illiapliukhin/led-cube-32-controller/hardware/wire_grid_32x32/renders/hq/leadin_tag.png

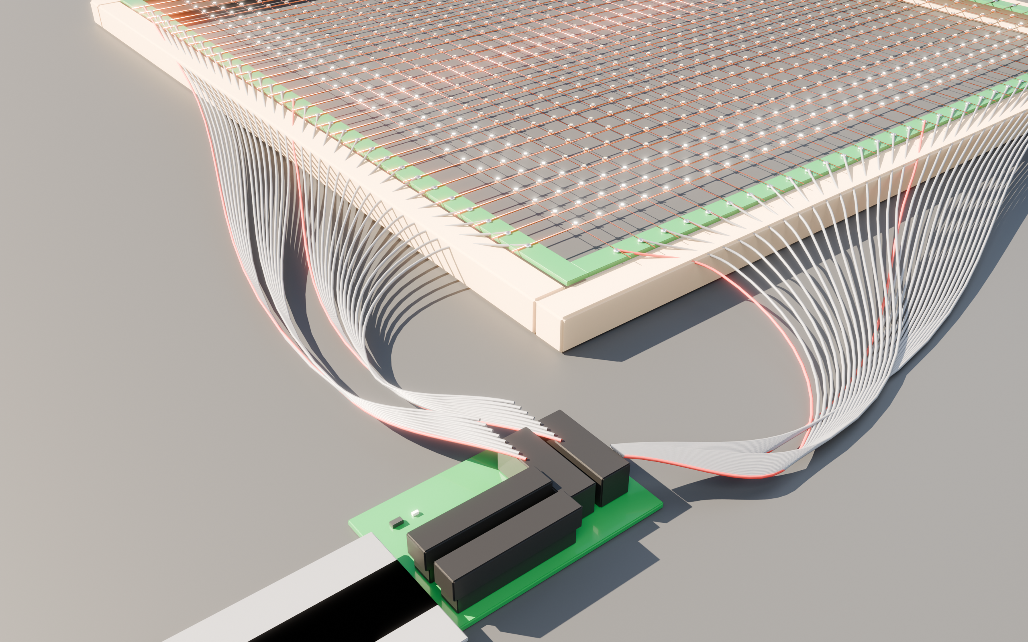
hardware/wire_grid_32x32/renders/hq/leadin_tag.png
