illiapliukhin/led-cube-32-controller/hardware/wire_grid_32x32/renders/hq/grid_full_34.png

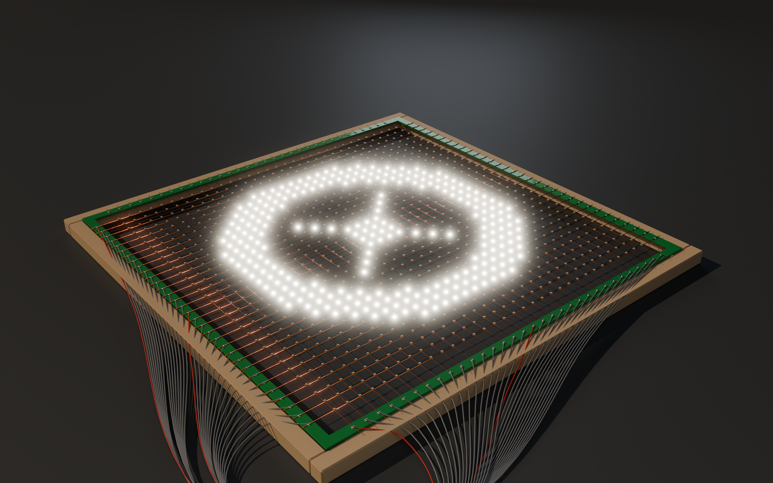
hardware/wire_grid_32x32/renders/hq/grid_full_34.png
