illiapliukhin/led-cube-32-controller/calc/strip_calc.md

| Connectors / 1 m | Pitch | Segments × conn. | px / strand | px / board | I5V ABL 25 % / board | I5V / segment | Power cells / segment | I12V / segment | I / strand (ABL) | Data buffers / seg | Clock buffers / seg | Clock groups / seg | Strand connector |
|---|---|---|---|---|---|---|---|---|---|---|---|---|---|
| **124** | 8.06 mm | 4 × 31 | 124 | 15,376 | 231 A | 57.7 A | 6 | 26.6 A | 1.86 A | 4 | 4 | 2 | JST XH B4B-XH-A, 2 staggered rows (16.1 mm per row) |
| **64** | 15.62 mm | 4 × 16 | 64 | 4,096 | 61 A | 15.4 A | 2 | 7.1 A | 0.96 A | 2 | 2 | 1 | JST XH B4B-XH-A, 1 row |
| **48** | 20.83 mm | 4 × 12 | 48 | 2,304 | 35 A | 8.6 A | 1 | 4.0 A | 0.72 A | 2 | 2 | 1 | JST XH B4B-XH-A, 1 row |
| **32** | 31.25 mm | 4 × 8 | 32 | 1,024 | 15 A | 3.8 A | 1 | 1.8 A | 0.48 A | 1 | 1 | 1 | JST XH B4B-XH-A, 1 row |
