illiapliukhin/led-cube-32-controller/hardware/wire_grid_32x32/wire_grid_32x32_schematic.pdf

# wire_grid_32x32 — Схема: матрица 32×32

### Сетка 32×32 на проводах · шаг 10.0 мм · NCD0603W1 · LED_INTERFACE_STANDARD v1

# Лист 1/2 (схема) · размеры в мм · gen_drawings.py (параметрический, params.py)

D(r,c), r,c = 1…32: анод → провод строки ROW_r, катод → провод столбца COL_c. Позиционное обозначение Dn, n = 32(r−1)+c (как на mono_panel_32x32). 1024 × NCD0603W1 (LCSC C84265).

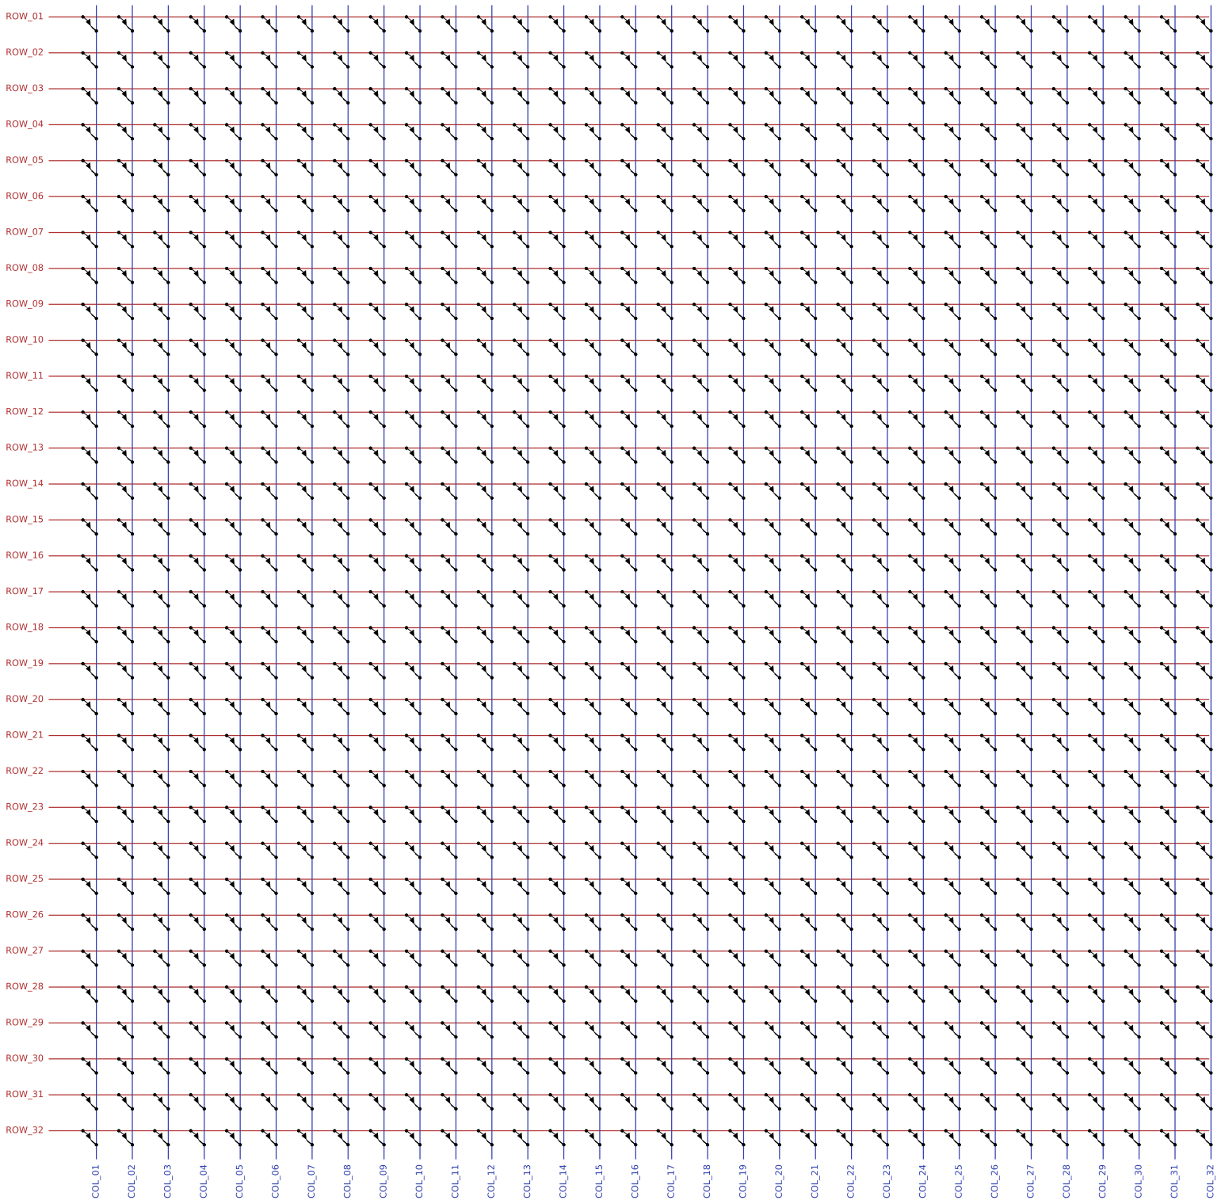
[picture p4: figure]
ROW_01; ROW_02; ROW_03; ROW_04; ROW_05; ROW_06; ROW_07; ROW_08; ROW_09; ROW_10; ROW_11; ROW_12; ROW_13; ROW_14; ROW_15; ROW_16; ROW_17; ROW_18; ROW_19; ROW_20; ROW_21; ROW_22; ROW_23; ROW_24; ROW_25; ROW_26; ROW_27; ROW_28; ROW_29; ROW_30; ROW_31; ROW_32; COL_01; COL_02; COL_03; COL_04; COL_05; COL_06; COL_07; COL_08; COL_09; COL_10; COL_11; COL_12; COL_13; COL_14; COL_15; COL_16; COL_17; COL_18; COL_19; COL_20; COL_21; COL_22; COL_23; COL_24; COL_25; COL_26; COL_27; COL_28; COL_29; COL_30; COL_31; COL_32

## ROW_r: Ø0.50 мм эмаль, 340 мм; источник P-FET LED_4V1 4,1 В, до 0.32 А (32×10 мА)

## COL_c: Ø0.25 мм эмаль, 340 мм; сток MBI5124 ~10 мА

# Под светодиодами нет печатной платы: провода = шины

Строки разводятся гребёнкой (шлейф 28 AWG) на J_R1/J_R2,

# столбцы — на J_C1/J_C2 (IDC 2×8, 2,54 мм): штырь n = линия n

(J_R2/J_C2: штырь n = линия 16+n).

## Вариант A: 4 шлейфа → hardware/garland_breakout

(EEPROM U_ID уже на breakout, прошить preset wire32).

# Вариант B: гребёнки → бирка WG_TAG → 2× IDC 2×20 1,27 мм

→ J_RH1/J_CH1 платы v15 (ID EEPROM на бирке).

# Падение по строке (§5, ≤ 350 мВ при 0,32 А): A: 133 мВ (запас 217 мВ), B: 81 мВ (запас 269 мВ)

# A (анод) → ROW

# K (катод) → COL

# NCD0603W1: катод = метка на корпусе (зелёная/срез), Vf 2,6…3,6 В

# wire_grid_32x32 — Схема: разъёмы, бирка WG_TAG, ID EEPROM, ESD

### Сетка 32×32 на проводах · шаг 10.0 мм · NCD0603W1 · LED_INTERFACE_STANDARD v1

# Лист 2/2 (схема) · размеры в мм · gen_drawings.py (параметрический, params.py)

## J_R1 (2×8 2,54)

1 ROW_01

2 ROW_02

3 ROW_03

4 ROW_04

5 ROW_05

6 ROW_06

7 ROW_07

8 ROW_08

9 ROW_09

10 ROW_10

11 ROW_11

12 ROW_12

13 ROW_13

14 ROW_14

15 ROW_15

16 ROW_16

## J_R2 (2×8 2,54)

1 ROW_17

2 ROW_18

3 ROW_19

4 ROW_20

5 ROW_21

6 ROW_22

7 ROW_23

8 ROW_24

9 ROW_25

10 ROW_26

11 ROW_27

12 ROW_28

13 ROW_29

14 ROW_30

15 ROW_31

16 ROW_32

## J_C1 (2×8 2,54)

1 COL_01

2 COL_02

3 COL_03

4 COL_04

5 COL_05

6 COL_06

7 COL_07

8 COL_08

9 COL_09

10 COL_10

11 COL_11

12 COL_12

13 COL_13

14 COL_14

15 COL_15

16 COL_16

## J_C2 (2×8 2,54)

1 COL_17

2 COL_18

3 COL_19

4 COL_20

5 COL_21

6 COL_22

7 COL_23

8 COL_24

9 COL_25

10 COL_26

11 COL_27

12 COL_28

13 COL_29

14 COL_30

15 COL_31

16 COL_32

Сторона сетки: гребёнки (шлейф 16 жил 28 AWG, IDC-16F).
Совпадает 1:1 с J_R1/J_R2/J_C1/J_C2 платы garland_breakout.

Ключ IDC: штырь 1 = красная жила шлейфа = ROW_01 / COL_01 (J_R2: ROW_17).

## J_OUT_R → v15 J_RH1

1 | ROW_01
2 | ROW_02
3 | ROW_03
4 | ROW_04
5 | ROW_05
6 | ROW_06
7 | ROW_07
8 | ROW_08
9 | ROW_09
10 | ROW_10
11 | ROW_11
12 | ROW_12
13 | ROW_13
14 | ROW_14
15 | ROW_15
16 | ROW_16
17 | ROW_17
18 | ROW_18
19 | ROW_19
20 | ROW_20
21 | ROW_21
22 | ROW_22
23 | ROW_23
24 | ROW_24
25 | ROW_25
26 | ROW_26
27 | ROW_27
28 | ROW_28
29 | ROW_29
30 | ROW_30
31 | ROW_31
32 | ROW_32
33 | GND
34 | VLED_SENSE (NC)
35 | ID_SDA
36 | ID_SCL
37 | ID_3V3
38 | GND
39 | ID_PRESENT_N→GND
40 | GND

## J_OUT_C → v15 J_CH1

1 | COL_01
2 | COL_02
3 | COL_03
4 | COL_04
5 | COL_05
6 | COL_06
7 | COL_07
8 | COL_08
9 | COL_09
10 | COL_10
11 | COL_11
12 | COL_12
13 | COL_13
14 | COL_14
15 | COL_15
16 | COL_16
17 | COL_17
18 | COL_18
19 | COL_19
20 | COL_20
21 | COL_21
22 | COL_22
23 | COL_23
24 | COL_24
25 | COL_25
26 | COL_26
27 | COL_27
28 | COL_28
29 | COL_29
30 | COL_30
31 | COL_31
32 | COL_32
33 | GND
34 | EXP (NC)
35 | EXP (NC)
36 | EXP (NC)
37 | EXP (NC)
38 | GND
39 | EXP_3V3 (NC)
40 | GND

Бирка WG_TAG (вариант B): 2× IDC 2×20 1,27 мм (BH127VS-40P),
штырь n = линия n, ровно как J_RH1/J_CH1 и FFC.

J_R1/J_R2 → J_OUT_R 1…32, J_C1/J_C2 → J_OUT_C 1…32 (дорожки ≥ 0,4 мм для строк, 0,32 А).

## U_ID 24LC02BT-I/OT (SOT-23-5), 0x50

ID_3V3 (37) | 4 VCC
ID_SDA (35) | 3 SDA
ID_SCL (36) | 1 SCL
VSS 2 | GND
WP 5 | GND

C_ID 100 нФ 0603: ID_3V3 ↔ GND у вывода 4.
Подтяжки SDA/SCL — на основной плате (шина IMU).

WP = GND: прошивка из платы (panel write).

Пины 39 → GND (ID_PRESENT_N), 33/38/40 → GND.
Вариант A: бирка не нужна — U_ID уже на breakout.

# Мини-вариант: только EEPROM на клочке

макетки 10×15 мм, припаян к жилам 33–40 шлейфа.

# ESD — примечание

- Сетка — 64 голых антенны ~0,34 м без платы и без TVS.

### - Защита стоит на стороне платы: 64× PESD5V0S1BL на garland_breakout

### (вариант A) или D_R01…D_C32 у J_RH1/J_CH1 на v15 (вариант B) —

при сборке вариант B TVS ОБЯЗАТЕЛЬНО запаяны (в wearable они DNP).

### - Опционально на бирке: 64× PESD5V0S1BL (C84374, SOD-882)

линия → GND, у разъёмов J_R*/J_C*; GND = 33/38/40.

# - Рамка (если металл) и GND гребёнок — к GND одним проводом

у бирки/breakout; ESD-браслет при пайке и подключении.

- Сначала подключать GND (шлейф с ключом — все жилы разом),

никогда не подключать/отключать под питанием.

- Эмаль не изолирует от ESD — не трогать сетку при работе.

# - NCD0603W1 без встроенного стабилитрона: обратное

напряжение ≤ 5 В (строки ≤ 4,1 В — в норме).
