illiapliukhin/led-cube-32-controller/docs/block_diagram.png

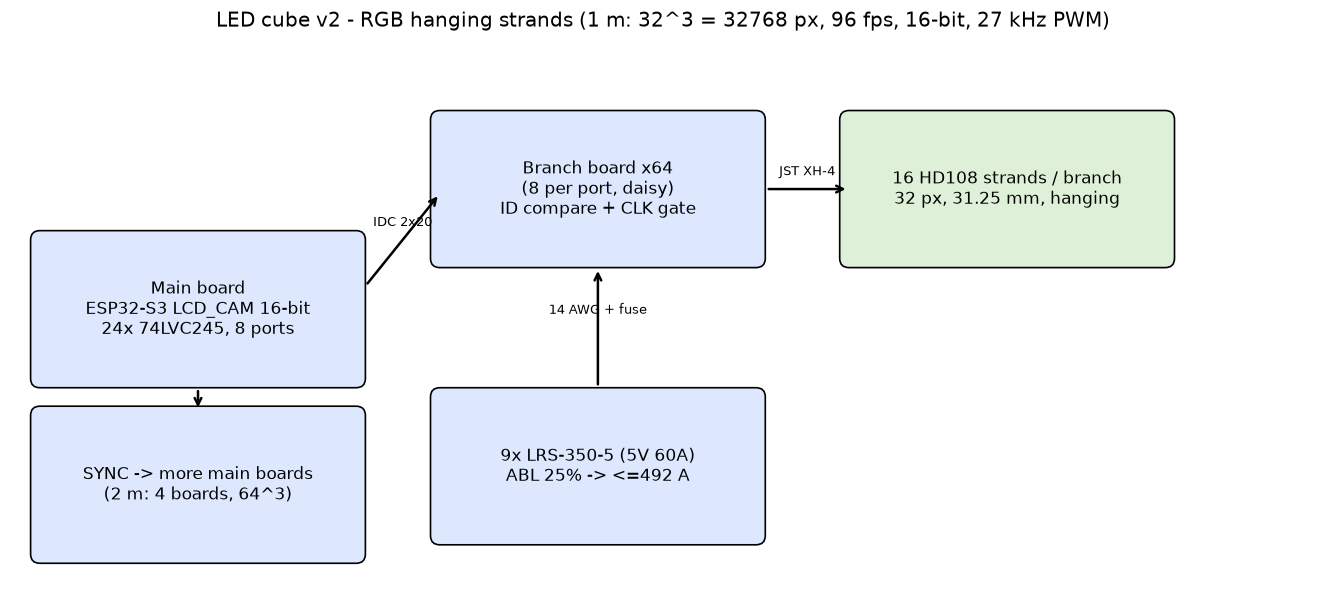
docs/block_diagram.png
