illiapliukhin/led-cube-32-controller/docs/block_diagram_v1_mono.png

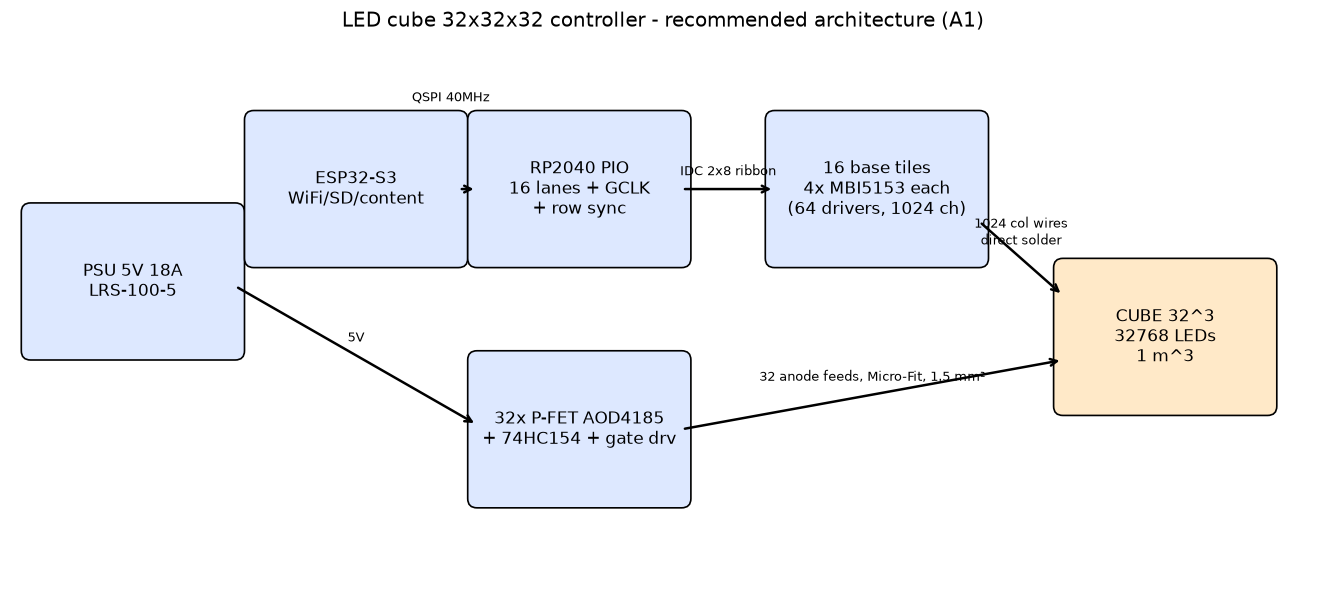
docs/block_diagram_v1_mono.png
