illiapliukhin/led-cube-32-controller/hardware/main_v1/renders/main_v1_bottom.png

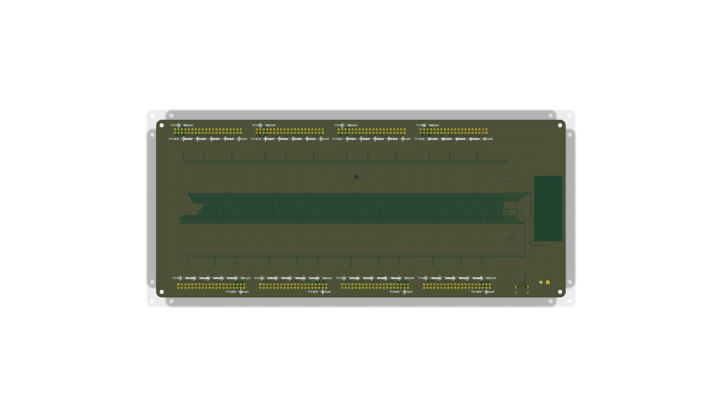
hardware/main_v1/renders/main_v1_bottom.png
