illiapliukhin/led-cube-32-controller/hardware/v15_baseline/renders/mono_electronics_v15_iso.png

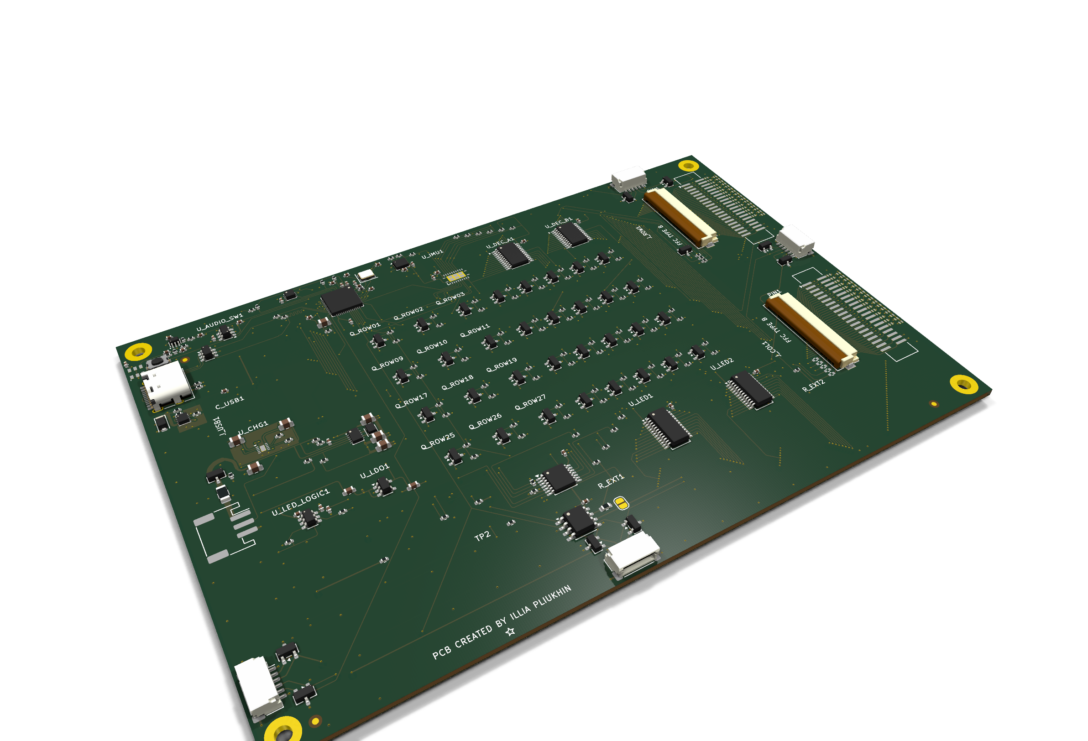
hardware/v15_baseline/renders/mono_electronics_v15_iso.png
