illiapliukhin/led-cube-32-controller/hardware/wire_grid_32x32/out/mech_1_plan.png

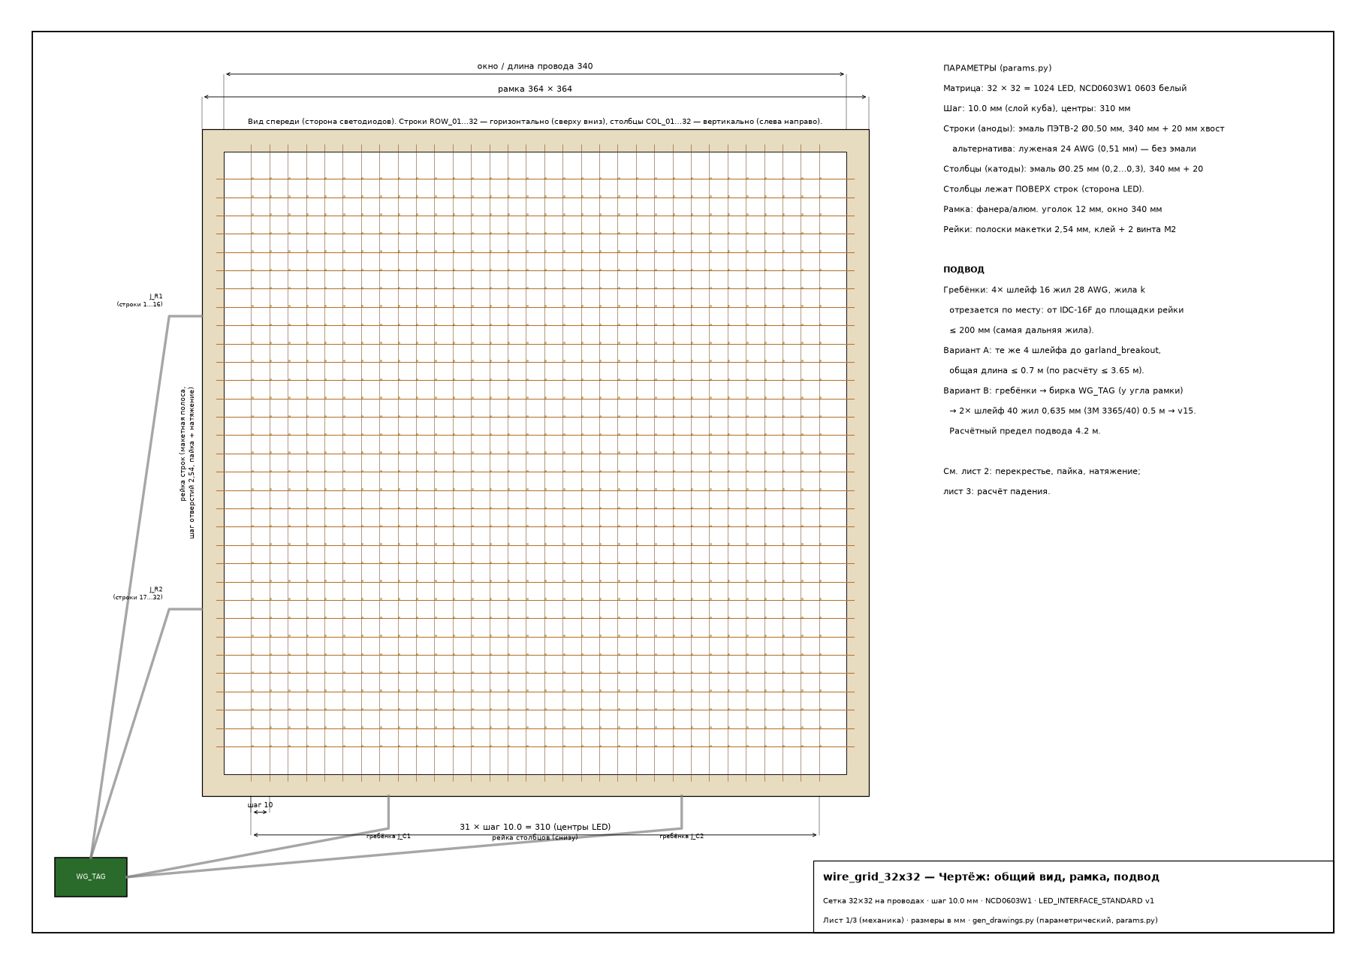
hardware/wire_grid_32x32/out/mech_1_plan.png
