illiapliukhin/led-cube-32-controller/hardware/wire_grid_32x32/out/mech_2_details.png

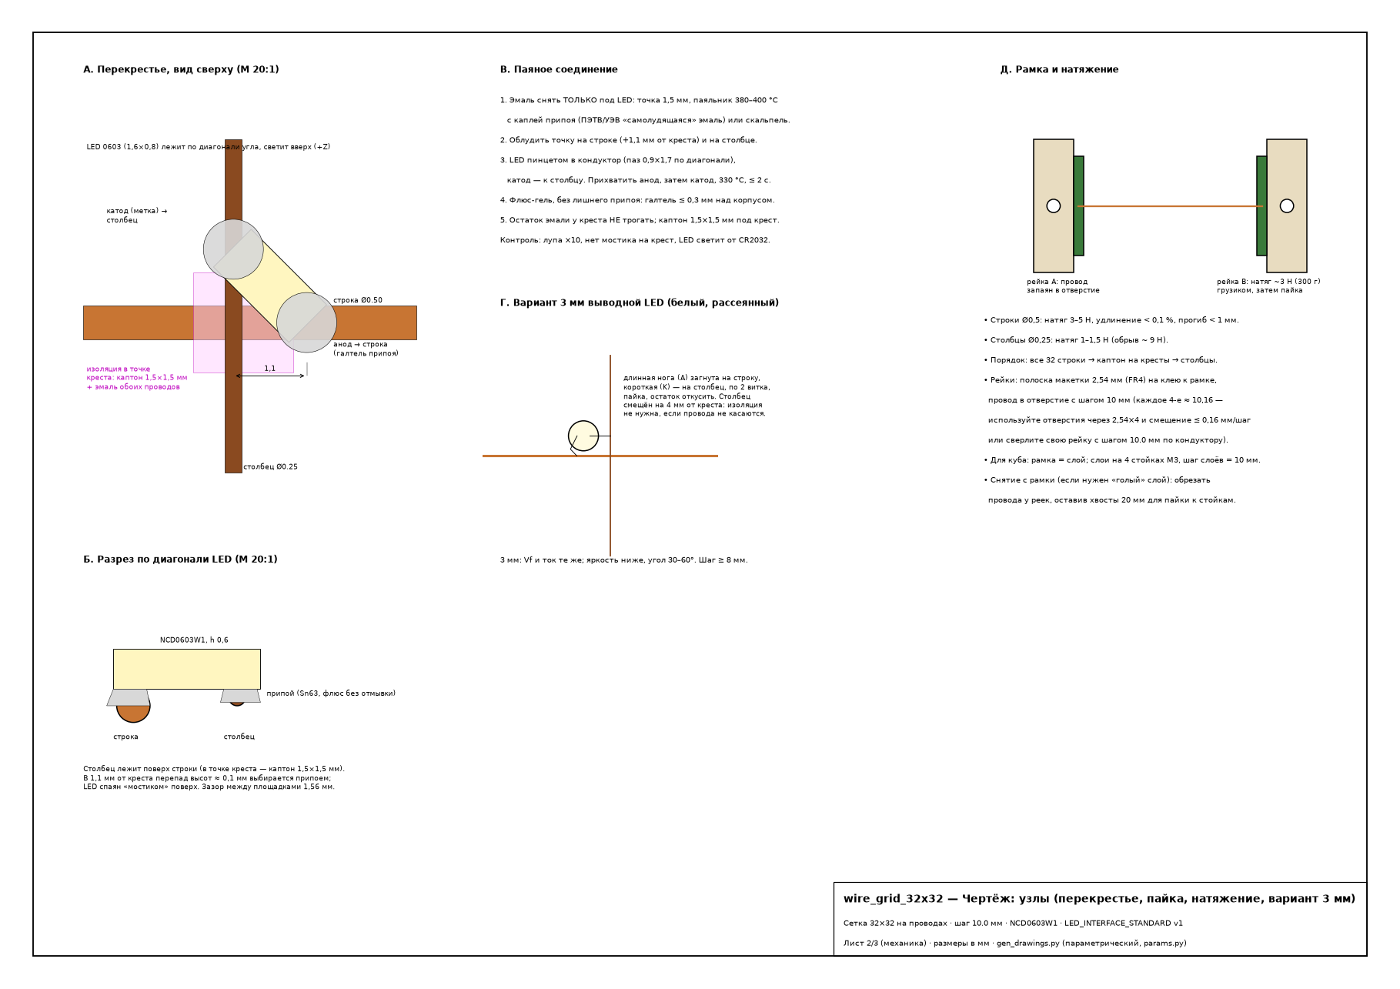
hardware/wire_grid_32x32/out/mech_2_details.png
