illiapliukhin/led-cube-32-controller/hardware/wire_grid_32x32/out/mech_3_dropcalc.png

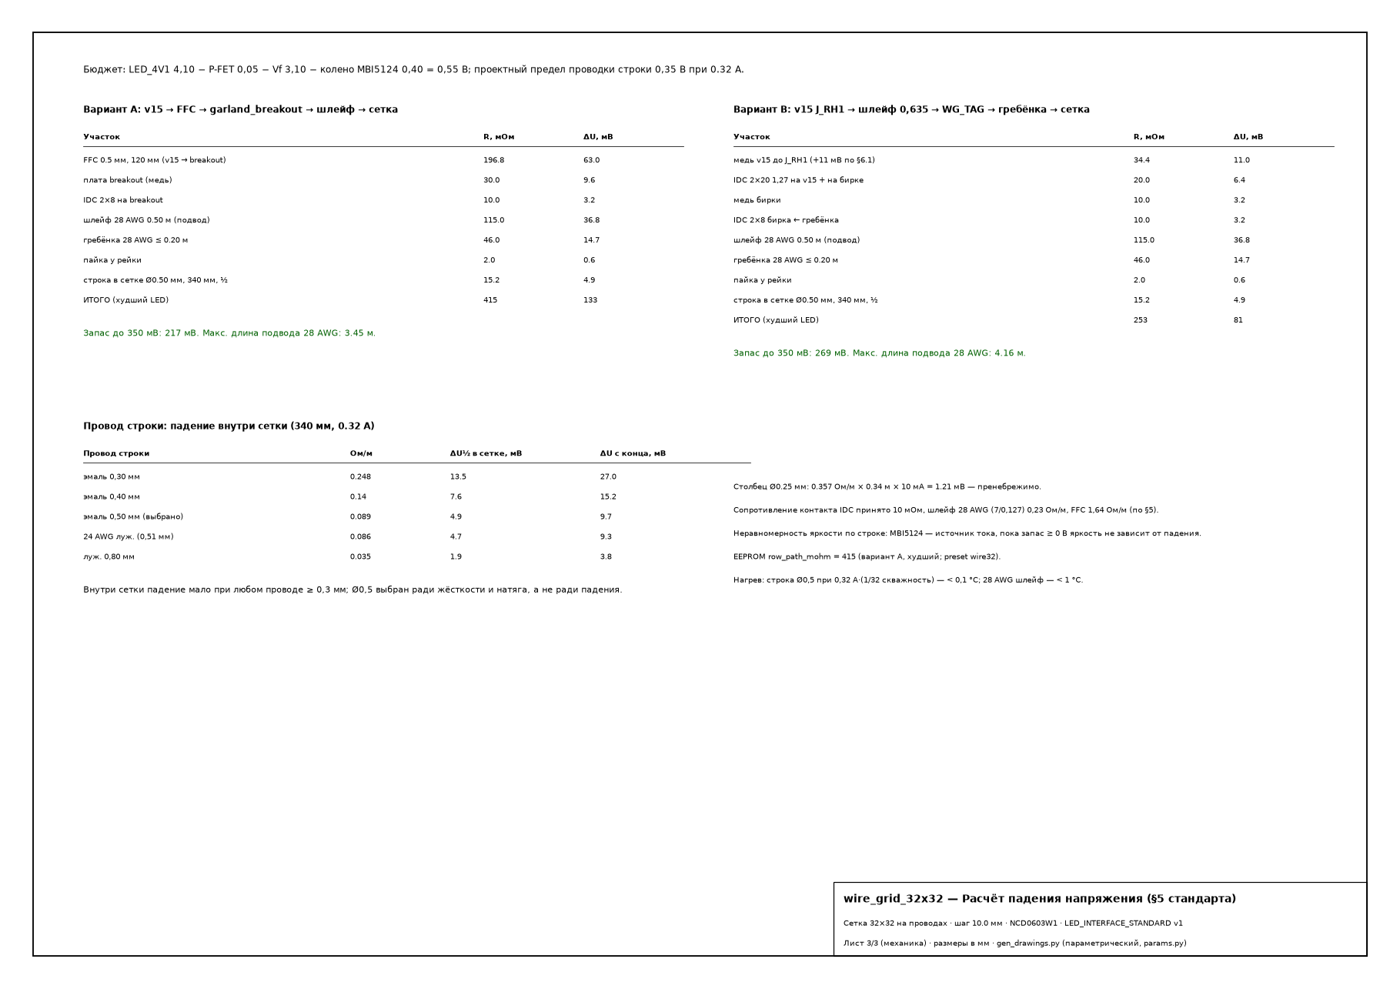
hardware/wire_grid_32x32/out/mech_3_dropcalc.png
