illiapliukhin/led-cube-32-controller/hardware/wire_grid_32x32/out/schematic_matrix.png

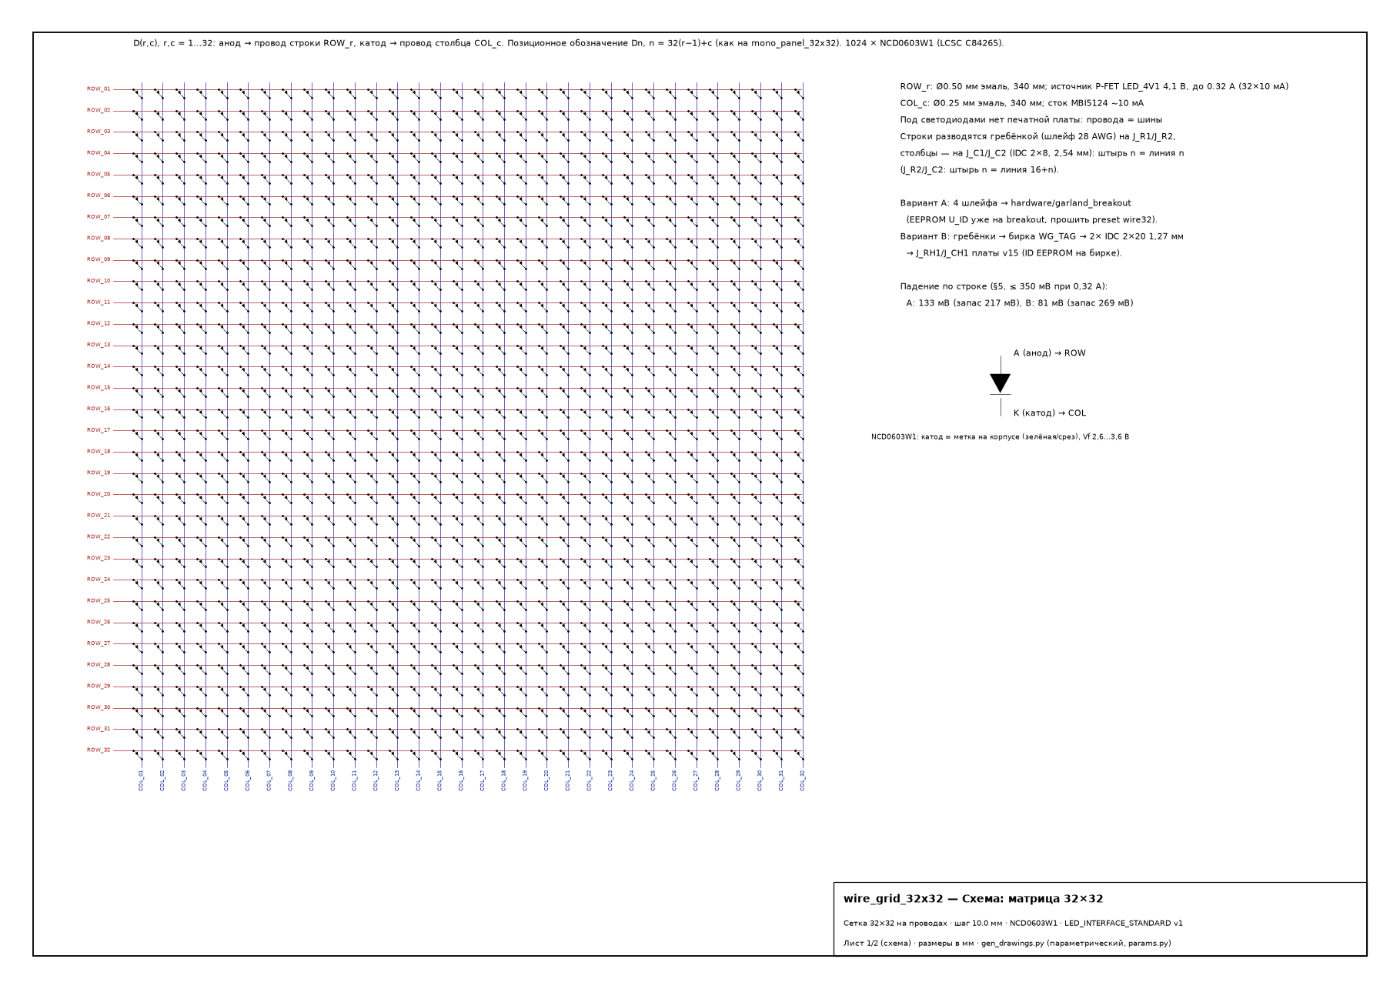
hardware/wire_grid_32x32/out/schematic_matrix.png
