illiapliukhin/led-cube-32-controller/hardware/wire_grid_32x32/renders/grid_overview.png

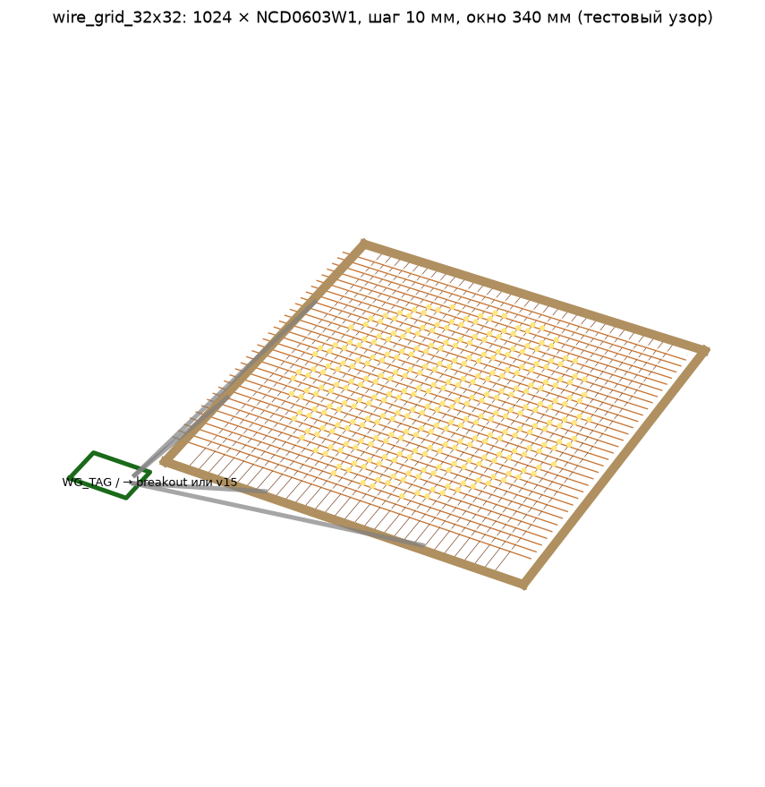
hardware/wire_grid_32x32/renders/grid_overview.png
