illiapliukhin/led-cube-32-controller/hardware/wire_grid_32x32/renders/hq/mech_1_plan_300dpi.png

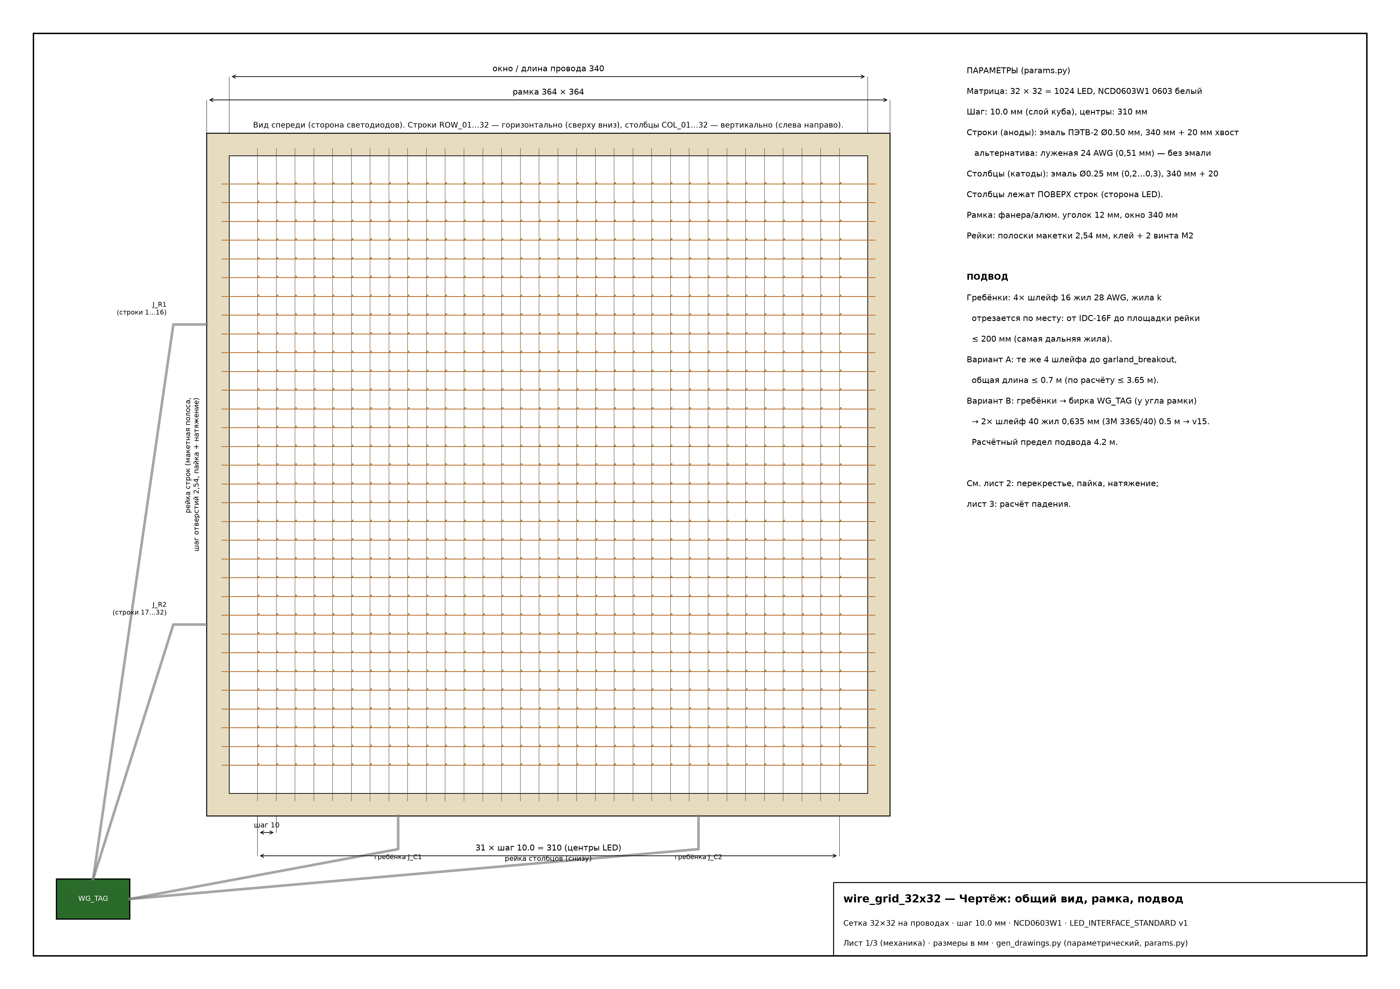
hardware/wire_grid_32x32/renders/hq/mech_1_plan_300dpi.png
