illiapliukhin/led-cube-32-controller/hardware/wire_grid_32x32/renders/hq/node_macro.png

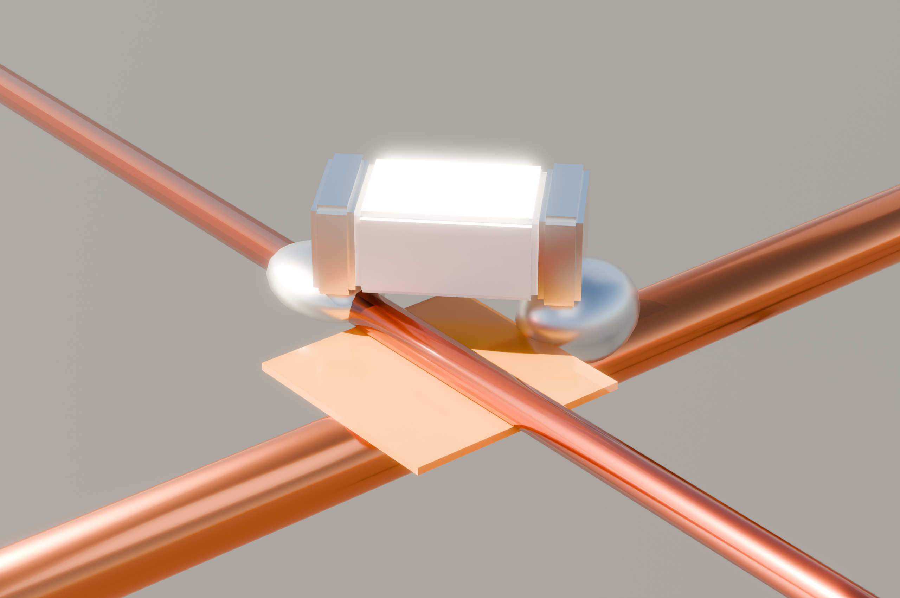
hardware/wire_grid_32x32/renders/hq/node_macro.png
