illiapliukhin/led-cube-32-controller/hardware/wire_grid_32x32/renders/hq/nodes_2x2_top.png

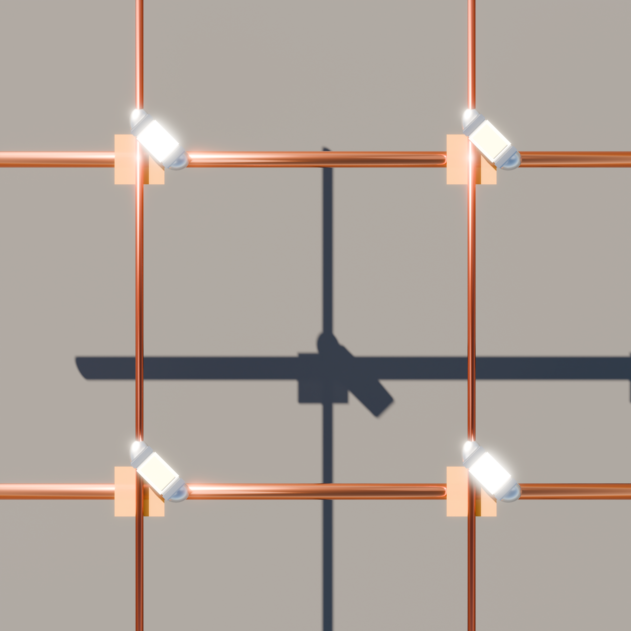
hardware/wire_grid_32x32/renders/hq/nodes_2x2_top.png
