illiapliukhin/led-cube-32-controller/hardware/wire_grid_32x32/renders/hq/schematic_connectors_300dpi.png

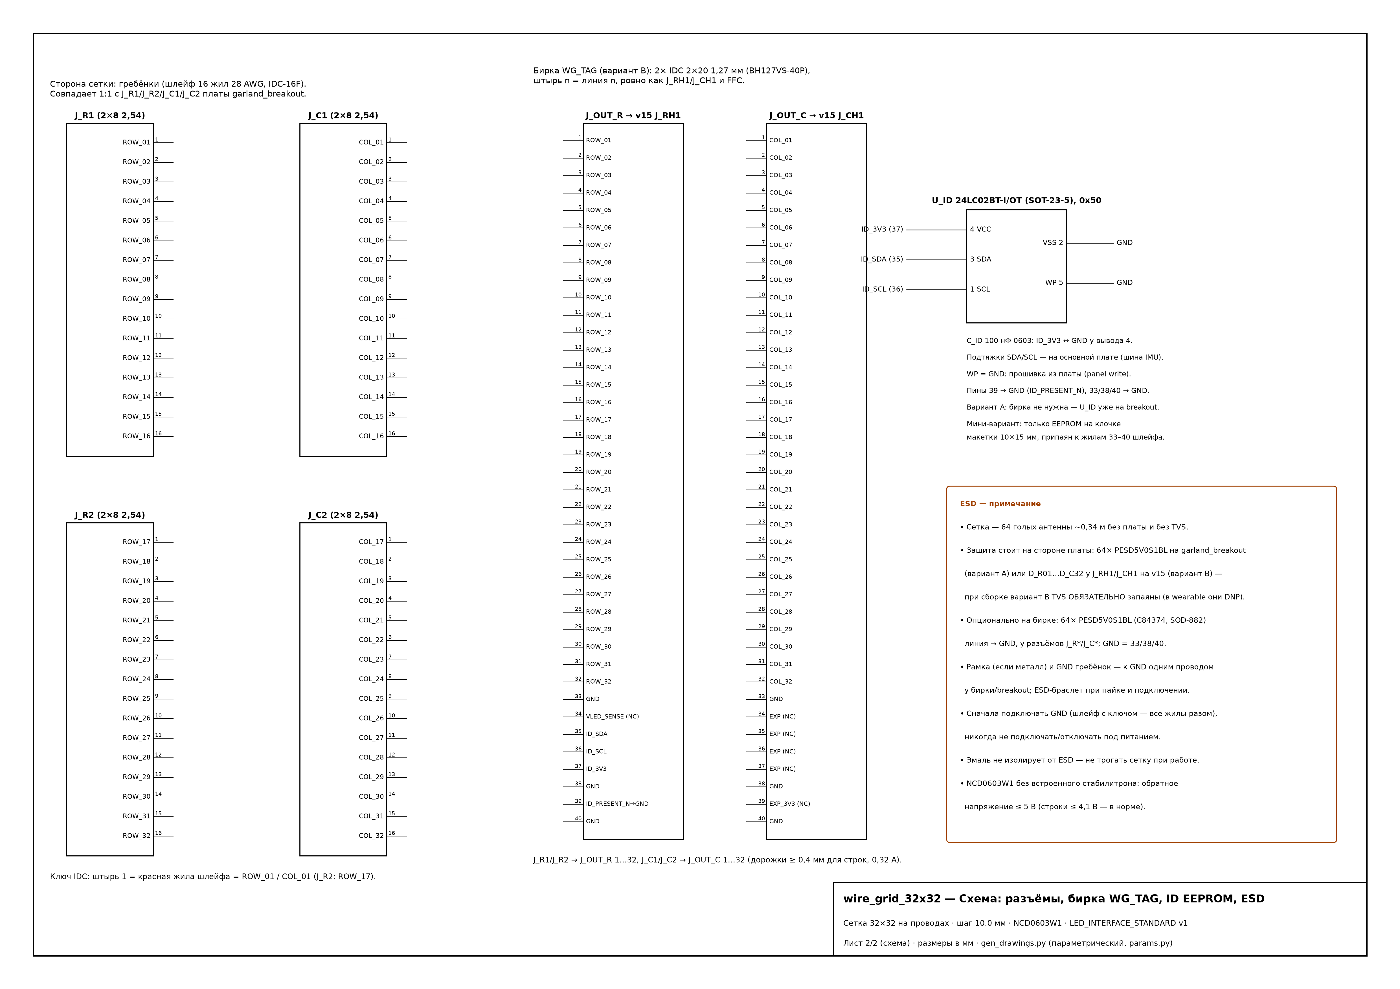
hardware/wire_grid_32x32/renders/hq/schematic_connectors_300dpi.png
