illiapliukhin/led-cube-32-controller/hardware/wire_grid_32x32/renders/node_closeup_iso.png

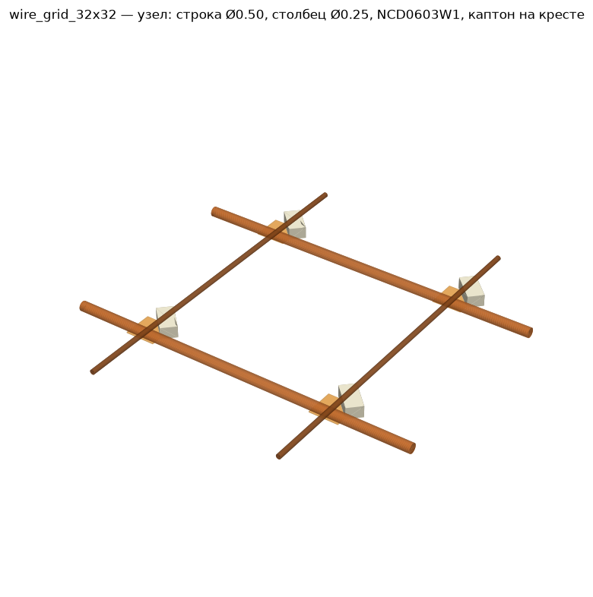
hardware/wire_grid_32x32/renders/node_closeup_iso.png
