illiapliukhin/led-cube-32-controller/hardware/wire_grid_32x32/renders/wire_sim_bg.png

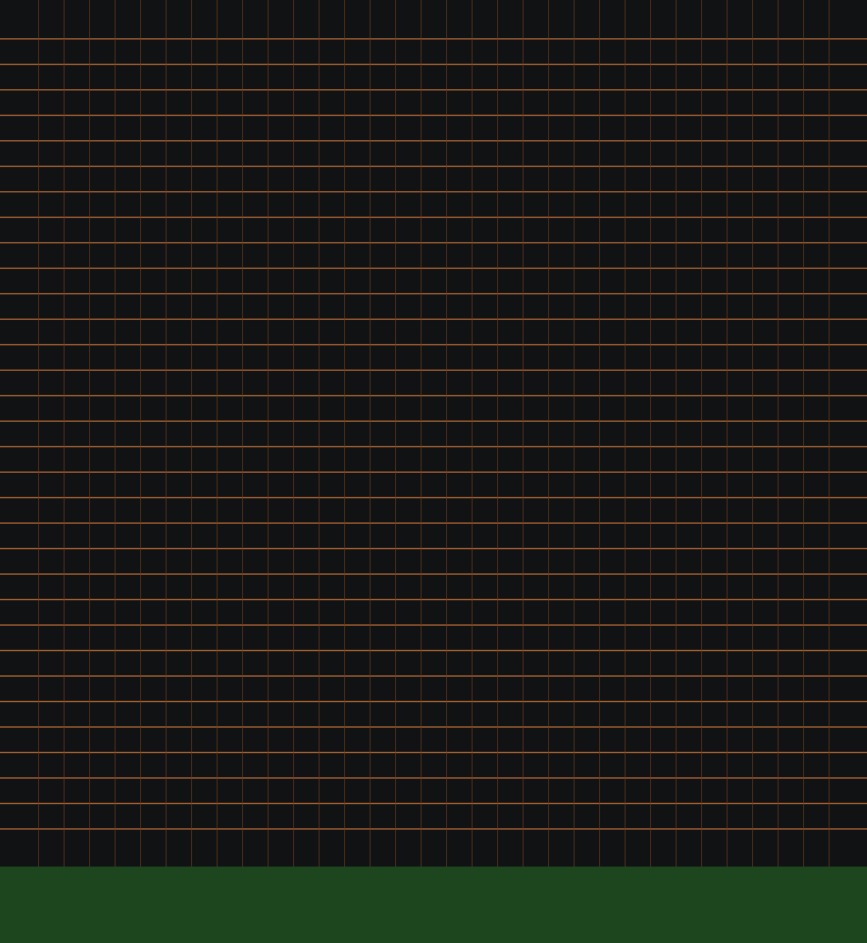
hardware/wire_grid_32x32/renders/wire_sim_bg.png
