illiapliukhin/led-cube-32-controller/hardware/main_v1/fab/main_v1-BOM.csv

Comment | Designator | Footprint | LCSC Part # | MPN | Qty
10uF50V | C1 | C_1206_3216Metric | C13585 | CL31A106KBHNNNE | 1
100nF | C10,C11,C12,C13,C14,C15,C16,C17,C18,C19,C2,C20,C21,C22,C23,C24,C25,C26,C27,C28,C29,C30,C31,C32,C33,C5,C7 | C_0603_1608Metric | C66501 | CL10B104KO8NNNC | 27
22uF | C3,C4 | C_0603_1608Metric | C59461 | CL10A226MQ8NRNC | 2
1uF | C6 | C_0603_1608Metric | C1592 | CL10A105KO8NNNC | 1
47uF | C8 | C_1210_3225Metric | C77101 | GRM32ER61C476KE15L | 1
SS34 | D1 | D_SMA | C8678 | SS34 | 1
STATUS | D2 | LED_0603_1608Metric | C2286 | KT-0603R | 1
SS34 (rev.pol.) | D3 | D_SMA | C8678 | SS34 | 1
SMBJ15A | D4 | D_SMB | C83846 | SMBJ15A | 1
PTC 2A/16V | F1 | Fuse_1812_4532Metric | C20812 | SMD1812P200TF16 | 1
PORT0 | J1 | IDC-Header_2x20_P2.54mm_Vertical | C9138 | 2.54-2*20P box header | 1
12V_IN | J10 | TerminalBlock_Phoenix_MKDS-1,5-2-5.08_1x02_P5.08mm_Horizontal | C8465 | WJ500V-5.08-2P | 1
PORT1 | J2 | IDC-Header_2x20_P2.54mm_Vertical | C9138 | 2.54-2*20P box header | 1
PORT2 | J3 | IDC-Header_2x20_P2.54mm_Vertical | C9138 | 2.54-2*20P box header | 1
PORT3 | J4 | IDC-Header_2x20_P2.54mm_Vertical | C9138 | 2.54-2*20P box header | 1
PORT4 | J5 | IDC-Header_2x20_P2.54mm_Vertical | C9138 | 2.54-2*20P box header | 1
PORT5 | J6 | IDC-Header_2x20_P2.54mm_Vertical | C9138 | 2.54-2*20P box header | 1
PORT6 | J7 | IDC-Header_2x20_P2.54mm_Vertical | C9138 | 2.54-2*20P box header | 1
PORT7 | J8 | IDC-Header_2x20_P2.54mm_Vertical | C9138 | 2.54-2*20P box header | 1
USB-C | J9 | USB_C_Receptacle_HRO_TYPE-C-31-M-12 | C165948 | TYPE-C-31-M-12 | 1
3.3uH | L1 | L_Cjiang_FXL0630 | C167219 | FXL0630-3R3-M | 1
10k | R1,R4 | R_0603_1608Metric | C98220 | RC0603FR-0710KL | 2
5.1k | R2,R3 | R_0603_1608Metric | C23186 | 0603WAF5101T5E | 2
1k | R5 | R_0603_1608Metric | C21190 | 0603WAF1001T5E | 1
BOOT | SW1 | SW_Push_1P1T_XKB_TS-1187A | C318884 | TS-1187A-B-A-B | 1
RESET | SW2 | SW_Push_1P1T_XKB_TS-1187A | C318884 | TS-1187A-B-A-B | 1
ESP32-S3-WROOM-1-N16R8 | U1 | ESP32-S3-WROOM-1 | C2913202 | ESP32-S3-WROOM-1-N16R8 | 1
74LVC245APW | U10,U11,U12,U13,U14,U15,U16,U17,U18,U19,U20,U21,U22,U23,U24,U25,U26,U27,U28,U29,U30,U31,U32,U33 | TSSOP-20_4.4x6.5mm_P0.65mm | C6082 | 74LVC245APW,118 | 24
AP63203WU-7 | U2 | TSOT-23-6 | C780769 | AP63203WU-7 | 1
USBLC6-2SC6 | U3 | SOT-23-6 | C2827654 | USBLC6-2SC6 | 1
TPD4E05U06DQAR | UE0,UE1,UE10,UE11,UE12,UE13,UE14,UE15,UE2,UE20,UE21,UE22,UE23,UE24,UE25,UE3,UE30,UE31,UE32,UE33,UE34,UE35,UE4,UE40,UE41,UE42,UE43,UE44,UE45,UE5,UE50,UE51,UE52,UE53,UE54,UE55,UE60,UE61,UE62,UE63,UE64,UE65,UE70,UE71,UE72,UE73,UE74,UE75 | USON-10_2.5x1.0mm_P0.5mm | C138714 | TPD4E05U06DQAR | 48
