illiapliukhin/led-cube-32-controller/hardware/v15_baseline/fab/BOM_mono_electronics_v15_annotated.csv

Value | Qty | Designators | Footprint | LCSC | MPN (LCSC) | JLC library | Stock | Unit $ @5 boards | Unit $ @50 boards | Flag
1.82k | 2 | R_EXT1 R_EXT2 | R_0402_1005Metric | C5121516 | FRC0402F1821TS | expand | 69543 | 0.0013 | 0.0013
100k | 15 | R_ADDR0 R_ADDR1 R_ADDR2 R_ADDR3 R_AUD_PD1 R_B1 R_B2 R_CLK_PD1 R_EN_PD1 R_EN_SER1 R_F1 R_INB1 R_LE_PD1 R_LOGIC_PD1 R_SDI_PD1 | R_0402_1005Metric | C25741 | 0402WGF1003TCE | base | 8043409 | 0.0024 | 0.0024
100n | 18 | C_AUD1 C_BUF_V1 C_DECA_V1 C_DECB_V1 C_GAUGE1 C_IMU_VDD1 C_IMU_VIO1 C_LED1_V1 C_LED2_V1 C_LL2 C_MCU_A3 C_MCU_CPU1 C_MCU_DA1 C_MCU_RTC1 C_MIC1 C_USB1 C_XLAT_A1 C_XLAT_B1 | C_0402_1005Metric | C1525 | CL05B104KO5NNNC | base | 23929318 | 0.0045 | 0.0045
100nF | 1 | C_485 | C_0402_1005Metric | C1525 | CL05B104KO5NNNC | base | 23929318 | 0.0045 | 0.0045
10k | 4 | R_ALRT1 R_BOOT0 R_CHIP_PU1 R_XOE1 | R_0402_1005Metric | C25744 | 0402WGF1002TCE | base | 19712527 | 0.0034 | 0.0034
10k 1% | 1 | R_TH1 | R_0402_1005Metric | C25744 | 0402WGF1002TCE | base | 19712527 | 0.0034 | 0.0034
10n | 1 | C_EN1 | C_0402_1005Metric | C15195 | CL05B103KB5NNNC | base | 3579192 | 0.0050 | 0.0050
10p | 2 | C_XTAL1 C_XTAL2 | C_0402_1005Metric | C106199 | CC0402JRNPO9BN100 | expand | 2968430 | 0.0044 | 0.0044
10u | 4 | C_CHG_BAT1 C_CHG_IN1 C_CHG_SYS1 C_SYS1 | C_0805_2012Metric | C15850 | CL21A106KAYNNNE | base | 4312843 | 0.0688 | 0.0507
120R | 1 | R_TERM1 | R_0603_1608Metric | C22787 | 0603WAF1200T5E | base | 2089888 | 0.0031 | 0.0031
18k | 1 | R_ILIM1 | R_0402_1005Metric | C138044 | RC0402FR-0718KL | expand | 973469 | 0.0027 | 0.0027
1k | 1 | R_QOD1 | R_0402_1005Metric | C11702 | 0402WGF1001TCE | base | 8266859 | 0.0035 | 0.0035
1u | 9 | C_AC1 C_ASW_IN1 C_AUD_SW1 C_CHIP_PU1 C_LL1 C_LL_IN1 C_MCU_A2 C_MCU_DA2 C_MCU_SPI1 | C_0402_1005Metric | C106254 | CC0402KRX5R6BB105 | expand | 1363514 | 0.0094 | 0.0094
1u | 2 | C_LDO_IN1 C_LDO_OUT1 | C_0603_1608Metric | C5673 | CL10A105KA8NNNC | expand | 4336197 | 0.0276 | 0.0276
2.2k | 1 | R_GN1 | R_0402_1005Metric | C25879 | 0402WGF2201TCE | base | 1600702 | 0.0017 | 0.0017
22R | 5 | R_CLK_SER1 R_LE_SER1 R_SDI_SER1 R_USB_N1 R_USB_P1 | R_0402_1005Metric | C25092 | 0402WGF220JTCE | base | 6244536 | 0.0028 | 0.0028
22u | 3 | C_LED1 C_LED2 C_MCU1 | C_0805_2012Metric | C380338 | TCC0805X5R226M100FT | expand | 268379 | 0.1082 | 0.0872
24nH | 1 | L_XTAL1 | L_0402_1005Metric | C74301 | SDCL1005C24NJTDF | expand | 42378 | 0.0061 | 0.0061
33R | 34 | R_G01 R_G02 R_G03 R_G04 R_G05 R_G06 R_G07 R_G08 R_G09 R_G10 R_G11 R_G12 R_G13 R_G14 R_G15 R_G16 R_G17 R_G18 R_G19 R_G20 R_G21 R_G22 R_G23 R_G24 R_G25 R_G26 R_G27 R_G28 R_G29 R_G30 R_G31 R_G32 R_ID_SCL1 R_ID_SDA1 | R_0402_1005Metric | C25105 | 0402WGF330JTCE | base | 1681494 | 0.0012 | 0.0009
4.7k | 2 | R_SCL1 R_SDA1 | R_0402_1005Metric | C25900 | 0402WGF4701TCE | base | 14578032 | 0.0027 | 0.0027
4.7u | 2 | C_B1 C_GN1 | C_0402_1005Metric | C380302 | TCC0402X5R475M6R3AT | expand | 1649063 | 0.0055 | 0.0055
47k | 36 | R_ENA1 R_ENB1 R_OE_PU1 R_OE_YPU1 R_PU01 R_PU02 R_PU03 R_PU04 R_PU05 R_PU06 R_PU07 R_PU08 R_PU09 R_PU10 R_PU11 R_PU12 R_PU13 R_PU14 R_PU15 R_PU16 R_PU17 R_PU18 R_PU19 R_PU20 R_PU21 R_PU22 R_PU23 R_PU24 R_PU25 R_PU26 R_PU27 R_PU28 R_PU29 R_PU30 R_PU31 R_PU32 | R_0402_1005Metric | C25792 | 0402WGF4702TCE | base | 5247778 | 0.0026 | 0.0020
5.1k | 2 | R_CC1 R_CC2 | R_0402_1005Metric | C25905 | 0402WGF5101TCE | base | 5604369 | 0.0024 | 0.0024
S3B-PH-SM4-TB(LF)(SN) | 1 | J_BAT1 | JST_PH_S3B-PH-SM4-TB_1x03-1MP_P2.00mm_Horizontal | C265101 | S3B-PH-SM4-TB(LF)(SN) | expand | 865 | 0.2803 | 0.2269 | v13b: JST PH 2 A/contact (was Molex PicoBlade 1 A); pack needs a JST PHR-3 housing
600R | 1 | R_ISET1 | R_0402_1005Metric | C4961 | 0402WGF6200TCE | expand | 51666 | 0.0040 | 0.0040 | 620R E24 nearest; BQ25185 charge current about 3% lower
681k | 1 | R_FB_TOP1 | R_0402_1005Metric | C49654482 | GR0402F681KTAG00 | expand | 9810 | 0.0008 | 0.0008
74HC154 | 2 | U_DEC_A1 U_DEC_B1 | TSSOP-24_4.4x7.8mm_P0.65mm | C21061 | 74HC154PW,118 | expand | 1830 | 0.8014 | 0.6124
91k | 1 | R_FB_BOT1 | R_0402_1005Metric | C2909393 | FRC0402F9102TS | expand | 171175 | 0.0017 | 0.0017
AO3403 | 32 | Q_ROW01 Q_ROW02 Q_ROW03 Q_ROW04 Q_ROW05 Q_ROW06 Q_ROW07 Q_ROW08 Q_ROW09 Q_ROW10 Q_ROW11 Q_ROW12 Q_ROW13 Q_ROW14 Q_ROW15 Q_ROW16 Q_ROW17 Q_ROW18 Q_ROW19 Q_ROW20 Q_ROW21 Q_ROW22 Q_ROW23 Q_ROW24 Q_ROW25 Q_ROW26 Q_ROW27 Q_ROW28 Q_ROW29 Q_ROW30 Q_ROW31 Q_ROW32 | SOT-23 | C47741 | AO3403 | expand | 27447 | 0.0838 | 0.0748
AON_3V3 | 1 | TP1 | R_0402_1005Metric |  |  |  |  |  |  | not assembled (test pad / mounting hole / solder jumper)
BMI270 | 1 | U_IMU1 | Bosch_LGA-14_3x2.5mm_P0.5mm | C2836813 | BMI270 | expand | 10460 | 2.6060 | 2.1629
BQ25185 | 1 | U_CHG1 | Texas_DLH0010A_WSON-10-1EP_2x2mm_P0.4mm_EP0.9x1.5mm | C19725033 | BQ25185DLHR | expand | 3398 | 1.5229 | 1.1157
DFE201612E-R47M | 1 | L_LED1 | L_Murata_DFE201610P | C668312 | DFE201612E-R47M=P2 | expand | 7567 | 0.1783 | 0.1525
ESP32-S3FN8 | 1 | U1 | QFN-56-1EP_7x7mm_P0.4mm_EP5.6x5.6mm | C2913196 | ESP32-S3FN8 | expand | 2543 | 3.3323 | 2.7770
FFC_40P_050_COL | 1 | J_COL1 | FFC_40P_050_COL | C202114 | FH12-40S-0.5SH(55) | expand | 5166 | 0.7281 | 0.5180 | v14: fitted in wearable; optional in installation
FFC_40P_050_ROW | 1 | J_ROW1 | FFC_40P_050_ROW | C202114 | FH12-40S-0.5SH(55) | expand | 5166 | 0.7281 | 0.5180 | v14: fitted in wearable; optional in installation
GND | 1 | TP2 | R_0402_1005Metric |  |  |  |  |  |  | not assembled (test pad / mounting hole / solder jumper)
KMR2 | 1 | SW1 | SW_Push_1P1T_NO_CK_KMR2 | C72443 | KMR221GLFS | expand | 5743 | 0.6515 | 0.4789
L327S400H11L | 1 | Y1 | Crystal_SMD_3225-4Pin_3.2x2.5mm | C136083 | X3S040000BA1H-R | expand | 872 | 0.1939 | 0.1367 | substitute: Yangxing X3S040000BA1H-R 40 MHz 3225 10 pF (original not stocked)
M2.5 | 4 | H1 H2 H3 H4 | MountingHole_2.7mm_M2.5_Pad |  |  |  |  |  |  | not assembled (test pad / mounting hole / solder jumper)
MA-HFA381-H13-1AF | 1 | MIC1 | MIC_Gettop_MA-HFA381_3.5x2.65mm | C50275762 | MA-HFA381-H13-1AF | expand | 368 | 1.3405 | 0.9805
MAX17048G+T10 | 1 | U_GAUGE1 | TDFN-8-1EP_2x2mm_P0.5mm_EP0.8x1.2mm | C2682616 | MAX17048G+T10 | expand | 25459 | 2.1450 | 1.7134
MBI5124GP-B | 2 | U_LED1 U_LED2 | SSOP-24_3.9x8.7mm_P0.635mm | C256866 | MBI5124GP-B | expand | 13598 | 0.1401 | 0.1145
NTC 10k B3435 | 1 | TH_PCB1 | R_0402_1005Metric | C279801 | SDNT1005X103F3435FTF | expand | 69403 | 0.0135 | 0.0135 | Sunlord SDNT1005X103F3435FTF
PESD3V3S2UT | 4 | D_E_SP1 D_N_SP1 D_S_SP1 D_W_SP1 | SOT-23 | C2687120 | PESD3V3S2UT | expand | 220515 | 0.0302 | 0.0235
SM06B-SRSS-TB | 4 | J_PORT_E1 J_PORT_N1 J_PORT_S1 J_PORT_W1 | JST_SH_SM06B-SRSS-TB_1x06-1MP_P1.00mm_Horizontal | C56123098 | XY-SM06B-SRSS-TB | expand | 1291 | 0.0693 | 0.0551 | XY clone, pin-compatible with JST SM06B-SRSS-TB
SM712 | 4 | D_E_AB1 D_N_AB1 D_S_AB1 D_W_AB1 | SOT-23 | C32677 | PSM712-LF-T7 | base | 108314 | 0.3237 | 0.2196
SN74LV125A | 1 | U_LED_BUF1 | TSSOP-14_4.4x5mm_P0.65mm | C406868 | SN74LV125APWR | expand | 1475 | 0.4707 | 0.3339
SN74LVC8T245RHLR | 1 | U_ROW_XLAT1 | Texas_RHL0024A_VQFN-24-1EP_3.5x5.5mm_P0.5mm_EP2.05x4.05mm | C350563 | SN74LVC8T245RHLR | expand | 2086 | 1.7053 | 1.2851
TERM | 1 | JP_TERM1 | SolderJumper-2_P1.3mm_Open_RoundedPad1.0x1.5mm |  |  |  |  |  |  | not assembled (test pad / mounting hole / solder jumper)
THVD1406DR | 1 | U_485 | SOIC-8_3.9x4.9mm_P1.27mm | C5215918 | THVD1406DR | expand | 14408 | 1.1369 | 0.9154
TLV75733PDBVR | 1 | U_LDO1 | SOT-23-5 | C485517 | TLV75733PDBVR | expand | 87046 | 0.1996 | 0.1567 | v11b AON LDO (1 A), drop-in for TPS7A2033
TLV9001IDCKR | 1 | U_AUDIO1 | SOT-353_SC-70-5 | C398362 | TLV9001IDCKR | expand | 23152 | 0.1696 | 0.1320
TPS22917 | 2 | U_AUDIO_SW1 U_LED_LOGIC1 | SOT-23-6 | C2681320 | TPS22917DBVR | expand | 23699 | 0.3988 | 0.3085
TPS63802DLAR | 1 | U_LED_PWR1 | TDFN-10-1EP_2x3mm_P0.5mm_EP0.9x2mm | C2845237 | TPS63802DLAR | expand | 15797 | 0.9691 | 0.7053
TYPE-C-31-M-12 | 1 | J_USB1 | USB_C_Receptacle_HRO_TYPE-C-31-M-12 | C165948 | TYPE-C-31-M-12 | expand | 408612 | 0.1860 | 0.1470
USBLC6-2SC6 | 1 | U_ESD1 | SOT-23-6 | C2827654 | USBLC6-2SC6 | expand | 74431 | 0.0447 | 0.0447
FFC cable 40P 0.5mm 120mm Type B (reverse / opposite-side contacts) | 2 | (off-board: J_ROW1-J_ROW, J_COL1-J_COL) | cable, not assembled | C5371276 | JS05B-40P-120-4-8 | expand | 701 | 0.1541 | 0.1211 | ORDER SEPARATELY - Type B ONLY; Type A mirrors pins 1<->40. Alternatives: 80 mm C5371275, 100 mm C2857750 (v13 default), 150 mm C2857751, 200 mm C2857752
100R | 1 | R_ID_3V1 | R_0402_1005Metric | C25076 | 0402WGF1000TCE | base | 7937205 | 0.0012 | 0.0012 | v12 new: ID_3V3 feed
33R DNP | 4 | R_EXP_SDI1 R_EXP_CLK1 R_EXP_LE1 R_EXP_OE1 | R_0402_1005Metric | C25105 | 0402WGF330JTCE | base | 1681494 | 0.0012 | 0.0012 | v12 DNP: fit to enable J_COL1 column-expansion taps
0R DNP | 1 | R_EXP_3V1 | R_0402_1005Metric | C17168 | 0402WGF0000TCE | base | 8042896 | 0.0025 | 0.0025 | v12 DNP: fit to feed EXP_3V3 (J_COL1 pin 39) from LED_LOGIC_3V3
PESD5V0S2BT | 1 | D_ID1 | SOT-23 | C49338 | PESD5V0S2BT,215 | expand | 28293 | 0.0851 | 0.0667 | v12 new: low-C (35 pF) ESD on ID_SDA/ID_SCL bus side
0466002.NRHF 2A | 1 | F_BAT1 | Fuse_1206_3216Metric | C3105 | 0466002.NRHF | expand | 34685 | 0.0672 | 0.0672 | v13 battery fuse
AO3401A | 1 | Q_BAT1 | SOT-23 | C15127 | AO3401A | base | 680966 | 0.1018 | 0.0823 | v13 reverse-battery ideal-diode PFET
10k | 1 | R_BATG1 | R_0402_1005Metric | C25744 | 0402WGF1002TCE | base | 19712523 | 0.0034 | 0.0034 | v13 (merged into 10k line in JLC BOM)
TPS259531DSGR | 1 | U_OVP1 | WSON-8-1EP 2x2 | C2155674 | TPS259531DSGR | expand | 2708 | 0.8730 | 0.6320 | v13 USB eFuse 5.7 V OV clamp
SMF12A | 1 | D_VBUS1 | D_SOD-123F | C2857273 | SMF12A | expand | 28633 | 0.0162 | 0.0162 | v13 VBUS_CONN TVS
2.7k | 1 | R_ILM1 | R_0402_1005Metric | C25885 | 0402WGF2701TCE | expand | 219760 | 0.0023 | 0.0023 | v13 eFuse ILIM 2000/2700+0.04 = 0.78 A (0.72-0.84 A), under BQ25185 1.1 A IN abs max
100k | 1 | R_EN_TOP1 | R_0402_1005Metric | C25741 | 0402WGF1003TCE | base | 8043409 | 0.0024 | 0.0024 | v13 (merged into 100k line)
39k | 1 | R_EN_BOT1 | R_0402_1005Metric | C25783 | 0402WGF3902TCE | expand | 201024 | 0.0024 | 0.0024 | v13 eFuse UVLO 4.28 V
BH127VS-40P-H49 DNP(wearable) | 2 | J_CH1 J_RH1 | BoxHeader 2x20 1.27mm SMD shrouded keyed | C42462832 | XFCN BH127VS-40P-H49 | expand | 125 | 0.8128 | 0.6499 | v14 installation only. Mating: XFCN IDC3-40232A1EUB1 2x20 1.27mm IDC socket (C49232620, stock 140) on 40-way 0.635 mm flat ribbon (e.g. 3M 3365/40 / 3756/40 class, off-LCSC). Stock thin - order ahead
PESD5V0S1BL DNP(wearable) | 64 | D_C01 D_C02 D_C03 D_C04 D_C05 D_C06 D_C07 D_C08 D_C09 D_C10 D_C11 D_C12 D_C13 D_C14 D_C15 D_C16 D_C17 D_C18 D_C19 D_C20 D_C21 D_C22 D_C23 D_C24 D_C25 D_C26 D_C27 D_C28 D_C29 D_C30 D_C31 D_C32 D_R01 D_R02 D_R03 D_R04 D_R05 D_R06 D_R07 D_R08 D_R09 D_R10 D_R11 D_R12 D_R13 D_R14 D_R15 D_R16 D_R17 D_R18 D_R19 D_R20 D_R21 D_R22 D_R23 D_R24 D_R25 D_R26 D_R27 D_R28 D_R29 D_R30 D_R31 D_R32 | D_SOD-882 | C84374 | PESD5V0S1BL,315 | expand | 127406 | 0.0334 | 0.0258 | v14 installation only: ESD on every LED line at the header
