illiapliukhin/led-cube-32-controller/hardware/wire_grid_32x32/out/wire_grid_detail.step

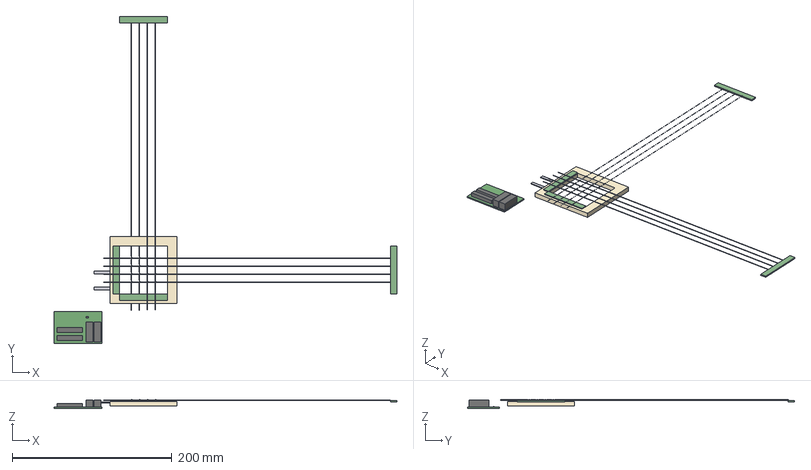
[picture p26: CAD file, 2026-10-12]
hardware/wire_grid_32x32/out/wire_grid_detail.step
430.0 x 410.0 x 11.2 mm
row_wires_0p5_enamel
col_wires_0p25_enamel
leds_NCD0603W1
led_emitters
kapton_crossings
frame
rails_fr4
tag_WG_TAG
tag_headers
fan_ribbons
