illiapliukhin/led-cube-32-controller/hardware/wire_grid_32x32/renders/sim_bringup_wire.png

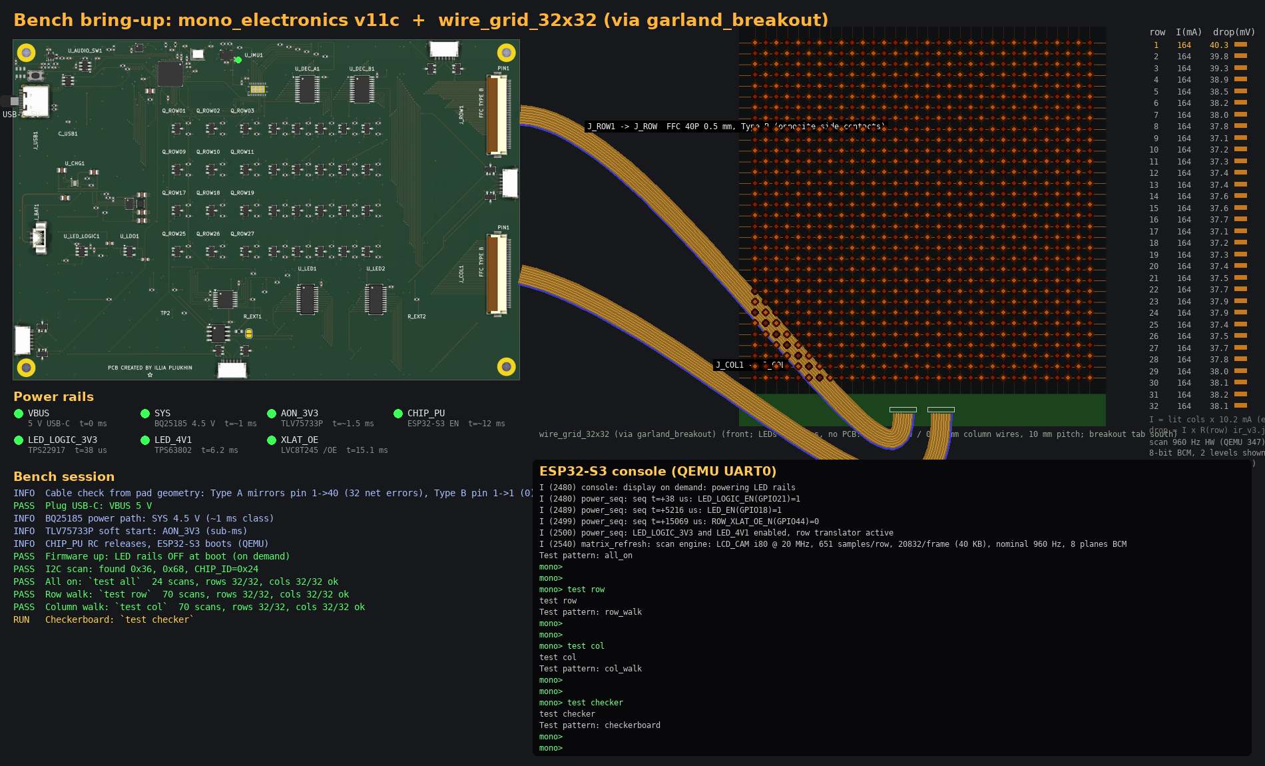
hardware/wire_grid_32x32/renders/sim_bringup_wire.png
