illiapliukhin/led-cube-32-controller/hardware/v15_baseline/drawings/mono_electronics_v15_assembly_top.pdf

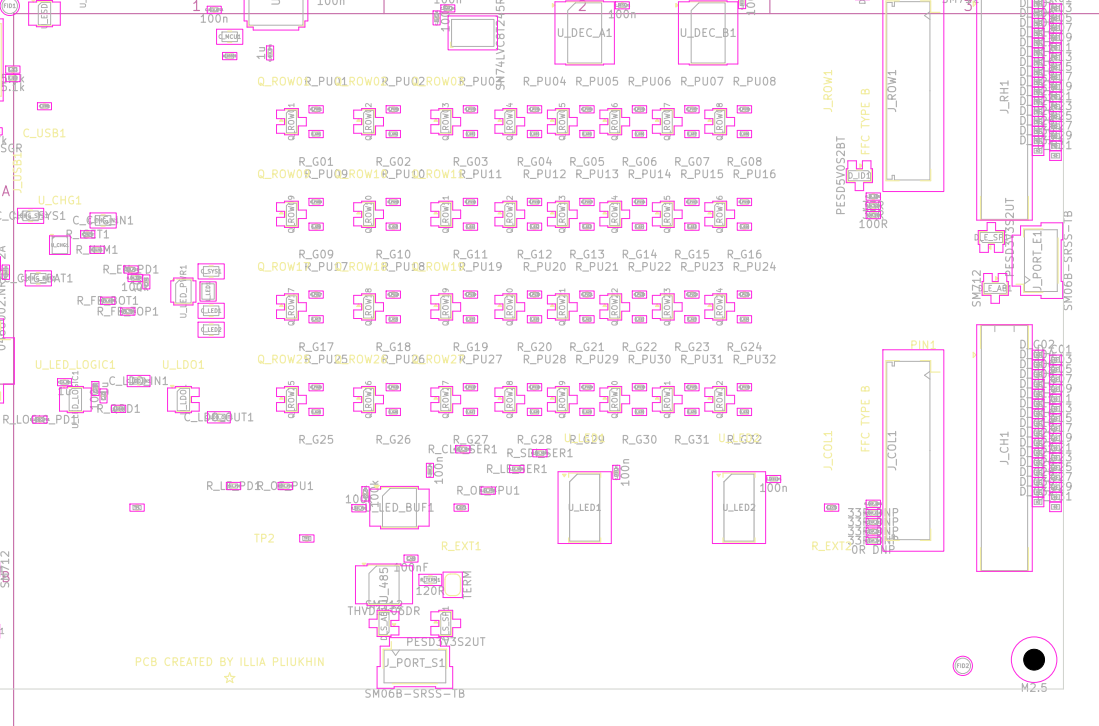
[picture p29: page 1]

PIN1 PIN1 FFC TYPE B FFC TYPE B

R_EXP_3V1 PCB CREATED BY ILLIA PLIUKHIN

Size: A4 | Rev:
KiCad E.D.A. 10.0.7 | Id: 1/1
