illiapliukhin/led-cube-32-controller/hardware/v15_baseline/drawings/mono_electronics_v15_schematic.pdf

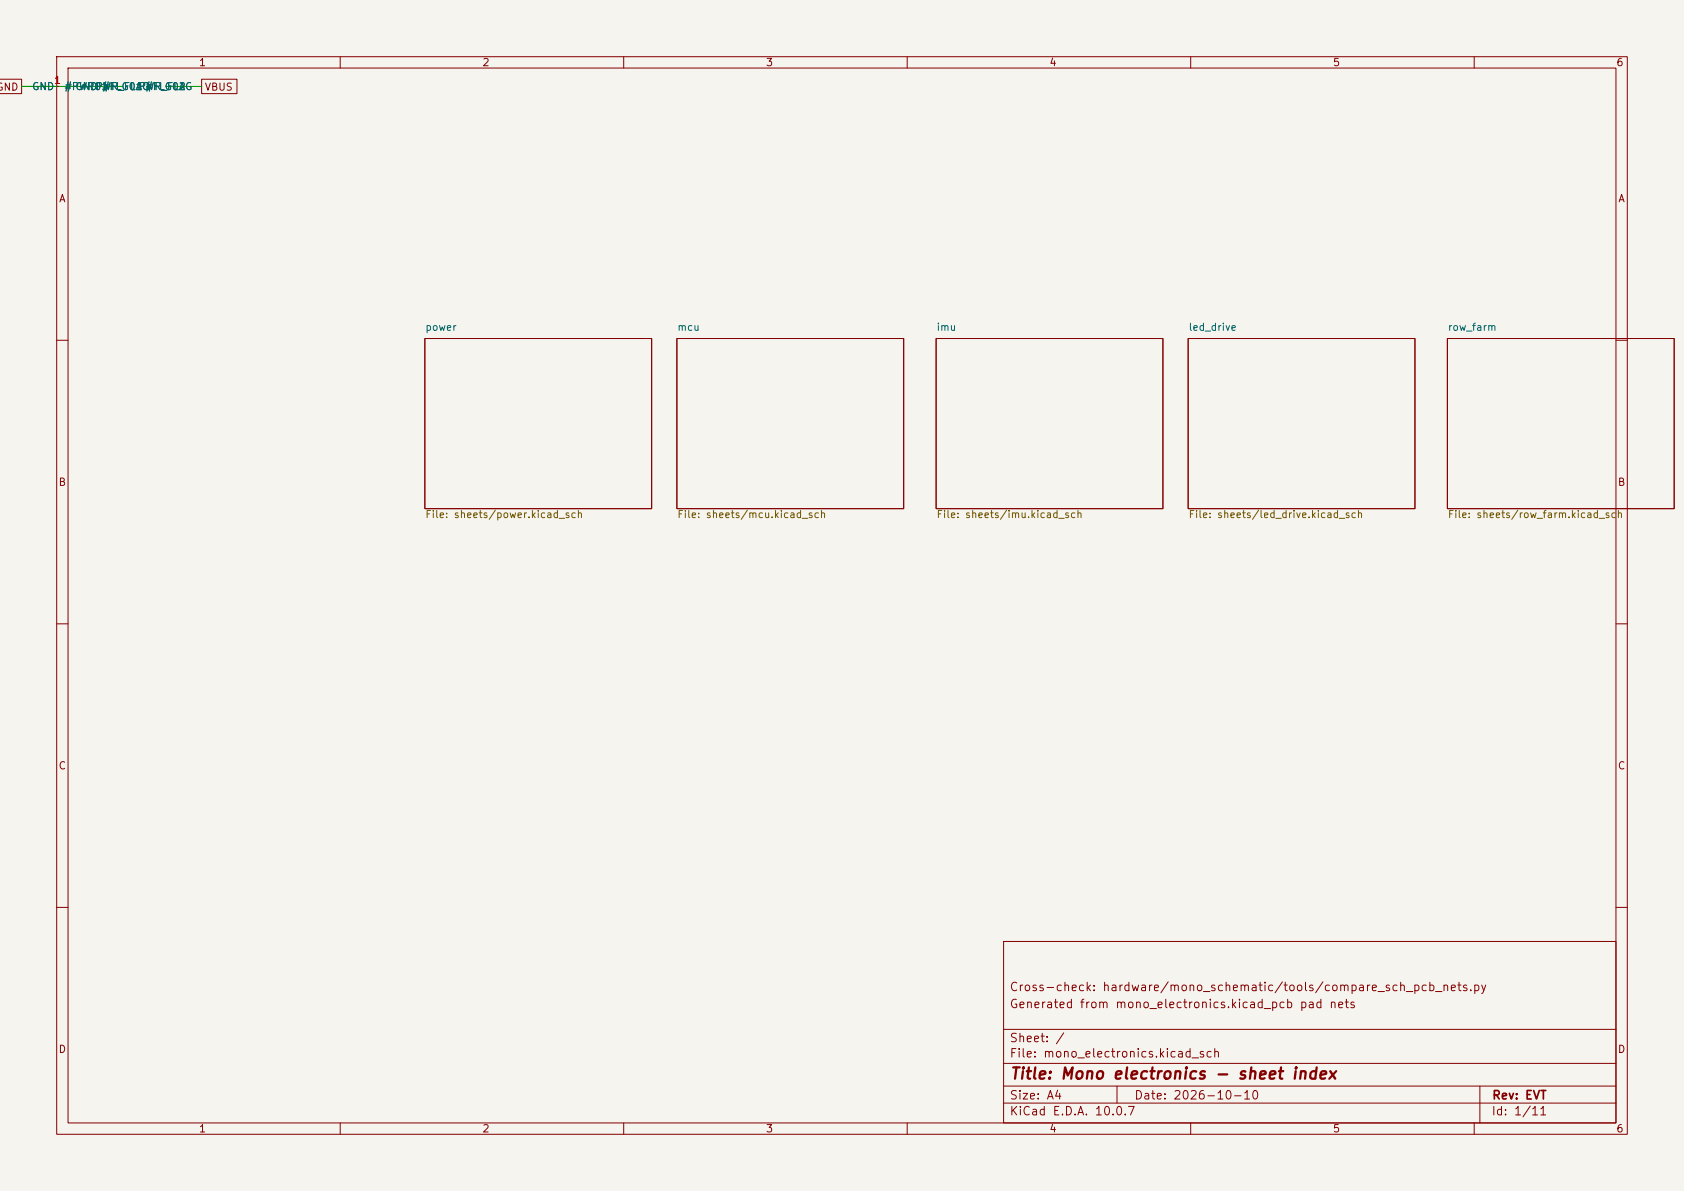
[picture p30: page 1]

File: sheets/imu.kicad_sch mcu

Cross-check: hardware/mono_schematic/tools/compare_sch_pcb_nets.py
Generated from mono_electronics.kicad_pcb pad nets

Sheet: /
File: mono_electronics.kicad_sch
Title: Mono electronics - sheet index

Size: A4 | Rev: EVT
KiCad E.D.A. 10.0.7 | Id: 1/11

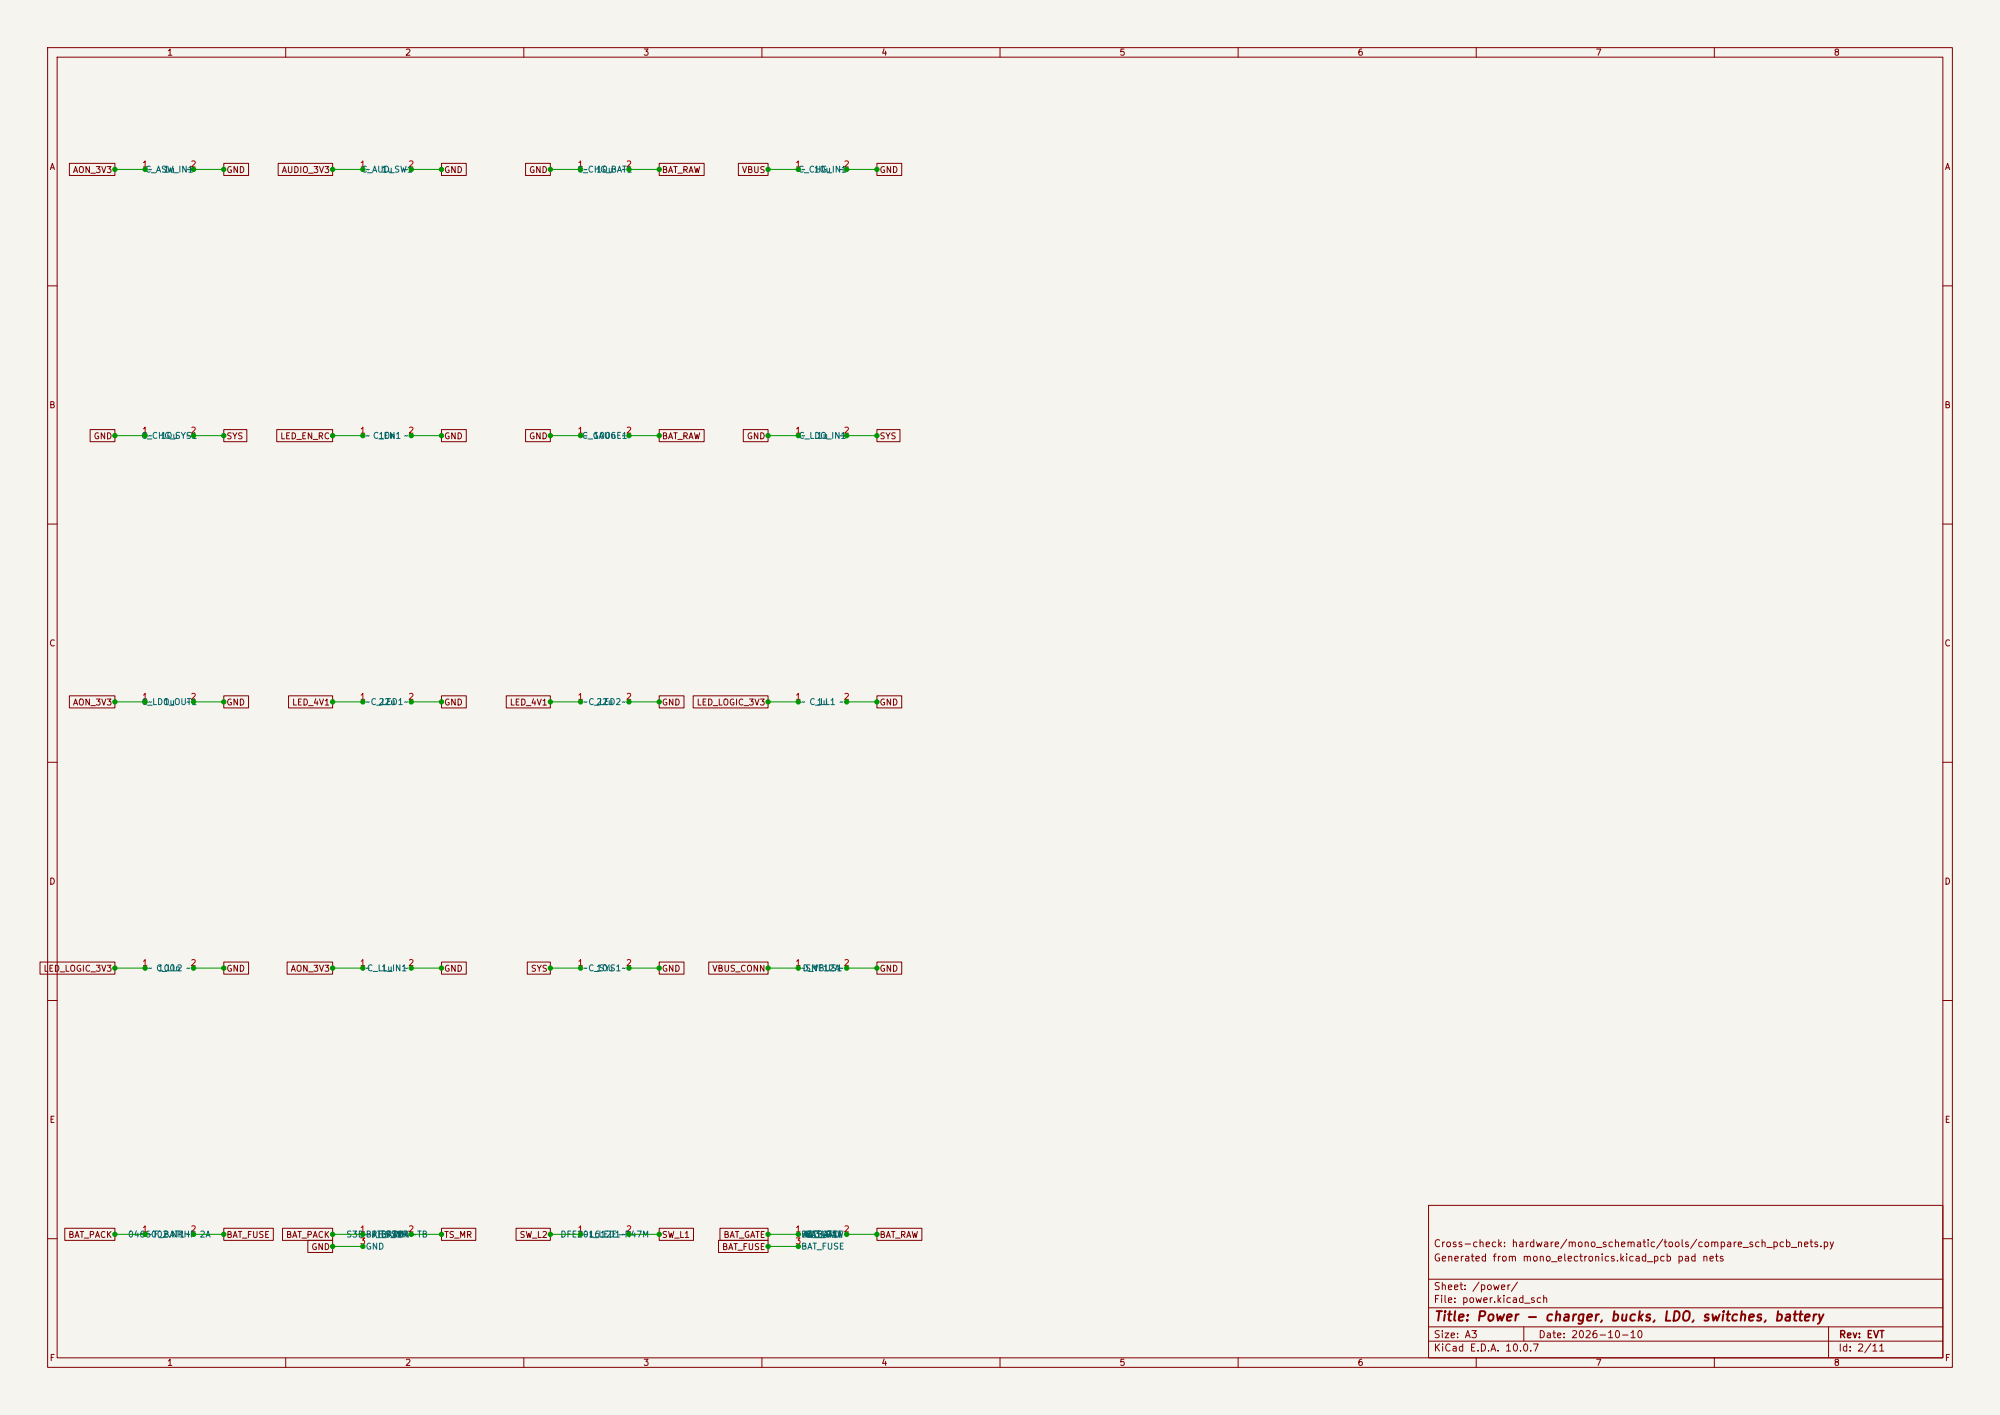
[picture p31: page 2]

Cross-check: hardware/mono_schematic/tools/compare_sch_pcb_nets.py
Generated from mono_electronics.kicad_pcb pad nets

Sheet: /power/
File: power.kicad_sch
Title: Power - charger, bucks, LDO, switches, battery

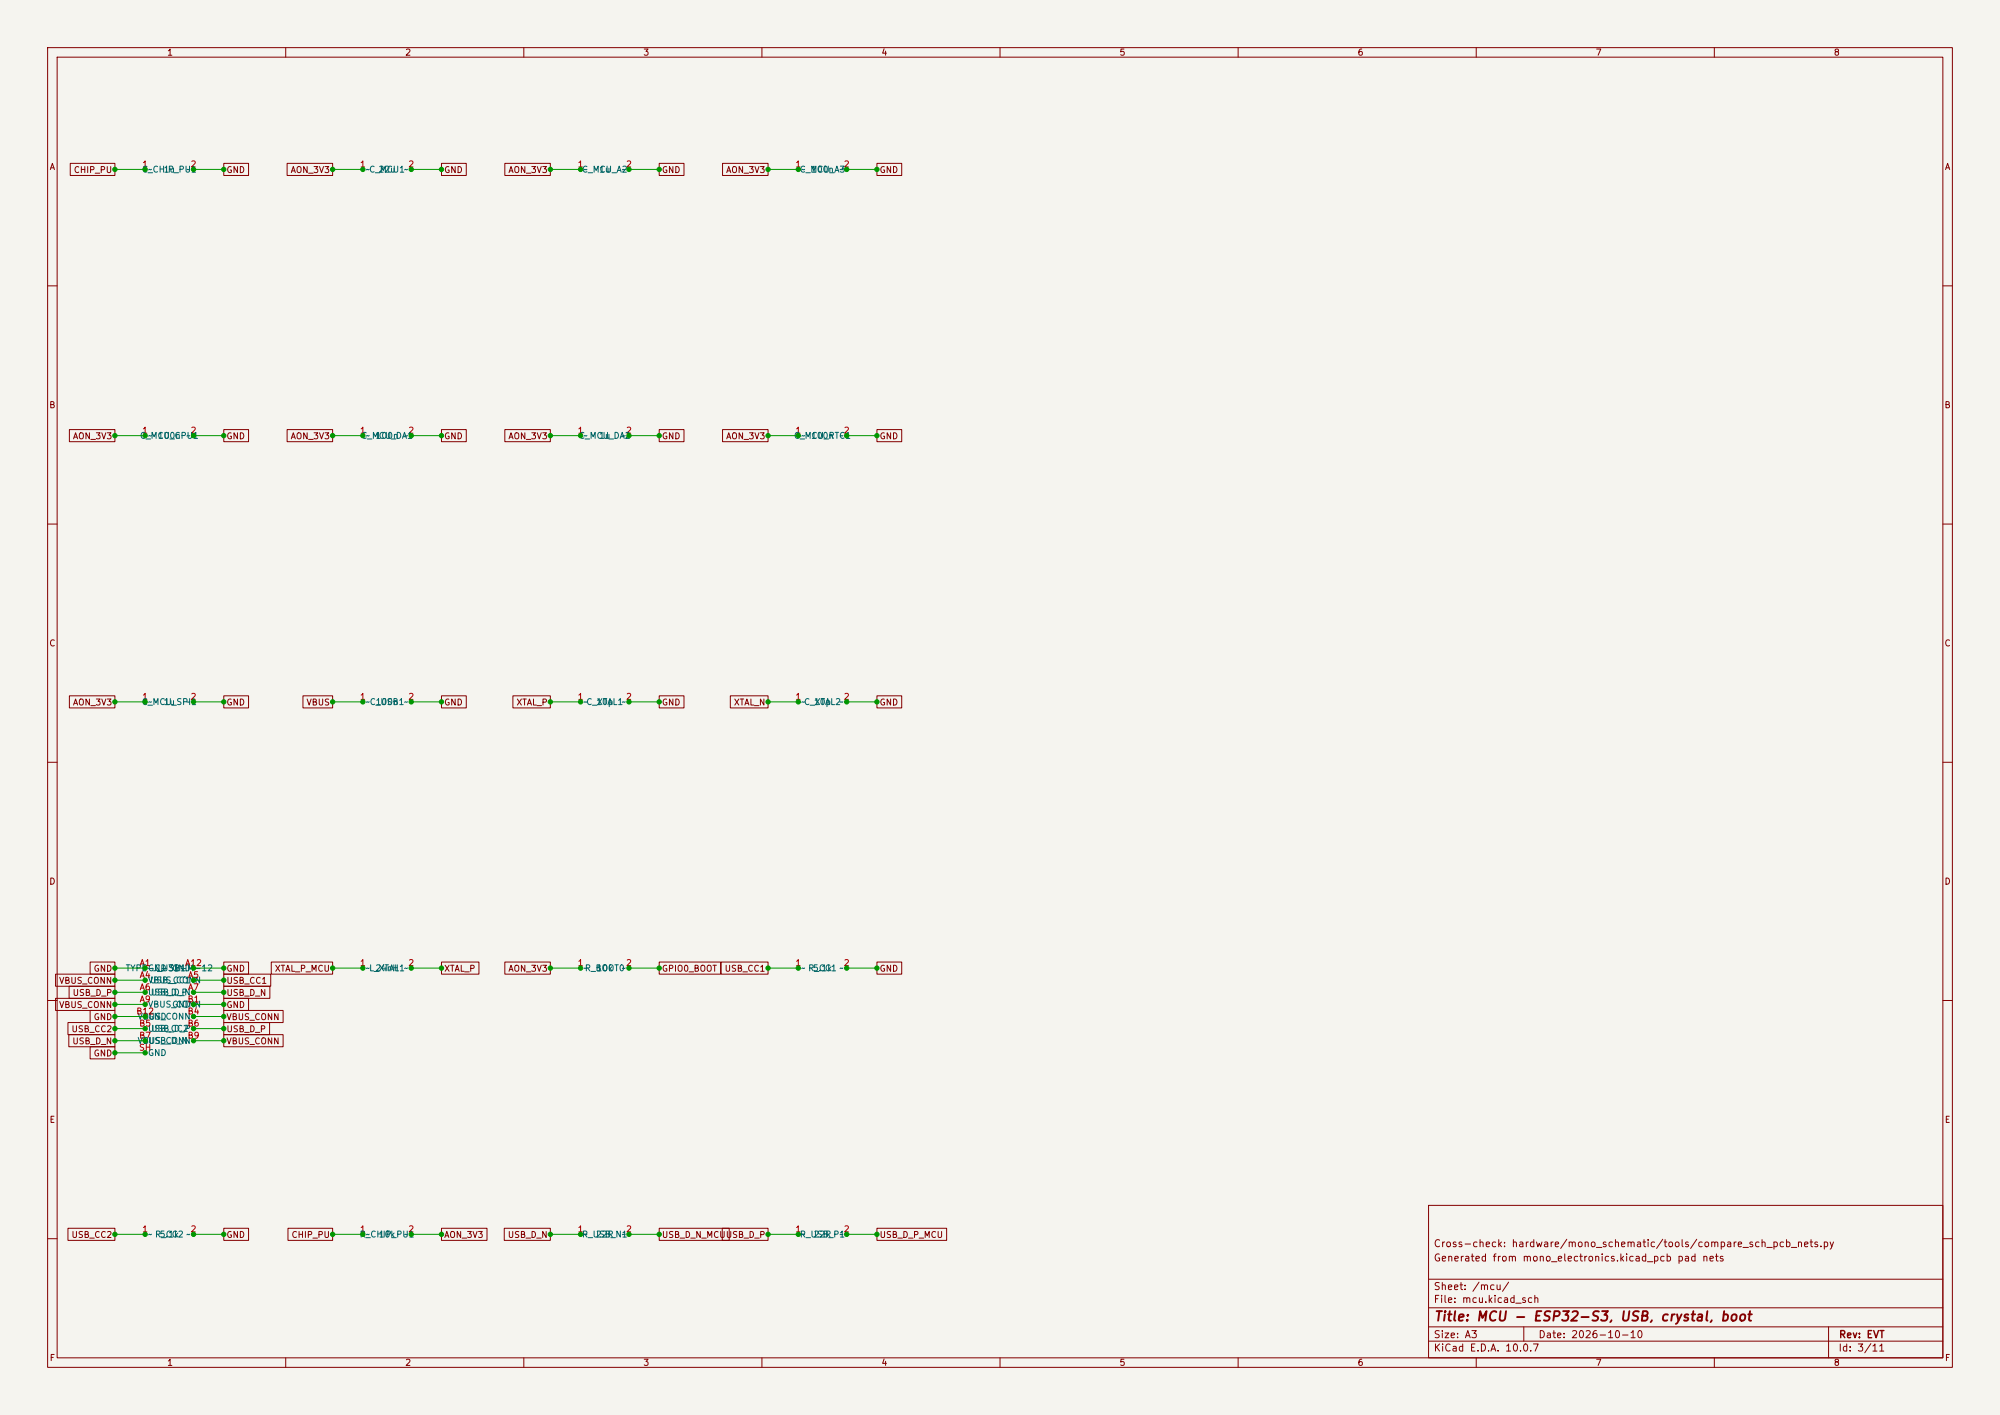
[picture p32: page 3]

Cross-check: hardware/mono_schematic/tools/compare_sch_pcb_nets.py
Generated from mono_electronics.kicad_pcb pad nets

Sheet: /mcu/
File: mcu.kicad_sch
Title: MCU - ESP32-S3, USB, crystal, boot

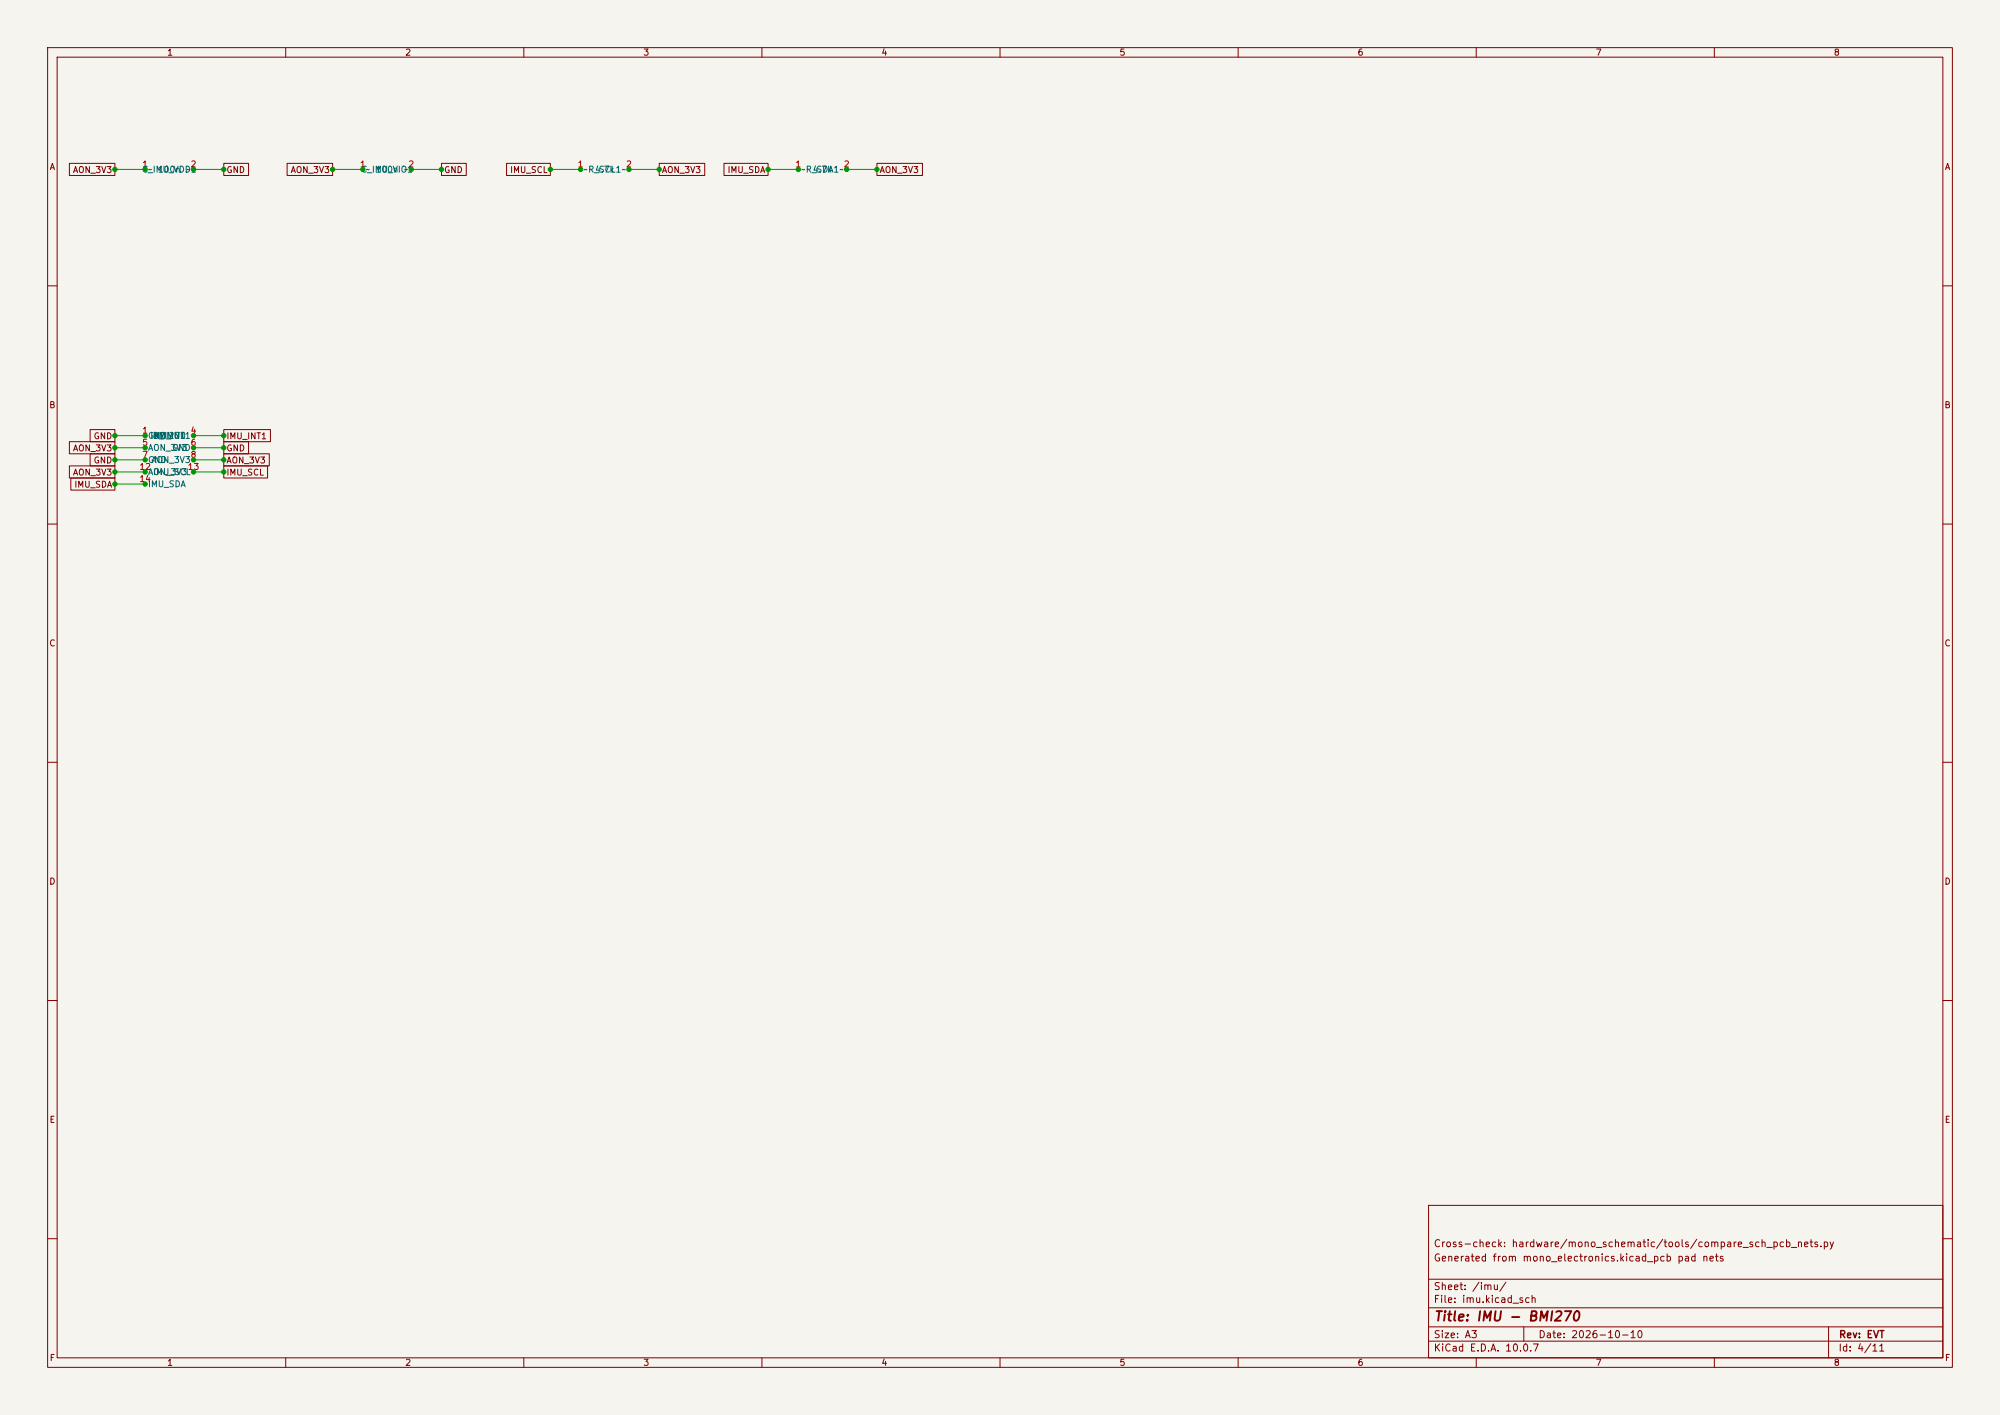
[picture p33: page 4]

Cross-check: hardware/mono_schematic/tools/compare_sch_pcb_nets.py
Generated from mono_electronics.kicad_pcb pad nets

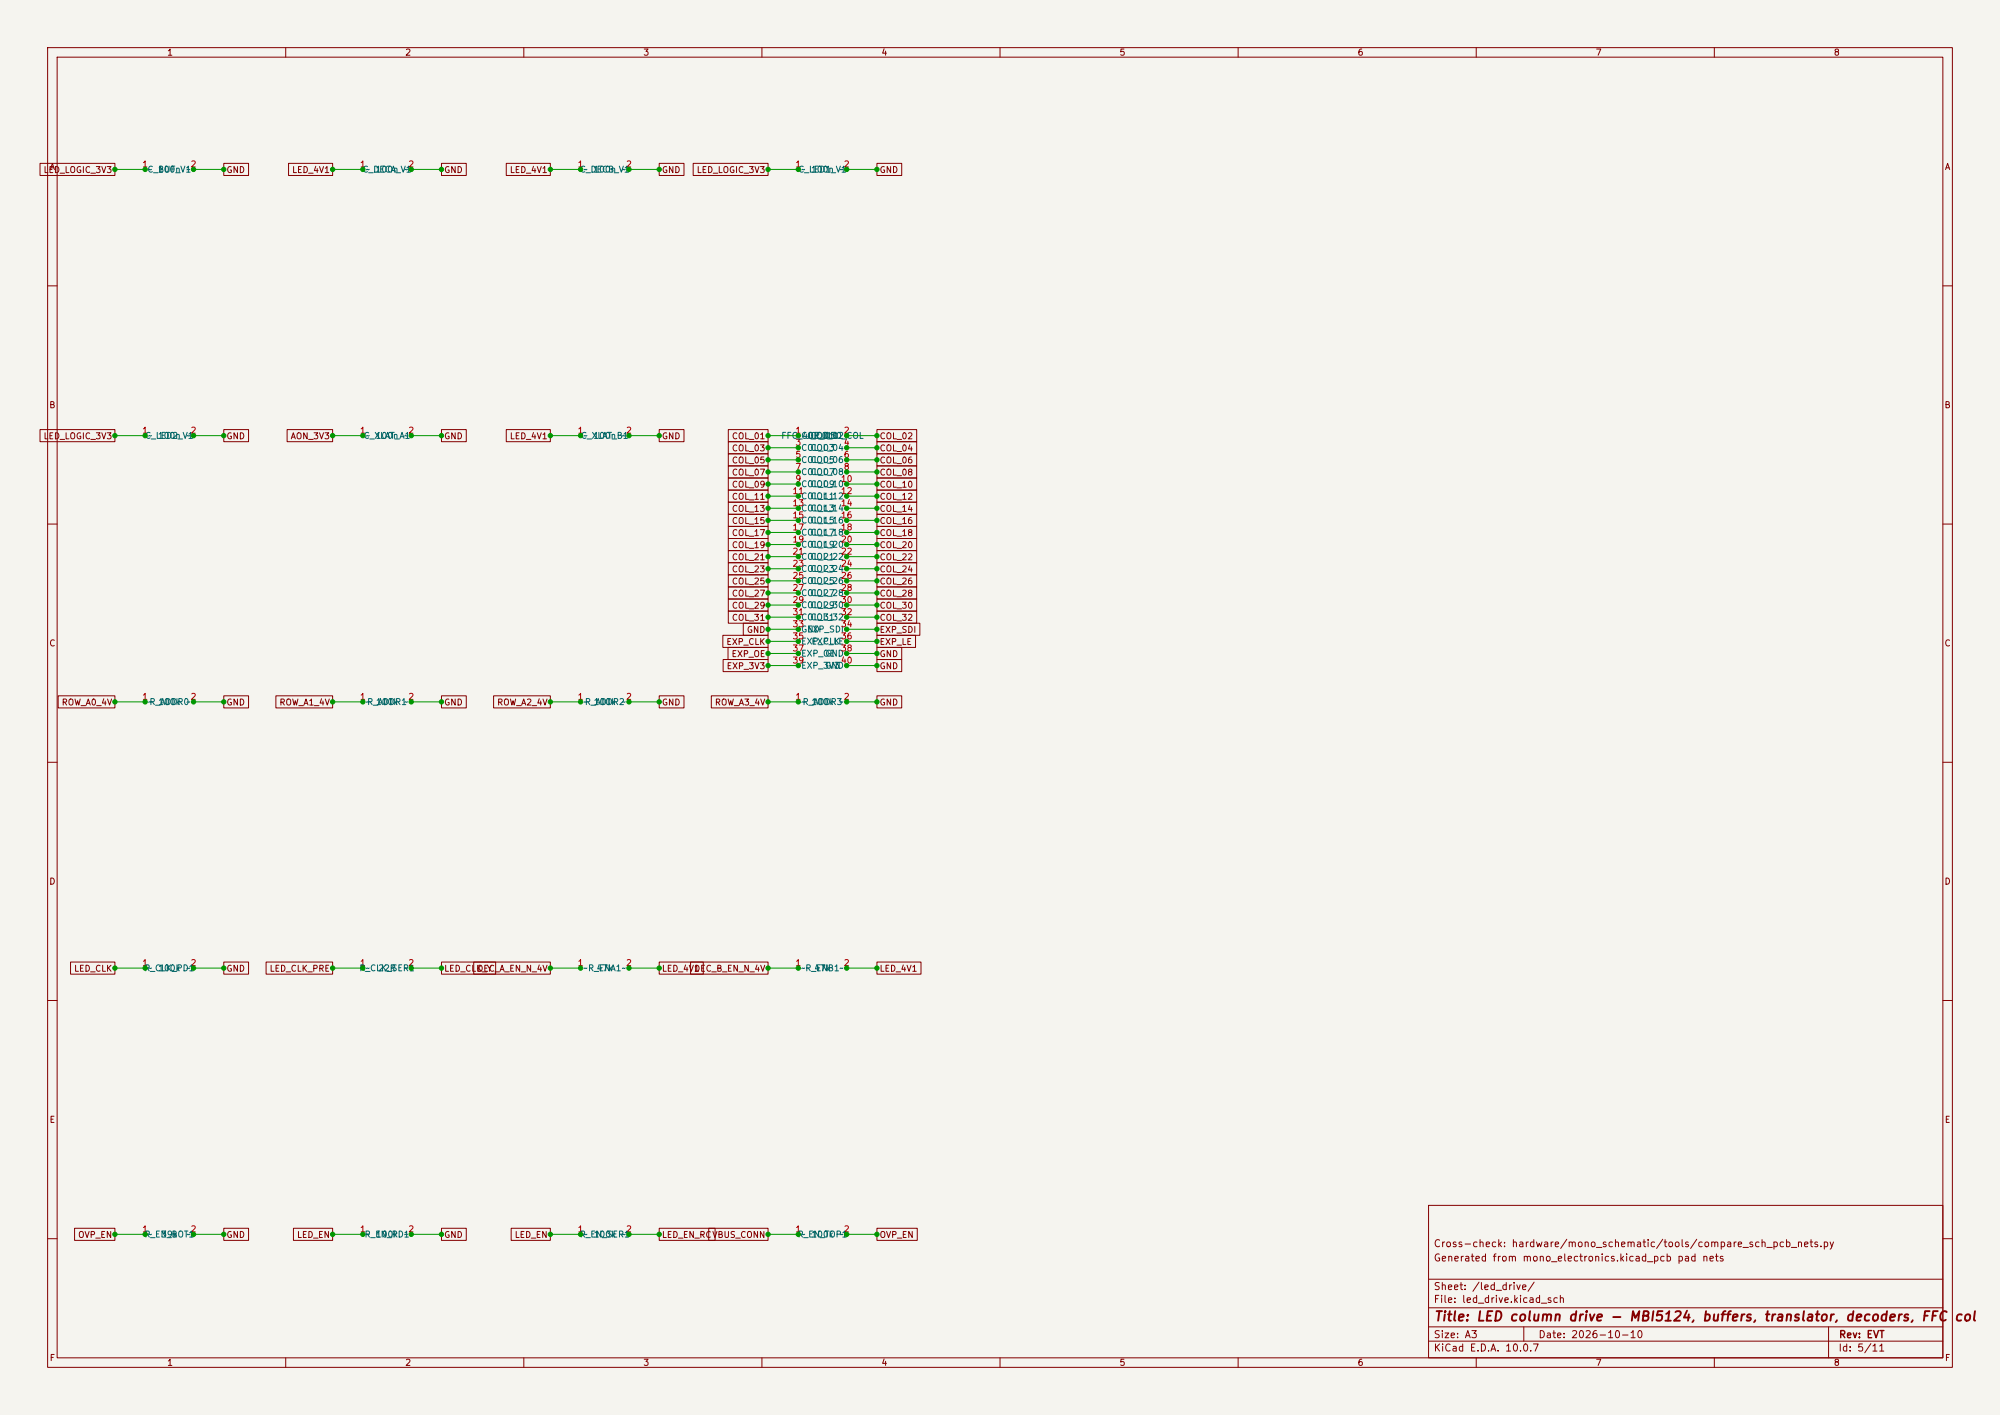
[picture p34: page 5]

Cross-check: hardware/mono_schematic/tools/compare_sch_pcb_nets.py
Generated from mono_electronics.kicad_pcb pad nets

Sheet: /led_drive/
File: led_drive.kicad_sch
Title: LED column drive - MBI5124, buffers, translator, decoders, FFC col

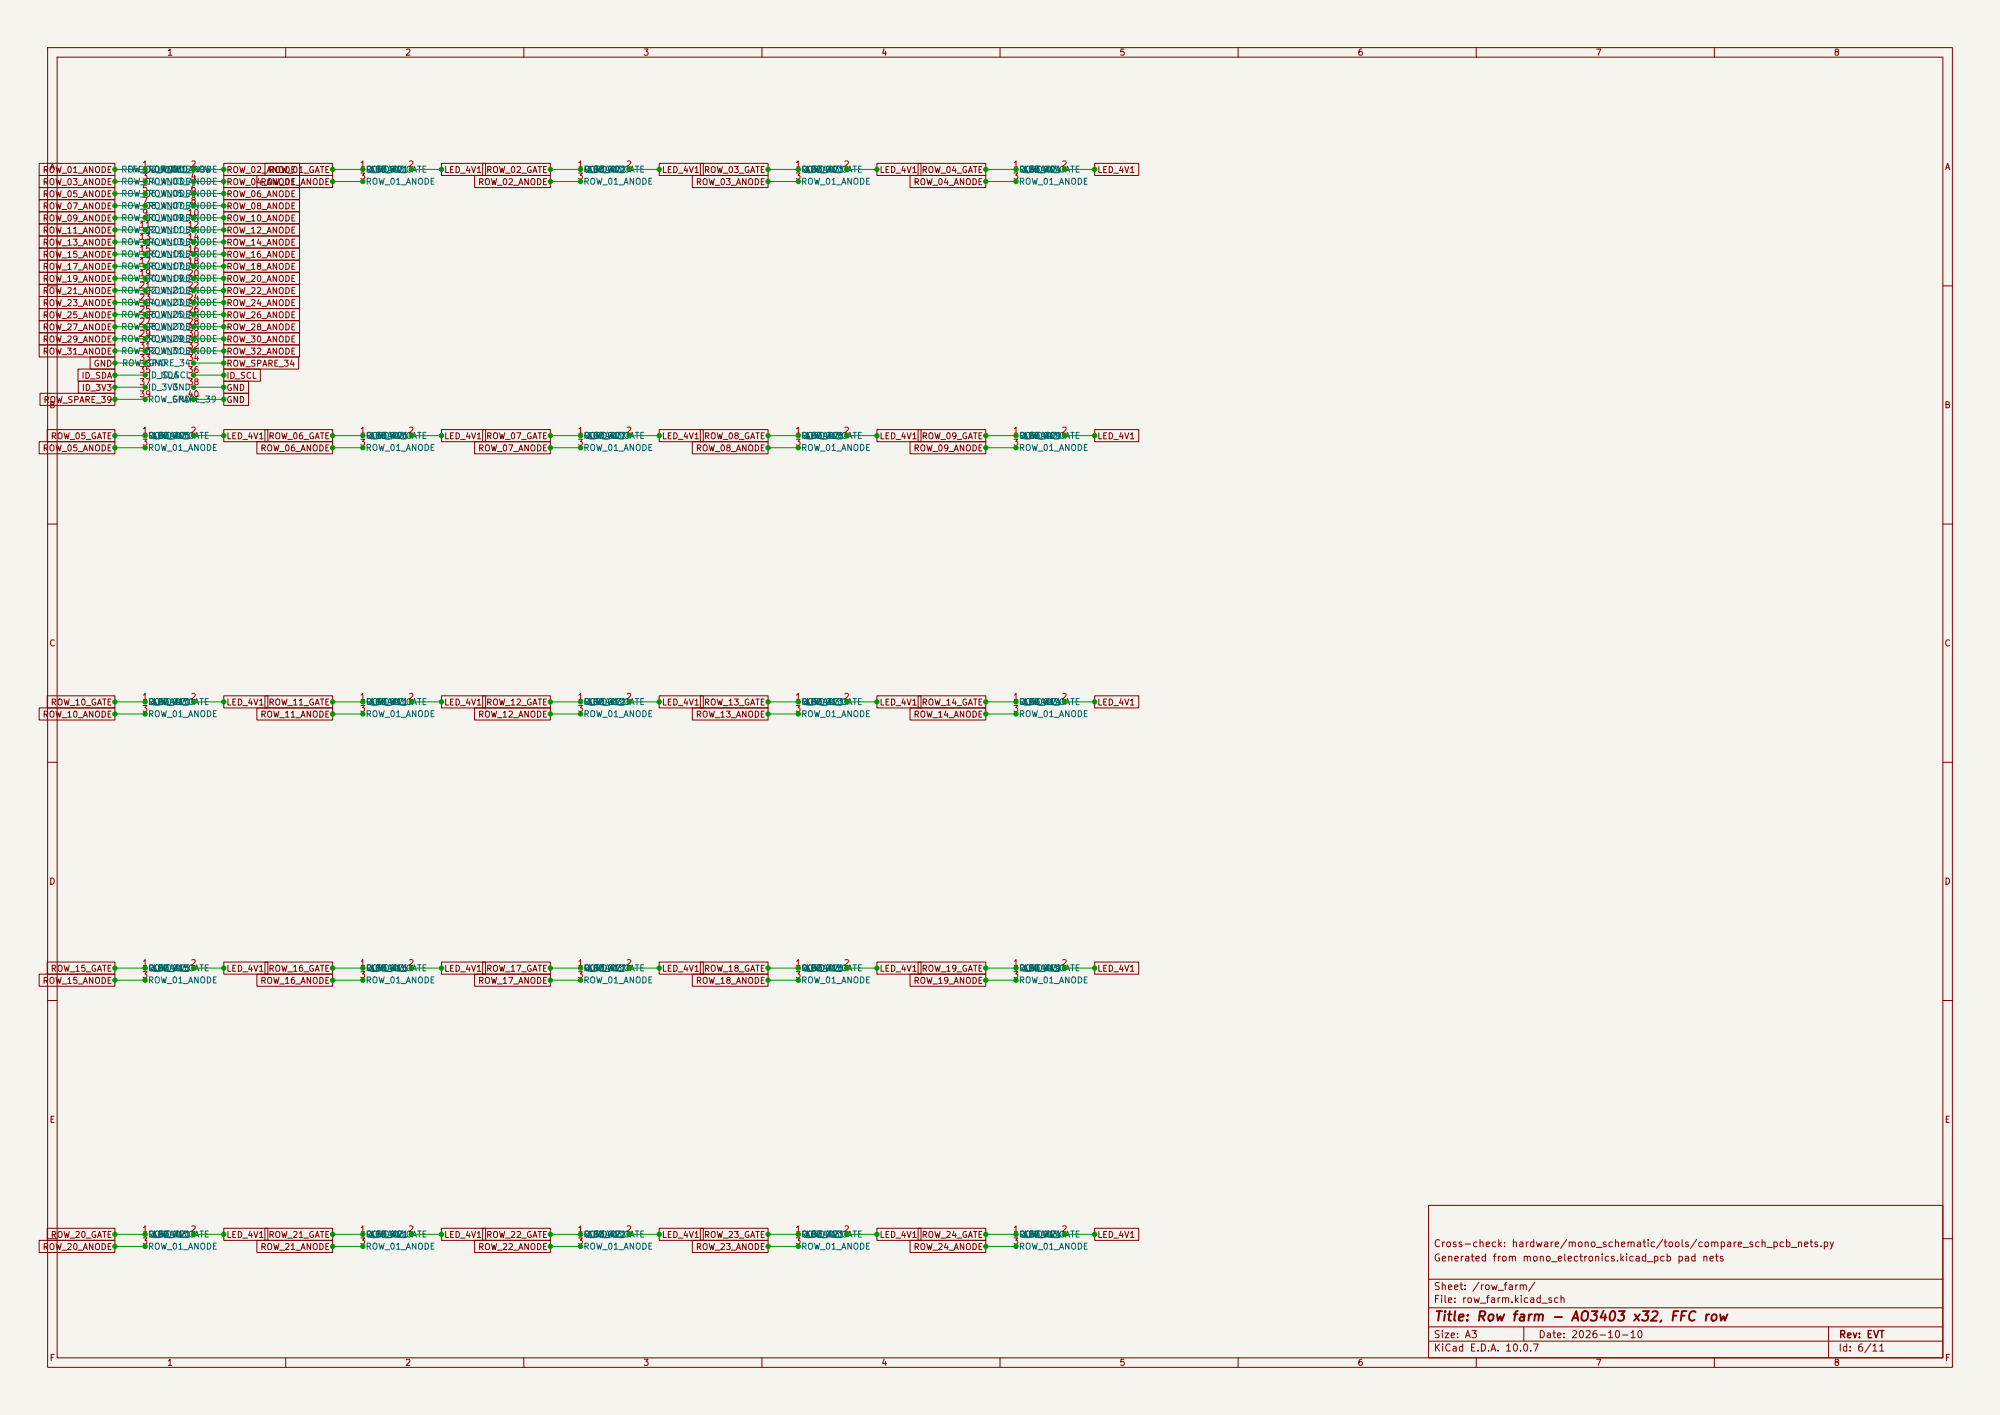
[picture p35: page 6]

Cross-check: hardware/mono_schematic/tools/compare_sch_pcb_nets.py
Generated from mono_electronics.kicad_pcb pad nets

Sheet: /row_farm/
File: row_farm.kicad_sch
Title: Row farm - AO3403 x32, FFC row

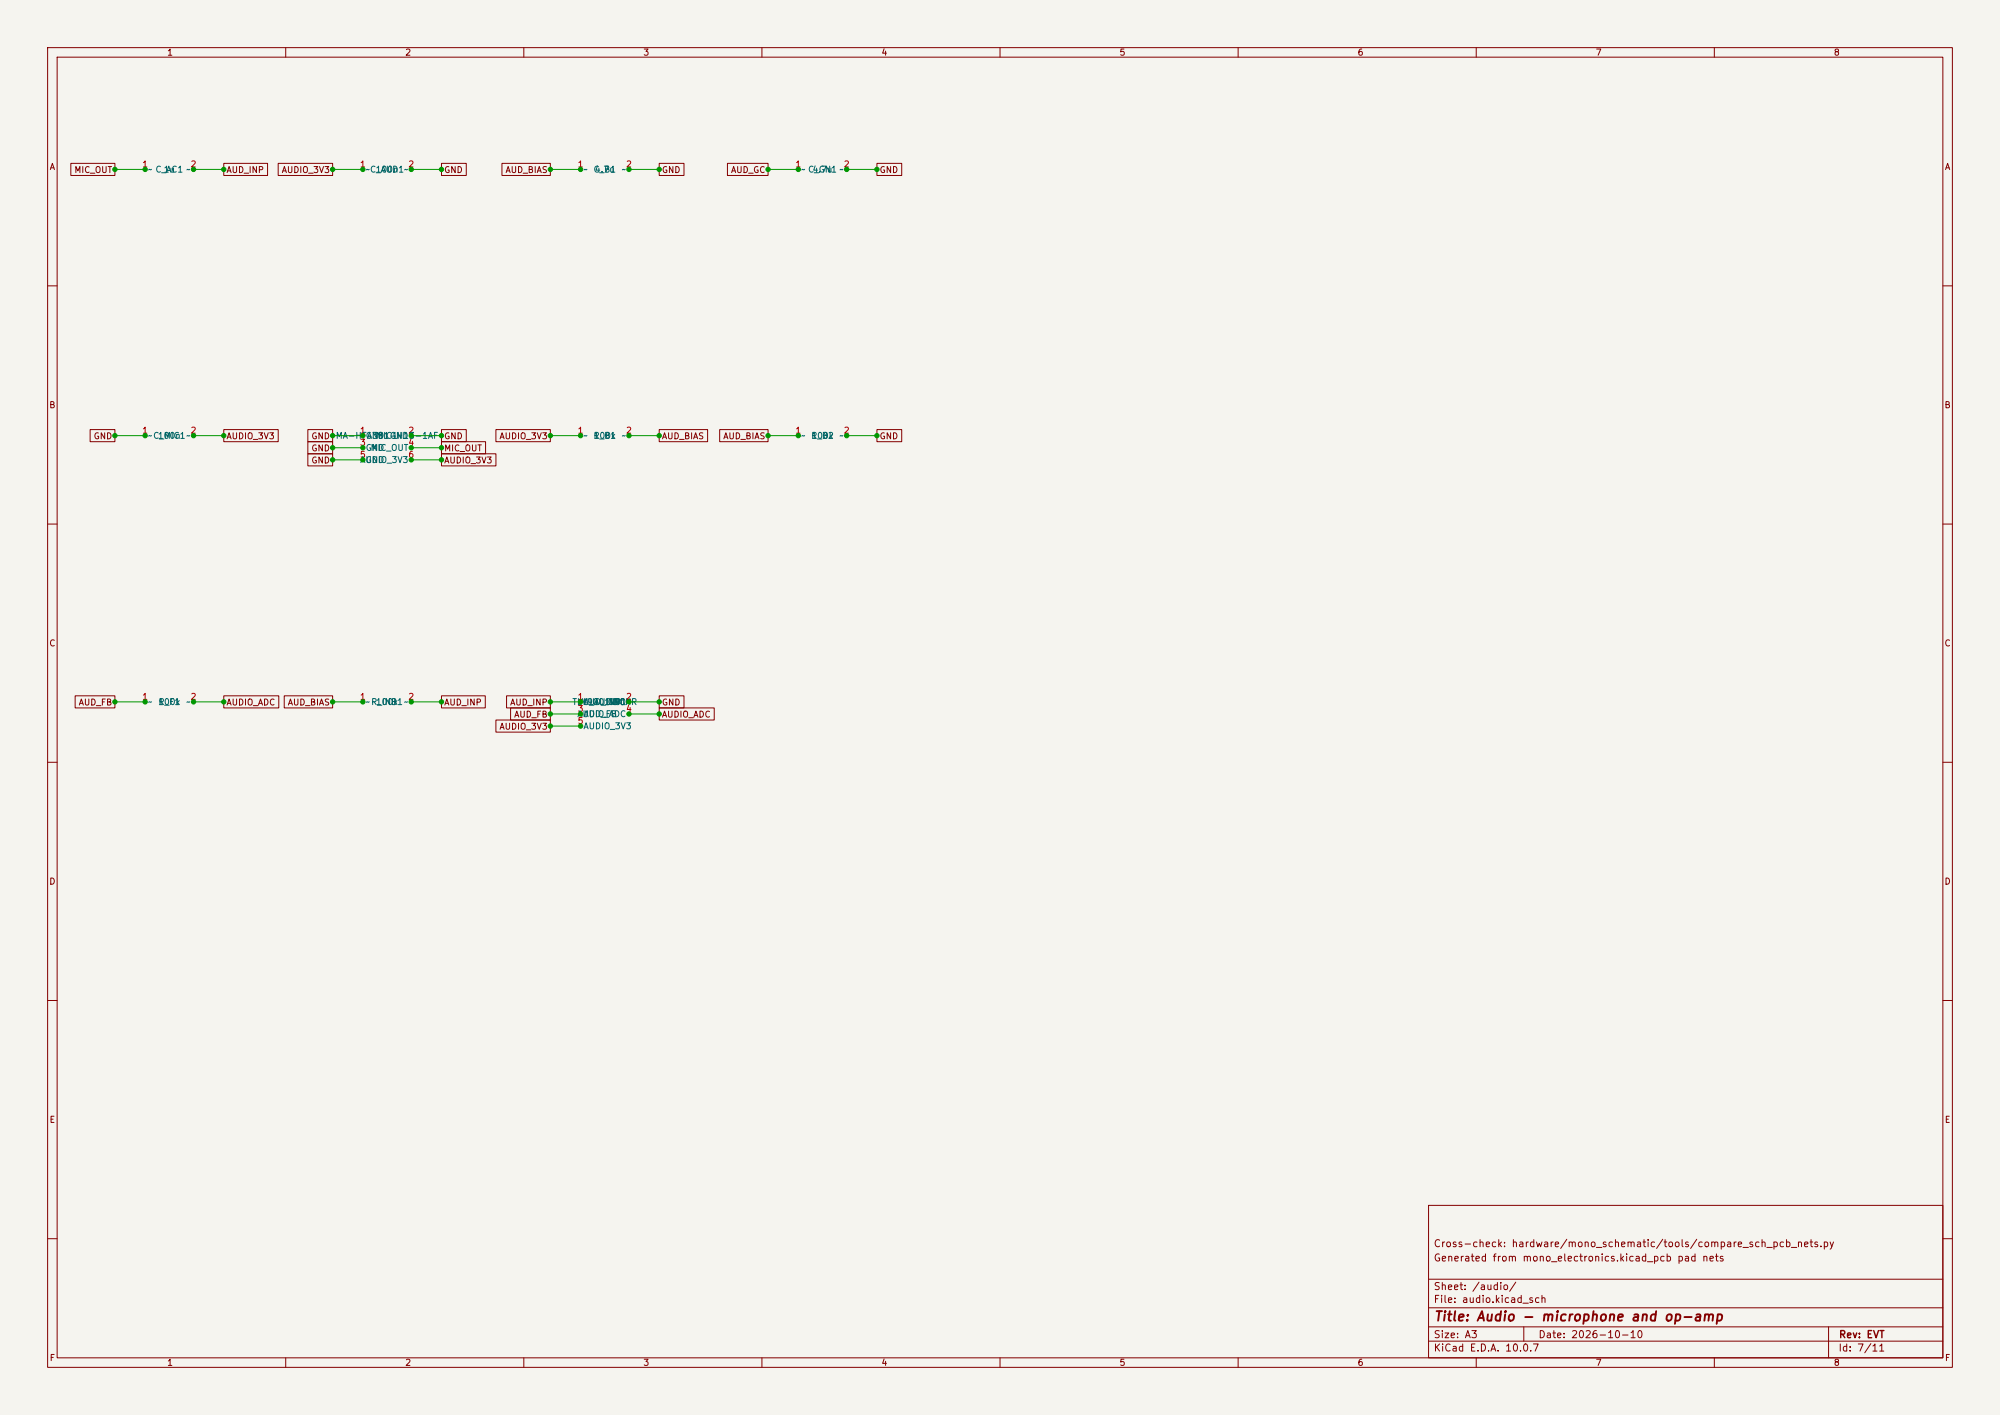
[picture p36: page 7]

Cross-check: hardware/mono_schematic/tools/compare_sch_pcb_nets.py
Generated from mono_electronics.kicad_pcb pad nets

Sheet: /audio/
File: audio.kicad_sch
Title: Audio - microphone and op-amp

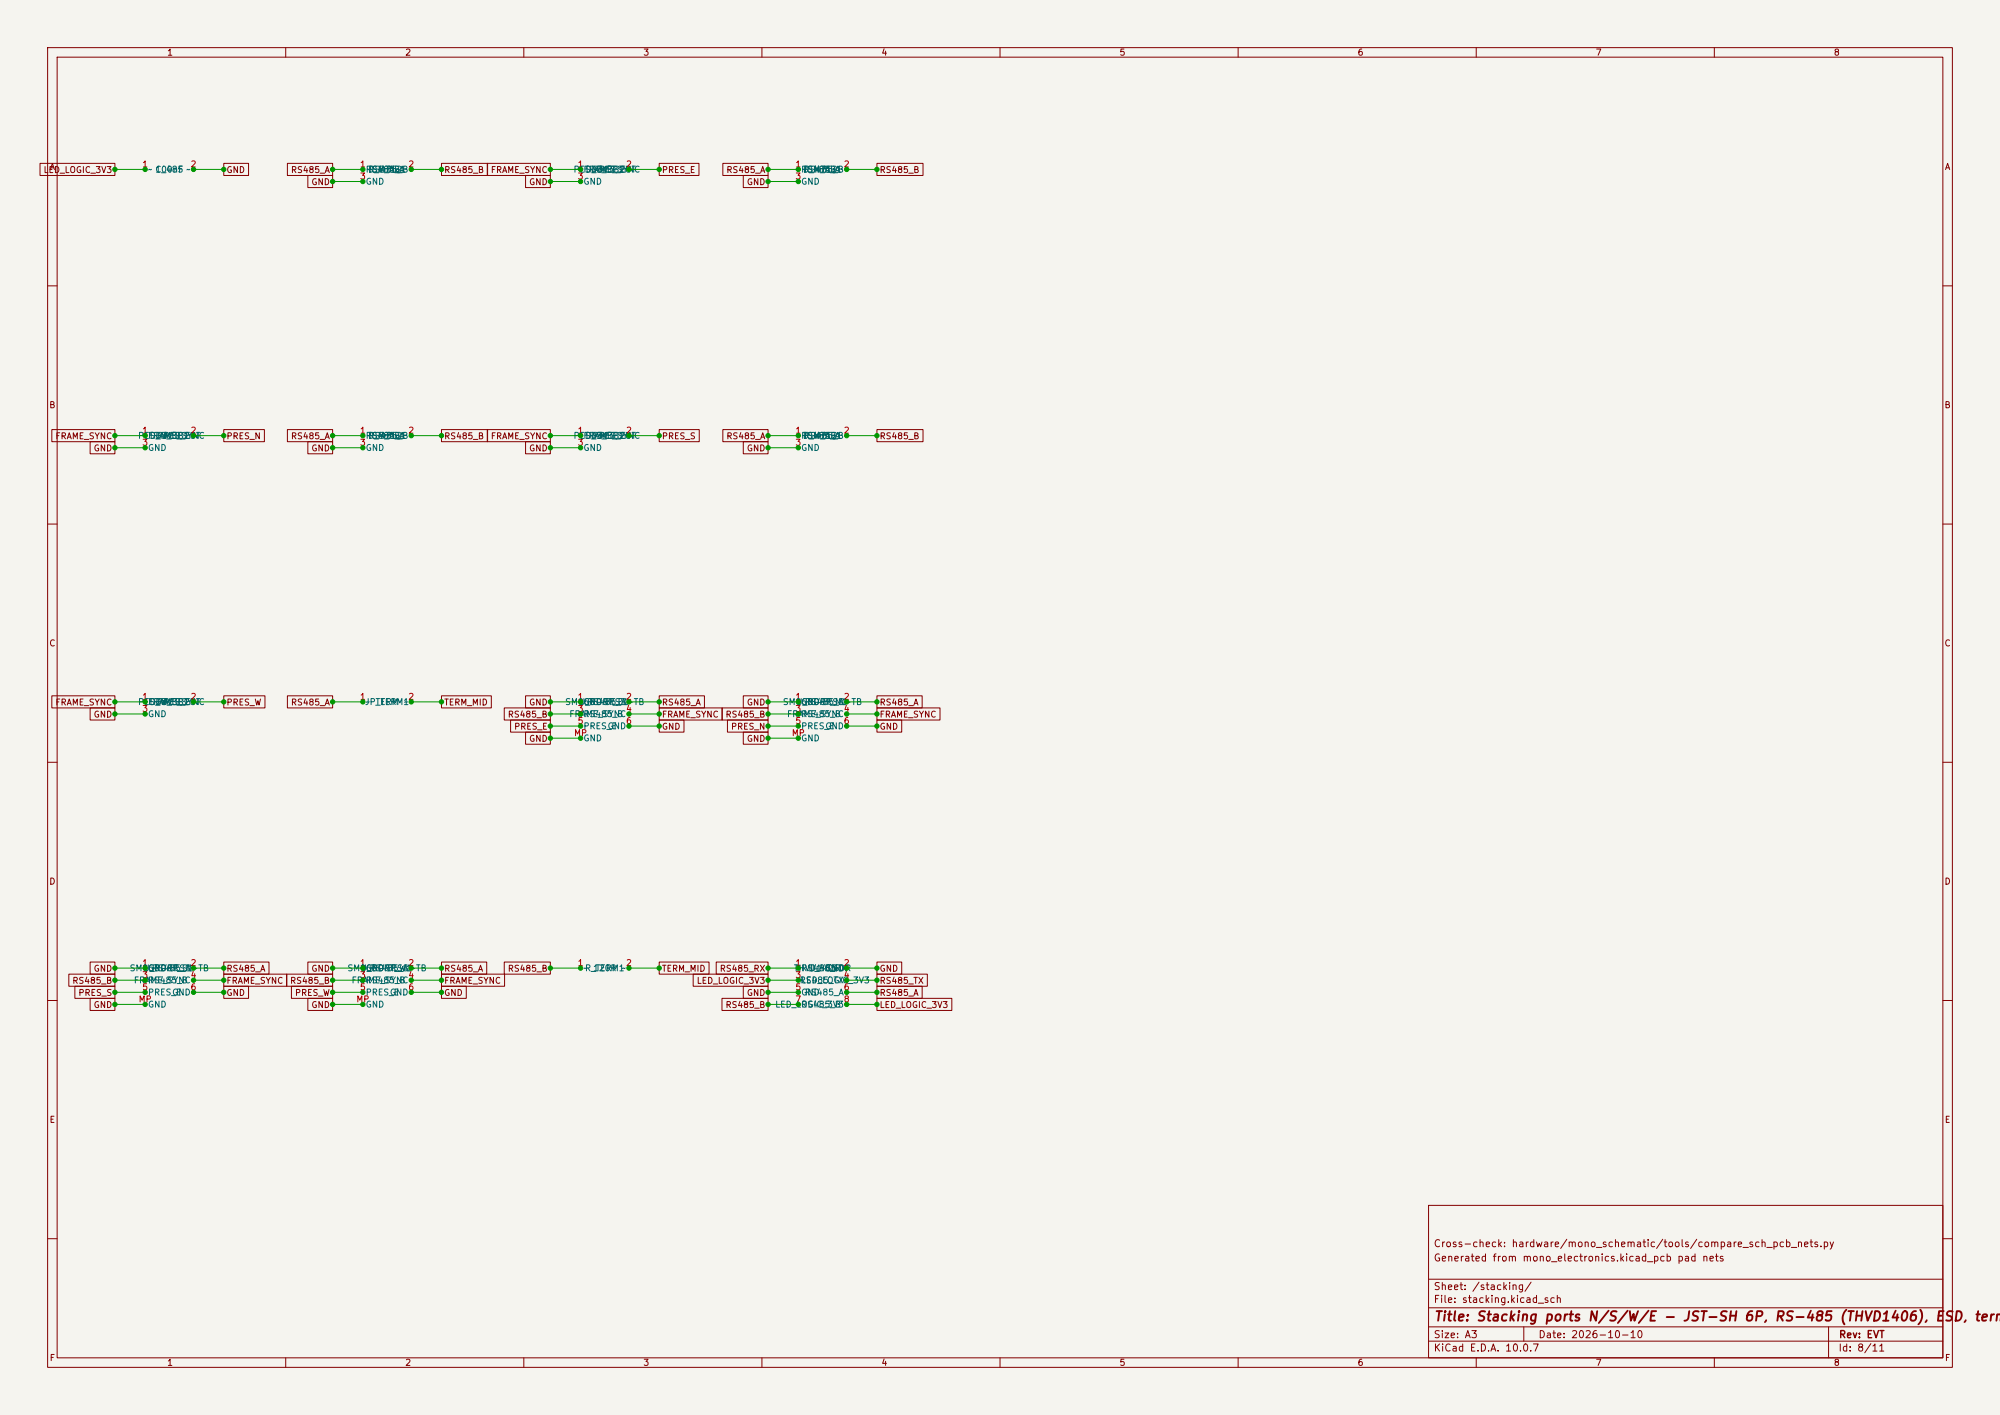
[picture p37: page 8]

Cross-check: hardware/mono_schematic/tools/compare_sch_pcb_nets.py
Generated from mono_electronics.kicad_pcb pad nets

Sheet: /stacking/
File: stacking.kicad_sch
Title: Stacking ports N/S/W/E - JST-SH 6P, RS-485 (THVD1406), ESD, termination

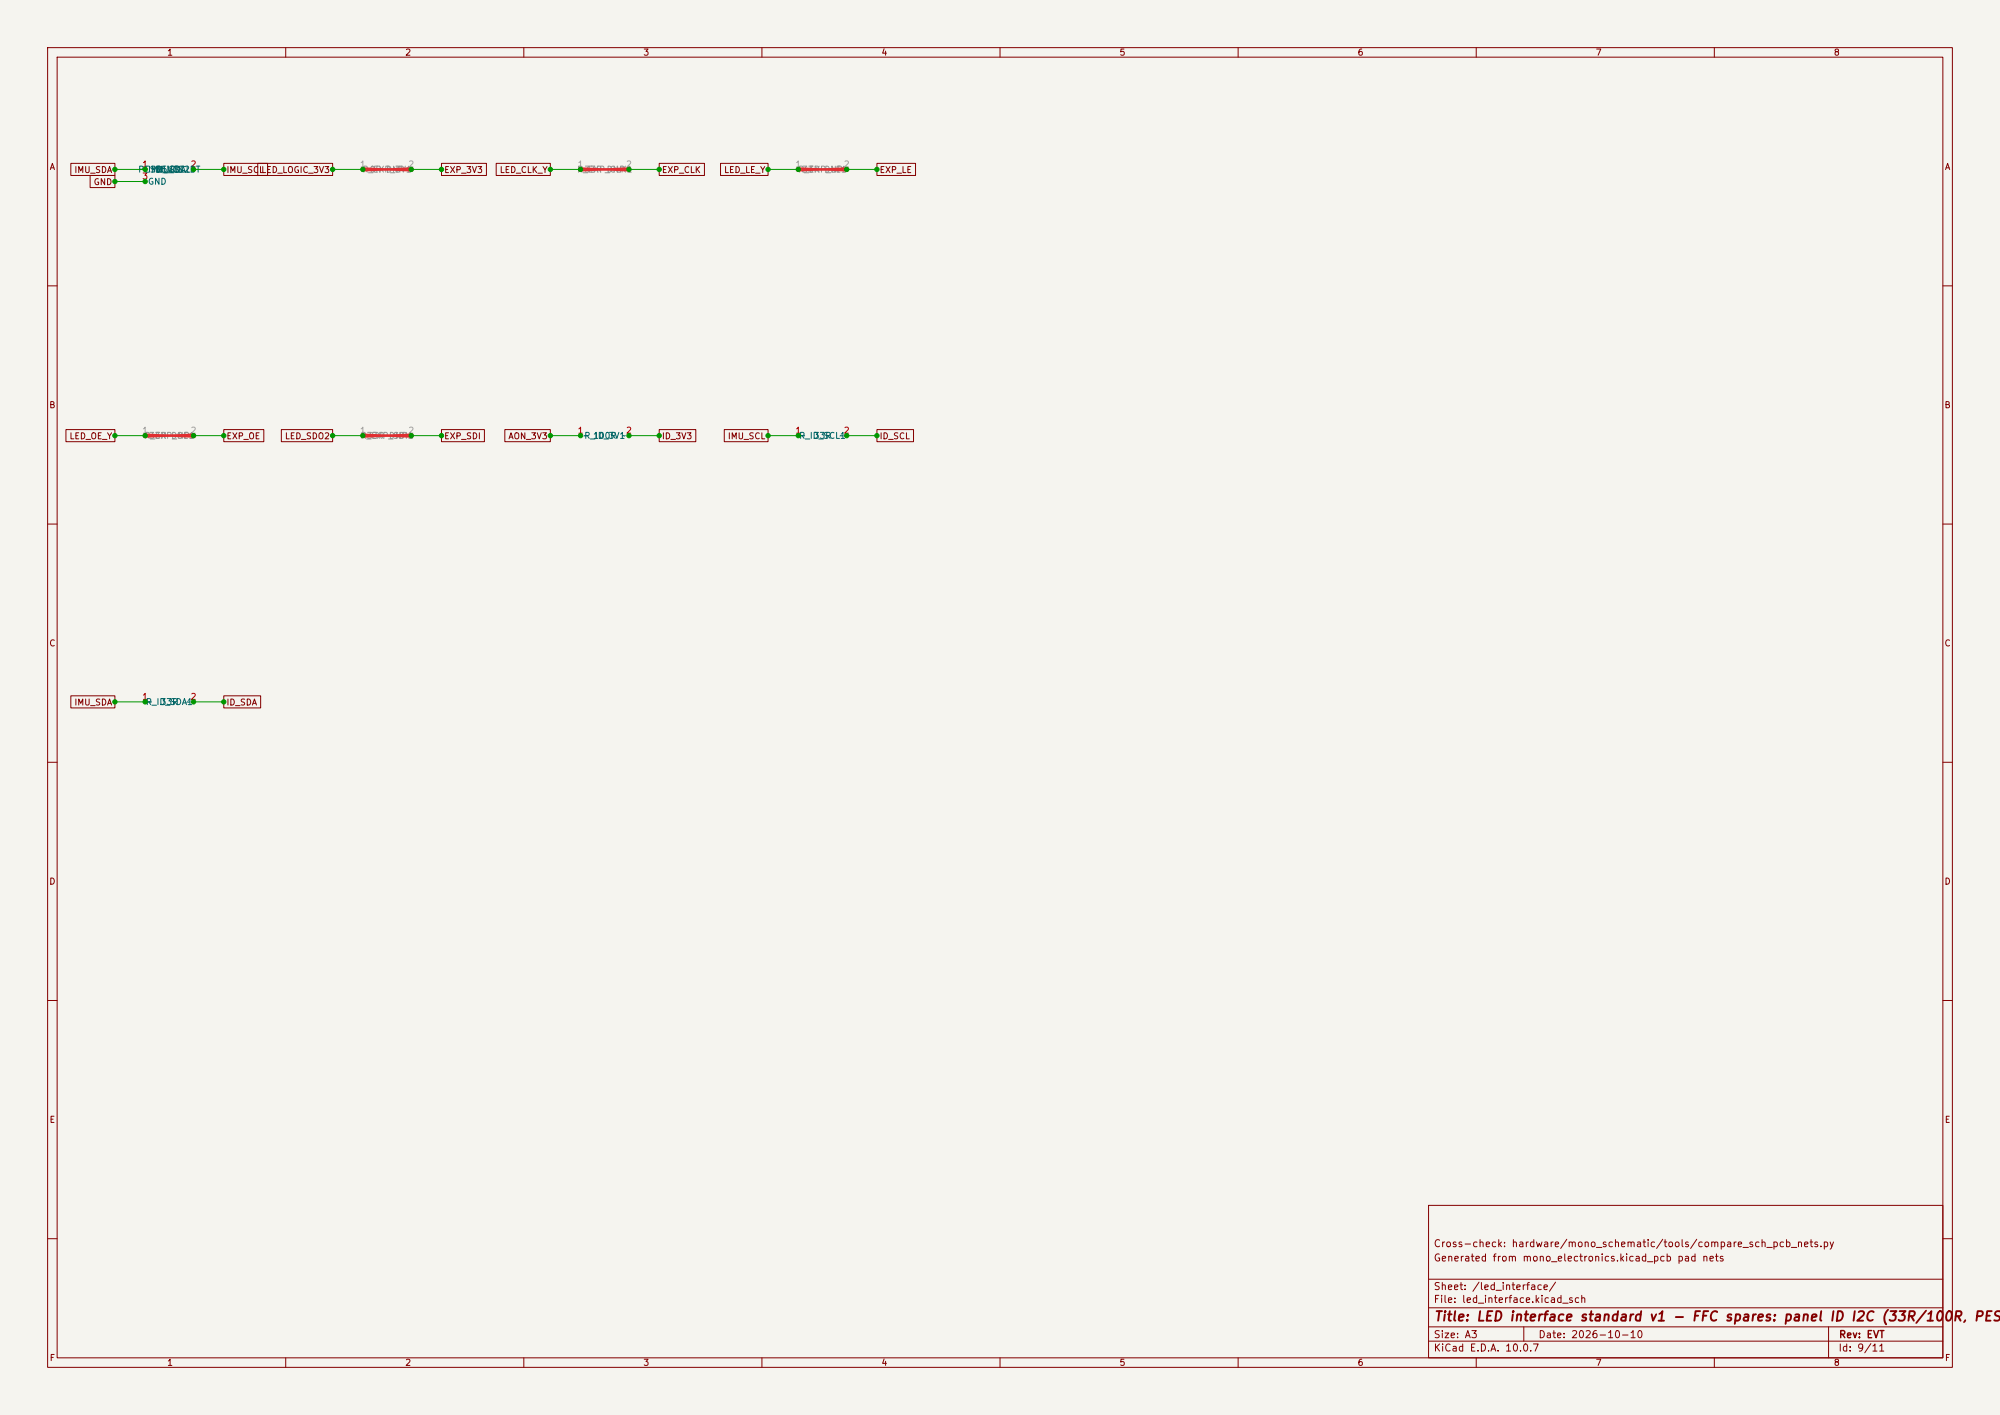
[picture p38: page 9]

Cross-check: hardware/mono_schematic/tools/compare_sch_pcb_nets.py
Generated from mono_electronics.kicad_pcb pad nets

Sheet: /led_interface/
File: led_interface.kicad_sch
Title: LED interface standard v1 - FFC spares: panel ID I2C (33R/100R, PESD3V3S2UT), column-expansion taps (DNP)

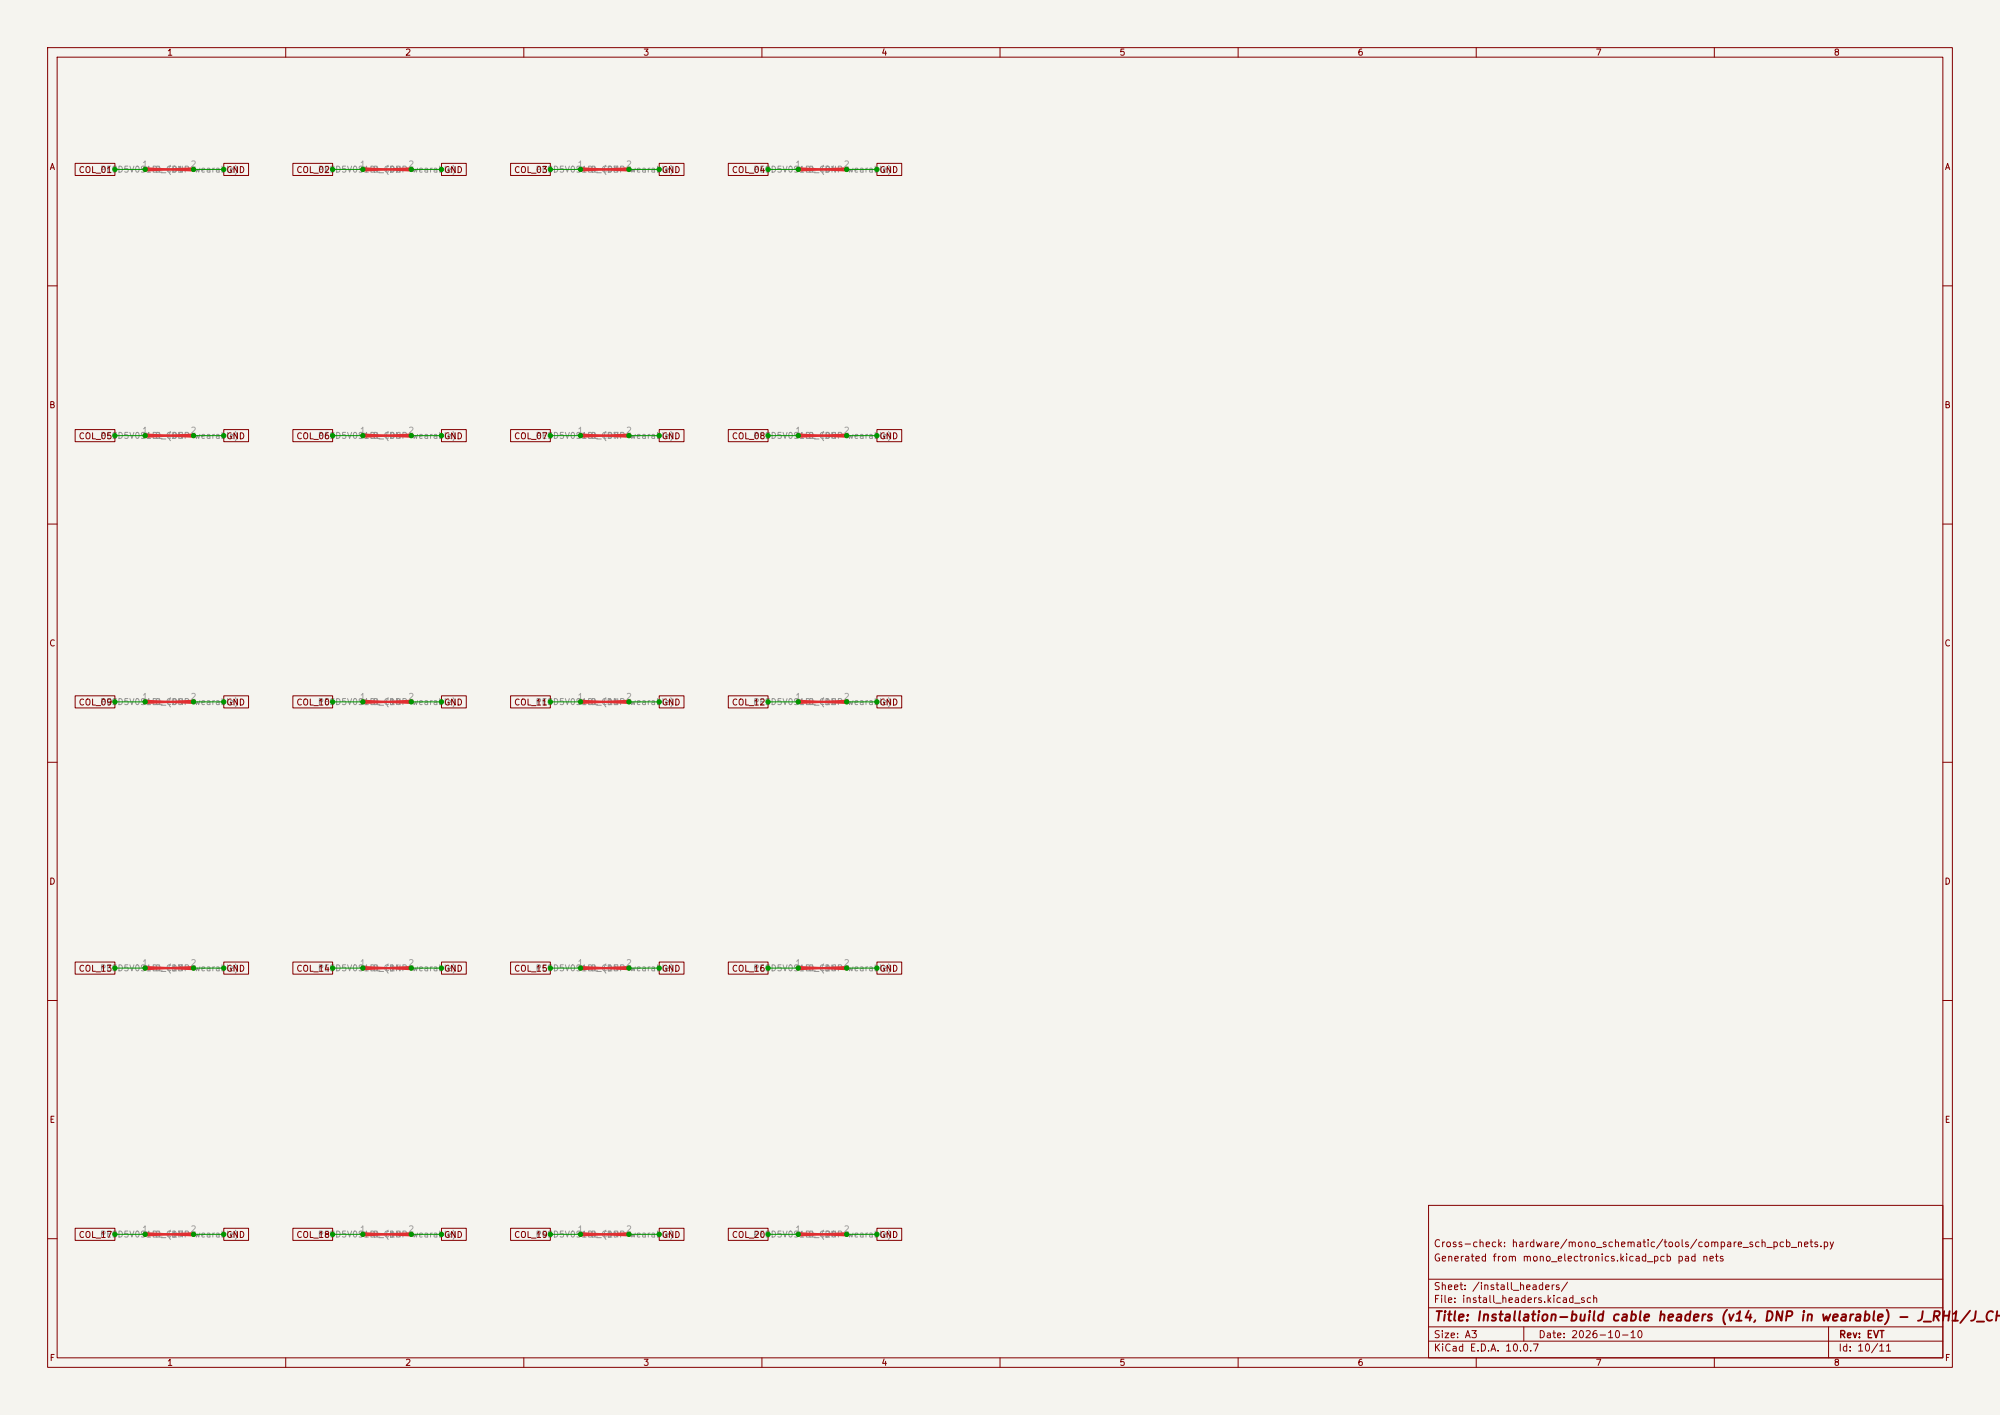
[picture p39: page 10]

Cross-check: hardware/mono_schematic/tools/compare_sch_pcb_nets.py
Generated from mono_electronics.kicad_pcb pad nets

Sheet: /install_headers/
File: install_headers.kicad_sch
Title: Installation-build cable headers (v14, DNP in wearable) - J_RH1/J_CH1 2x20 1.27 mm shrouded keyed box headers (XFCN BH127VS-40P-H49) in parallel with J_ROW1/J_COL1 pin-for-pin, PESD5V0S1BL per LED line

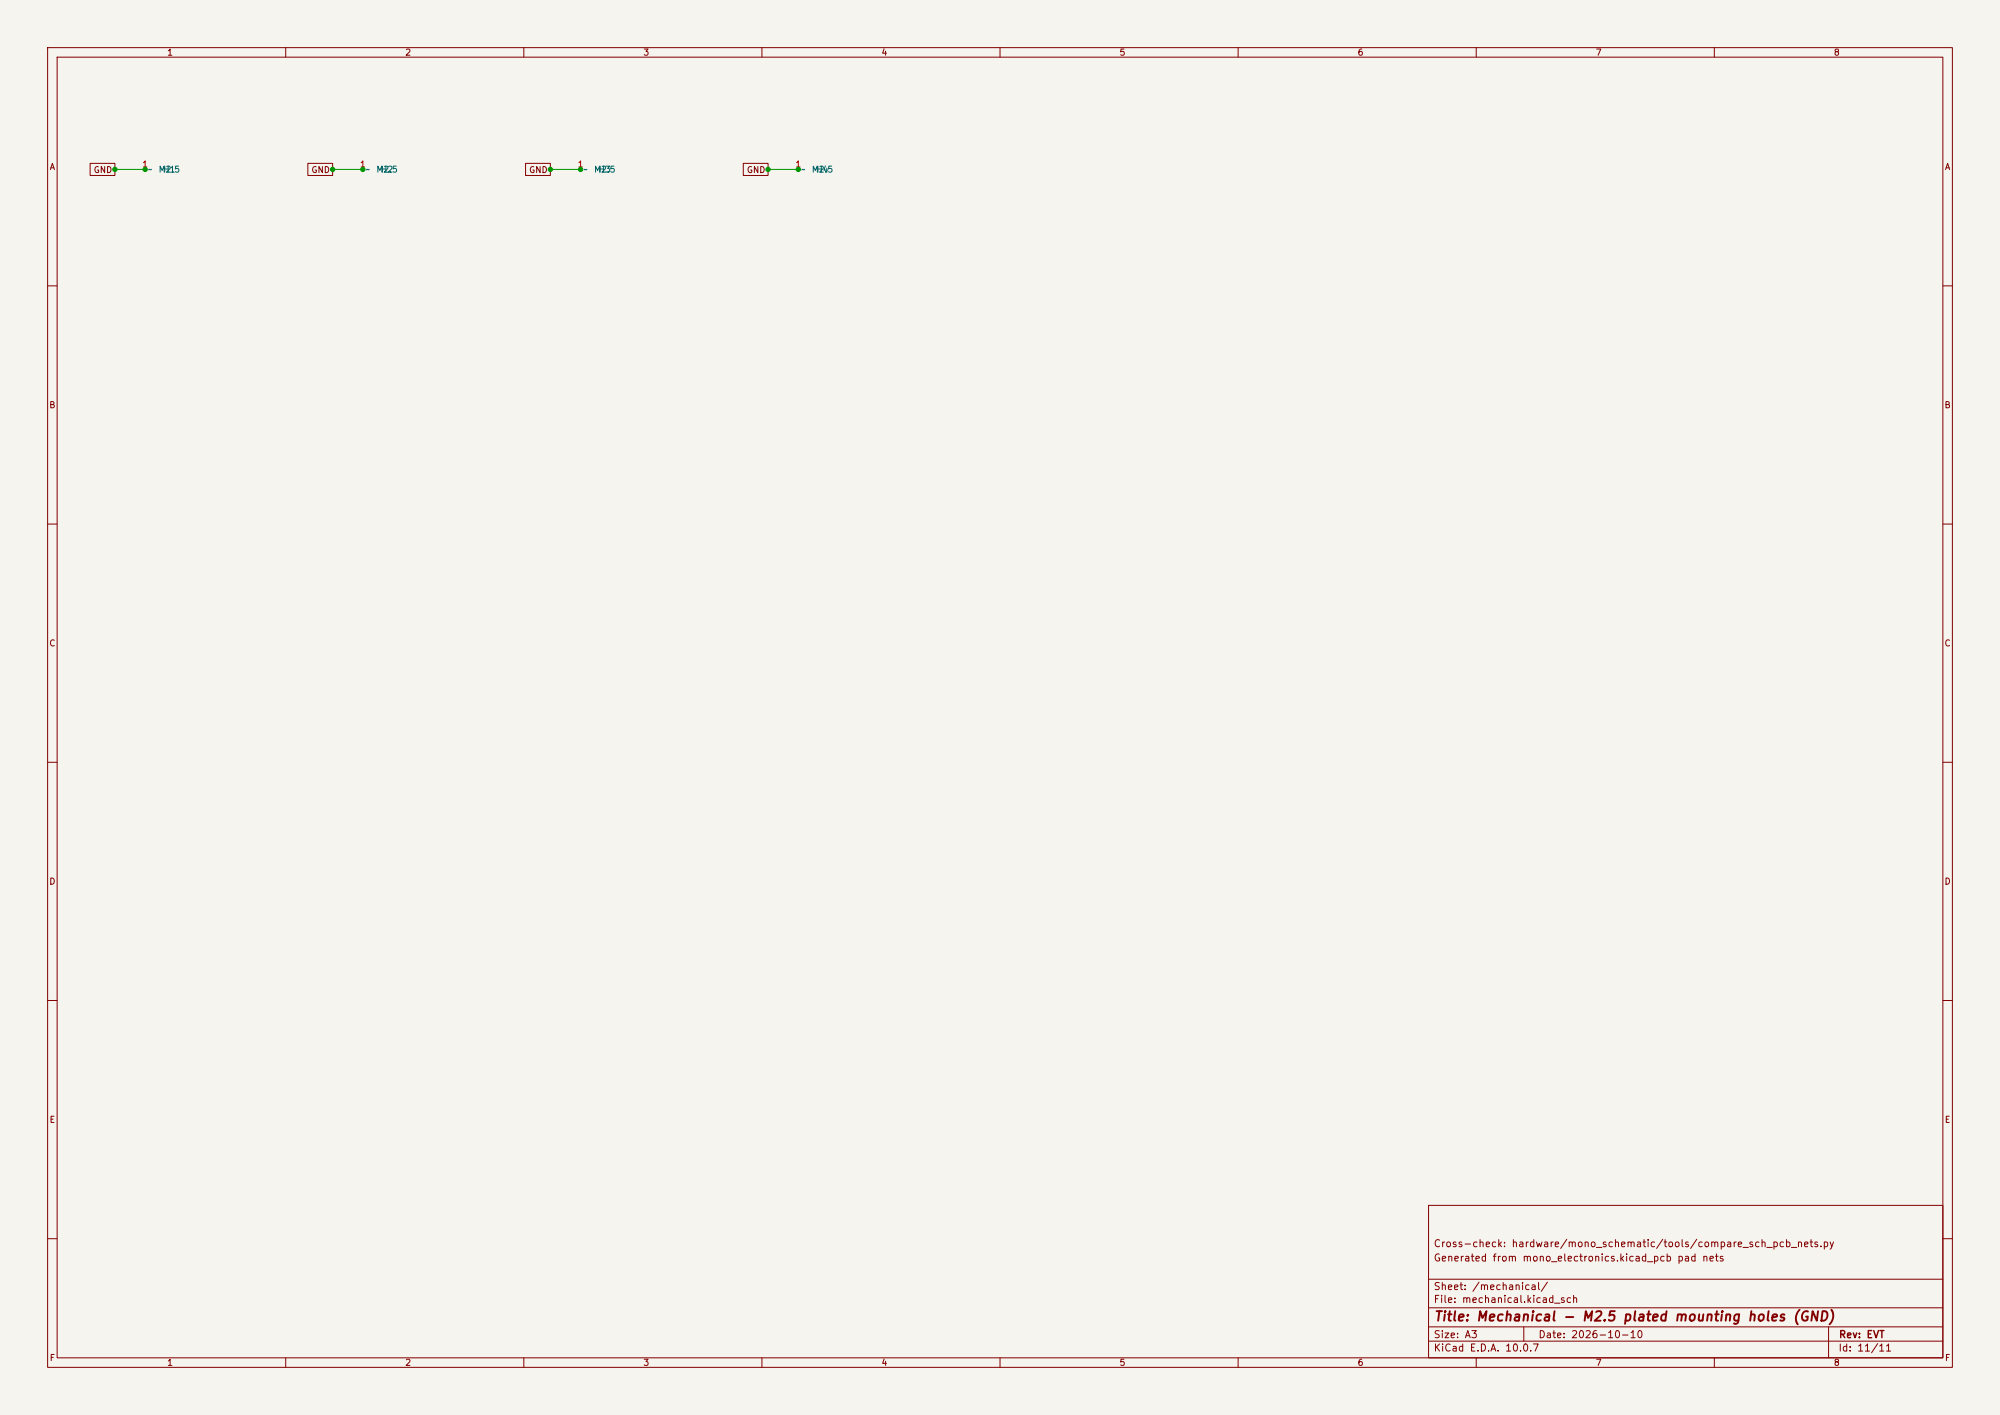
[picture p40: page 11]

Cross-check: hardware/mono_schematic/tools/compare_sch_pcb_nets.py
Generated from mono_electronics.kicad_pcb pad nets

Sheet: /mechanical/
File: mechanical.kicad_sch
Title: Mechanical - M2.5 plated mounting holes (GND)
