illiapliukhin/led-cube-32-controller/hardware/branch_v1/branch_v1.kicad_pcb

## KiCad design hardware/branch_v1/branch_v1.kicad_pcb (2026-10-12)

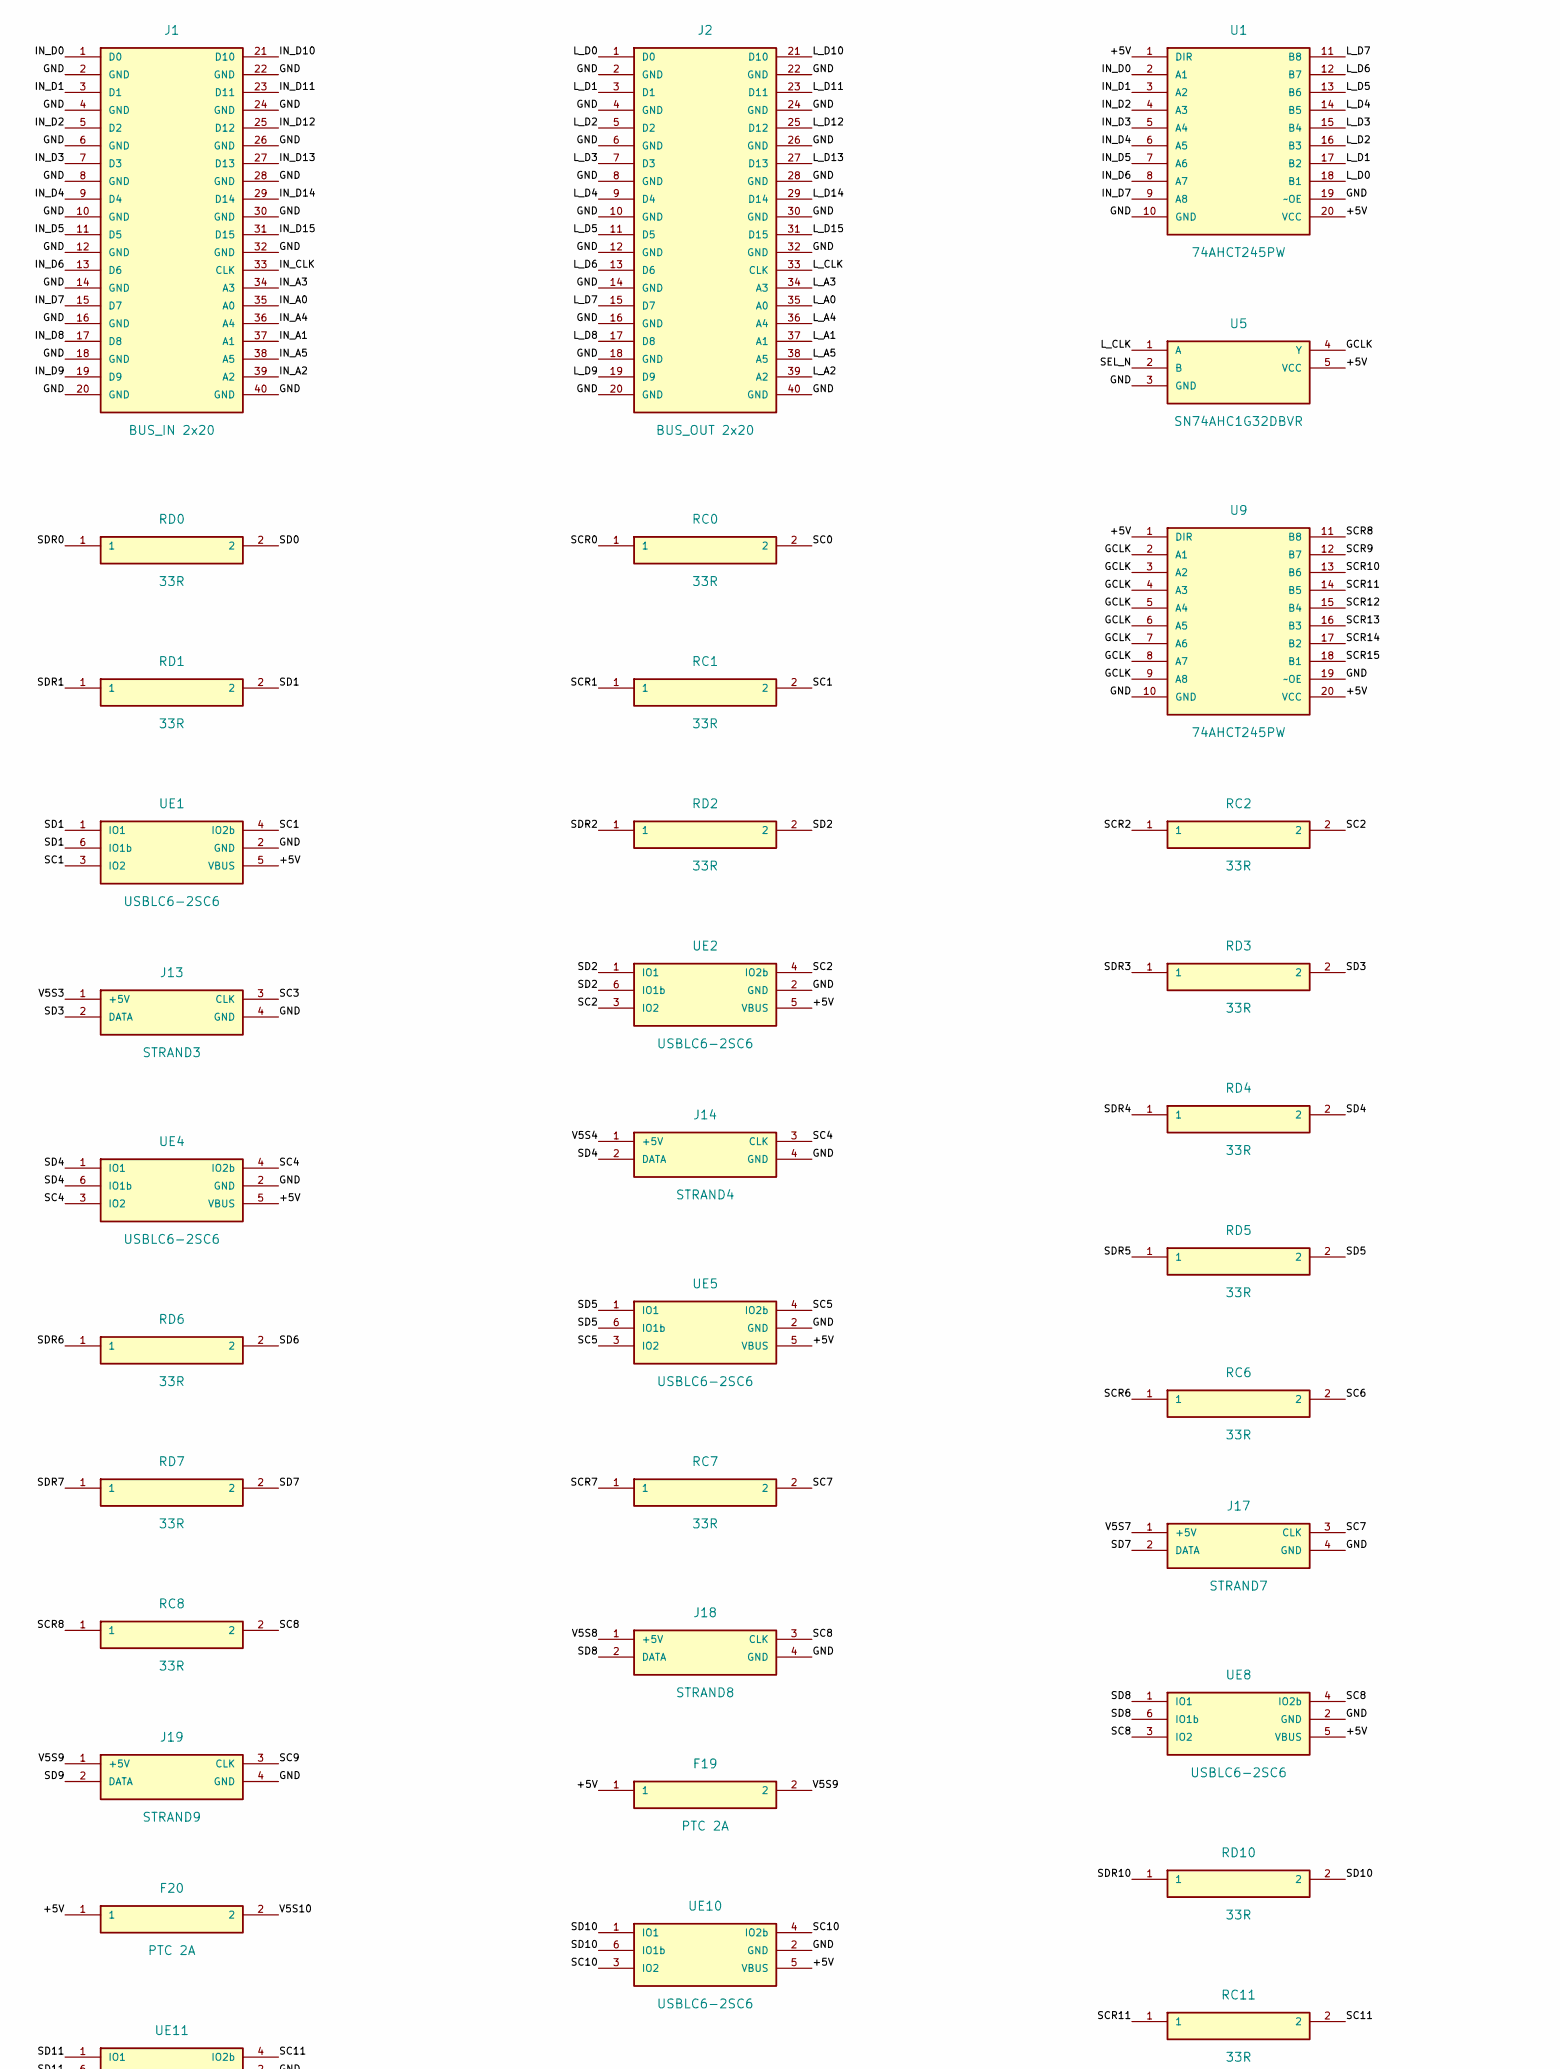
[picture p49: schematic branch_v1.kicad_sch, Branch board v1 - 16 clocked RGB strands, part in row 1, column 1]

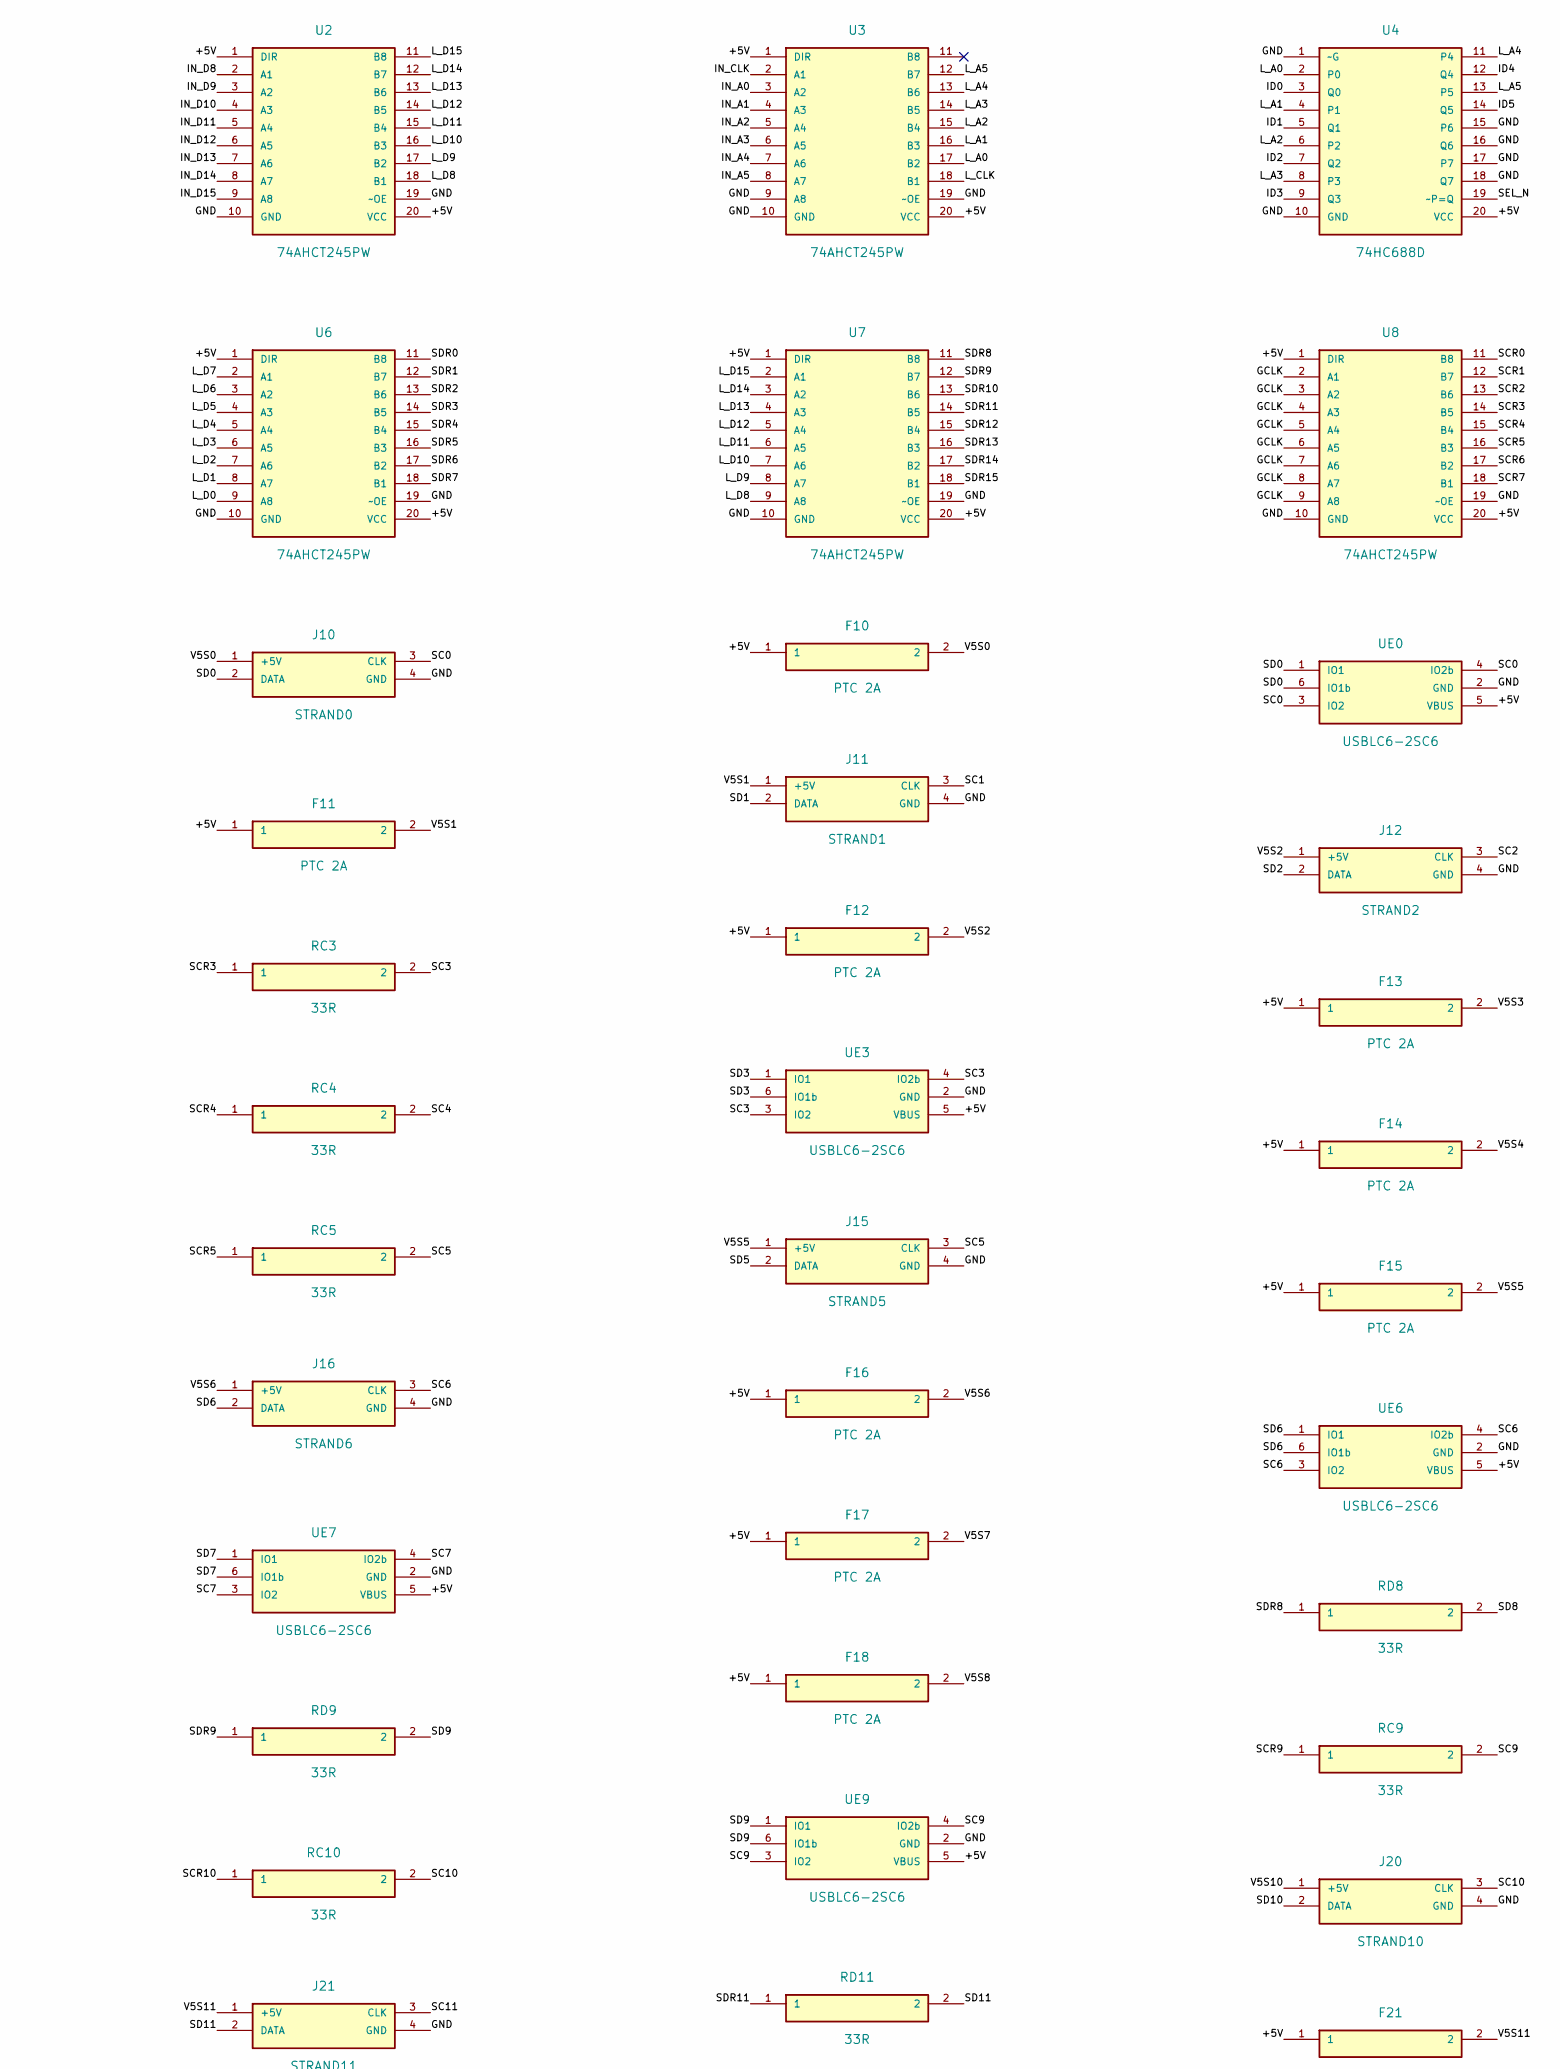
[picture p50: schematic branch_v1.kicad_sch, Branch board v1 - 16 clocked RGB strands, part in row 1, column 2]

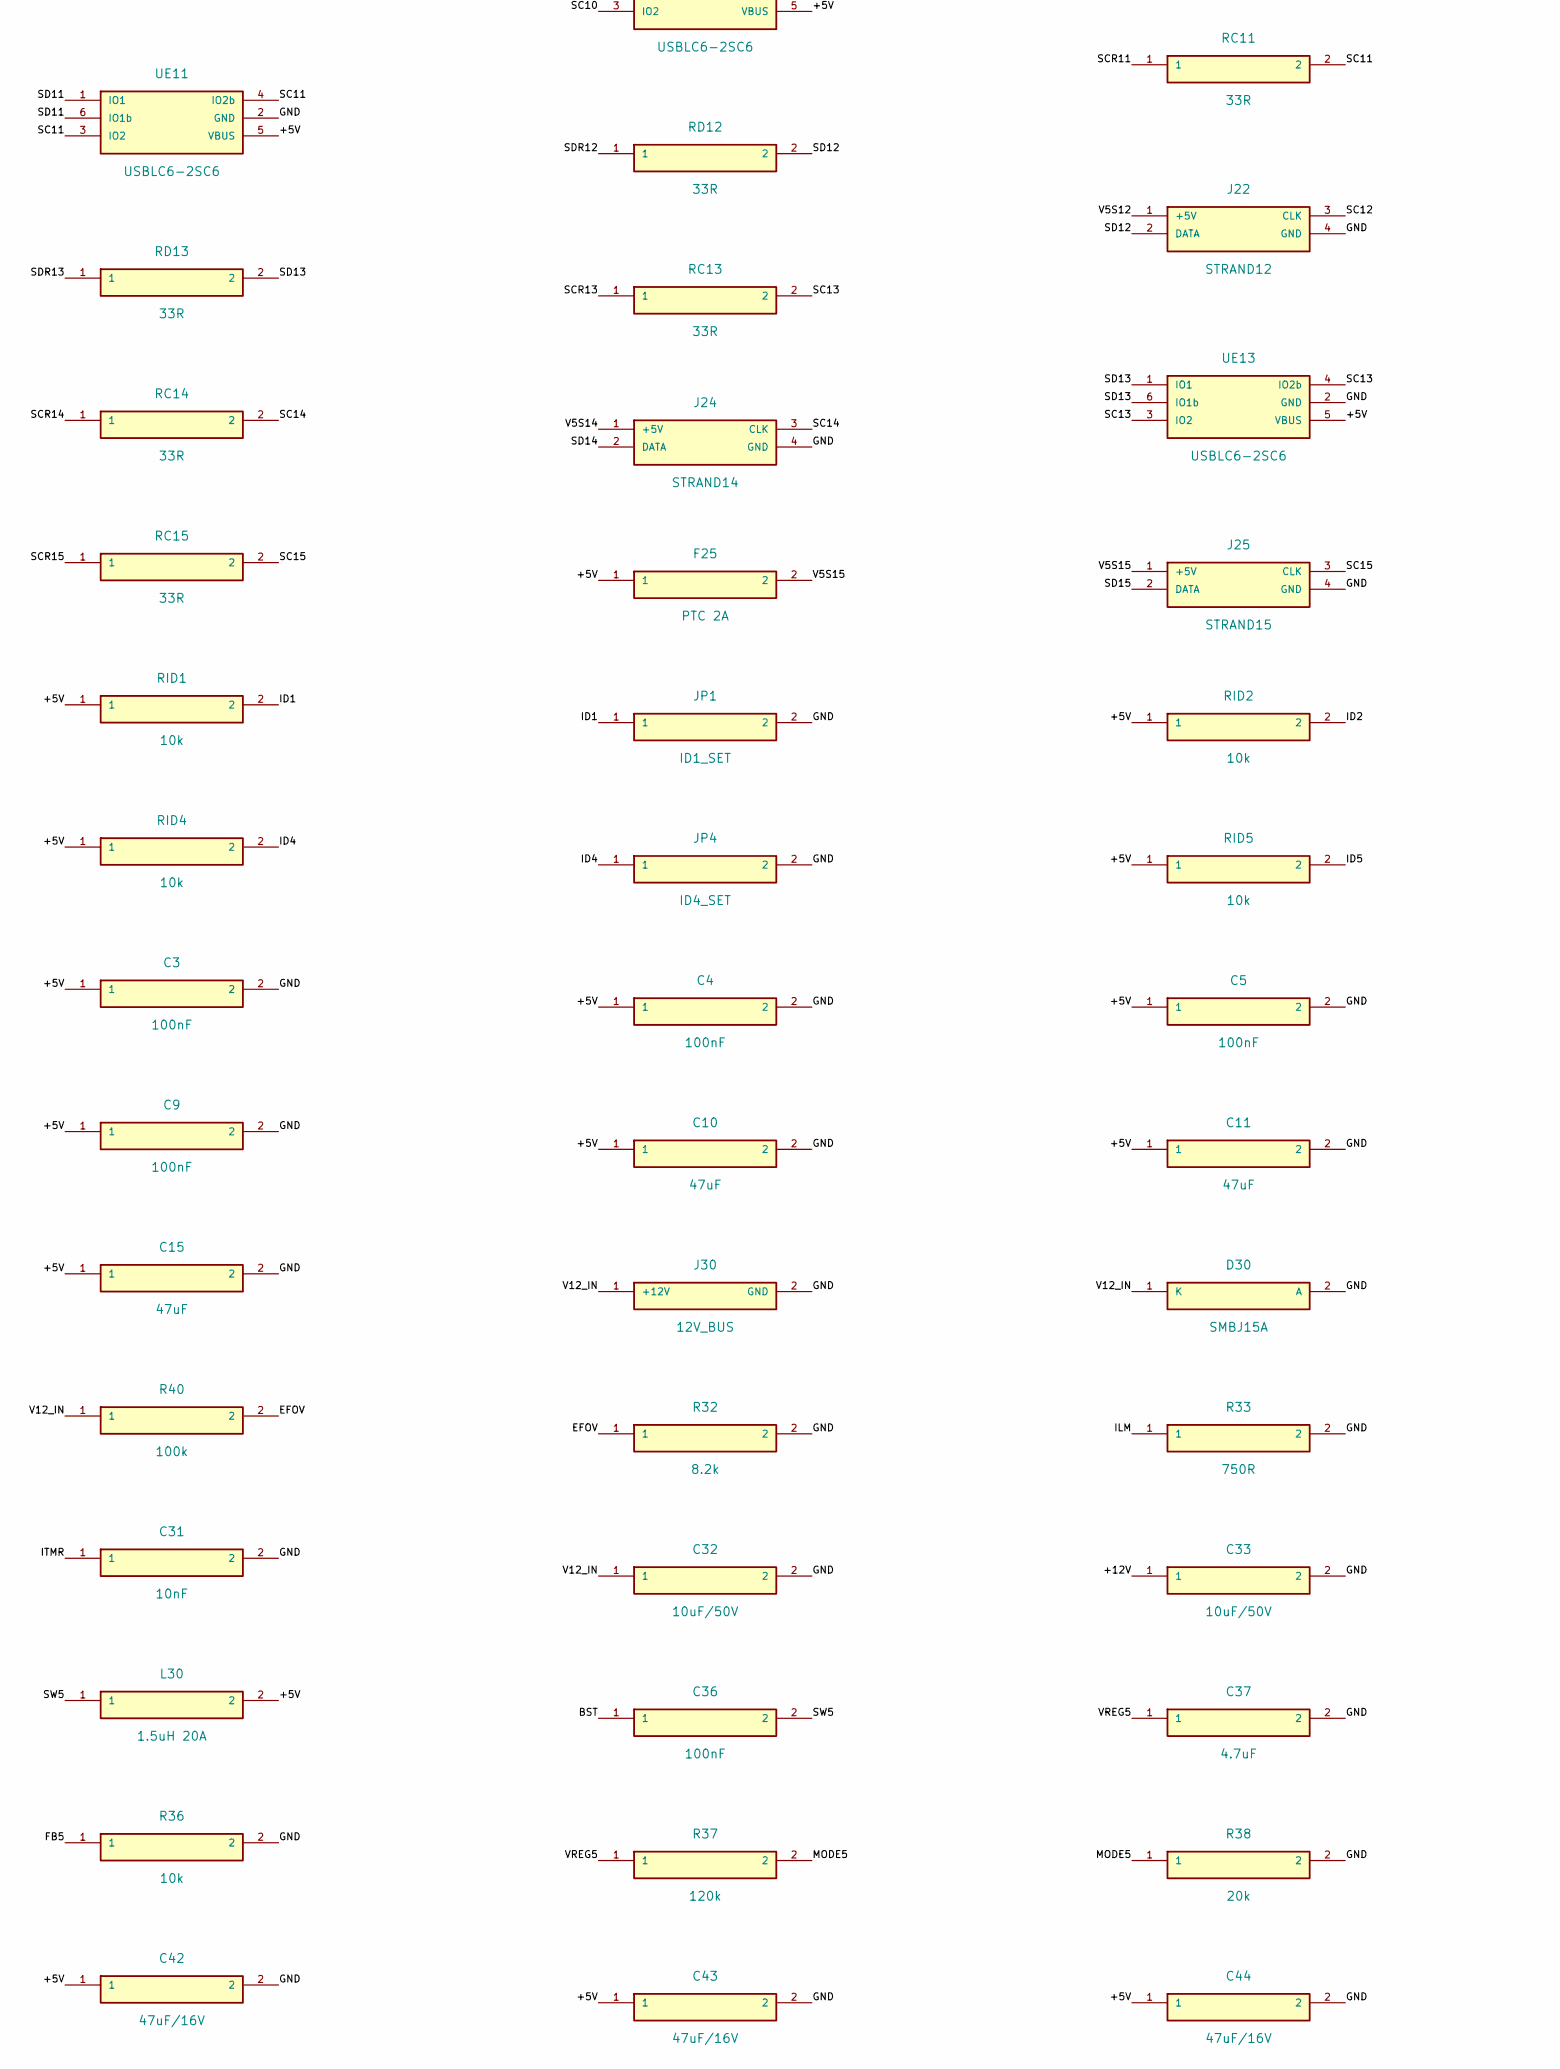
[picture p51: schematic branch_v1.kicad_sch, Branch board v1 - 16 clocked RGB strands, part in row 2, column 1]

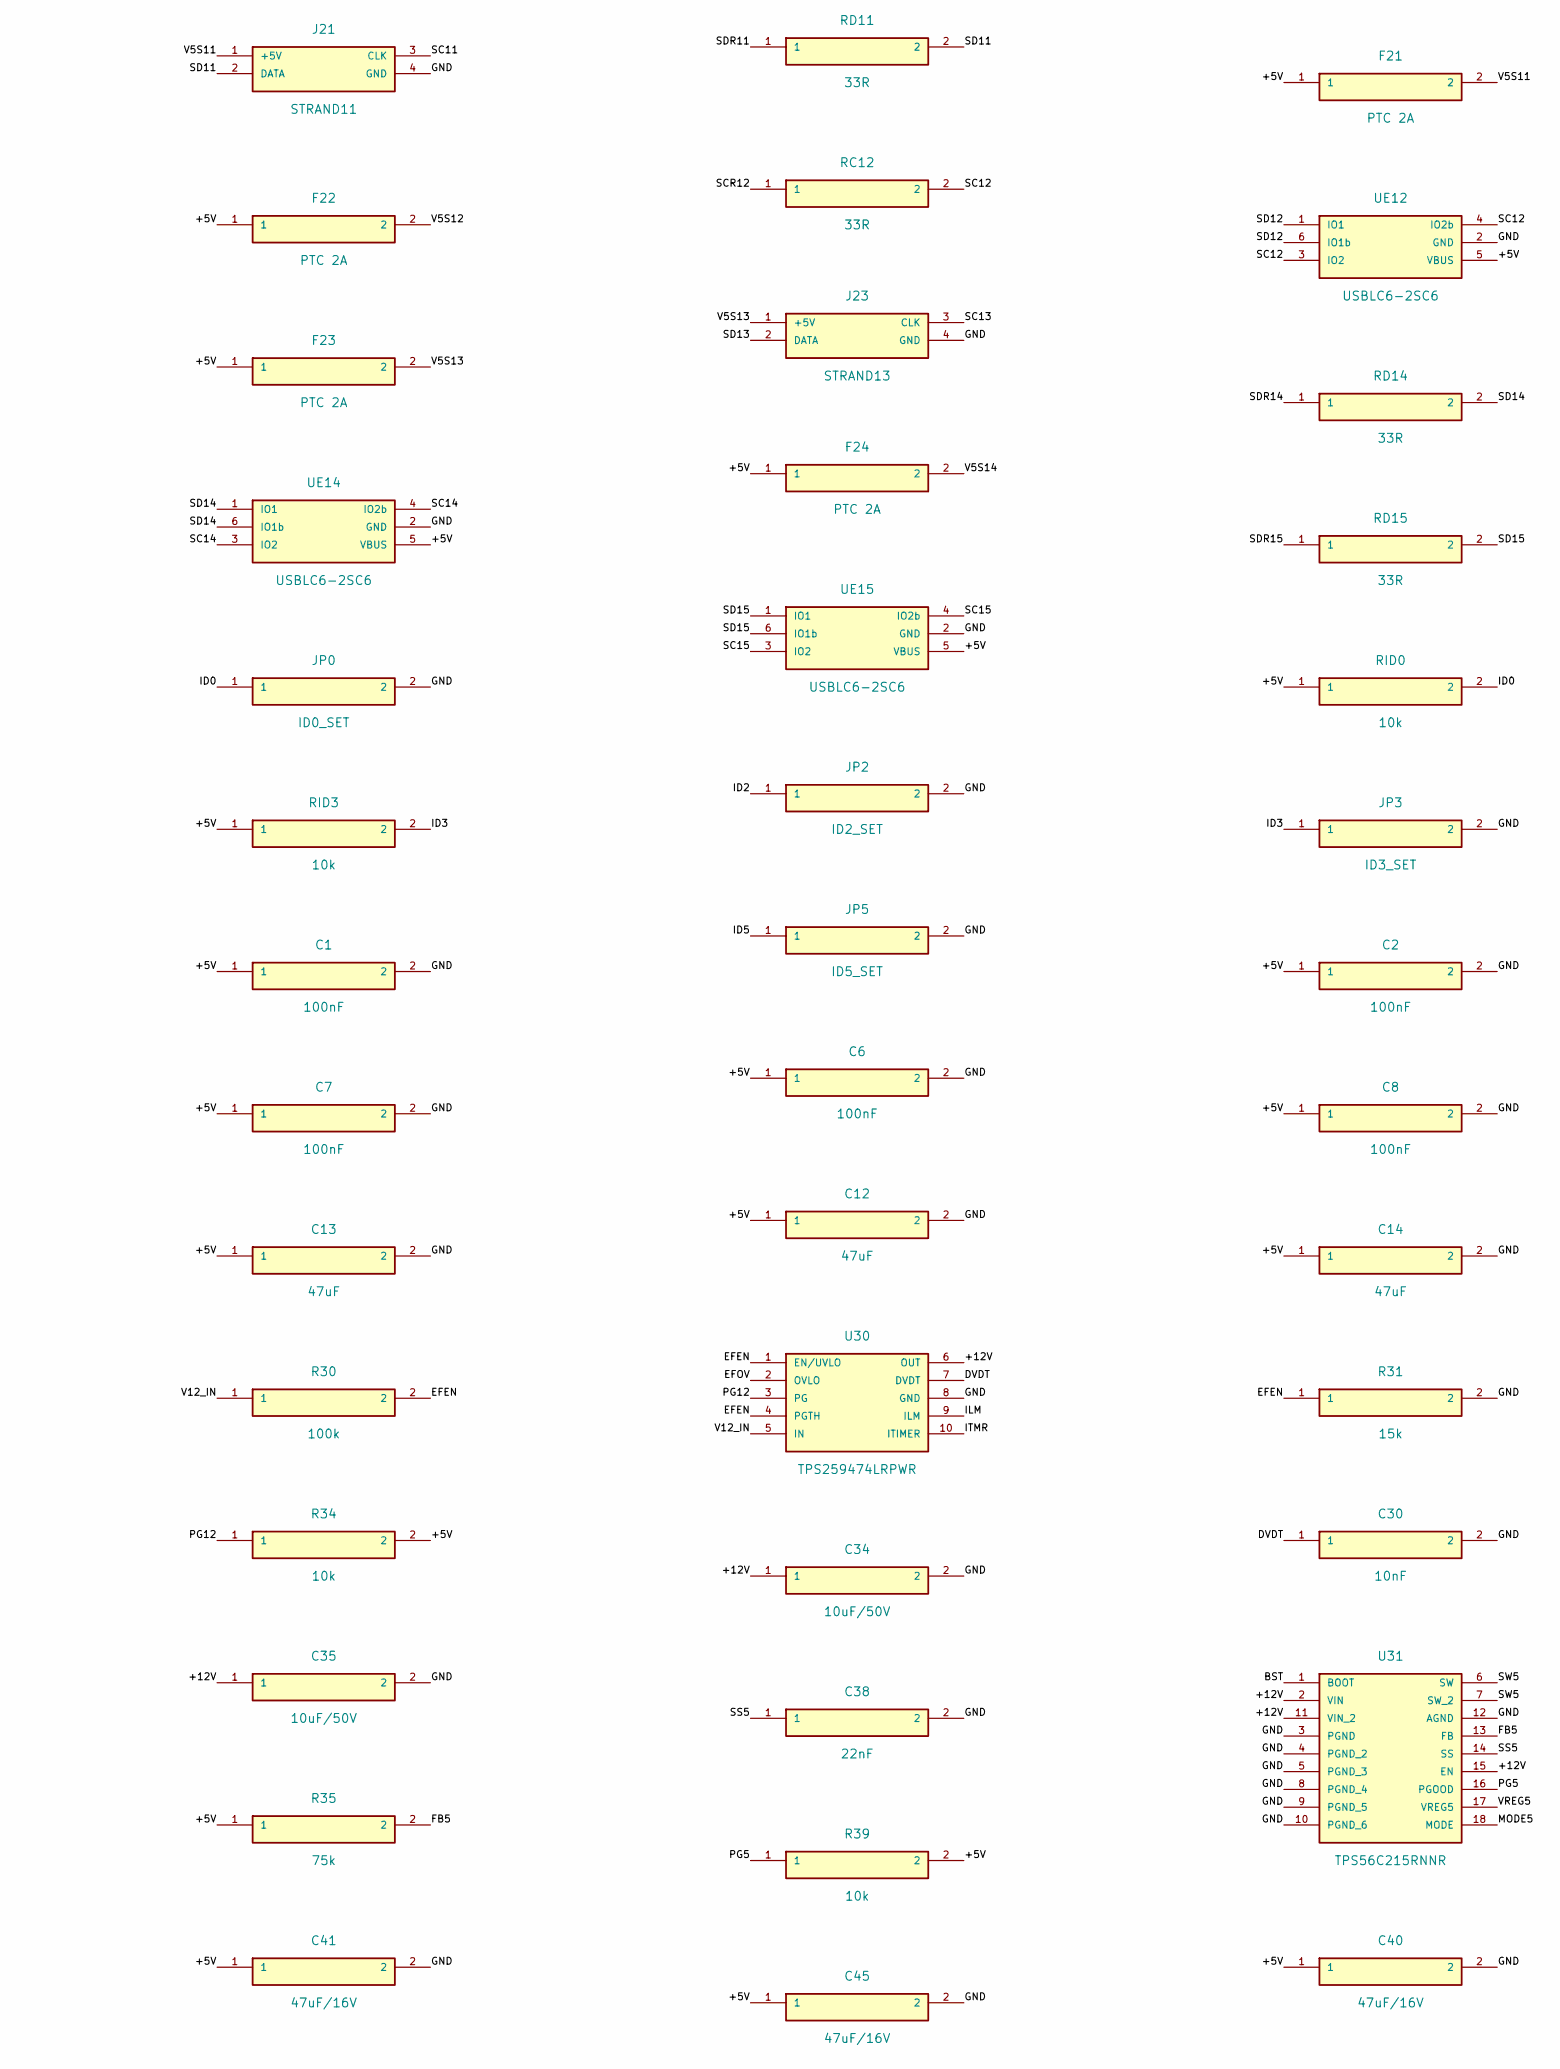
[picture p52: schematic branch_v1.kicad_sch, Branch board v1 - 16 clocked RGB strands, part in row 2, column 2]

Parts:
C1, C2, C3, C4, C5, C6, C7, C8, C9, C36: 100nF; C_0603_1608Metric; MPN CL10B104KO8NNNC; LCSC C66501
C10, C11, C12, C13, C14, C15: 47uF; C_0805_2012Metric; MPN CL21A476MQYNNNE; LCSC C16780
C30, C31: 10nF; C_0603_1608Metric; MPN 0603B103K500NT; LCSC C57112
C32, C33, C34, C35: 10uF/50V; C_1206_3216Metric; MPN CL31A106KBHNNNE; LCSC C13585
C37: 4.7uF; C_0603_1608Metric; MPN CL10A475KO8NNNC; LCSC C19666
C38: 22nF; C_0603_1608Metric; MPN CL10B223KB8NNNC; LCSC C21122
C40, C41, C42, C43, C44, C45: 47uF/16V; C_1210_3225Metric; MPN GRM32ER61C476KE15L; LCSC C77101
D30: SMBJ15A; D_SMB; MPN SMBJ15A; LCSC C83846
F10, F11, F12, F13, F14, F15, F16, F17, F18, F19, F20, F21, F22, F23, F24, F25: PTC 2A; Fuse_1812_4532Metric; MPN SMD1812P200TF16; LCSC C20812
J1: BUS_IN 2x20; IDC-Header_2x20_P2.54mm_Vertical; MPN 2.54-2*20P; LCSC C9138
J2: BUS_OUT 2x20; IDC-Header_2x20_P2.54mm_Vertical; MPN 2.54-2*20P; LCSC C9138
J10: STRAND0; JST_XH_B4B-XH-A_1x04_P2.50mm_Vertical; MPN B4B-XH-A(LF)(SN); LCSC C144395
J11: STRAND1; JST_XH_B4B-XH-A_1x04_P2.50mm_Vertical; MPN B4B-XH-A(LF)(SN); LCSC C144395
J12: STRAND2; JST_XH_B4B-XH-A_1x04_P2.50mm_Vertical; MPN B4B-XH-A(LF)(SN); LCSC C144395
J13: STRAND3; JST_XH_B4B-XH-A_1x04_P2.50mm_Vertical; MPN B4B-XH-A(LF)(SN); LCSC C144395
J14: STRAND4; JST_XH_B4B-XH-A_1x04_P2.50mm_Vertical; MPN B4B-XH-A(LF)(SN); LCSC C144395
J15: STRAND5; JST_XH_B4B-XH-A_1x04_P2.50mm_Vertical; MPN B4B-XH-A(LF)(SN); LCSC C144395
J16: STRAND6; JST_XH_B4B-XH-A_1x04_P2.50mm_Vertical; MPN B4B-XH-A(LF)(SN); LCSC C144395
J17: STRAND7; JST_XH_B4B-XH-A_1x04_P2.50mm_Vertical; MPN B4B-XH-A(LF)(SN); LCSC C144395
J18: STRAND8; JST_XH_B4B-XH-A_1x04_P2.50mm_Vertical; MPN B4B-XH-A(LF)(SN); LCSC C144395
J19: STRAND9; JST_XH_B4B-XH-A_1x04_P2.50mm_Vertical; MPN B4B-XH-A(LF)(SN); LCSC C144395
J20: STRAND10; JST_XH_B4B-XH-A_1x04_P2.50mm_Vertical; MPN B4B-XH-A(LF)(SN); LCSC C144395
J21: STRAND11; JST_XH_B4B-XH-A_1x04_P2.50mm_Vertical; MPN B4B-XH-A(LF)(SN); LCSC C144395
J22: STRAND12; JST_XH_B4B-XH-A_1x04_P2.50mm_Vertical; MPN B4B-XH-A(LF)(SN); LCSC C144395
J23: STRAND13; JST_XH_B4B-XH-A_1x04_P2.50mm_Vertical; MPN B4B-XH-A(LF)(SN); LCSC C144395
J24: STRAND14; JST_XH_B4B-XH-A_1x04_P2.50mm_Vertical; MPN B4B-XH-A(LF)(SN); LCSC C144395
J25: STRAND15; JST_XH_B4B-XH-A_1x04_P2.50mm_Vertical; MPN B4B-XH-A(LF)(SN); LCSC C144395
J30: 12V_BUS; TerminalBlock_Phoenix_MKDS-1,5-2-5.08_1x02_P5.08mm_Horizont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; MPN WJ500V-5.08-2P; LCSC C8465
JP0: ID0_SET; SolderJumper-2_P1.3mm_Open_RoundedPad1.0x1.5mm
JP1: ID1_SET; SolderJumper-2_P1.3mm_Open_RoundedPad1.0x1.5mm
JP2: ID2_SET; SolderJumper-2_P1.3mm_Open_RoundedPad1.0x1.5mm
JP3: ID3_SET; SolderJumper-2_P1.3mm_Open_RoundedPad1.0x1.5mm
JP4: ID4_SET; SolderJumper-2_P1.3mm_Open_RoundedPad1.0x1.5mm
JP5: ID5_SET; SolderJumper-2_P1.3mm_Open_RoundedPad1.0x1.5mm
L30: 1.5uH 20A; L_YJYCOIN_YSPI1365; MPN YSPI1365-1R5M; LCSC C5158939
R30, R40: 100k; R_0603_1608Metric; MPN 0603WAF1003T5E; LCSC C25803
R31: 15k; R_0603_1608Metric; MPN 0603WAF1502T5E; LCSC C22809
R32: 8.2k; R_0603_1608Metric; MPN 0603WAF8201T5E; LCSC C25981
R33: 750R; R_0603_1608Metric; MPN 0603WAF7500T5E; LCSC C23241
R34, R36, R39: 10k; R_0603_1608Metric; MPN RC0603FR-0710KL; LCSC C98220
R35: 75k; R_0603_1608Metric; MPN 0603WAF7502T5E; LCSC C23242
R37: 120k; R_0603_1608Metric; MPN 0603WAF1203T5E; LCSC C25808
R38: 20k; R_0603_1608Metric; MPN 0603WAF2002T5E; LCSC C4184
RC0, RC1, RC2, RC3, RC4, RC5, RC6, RC7, RC8, RC9, RC10, RC11, RC12, RC13, RC14, RC15: 33R; R_0603_1608Metric; MPN 0603WAF330JT5E; LCSC C23140
RD0, RD1, RD2, RD3, RD4, RD5, RD6, RD7, RD8, RD9, RD10, RD11, RD12, RD13, RD14, RD15: 33R; R_0603_1608Metric; MPN 0603WAF330JT5E; LCSC C23140
RID0, RID1, RID2, RID3, RID4, RID5: 10k; R_0603_1608Metric; MPN RC0603FR-0710KL; LCSC C98220
U1, U2, U3, U6, U7, U8, U9: 74AHCT245PW; TSSOP-20_4.4x6.5mm_P0.65mm; MPN 74AHCT245PW,118; LCSC C173388
U4: 74HC688D; SOIC-20W_7.5x12.8mm_P1.27mm; MPN 74HC688D,653; LCSC C88042
U5: SN74AHC1G32DBVR; SOT-23-5; MPN SN74AHC1G32DBVR; LCSC C7470
U30: TPS259474LRPWR; TI_RPW0010A_VQFN-HR-10_2x2mm_P0.45mm; MPN TPS259474LRPWR; LCSC C2864845
U31: TPS56C215RNNR; Texas_RNN0018A; MPN TPS56C215RNNR; LCSC C473372
UE0, UE1, UE2, UE3, UE4, UE5, UE6, UE7, UE8, UE9, UE10, UE11, UE12, UE13, UE14, UE15: USBLC6-2SC6; SOT-23-6; MPN USBLC6-2SC6; LCSC C2827654

Connections:
/+5V: C1.1, C2.1, C3.1, C4.1, C5.1, C6.1, C7.1, C8.1, C9.1, C10.1, C11.1, C12.1, C13.1, C14.1, C15.1, C40.1, C41.1, C42.1, C43.1, C44.1, C45.1, F10.1, F11.1, F12.1, F13.1, F14.1, F15.1, F16.1, F17.1, F18.1, F19.1, F20.1, F21.1, F22.1, F23.1, F24.1, F25.1, L30.2, R34.2, R35.1, R39.2, RID0.1, RID1.1, RID2.1, RID3.1, RID4.1, RID5.1, U1.1 (DIR), U1.20 (VCC), U2.1 (DIR), U2.20 (VCC), U3.1 (DIR), U3.20 (VCC), U4.20 (VCC), U5.5 (VCC), U6.1 (DIR), U6.20 (VCC), U7.1 (DIR), U7.20 (VCC), U8.1 (DIR), U8.20 (VCC), U9.1 (DIR), U9.20 (VCC), UE0.5 (VBUS), UE1.5 (VBUS), UE2.5 (VBUS), UE3.5 (VBUS), UE4.5 (VBUS), UE5.5 (VBUS), UE6.5 (VBUS), UE7.5 (VBUS), UE8.5 (VBUS), UE9.5 (VBUS), UE10.5 (VBUS), UE11.5 (VBUS), UE12.5 (VBUS), UE13.5 (VBUS), UE14.5 (VBUS), UE15.5 (VBUS)
/+12V: C33.1, C34.1, C35.1, U30.6 (OUT), U31.2 (VIN), U31.11 (VIN_2), U31.15 (EN)
/BST: C36.1, U31.1 (BOOT)
/DVDT: C30.1, U30.7 (DVDT)
/EFEN: R30.2, R31.1, U30.1 (EN/UVLO), U30.4 (PGTH)
/EFOV: R32.1, R40.2, U30.2 (OVLO)
/FB5: R35.2, R36.1, U31.13 (FB)
/GCLK: U5.4 (Y), U8.2 (A1), U8.3 (A2), U8.4 (A3), U8.5 (A4), U8.6 (A5), U8.7 (A6), U8.8 (A7), U8.9 (A8), U9.2 (A1), U9.3 (A2), U9.4 (A3), U9.5 (A4), U9.6 (A5), U9.7 (A6), U9.8 (A7), U9.9 (A8)
/GND: C1.2, C2.2, C3.2, C4.2, C5.2, C6.2, C7.2, C8.2, C9.2, C10.2, C11.2, C12.2, C13.2, C14.2, C15.2, C30.2, C31.2, C32.2, C33.2, C34.2, C35.2, C37.2, C38.2, C40.2, C41.2, C42.2, C43.2, C44.2, C45.2, D30.2 (A), J1.2 (GND), J1.4 (GND), J1.6 (GND), J1.8 (GND), J1.10 (GND), J1.12 (GND), J1.14 (GND), J1.16 (GND), J1.18 (GND), J1.20 (GND), J1.22 (GND), J1.24 (GND), J1.26 (GND), J1.28 (GND), J1.30 (GND), J1.32 (GND), J1.40 (GND), J2.2 (GND), J2.4 (GND), J2.6 (GND), J2.8 (GND), J2.10 (GND), J2.12 (GND), J2.14 (GND), J2.16 (GND), J2.18 (GND), J2.20 (GND), J2.22 (GND), J2.24 (GND), J2.26 (GND), J2.28 (GND), J2.30 (GND), J2.32 (GND), J2.40 (GND), J10.4 (GND), J11.4 (GND), J12.4 (GND), J13.4 (GND), J14.4 (GND), J15.4 (GND), J16.4 (GND), J17.4 (GND), J18.4 (GND), J19.4 (GND), J20.4 (GND), J21.4 (GND), J22.4 (GND), J23.4 (GND), J24.4 (GND), J25.4 (GND), J30.2 (GND), JP0.2, JP1.2, JP2.2, JP3.2, JP4.2, JP5.2, R31.2, R32.2, R33.2, R36.2, R38.2, U1.10 (GND), U1.19 (~OE), U2.10 (GND), U2.19 (~OE), U3.9 (A8), U3.10 (GND), U3.19 (~OE), U4.1 (~G), U4.10 (GND), U4.15 (P6), U4.16 (Q6), U4.17 (P7), U4.18 (Q7), U5.3 (GND), U6.10 (GND), U6.19 (~OE), U7.10 (GND), U7.19 (~OE), U8.10 (GND), U8.19 (~OE), U9.10 (GND), U9.19 (~OE), U30.8 (GND), U31.3 (PGND), U31.4 (PGND_2), U31.5 (PGND_3), U31.8 (PGND_4), U31.9 (PGND_5), U31.10 (PGND_6), U31.12 (AGND), UE0.2 (GND), UE1.2 (GND), UE2.2 (GND), UE3.2 (GND), UE4.2 (GND), UE5.2 (GND), UE6.2 (GND), UE7.2 (GND), UE8.2 (GND), UE9.2 (GND), UE10.2 (GND), UE11.2 (GND), UE12.2 (GND), UE13.2 (GND), UE14.2 (GND), UE15.2 (GND)
/ID0: JP0.1, RID0.2, U4.3 (Q0)
/ID1: JP1.1, RID1.2, U4.5 (Q1)
/ID2: JP2.1, RID2.2, U4.7 (Q2)
/ID3: JP3.1, RID3.2, U4.9 (Q3)
/ID4: JP4.1, RID4.2, U4.12 (Q4)
/ID5: JP5.1, RID5.2, U4.14 (Q5)
/ILM: R33.1, U30.9 (ILM)
/IN_A0: J1.35 (A0), U3.3 (A2)
/IN_A1: J1.37 (A1), U3.4 (A3)
/IN_A2: J1.39 (A2), U3.5 (A4)
/IN_A3: J1.34 (A3), U3.6 (A5)
/IN_A4: J1.36 (A4), U3.7 (A6)
/IN_A5: J1.38 (A5), U3.8 (A7)
/IN_CLK: J1.33 (CLK), U3.2 (A1)
/IN_D0: J1.1 (D0), U1.2 (A1)
/IN_D1: J1.3 (D1), U1.3 (A2)
/IN_D2: J1.5 (D2), U1.4 (A3)
/IN_D3: J1.7 (D3), U1.5 (A4)
/IN_D4: J1.9 (D4), U1.6 (A5)
/IN_D5: J1.11 (D5), U1.7 (A6)
/IN_D6: J1.13 (D6), U1.8 (A7)
/IN_D7: J1.15 (D7), U1.9 (A8)
/IN_D8: J1.17 (D8), U2.2 (A1)
/IN_D9: J1.19 (D9), U2.3 (A2)
/IN_D10: J1.21 (D10), U2.4 (A3)
/IN_D11: J1.23 (D11), U2.5 (A4)
/IN_D12: J1.25 (D12), U2.6 (A5)
/IN_D13: J1.27 (D13), U2.7 (A6)
/IN_D14: J1.29 (D14), U2.8 (A7)
/IN_D15: J1.31 (D15), U2.9 (A8)
/ITMR: C31.1, U30.10 (ITIMER)
/L_A0: J2.35 (A0), U3.17 (B2), U4.2 (P0)
/L_A1: J2.37 (A1), U3.16 (B3), U4.4 (P1)
/L_A2: J2.39 (A2), U3.15 (B4), U4.6 (P2)
/L_A3: J2.34 (A3), U3.14 (B5), U4.8 (P3)
/L_A4: J2.36 (A4), U3.13 (B6), U4.11 (P4)
/L_A5: J2.38 (A5), U3.12 (B7), U4.13 (P5)
/L_CLK: J2.33 (CLK), U3.18 (B1), U5.1 (A)
/L_D0: J2.1 (D0), U1.18 (B1), U6.9 (A8)
/L_D1: J2.3 (D1), U1.17 (B2), U6.8 (A7)
/L_D2: J2.5 (D2), U1.16 (B3), U6.7 (A6)
/L_D3: J2.7 (D3), U1.15 (B4), U6.6 (A5)
/L_D4: J2.9 (D4), U1.14 (B5), U6.5 (A4)
/L_D5: J2.11 (D5), U1.13 (B6), U6.4 (A3)
/L_D6: J2.13 (D6), U1.12 (B7), U6.3 (A2)
/L_D7: J2.15 (D7), U1.11 (B8), U6.2 (A1)
/L_D8: J2.17 (D8), U2.18 (B1), U7.9 (A8)
/L_D9: J2.19 (D9), U2.17 (B2), U7.8 (A7)
/L_D10: J2.21 (D10), U2.16 (B3), U7.7 (A6)
/L_D11: J2.23 (D11), U2.15 (B4), U7.6 (A5)
/L_D12: J2.25 (D12), U2.14 (B5), U7.5 (A4)
/L_D13: J2.27 (D13), U2.13 (B6), U7.4 (A3)
/L_D14: J2.29 (D14), U2.12 (B7), U7.3 (A2)
/L_D15: J2.31 (D15), U2.11 (B8), U7.2 (A1)
/MODE5: R37.2, R38.1, U31.18 (MODE)
/PG5: R39.1, U31.16 (PGOOD)
/PG12: R34.1, U30.3 (PG)
/SC0: J10.3 (CLK), RC0.2, UE0.3 (IO2), UE0.4 (IO2b)
/SC1: J11.3 (CLK), RC1.2, UE1.3 (IO2), UE1.4 (IO2b)
/SC2: J12.3 (CLK), RC2.2, UE2.3 (IO2), UE2.4 (IO2b)
/SC3: J13.3 (CLK), RC3.2, UE3.3 (IO2), UE3.4 (IO2b)
/SC4: J14.3 (CLK), RC4.2, UE4.3 (IO2), UE4.4 (IO2b)
/SC5: J15.3 (CLK), RC5.2, UE5.3 (IO2), UE5.4 (IO2b)
/SC6: J16.3 (CLK), RC6.2, UE6.3 (IO2), UE6.4 (IO2b)
/SC7: J17.3 (CLK), RC7.2, UE7.3 (IO2), UE7.4 (IO2b)
/SC8: J18.3 (CLK), RC8.2, UE8.3 (IO2), UE8.4 (IO2b)
/SC9: J19.3 (CLK), RC9.2, UE9.3 (IO2), UE9.4 (IO2b)
/SC10: J20.3 (CLK), RC10.2, UE10.3 (IO2), UE10.4 (IO2b)
/SC11: J21.3 (CLK), RC11.2, UE11.3 (IO2), UE11.4 (IO2b)
/SC12: J22.3 (CLK), RC12.2, UE12.3 (IO2), UE12.4 (IO2b)
/SC13: J23.3 (CLK), RC13.2, UE13.3 (IO2), UE13.4 (IO2b)
/SC14: J24.3 (CLK), RC14.2, UE14.3 (IO2), UE14.4 (IO2b)
/SC15: J25.3 (CLK), RC15.2, UE15.3 (IO2), UE15.4 (IO2b)
/SCR0: RC0.1, U8.11 (B8)
/SCR1: RC1.1, U8.12 (B7)
/SCR2: RC2.1, U8.13 (B6)
/SCR3: RC3.1, U8.14 (B5)
/SCR4: RC4.1, U8.15 (B4)
/SCR5: RC5.1, U8.16 (B3)
/SCR6: RC6.1, U8.17 (B2)
/SCR7: RC7.1, U8.18 (B1)
/SCR8: RC8.1, U9.11 (B8)
/SCR9: RC9.1, U9.12 (B7)
/SCR10: RC10.1, U9.13 (B6)
/SCR11: RC11.1, U9.14 (B5)
/SCR12: RC12.1, U9.15 (B4)
/SCR13: RC13.1, U9.16 (B3)
/SCR14: RC14.1, U9.17 (B2)
/SCR15: RC15.1, U9.18 (B1)
/SD0: J10.2 (DATA), RD0.2, UE0.1 (IO1), UE0.6 (IO1b)
/SD1: J11.2 (DATA), RD1.2, UE1.1 (IO1), UE1.6 (IO1b)
/SD2: J12.2 (DATA), RD2.2, UE2.1 (IO1), UE2.6 (IO1b)
/SD3: J13.2 (DATA), RD3.2, UE3.1 (IO1), UE3.6 (IO1b)
/SD4: J14.2 (DATA), RD4.2, UE4.1 (IO1), UE4.6 (IO1b)
/SD5: J15.2 (DATA), RD5.2, UE5.1 (IO1), UE5.6 (IO1b)
/SD6: J16.2 (DATA), RD6.2, UE6.1 (IO1), UE6.6 (IO1b)
/SD7: J17.2 (DATA), RD7.2, UE7.1 (IO1), UE7.6 (IO1b)
/SD8: J18.2 (DATA), RD8.2, UE8.1 (IO1), UE8.6 (IO1b)
/SD9: J19.2 (DATA), RD9.2, UE9.1 (IO1), UE9.6 (IO1b)
/SD10: J20.2 (DATA), RD10.2, UE10.1 (IO1), UE10.6 (IO1b)
/SD11: J21.2 (DATA), RD11.2, UE11.1 (IO1), UE11.6 (IO1b)
/SD12: J22.2 (DATA), RD12.2, UE12.1 (IO1), UE12.6 (IO1b)
/SD13: J23.2 (DATA), RD13.2, UE13.1 (IO1), UE13.6 (IO1b)
/SD14: J24.2 (DATA), RD14.2, UE14.1 (IO1), UE14.6 (IO1b)
/SD15: J25.2 (DATA), RD15.2, UE15.1 (IO1), UE15.6 (IO1b)
/SDR0: RD0.1, U6.11 (B8)
/SDR1: RD1.1, U6.12 (B7)
/SDR2: RD2.1, U6.13 (B6)
/SDR3: RD3.1, U6.14 (B5)
/SDR4: RD4.1, U6.15 (B4)
/SDR5: RD5.1, U6.16 (B3)
/SDR6: RD6.1, U6.17 (B2)
/SDR7: RD7.1, U6.18 (B1)
/SDR8: RD8.1, U7.11 (B8)
/SDR9: RD9.1, U7.12 (B7)
/SDR10: RD10.1, U7.13 (B6)
/SDR11: RD11.1, U7.14 (B5)
/SDR12: RD12.1, U7.15 (B4)
/SDR13: RD13.1, U7.16 (B3)
/SDR14: RD14.1, U7.17 (B2)
/SDR15: RD15.1, U7.18 (B1)
/SEL_N: U4.19 (~P=Q), U5.2 (B)
/SS5: C38.1, U31.14 (SS)
/SW5: C36.2, L30.1, U31.6 (SW), U31.7 (SW_2)
/V5S0: F10.2, J10.1 (+5V)
/V5S1: F11.2, J11.1 (+5V)
/V5S2: F12.2, J12.1 (+5V)
/V5S3: F13.2, J13.1 (+5V)
/V5S4: F14.2, J14.1 (+5V)
/V5S5: F15.2, J15.1 (+5V)
/V5S6: F16.2, J16.1 (+5V)
/V5S7: F17.2, J17.1 (+5V)
/V5S8: F18.2, J18.1 (+5V)
/V5S9: F19.2, J19.1 (+5V)
/V5S10: F20.2, J20.1 (+5V)
/V5S11: F21.2, J21.1 (+5V)
/V5S12: F22.2, J22.1 (+5V)
/V5S13: F23.2, J23.1 (+5V)
/V5S14: F24.2, J24.1 (+5V)
/V5S15: F25.2, J25.1 (+5V)
/V12_IN: C32.1, D30.1 (K), J30.1 (+12V), R30.1, R40.1, U30.5 (IN)
/VREG5: C37.1, R37.1, U31.17 (VREG5)

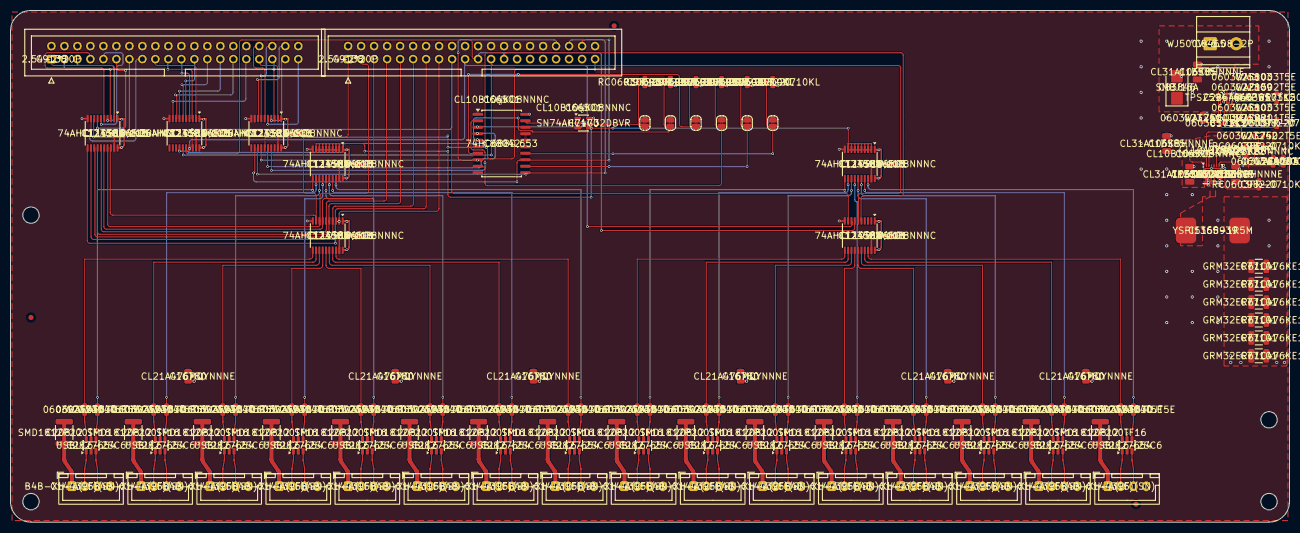
[picture p53: board branch_v1.kicad_pcb from above]

Board: 2 copper layers, 250.0 x 100.0 mm, 156 parts (0 on the bottom side), 151 nets.

Other parts of the board:
FID1, FID2, FID3: FID; Fiducial_1mm_Mask2mm
H1, H2, H3, H4: M3; MountingHole_3.2mm_M3
