illiapliukhin/led-cube-32-controller/hardware/v15_baseline/mono_electronics.kicad_pcb

## KiCad design hardware/v15_baseline/mono_electronics.kicad_pcb (2026-10-12)

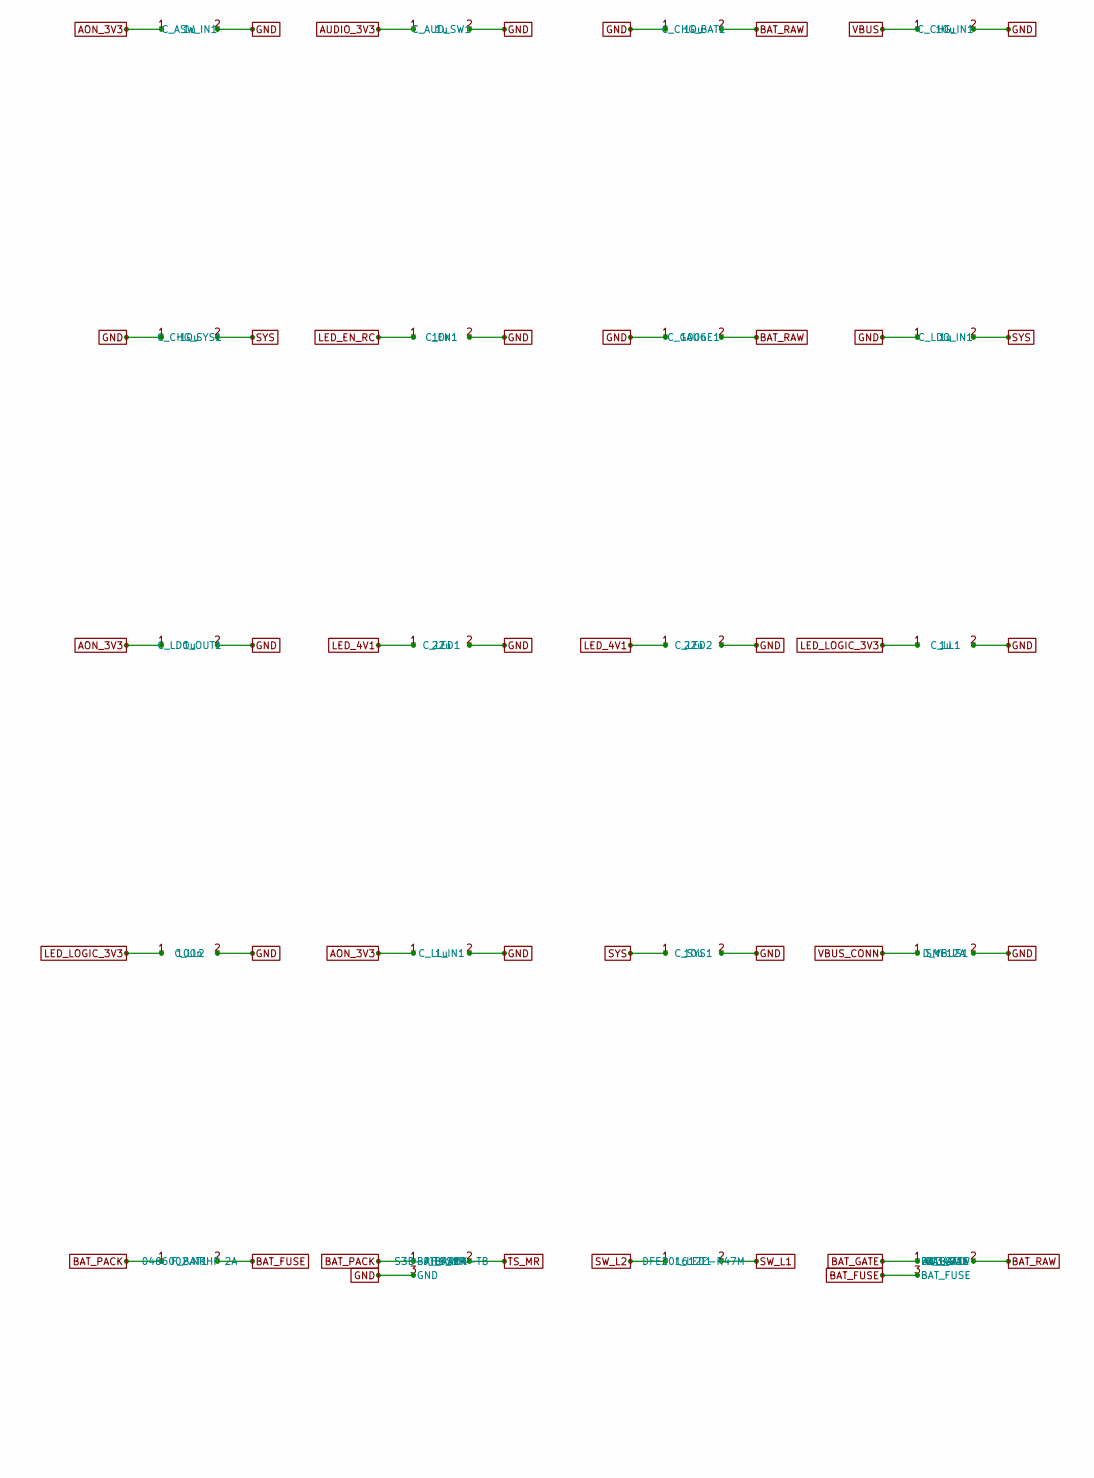
[picture p54: schematic power.kicad_sch, Power - charger, bucks, LDO, switches, battery, part in row 1, column 1]

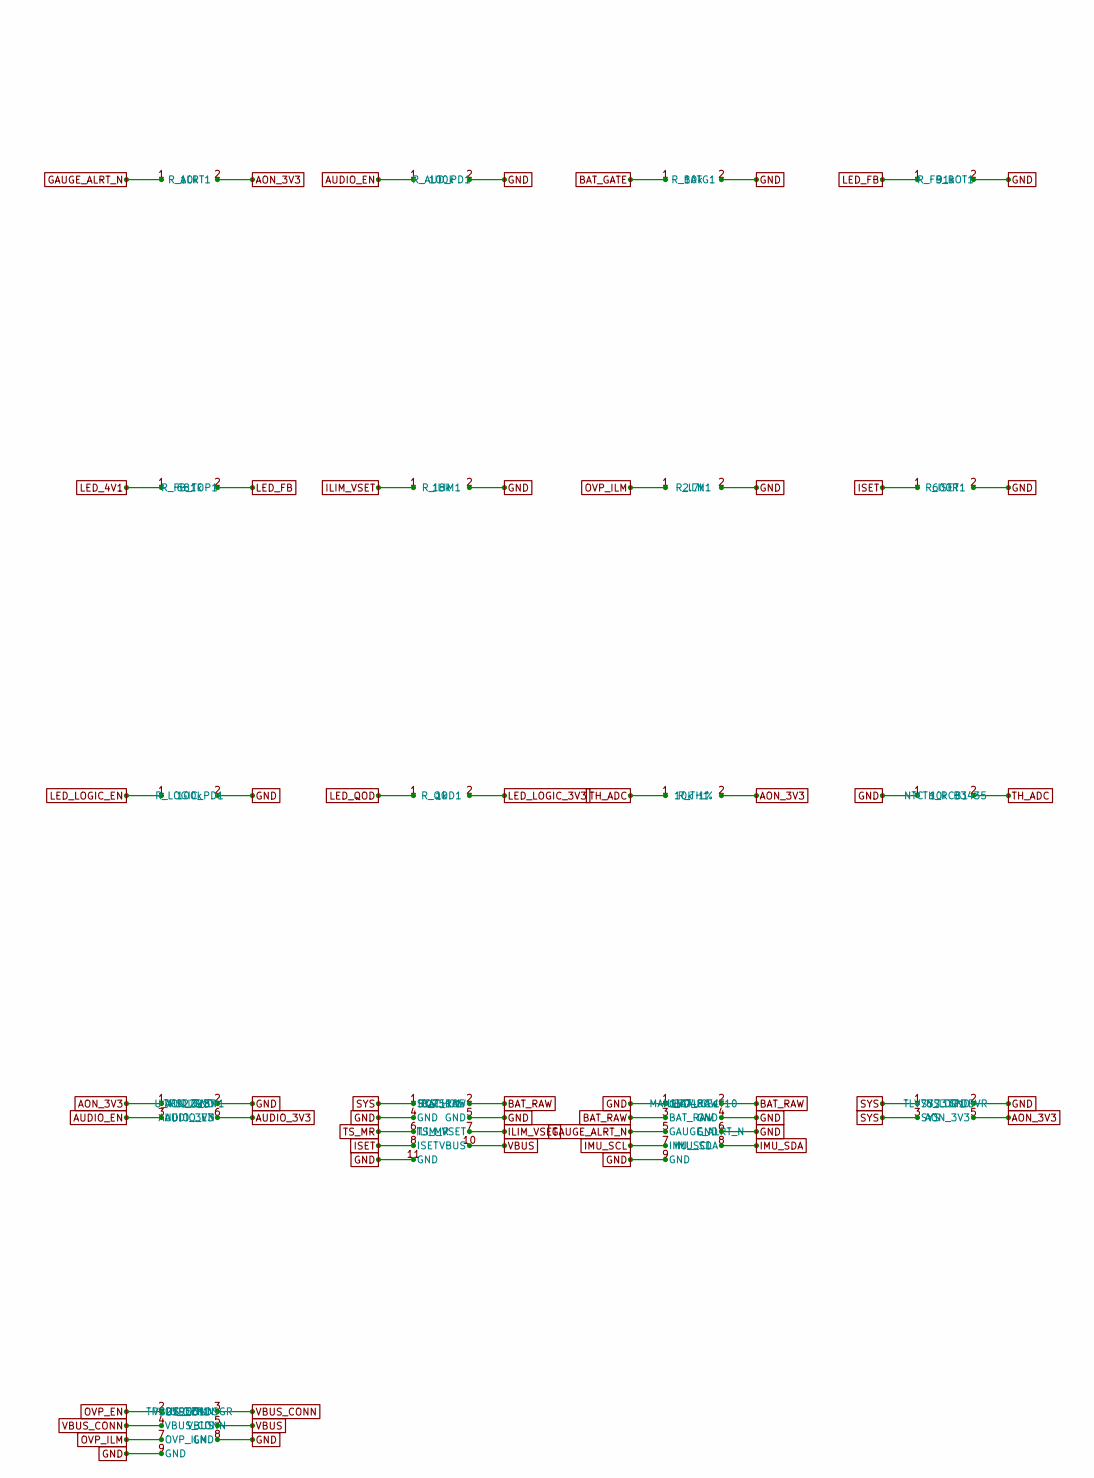
[picture p55: schematic power.kicad_sch, Power - charger, bucks, LDO, switches, battery, part in row 2, column 1]

Parts:
C_ASW_IN1: 1u; C_0402_1005Metric
C_AUD_SW1: 1u; C_0402_1005Metric
C_CHG_BAT1: 10u; C_0805_2012Metric
C_CHG_IN1: 10u; C_0805_2012Metric
C_CHG_SYS1: 10u; C_0805_2012Metric
C_EN1: 10n; C_0402_1005Metric
C_GAUGE1: 100n; C_0402_1005Metric
C_LDO_IN1: 1u; C_0603_1608Metric
C_LDO_OUT1: 1u; C_0603_1608Metric
C_LED1, C_LED2: 22u; C_0805_2012Metric
C_LL1: 1u; C_0402_1005Metric
C_LL2: 100n; C_0402_1005Metric
C_LL_IN1: 1u; C_0402_1005Metric_SilkTrim
C_SYS1: 10u; C_0805_2012Metric
D_VBUS1: SMF12A; D_SOD-123F
F_BAT1: 0466002.NRHF 2A; Fuse_1206_3216Metric
J_BAT1: S3B-PH-SM4-TB; JST_PH_S3B-PH-SM4-TB_1x03-1MP_P2.00mm_Horizontal
L_LED1: DFE201612E-R47M; L_Murata_DFE201610P
Q_BAT1: AO3401A; SOT-23
R_ALRT1: 10k; R_0402_1005Metric
R_AUD_PD1: 100k; R_0402_1005Metric
R_BATG1: 10k; R_0402_1005Metric
R_FB_BOT1: 91k; R_0402_1005Metric
R_FB_TOP1: 681k; R_0402_1005Metric
R_ILIM1: 18k; R_0402_1005Metric
R_ILM1: 2.7k; R_0402_1005Metric
R_ISET1: 600R; R_0402_1005Metric
R_LOGIC_PD1: 100k; R_0402_1005Metric
R_QOD1: 1k; R_0402_1005Metric
R_TH1: 10k 1%; R_0402_1005Metric
TH_PCB1: NTC 10k B3435; R_0402_1005Metric
U_AUDIO_SW1: TPS22917; SOT-23-6
U_CHG1: BQ25185; Texas_DLH0010A_WSON-10-1EP_2x2mm_P0.4mm_EP0.9x1.5mm
U_GAUGE1: MAX17048G+T10; TDFN-8-1EP_2x2mm_P0.5mm_EP0.8x1.2mm
U_LDO1: TLV75733PDBVR; SOT-23-5
U_OVP1: TPS259531DSGR; Texas_DSG0008A_WSON-8-1EP_2x2mm_P0.5mm_EP0.9x1.6mm

Connections:
AON_3V3: C_ASW_IN1.1, C_LDO_OUT1.1, C_LL_IN1.1, R_ALRT1.2, R_TH1.2, U_AUDIO_SW1.1 (AON_3V3), U_LDO1.5 (AON_3V3); also elsewhere on the board
AUDIO_3V3: C_AUD_SW1.1, U_AUDIO_SW1.6 (AUDIO_3V3); also elsewhere on the board
AUDIO_EN: R_AUD_PD1.1, U_AUDIO_SW1.3 (AUDIO_EN); also elsewhere on the board
BAT_FUSE: F_BAT1.2, Q_BAT1.3 (BAT_FUSE)
BAT_GATE: Q_BAT1.1 (BAT_GATE), R_BATG1.1
BAT_PACK: F_BAT1.1, J_BAT1.1 (BAT_PACK)
BAT_RAW: C_CHG_BAT1.2, C_GAUGE1.2, Q_BAT1.2 (BAT_RAW), U_CHG1.2 (BAT_RAW), U_GAUGE1.2 (BAT_RAW), U_GAUGE1.3 (BAT_RAW)
GAUGE_ALRT_N: R_ALRT1.1, U_GAUGE1.5 (GAUGE_ALRT_N); also elsewhere on the board
GND: C_ASW_IN1.2, C_AUD_SW1.2, C_CHG_BAT1.1, C_CHG_IN1.2, C_CHG_SYS1.1, C_EN1.2, C_GAUGE1.1, C_LDO_IN1.1, C_LDO_OUT1.2, C_LED1.2, C_LED2.2, C_LL1.2, C_LL2.2, C_LL_IN1.2, C_SYS1.2, D_VBUS1.2, J_BAT1.3 (GND), R_AUD_PD1.2, R_BATG1.2, R_FB_BOT1.2, R_ILIM1.2, R_ILM1.2, R_ISET1.2, R_LOGIC_PD1.2, TH_PCB1.1, U_AUDIO_SW1.2 (GND), U_CHG1.4 (GND), U_CHG1.5 (GND), U_CHG1.11 (GND), U_GAUGE1.1 (GND), U_GAUGE1.4 (GND), U_GAUGE1.6 (GND), U_GAUGE1.9 (GND), U_LDO1.2 (GND), U_OVP1.8 (GND), U_OVP1.9 (GND); also elsewhere on the board
ILIM_VSET: R_ILIM1.1, U_CHG1.7 (ILIM_VSET)
IMU_SCL: U_GAUGE1.7 (IMU_SCL); also elsewhere on the board
IMU_SDA: U_GAUGE1.8 (IMU_SDA); also elsewhere on the board
ISET: R_ISET1.1, U_CHG1.8 (ISET)
LED_4V1: C_LED1.1, C_LED2.1, R_FB_TOP1.1; also elsewhere on the board
LED_EN_RC: C_EN1.1; also elsewhere on the board
LED_FB: R_FB_BOT1.1, R_FB_TOP1.2; also elsewhere on the board
LED_LOGIC_3V3: C_LL1.1, C_LL2.1, R_QOD1.2; also elsewhere on the board
LED_LOGIC_EN: R_LOGIC_PD1.1; also elsewhere on the board
LED_QOD: R_QOD1.1; also elsewhere on the board
OVP_EN: U_OVP1.2 (OVP_EN); also elsewhere on the board
OVP_ILM: R_ILM1.1, U_OVP1.7 (OVP_ILM)
SW_L1: L_LED1.2; also elsewhere on the board
SW_L2: L_LED1.1; also elsewhere on the board
SYS: C_CHG_SYS1.2, C_LDO_IN1.2, C_SYS1.1, U_CHG1.1 (SYS), U_LDO1.1 (SYS), U_LDO1.3 (SYS); also elsewhere on the board
TH_ADC: R_TH1.1, TH_PCB1.2; also elsewhere on the board
TS_MR: J_BAT1.2 (TS_MR), U_CHG1.6 (TS_MR)
VBUS: C_CHG_IN1.1, U_CHG1.10 (VBUS), U_OVP1.5 (VBUS); also elsewhere on the board
VBUS_CONN: D_VBUS1.1, U_OVP1.3 (VBUS_CONN), U_OVP1.4 (VBUS_CONN); also elsewhere on the board

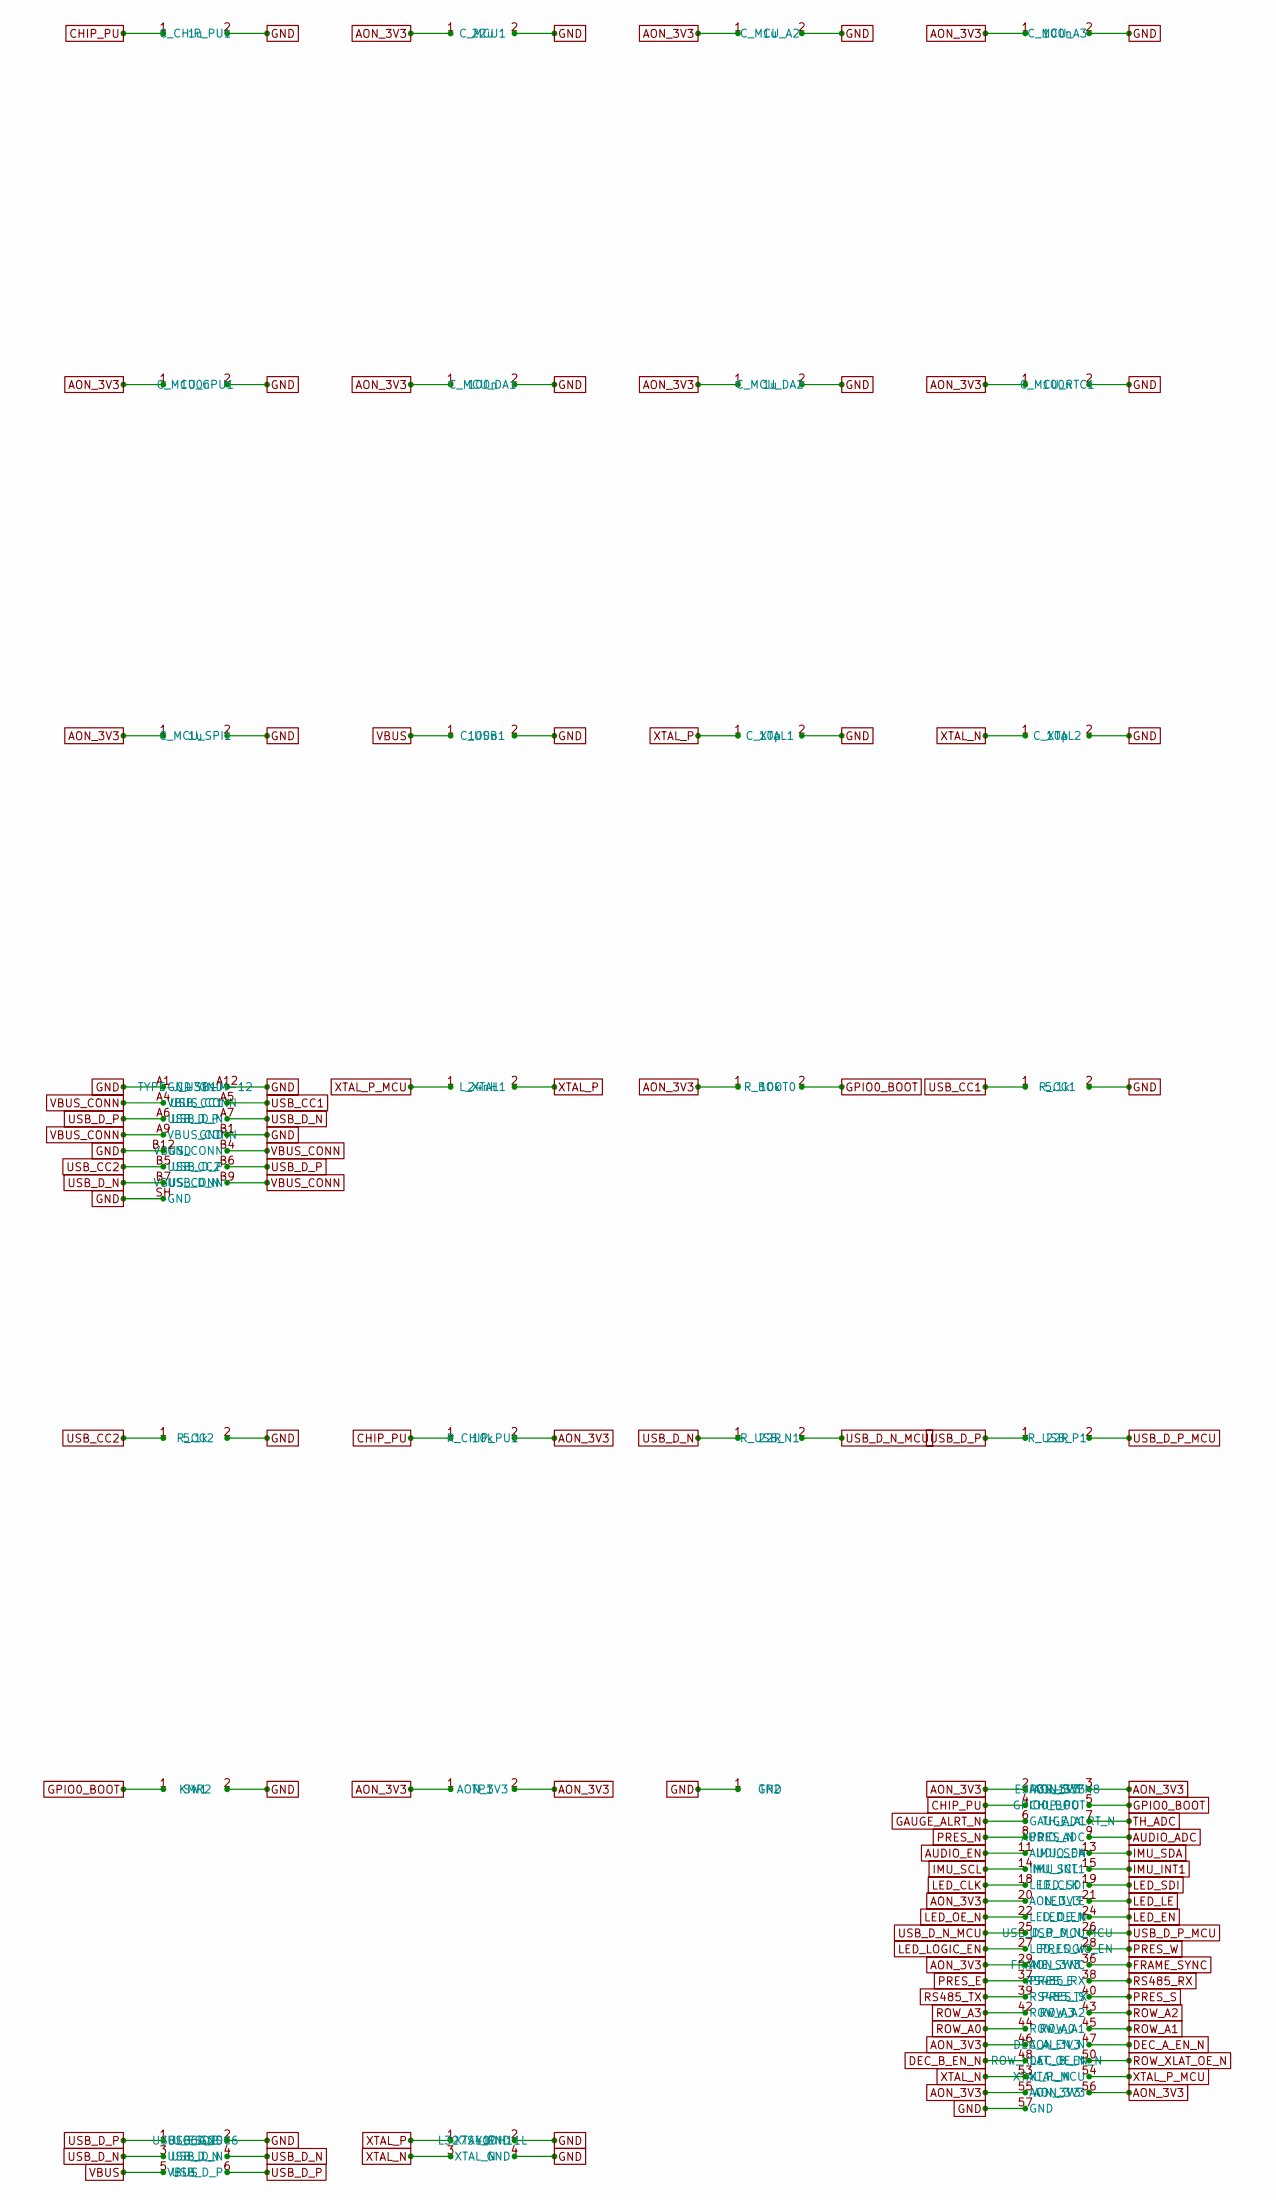
[picture p56: schematic mcu.kicad_sch, MCU - ESP32-S3, USB, crystal, boot]

Parts:
C_CHIP_PU1: 1u; C_0402_1005Metric
C_MCU1: 22u; C_0805_2012Metric
C_MCU_A2: 1u; C_0402_1005Metric
C_MCU_A3: 100n; C_0402_1005Metric
C_MCU_CPU1: 100n; C_0402_1005Metric
C_MCU_DA1: 100n; C_0402_1005Metric
C_MCU_DA2: 1u; C_0402_1005Metric
C_MCU_RTC1: 100n; C_0402_1005Metric
C_MCU_SPI1: 1u; C_0402_1005Metric
C_USB1: 100n; C_0402_1005Metric
C_XTAL1, C_XTAL2: 10p; C_0402_1005Metric
J_USB1: TYPE-C-31-M-12; USB_C_Receptacle_HRO_TYPE-C-31-M-12
L_XTAL1: 24nH; L_0402_1005Metric
R_BOOT0: 10k; R_0402_1005Metric
R_CC1, R_CC2: 5.1k; R_0402_1005Metric
R_CHIP_PU1: 10k; R_0402_1005Metric
R_USB_N1: 22R; R_0402_1005Metric
R_USB_P1: 22R; R_0402_1005Metric
SW1: KMR2; SW_Push_1P1T_NO_CK_KMR2
TP1: AON_3V3; R_0402_1005Metric
TP2: GND; R_0402_1005Metric
U1: ESP32-S3FN8; QFN-56-1EP_7x7mm_P0.4mm_EP5.6x5.6mm
U_ESD1: USBLC6-2SC6; SOT-23-6
Y1: L327S400H11L; Crystal_SMD_3225-4Pin_3.2x2.5mm

Connections:
AON_3V3: C_MCU1.1, C_MCU_A2.1, C_MCU_A3.1, C_MCU_CPU1.1, C_MCU_DA1.1, C_MCU_DA2.1, C_MCU_RTC1.1, C_MCU_SPI1.1, R_BOOT0.1, R_CHIP_PU1.2, TP1.1, TP1.2, U1.2 (AON_3V3), U1.3 (AON_3V3), U1.20 (AON_3V3), U1.29 (AON_3V3), U1.46 (AON_3V3), U1.55 (AON_3V3), U1.56 (AON_3V3); also elsewhere on the board
AUDIO_ADC: U1.9 (AUDIO_ADC); also elsewhere on the board
AUDIO_EN: U1.11 (AUDIO_EN); also elsewhere on the board
CHIP_PU: C_CHIP_PU1.1, R_CHIP_PU1.1, U1.4 (CHIP_PU)
DEC_A_EN_N: U1.47 (DEC_A_EN_N); also elsewhere on the board
DEC_B_EN_N: U1.48 (DEC_B_EN_N); also elsewhere on the board
FRAME_SYNC: U1.36 (FRAME_SYNC); also elsewhere on the board
GAUGE_ALRT_N: U1.6 (GAUGE_ALRT_N); also elsewhere on the board
GND: C_CHIP_PU1.2, C_MCU1.2, C_MCU_A2.2, C_MCU_A3.2, C_MCU_CPU1.2, C_MCU_DA1.2, C_MCU_DA2.2, C_MCU_RTC1.2, C_MCU_SPI1.2, C_USB1.2, C_XTAL1.2, C_XTAL2.2, J_USB1.A1 (GND), J_USB1.A12 (GND), J_USB1.B1 (GND), J_USB1.B12 (GND), J_USB1.SH (GND), R_CC1.2, R_CC2.2, SW1.2, TP2.1, U1.57 (GND), U_ESD1.2 (GND), Y1.2 (GND), Y1.4 (GND); also elsewhere on the board
GPIO0_BOOT: R_BOOT0.2, SW1.1, U1.5 (GPIO0_BOOT)
IMU_INT1: U1.15 (IMU_INT1); also elsewhere on the board
IMU_SCL: U1.14 (IMU_SCL); also elsewhere on the board
IMU_SDA: U1.13 (IMU_SDA); also elsewhere on the board
LED_CLK: U1.18 (LED_CLK); also elsewhere on the board
LED_EN: U1.24 (LED_EN); also elsewhere on the board
LED_LE: U1.21 (LED_LE); also elsewhere on the board
LED_LOGIC_EN: U1.27 (LED_LOGIC_EN); also elsewhere on the board
LED_OE_N: U1.22 (LED_OE_N); also elsewhere on the board
LED_SDI: U1.19 (LED_SDI); also elsewhere on the board
PRES_E: U1.37 (PRES_E); also elsewhere on the board
PRES_N: U1.8 (PRES_N); also elsewhere on the board
PRES_S: U1.40 (PRES_S); also elsewhere on the board
PRES_W: U1.28 (PRES_W); also elsewhere on the board
ROW_A0: U1.44 (ROW_A0); also elsewhere on the board
ROW_A1: U1.45 (ROW_A1); also elsewhere on the board
ROW_A2: U1.43 (ROW_A2); also elsewhere on the board
ROW_A3: U1.42 (ROW_A3); also elsewhere on the board
ROW_XLAT_OE_N: U1.50 (ROW_XLAT_OE_N); also elsewhere on the board
RS485_RX: U1.38 (RS485_RX); also elsewhere on the board
RS485_TX: U1.39 (RS485_TX); also elsewhere on the board
TH_ADC: U1.7 (TH_ADC); also elsewhere on the board
USB_CC1: J_USB1.A5 (USB_CC1), R_CC1.1
USB_CC2: J_USB1.B5 (USB_CC2), R_CC2.1
USB_D_N: J_USB1.A7 (USB_D_N), J_USB1.B7 (USB_D_N), R_USB_N1.1, U_ESD1.3 (USB_D_N), U_ESD1.4 (USB_D_N)
USB_D_N_MCU: R_USB_N1.2, U1.25 (USB_D_N_MCU)
USB_D_P: J_USB1.A6 (USB_D_P), J_USB1.B6 (USB_D_P), R_USB_P1.1, U_ESD1.1 (USB_D_P), U_ESD1.6 (USB_D_P)
USB_D_P_MCU: R_USB_P1.2, U1.26 (USB_D_P_MCU)
VBUS: C_USB1.1, U_ESD1.5 (VBUS); also elsewhere on the board
VBUS_CONN: J_USB1.A4 (VBUS_CONN), J_USB1.A9 (VBUS_CONN), J_USB1.B4 (VBUS_CONN), J_USB1.B9 (VBUS_CONN); also elsewhere on the board
XTAL_N: C_XTAL2.1, U1.53 (XTAL_N), Y1.3 (XTAL_N)
XTAL_P: C_XTAL1.1, L_XTAL1.2, Y1.1 (XTAL_P)
XTAL_P_MCU: L_XTAL1.1, U1.54 (XTAL_P_MCU)

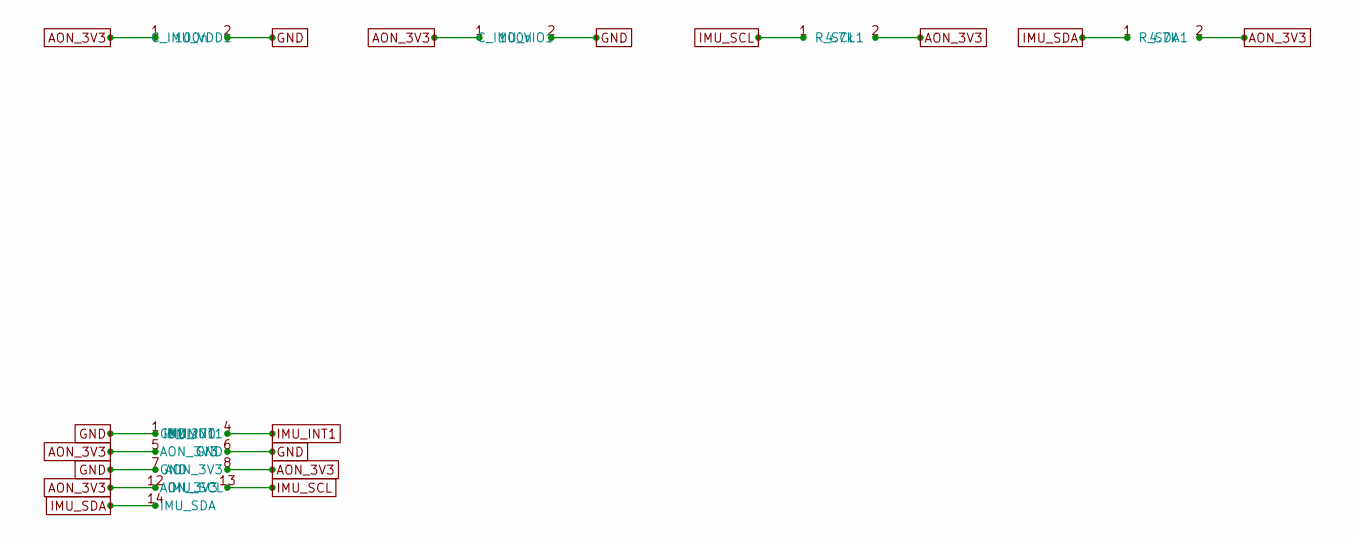
[picture p57: schematic imu.kicad_sch, IMU - BMI270]

Parts:
C_IMU_VDD1: 100n; C_0402_1005Metric
C_IMU_VIO1: 100n; C_0402_1005Metric
R_SCL1: 4.7k; R_0402_1005Metric
R_SDA1: 4.7k; R_0402_1005Metric
U_IMU1: BMI270; Bosch_LGA-14_3x2.5mm_P0.5mm

Connections:
AON_3V3: C_IMU_VDD1.1, C_IMU_VIO1.1, R_SCL1.2, R_SDA1.2, U_IMU1.5 (AON_3V3), U_IMU1.8 (AON_3V3), U_IMU1.12 (AON_3V3); also elsewhere on the board
GND: C_IMU_VDD1.2, C_IMU_VIO1.2, U_IMU1.1 (GND), U_IMU1.6 (GND), U_IMU1.7 (GND); also elsewhere on the board
IMU_INT1: U_IMU1.4 (IMU_INT1); also elsewhere on the board
IMU_SCL: R_SCL1.1, U_IMU1.13 (IMU_SCL); also elsewhere on the board
IMU_SDA: R_SDA1.1, U_IMU1.14 (IMU_SDA); also elsewhere on the board

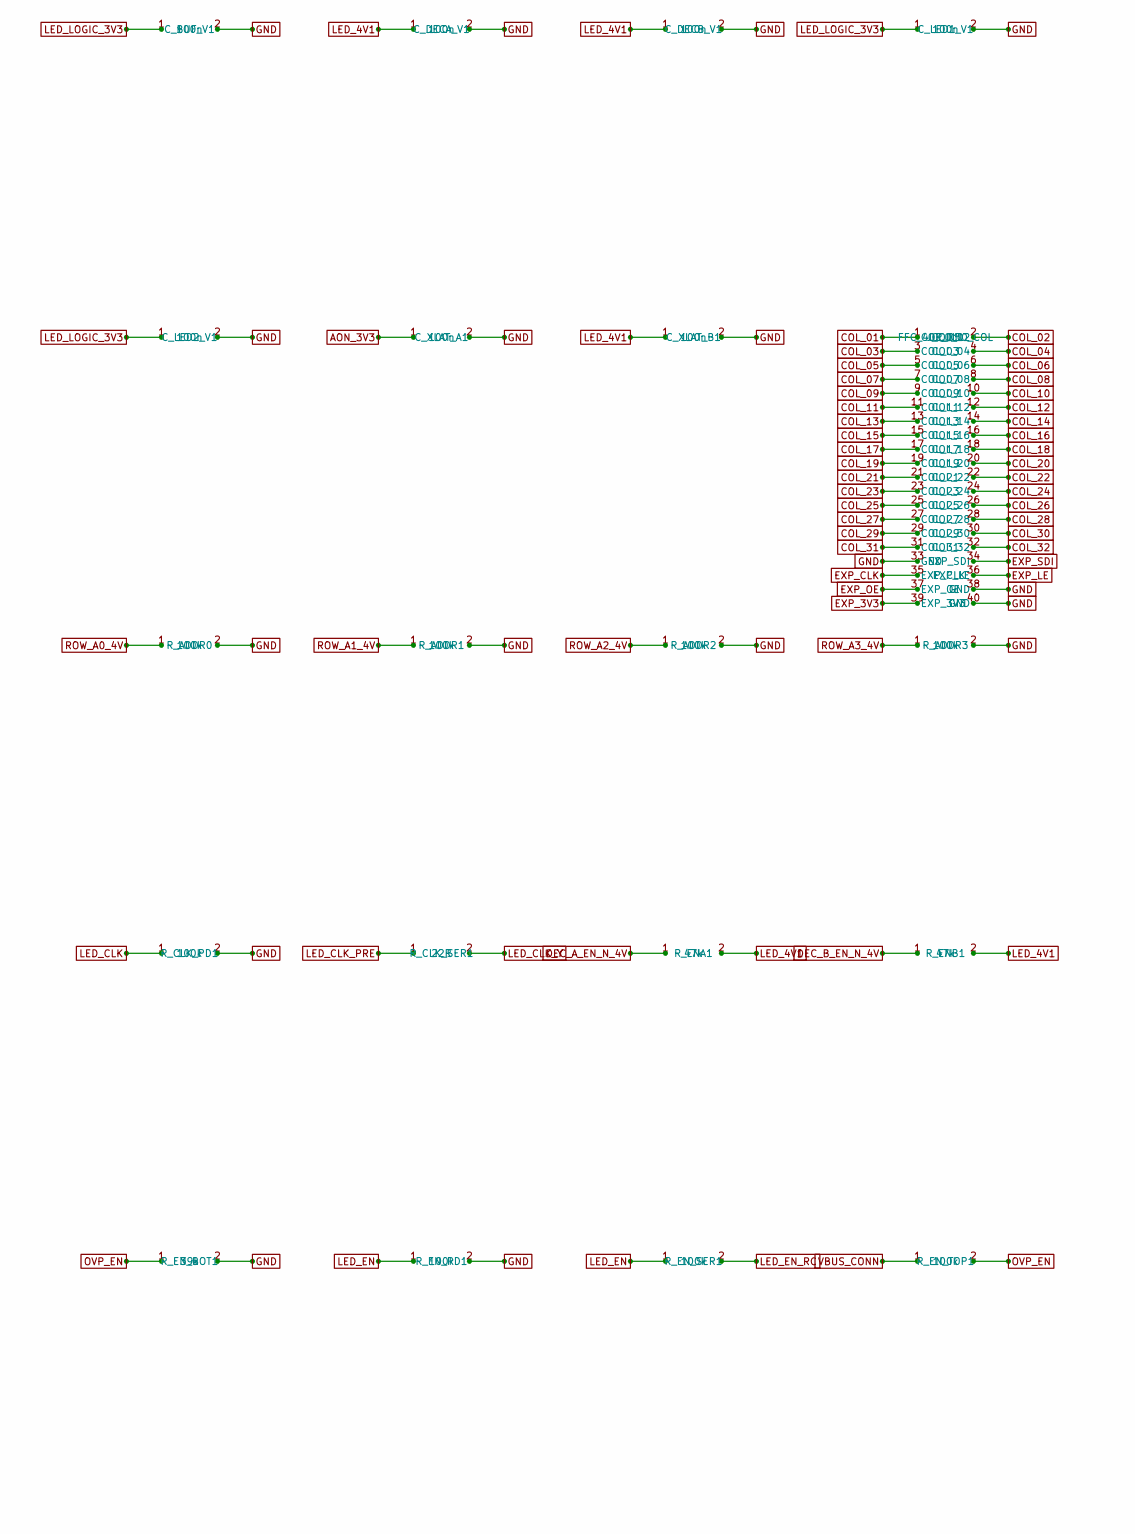
[picture p58: schematic led_drive.kicad_sch, LED column drive - MBI5124, buffers, translator, decoders, …, part in row 1, column 1]

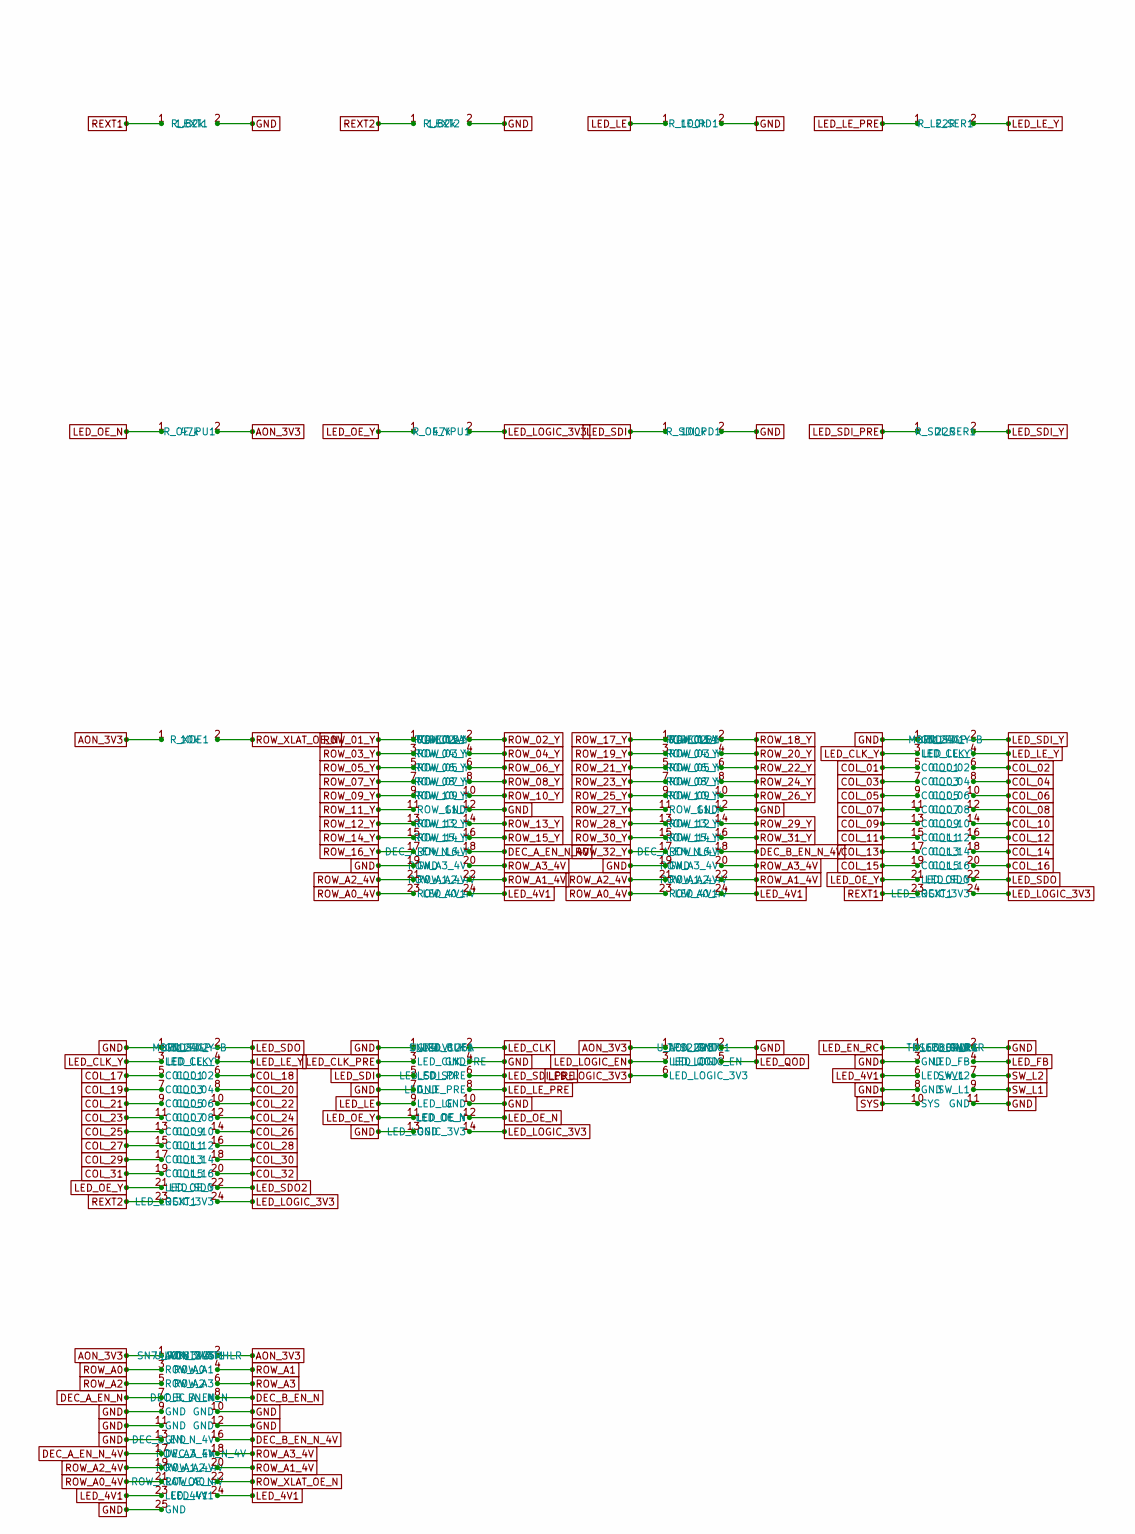
[picture p59: schematic led_drive.kicad_sch, LED column drive - MBI5124, buffers, translator, decoders, …, part in row 2, column 1]

Parts:
C_BUF_V1: 100n; C_0402_1005Metric
C_DECA_V1: 100n; C_0402_1005Metric
C_DECB_V1: 100n; C_0402_1005Metric
C_LED1_V1, C_LED2_V1: 100n; C_0402_1005Metric
C_XLAT_A1: 100n; C_0402_1005Metric
C_XLAT_B1: 100n; C_0402_1005Metric
J_COL1: FFC_40P_050_COL
R_ADDR0, R_ADDR1, R_ADDR2, R_ADDR3: 100k; R_0402_1005Metric
R_CLK_PD1: 100k; R_0402_1005Metric
R_CLK_SER1: 22R; R_0402_1005Metric
R_ENA1: 47k; R_0402_1005Metric
R_ENB1: 47k; R_0402_1005Metric
R_EN_BOT1: 39k; R_0402_1005Metric
R_EN_PD1: 100k; R_0402_1005Metric
R_EN_SER1: 100k; R_0402_1005Metric
R_EN_TOP1: 100k; R_0402_1005Metric
R_EXT1, R_EXT2: 1.82k; R_0402_1005Metric
R_LE_PD1: 100k; R_0402_1005Metric
R_LE_SER1: 22R; R_0402_1005Metric
R_OE_PU1: 47k; R_0402_1005Metric
R_OE_YPU1: 47k; R_0402_1005Metric
R_SDI_PD1: 100k; R_0402_1005Metric
R_SDI_SER1: 22R; R_0402_1005Metric
R_XOE1: 10k; R_0402_1005Metric
U_DEC_A1: 74HC154; TSSOP-24_4.4x7.8mm_P0.65mm
U_DEC_B1: 74HC154; TSSOP-24_4.4x7.8mm_P0.65mm
U_LED1, U_LED2: MBI5124GP-B; SSOP-24_3.9x8.7mm_P0.635mm
U_LED_BUF1: SN74LV125A; TSSOP-14_4.4x5mm_P0.65mm
U_LED_LOGIC1: TPS22917; SOT-23-6
U_LED_PWR1: TPS63802DLAR; TDFN-10-1EP_2x3mm_P0.5mm_EP0.9x2mm
U_ROW_XLAT1: SN74LVC8T245RHLR; Texas_RHL0024A_VQFN-24-1EP_3.5x5.5mm_P0.5mm_EP2.05x4.05mm

Connections:
AON_3V3: C_XLAT_A1.1, R_OE_PU1.2, R_XOE1.1, U_LED_LOGIC1.1 (AON_3V3), U_ROW_XLAT1.1 (AON_3V3), U_ROW_XLAT1.2 (AON_3V3); also elsewhere on the board
COL_01: J_COL1.1 (COL_01), U_LED1.5 (COL_01); also elsewhere on the board
COL_02: J_COL1.2 (COL_02), U_LED1.6 (COL_02); also elsewhere on the board
COL_03: J_COL1.3 (COL_03), U_LED1.7 (COL_03); also elsewhere on the board
COL_04: J_COL1.4 (COL_04), U_LED1.8 (COL_04); also elsewhere on the board
COL_05: J_COL1.5 (COL_05), U_LED1.9 (COL_05); also elsewhere on the board
COL_06: J_COL1.6 (COL_06), U_LED1.10 (COL_06); also elsewhere on the board
COL_07: J_COL1.7 (COL_07), U_LED1.11 (COL_07); also elsewhere on the board
COL_08: J_COL1.8 (COL_08), U_LED1.12 (COL_08); also elsewhere on the board
COL_09: J_COL1.9 (COL_09), U_LED1.13 (COL_09); also elsewhere on the board
COL_10: J_COL1.10 (COL_10), U_LED1.14 (COL_10); also elsewhere on the board
COL_11: J_COL1.11 (COL_11), U_LED1.15 (COL_11); also elsewhere on the board
COL_12: J_COL1.12 (COL_12), U_LED1.16 (COL_12); also elsewhere on the board
COL_13: J_COL1.13 (COL_13), U_LED1.17 (COL_13); also elsewhere on the board
COL_14: J_COL1.14 (COL_14), U_LED1.18 (COL_14); also elsewhere on the board
COL_15: J_COL1.15 (COL_15), U_LED1.19 (COL_15); also elsewhere on the board
COL_16: J_COL1.16 (COL_16), U_LED1.20 (COL_16); also elsewhere on the board
COL_17: J_COL1.17 (COL_17), U_LED2.5 (COL_01); also elsewhere on the board
COL_18: J_COL1.18 (COL_18), U_LED2.6 (COL_02); also elsewhere on the board
COL_19: J_COL1.19 (COL_19), U_LED2.7 (COL_03); also elsewhere on the board
COL_20: J_COL1.20 (COL_20), U_LED2.8 (COL_04); also elsewhere on the board
COL_21: J_COL1.21 (COL_21), U_LED2.9 (COL_05); also elsewhere on the board
COL_22: J_COL1.22 (COL_22), U_LED2.10 (COL_06); also elsewhere on the board
COL_23: J_COL1.23 (COL_23), U_LED2.11 (COL_07); also elsewhere on the board
COL_24: J_COL1.24 (COL_24), U_LED2.12 (COL_08); also elsewhere on the board
COL_25: J_COL1.25 (COL_25), U_LED2.13 (COL_09); also elsewhere on the board
COL_26: J_COL1.26 (COL_26), U_LED2.14 (COL_10); also elsewhere on the board
COL_27: J_COL1.27 (COL_27), U_LED2.15 (COL_11); also elsewhere on the board
COL_28: J_COL1.28 (COL_28), U_LED2.16 (COL_12); also elsewhere on the board
COL_29: J_COL1.29 (COL_29), U_LED2.17 (COL_13); also elsewhere on the board
COL_30: J_COL1.30 (COL_30), U_LED2.18 (COL_14); also elsewhere on the board
COL_31: J_COL1.31 (COL_31), U_LED2.19 (COL_15); also elsewhere on the board
COL_32: J_COL1.32 (COL_32), U_LED2.20 (COL_16); also elsewhere on the board
DEC_A_EN_N: U_ROW_XLAT1.7 (DEC_A_EN_N); also elsewhere on the board
DEC_A_EN_N_4V: R_ENA1.1, U_DEC_A1.18 (DEC_A_EN_N_4V), U_ROW_XLAT1.17 (DEC_A_EN_N_4V)
DEC_B_EN_N: U_ROW_XLAT1.8 (DEC_B_EN_N); also elsewhere on the board
DEC_B_EN_N_4V: R_ENB1.1, U_DEC_B1.18 (DEC_A_EN_N_4V), U_ROW_XLAT1.16 (DEC_B_EN_N_4V)
EXP_3V3: J_COL1.39 (EXP_3V3); also elsewhere on the board
EXP_CLK: J_COL1.35 (EXP_CLK); also elsewhere on the board
EXP_LE: J_COL1.36 (EXP_LE); also elsewhere on the board
EXP_OE: J_COL1.37 (EXP_OE); also elsewhere on the board
EXP_SDI: J_COL1.34 (EXP_SDI); also elsewhere on the board
GND: C_BUF_V1.2, C_DECA_V1.2, C_DECB_V1.2, C_LED1_V1.2, C_LED2_V1.2, C_XLAT_A1.2, C_XLAT_B1.2, J_COL1.33 (GND), J_COL1.38 (GND), J_COL1.40 (GND), R_ADDR0.2, R_ADDR1.2, R_ADDR2.2, R_ADDR3.2, R_CLK_PD1.2, R_EN_BOT1.2, R_EN_PD1.2, R_EXT1.2, R_EXT2.2, R_LE_PD1.2, R_SDI_PD1.2, U_DEC_A1.12 (GND), U_DEC_A1.19 (GND), U_DEC_B1.12 (GND), U_DEC_B1.19 (GND), U_LED1.1 (GND), U_LED2.1 (GND), U_LED_BUF1.1 (GND), U_LED_BUF1.4 (GND), U_LED_BUF1.7 (GND), U_LED_BUF1.10 (GND), U_LED_BUF1.13 (GND), U_LED_LOGIC1.2 (GND), U_LED_PWR1.2 (GND), U_LED_PWR1.3 (GND), U_LED_PWR1.8 (GND), U_LED_PWR1.11 (GND), U_ROW_XLAT1.9 (GND), U_ROW_XLAT1.10 (GND), U_ROW_XLAT1.11 (GND), U_ROW_XLAT1.12 (GND), U_ROW_XLAT1.13 (GND), U_ROW_XLAT1.25 (GND); also elsewhere on the board
LED_4V1: C_DECA_V1.1, C_DECB_V1.1, C_XLAT_B1.1, R_ENA1.2, R_ENB1.2, U_DEC_A1.24 (LED_4V1), U_DEC_B1.24 (LED_4V1), U_LED_PWR1.6 (LED_4V1), U_ROW_XLAT1.23 (LED_4V1), U_ROW_XLAT1.24 (LED_4V1); also elsewhere on the board
LED_CLK: R_CLK_PD1.1, U_LED_BUF1.2 (LED_CLK); also elsewhere on the board
LED_CLK_PRE: R_CLK_SER1.1, U_LED_BUF1.3 (LED_CLK_PRE)
LED_CLK_Y: R_CLK_SER1.2, U_LED1.3 (LED_CLK_Y), U_LED2.3 (LED_CLK_Y); also elsewhere on the board
LED_EN: R_EN_PD1.1, R_EN_SER1.1; also elsewhere on the board
LED_EN_RC: R_EN_SER1.2, U_LED_PWR1.1 (LED_EN_RC); also elsewhere on the board
LED_FB: U_LED_PWR1.4 (LED_FB); also elsewhere on the board
LED_LE: R_LE_PD1.1, U_LED_BUF1.9 (LED_LE); also elsewhere on the board
LED_LE_PRE: R_LE_SER1.1, U_LED_BUF1.8 (LED_LE_PRE)
LED_LE_Y: R_LE_SER1.2, U_LED1.4 (LED_LE_Y), U_LED2.4 (LED_LE_Y); also elsewhere on the board
LED_LOGIC_3V3: C_BUF_V1.1, C_LED1_V1.1, C_LED2_V1.1, R_OE_YPU1.2, U_LED1.24 (LED_LOGIC_3V3), U_LED2.24 (LED_LOGIC_3V3), U_LED_BUF1.14 (LED_LOGIC_3V3), U_LED_LOGIC1.6 (LED_LOGIC_3V3); also elsewhere on the board
LED_LOGIC_EN: U_LED_LOGIC1.3 (LED_LOGIC_EN); also elsewhere on the board
LED_OE_N: R_OE_PU1.1, U_LED_BUF1.12 (LED_OE_N); also elsewhere on the board
LED_OE_Y: R_OE_YPU1.1, U_LED1.21 (LED_OE_Y), U_LED2.21 (LED_OE_Y), U_LED_BUF1.11 (LED_OE_Y); also elsewhere on the board
LED_QOD: U_LED_LOGIC1.5 (LED_QOD); also elsewhere on the board
LED_SDI: R_SDI_PD1.1, U_LED_BUF1.5 (LED_SDI); also elsewhere on the board
LED_SDI_PRE: R_SDI_SER1.1, U_LED_BUF1.6 (LED_SDI_PRE)
LED_SDI_Y: R_SDI_SER1.2, U_LED1.2 (LED_SDI_Y)
LED_SDO: U_LED1.22 (LED_SDO), U_LED2.2 (LED_SDI_Y)
LED_SDO2: U_LED2.22 (LED_SDO); also elsewhere on the board
OVP_EN: R_EN_BOT1.1, R_EN_TOP1.2; also elsewhere on the board
REXT1: R_EXT1.1, U_LED1.23 (REXT1)
REXT2: R_EXT2.1, U_LED2.23 (REXT1)
ROW_01_Y: U_DEC_A1.1 (ROW_01_Y); also elsewhere on the board
ROW_02_Y: U_DEC_A1.2 (ROW_02_Y); also elsewhere on the board
ROW_03_Y: U_DEC_A1.3 (ROW_03_Y); also elsewhere on the board
ROW_04_Y: U_DEC_A1.4 (ROW_04_Y); also elsewhere on the board
ROW_05_Y: U_DEC_A1.5 (ROW_05_Y); also elsewhere on the board
ROW_06_Y: U_DEC_A1.6 (ROW_06_Y); also elsewhere on the board
ROW_07_Y: U_DEC_A1.7 (ROW_07_Y); also elsewhere on the board
ROW_08_Y: U_DEC_A1.8 (ROW_08_Y); also elsewhere on the board
ROW_09_Y: U_DEC_A1.9 (ROW_09_Y); also elsewhere on the board
ROW_10_Y: U_DEC_A1.10 (ROW_10_Y); also elsewhere on the board
ROW_11_Y: U_DEC_A1.11 (ROW_11_Y); also elsewhere on the board
ROW_12_Y: U_DEC_A1.13 (ROW_12_Y); also elsewhere on the board
ROW_13_Y: U_DEC_A1.14 (ROW_13_Y); also elsewhere on the board
ROW_14_Y: U_DEC_A1.15 (ROW_14_Y); also elsewhere on the board
ROW_15_Y: U_DEC_A1.16 (ROW_15_Y); also elsewhere on the board
ROW_16_Y: U_DEC_A1.17 (ROW_16_Y); also elsewhere on the board
ROW_17_Y: U_DEC_B1.1 (ROW_01_Y); also elsewhere on the board
ROW_18_Y: U_DEC_B1.2 (ROW_02_Y); also elsewhere on the board
ROW_19_Y: U_DEC_B1.3 (ROW_03_Y); also elsewhere on the board
ROW_20_Y: U_DEC_B1.4 (ROW_04_Y); also elsewhere on the board
ROW_21_Y: U_DEC_B1.5 (ROW_05_Y); also elsewhere on the board
ROW_22_Y: U_DEC_B1.6 (ROW_06_Y); also elsewhere on the board
ROW_23_Y: U_DEC_B1.7 (ROW_07_Y); also elsewhere on the board
ROW_24_Y: U_DEC_B1.8 (ROW_08_Y); also elsewhere on the board
ROW_25_Y: U_DEC_B1.9 (ROW_09_Y); also elsewhere on the board
ROW_26_Y: U_DEC_B1.10 (ROW_10_Y); also elsewhere on the board
ROW_27_Y: U_DEC_B1.11 (ROW_11_Y); also elsewhere on the board
ROW_28_Y: U_DEC_B1.13 (ROW_12_Y); also elsewhere on the board
ROW_29_Y: U_DEC_B1.14 (ROW_13_Y); also elsewhere on the board
ROW_30_Y: U_DEC_B1.15 (ROW_14_Y); also elsewhere on the board
ROW_31_Y: U_DEC_B1.16 (ROW_15_Y); also elsewhere on the board
ROW_32_Y: U_DEC_B1.17 (ROW_16_Y); also elsewhere on the board
ROW_A0: U_ROW_XLAT1.3 (ROW_A0); also elsewhere on the board
ROW_A0_4V: R_ADDR0.1, U_DEC_A1.23 (ROW_A0_4V), U_DEC_B1.23 (ROW_A0_4V), U_ROW_XLAT1.21 (ROW_A0_4V)
ROW_A1: U_ROW_XLAT1.4 (ROW_A1); also elsewhere on the board
ROW_A1_4V: R_ADDR1.1, U_DEC_A1.22 (ROW_A1_4V), U_DEC_B1.22 (ROW_A1_4V), U_ROW_XLAT1.20 (ROW_A1_4V)
ROW_A2: U_ROW_XLAT1.5 (ROW_A2); also elsewhere on the board
ROW_A2_4V: R_ADDR2.1, U_DEC_A1.21 (ROW_A2_4V), U_DEC_B1.21 (ROW_A2_4V), U_ROW_XLAT1.19 (ROW_A2_4V)
ROW_A3: U_ROW_XLAT1.6 (ROW_A3); also elsewhere on the board
ROW_A3_4V: R_ADDR3.1, U_DEC_A1.20 (ROW_A3_4V), U_DEC_B1.20 (ROW_A3_4V), U_ROW_XLAT1.18 (ROW_A3_4V)
ROW_XLAT_OE_N: R_XOE1.2, U_ROW_XLAT1.22 (ROW_XLAT_OE_N); also elsewhere on the board
SW_L1: U_LED_PWR1.9 (SW_L1); also elsewhere on the board
SW_L2: U_LED_PWR1.7 (SW_L2); also elsewhere on the board
SYS: U_LED_PWR1.10 (SYS); also elsewhere on the board
VBUS_CONN: R_EN_TOP1.1; also elsewhere on the board
