illiapliukhin/led-cube-32-controller/hardware/v15_baseline/mono_electronics.kicad_pcb

## KiCad design hardware/v15_baseline/mono_electronics.kicad_pcb (continued)

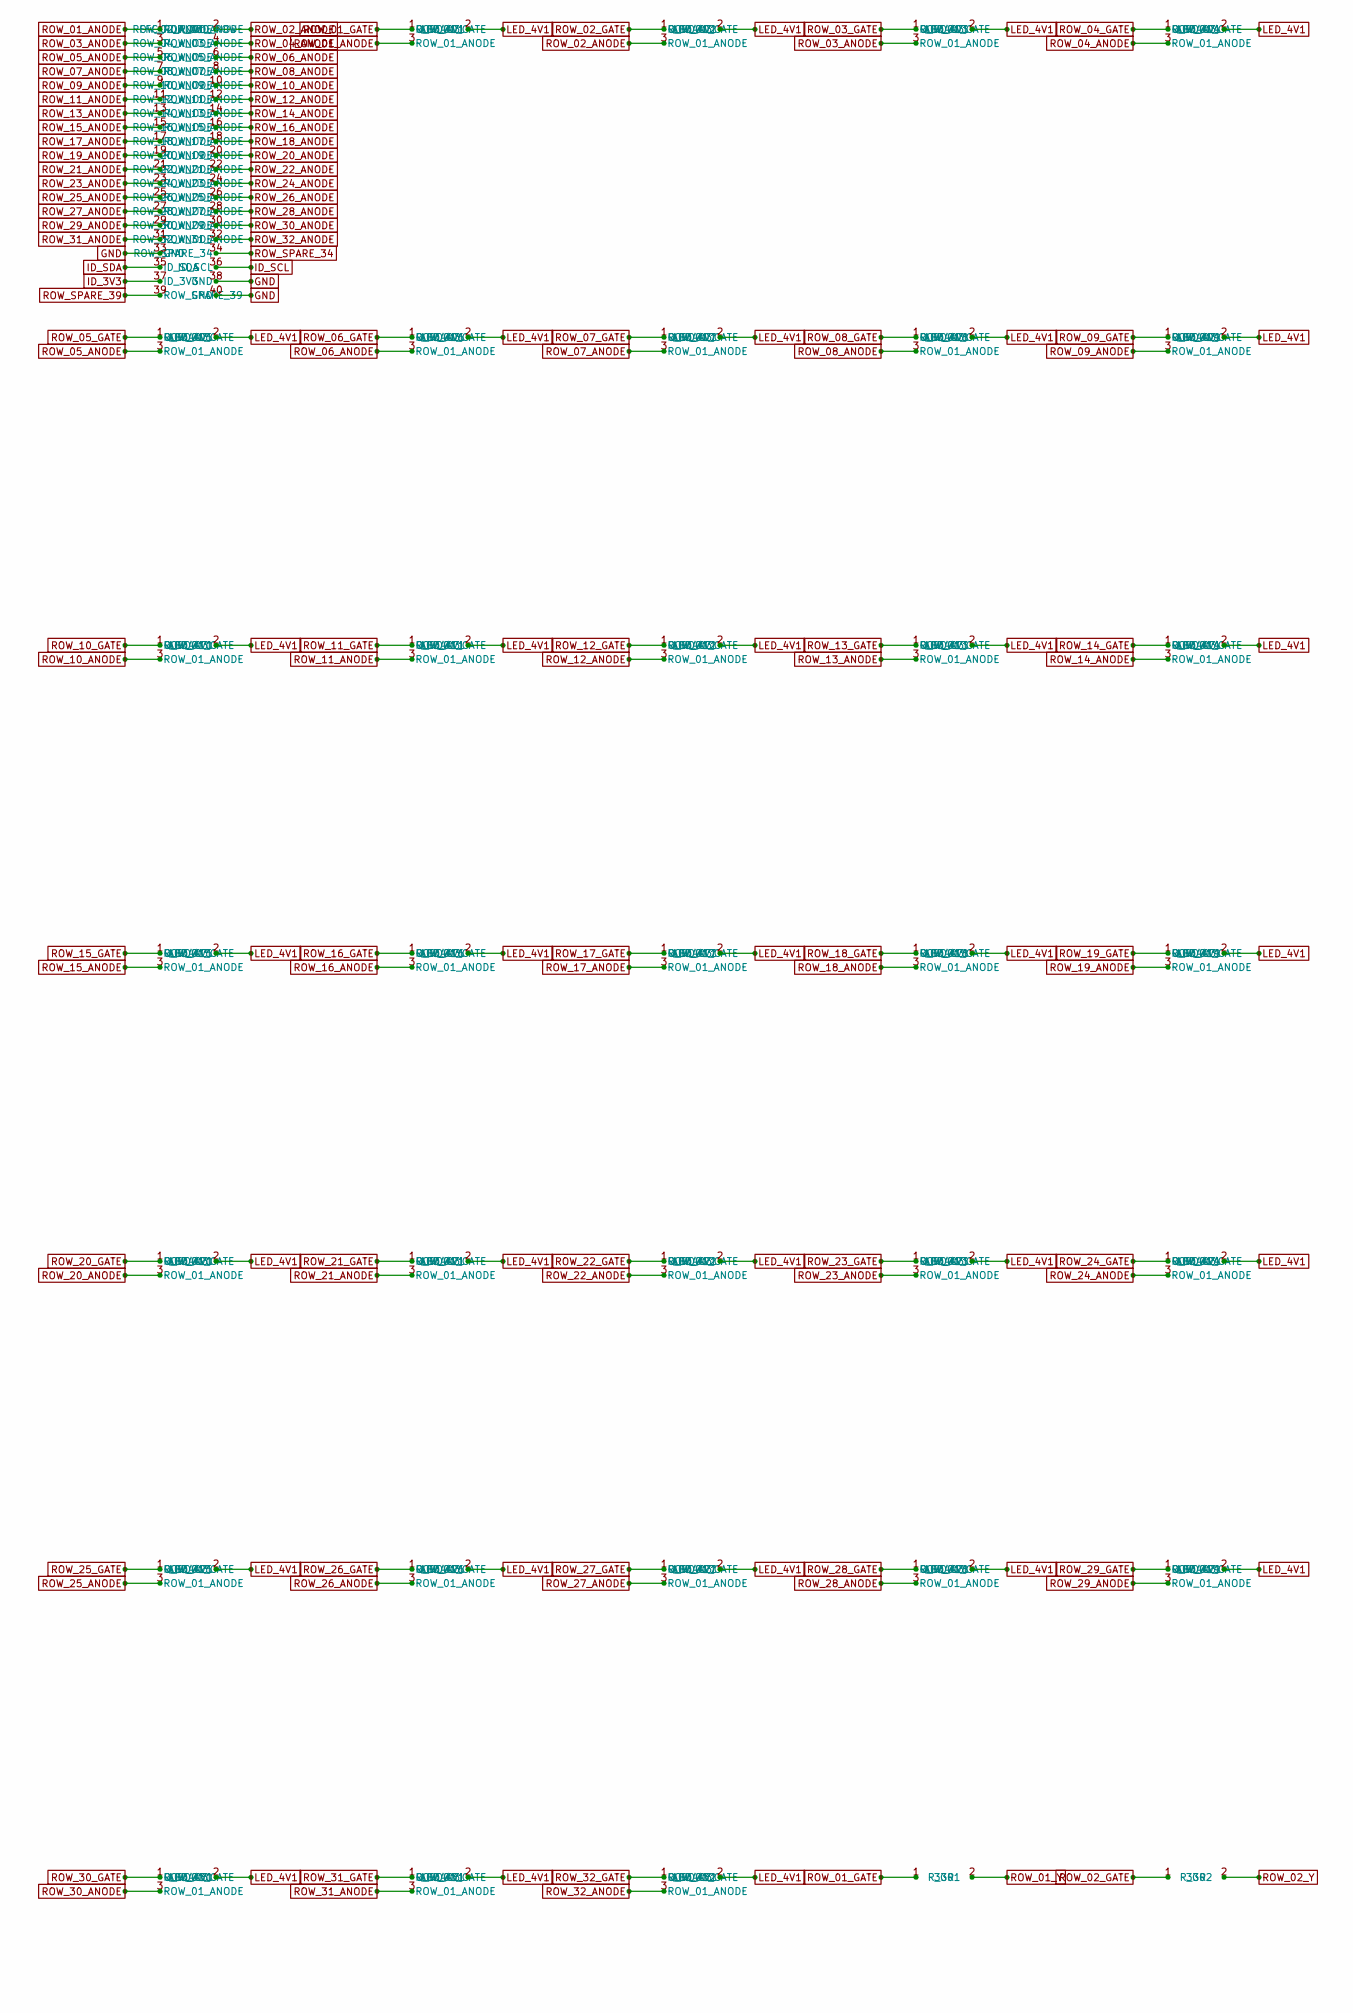
[picture p60: schematic row_farm.kicad_sch, Row farm - AO3403 x32, FFC row, part in row 1, column 1]

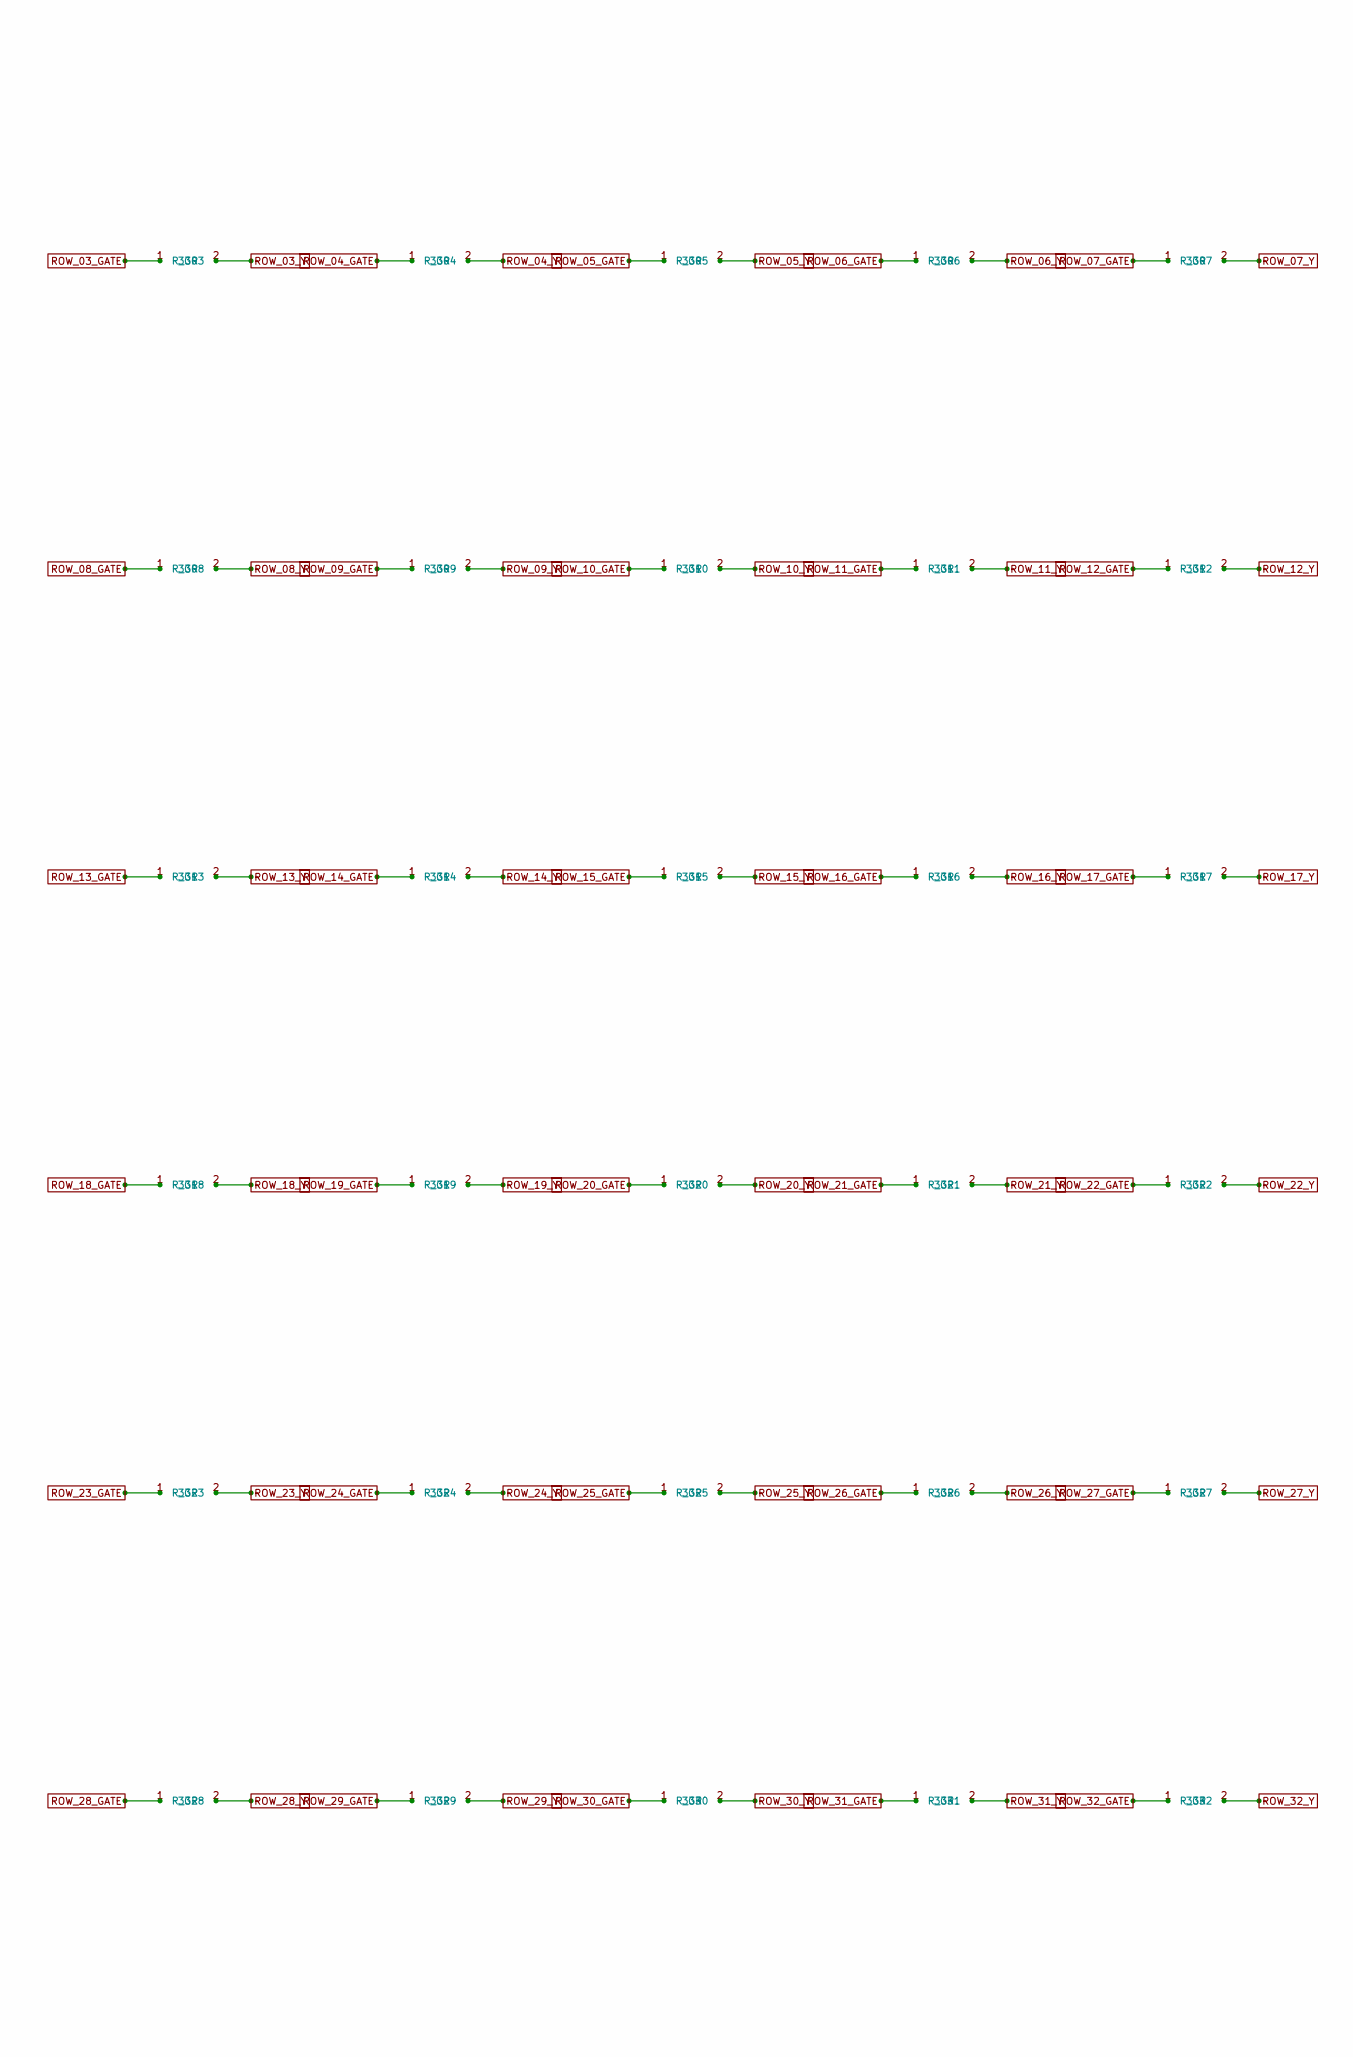
[picture p61: schematic row_farm.kicad_sch, Row farm - AO3403 x32, FFC row, part in row 2, column 1]

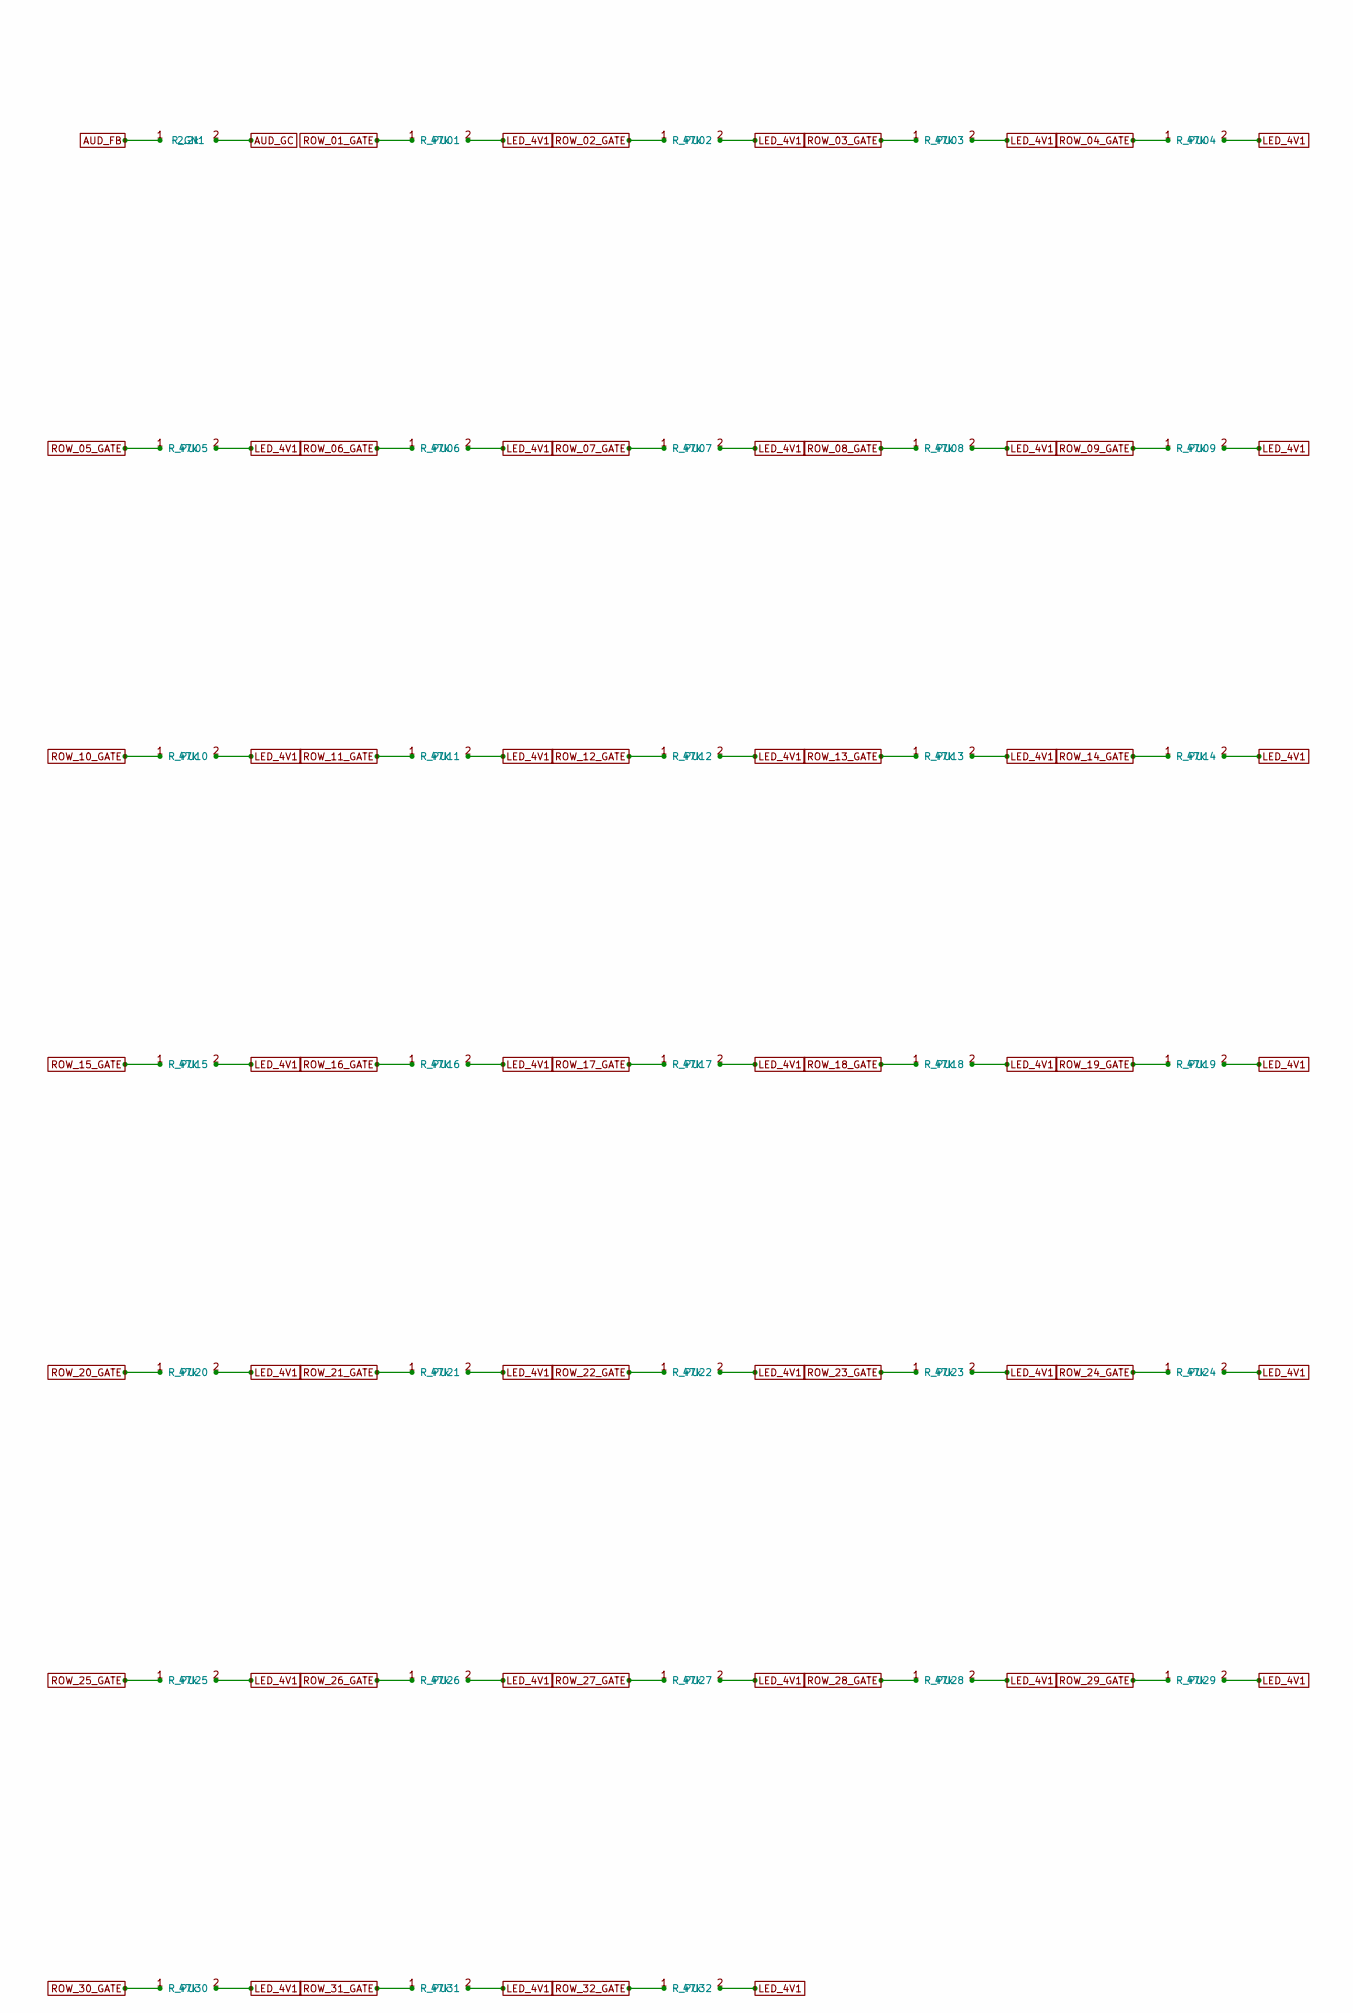
[picture p62: schematic row_farm.kicad_sch, Row farm - AO3403 x32, FFC row, part in row 3, column 1]

Parts:
J_ROW1: FFC_40P_050_ROW
Q_ROW01, Q_ROW02, Q_ROW03, Q_ROW04, Q_ROW05, Q_ROW06, Q_ROW07, Q_ROW08, Q_ROW09, Q_ROW10, Q_ROW11, Q_ROW12, Q_ROW13, Q_ROW14, Q_ROW15, Q_ROW16, Q_ROW17, Q_ROW18, Q_ROW19, Q_ROW20, Q_ROW21, Q_ROW22, Q_ROW23, Q_ROW24, Q_ROW25, Q_ROW26, Q_ROW27, Q_ROW28, Q_ROW29, Q_ROW30, Q_ROW31, Q_ROW32: AO3403; SOT-23
R_G01, R_G02, R_G03, R_G04, R_G05, R_G06, R_G07, R_G08, R_G09, R_G10, R_G11, R_G12, R_G13, R_G14, R_G15, R_G16, R_G17, R_G18, R_G19, R_G20, R_G21, R_G22, R_G23, R_G24, R_G25, R_G26, R_G27, R_G28, R_G29, R_G30, R_G31, R_G32: 33R; R_0402_1005Metric
R_GN1: 2.2k; R_0402_1005Metric
R_PU01, R_PU02, R_PU03, R_PU04, R_PU05, R_PU06, R_PU07, R_PU08, R_PU09, R_PU10, R_PU11, R_PU12, R_PU13, R_PU14, R_PU15, R_PU16, R_PU17, R_PU18, R_PU19, R_PU20, R_PU21, R_PU22, R_PU23, R_PU24, R_PU25, R_PU26, R_PU27, R_PU28, R_PU29, R_PU30, R_PU31, R_PU32: 47k; R_0402_1005Metric

Connections:
AUD_FB: R_GN1.1; also elsewhere on the board
AUD_GC: R_GN1.2; also elsewhere on the board
GND: J_ROW1.33 (GND), J_ROW1.38 (GND), J_ROW1.40 (GND); also elsewhere on the board
ID_3V3: J_ROW1.37 (ID_3V3); also elsewhere on the board
ID_SCL: J_ROW1.36 (ID_SCL); also elsewhere on the board
ID_SDA: J_ROW1.35 (ID_SDA); also elsewhere on the board
LED_4V1: Q_ROW01.2 (LED_4V1), Q_ROW02.2 (LED_4V1), Q_ROW03.2 (LED_4V1), Q_ROW04.2 (LED_4V1), Q_ROW05.2 (LED_4V1), Q_ROW06.2 (LED_4V1), Q_ROW07.2 (LED_4V1), Q_ROW08.2 (LED_4V1), Q_ROW09.2 (LED_4V1), Q_ROW10.2 (LED_4V1), Q_ROW11.2 (LED_4V1), Q_ROW12.2 (LED_4V1), Q_ROW13.2 (LED_4V1), Q_ROW14.2 (LED_4V1), Q_ROW15.2 (LED_4V1), Q_ROW16.2 (LED_4V1), Q_ROW17.2 (LED_4V1), Q_ROW18.2 (LED_4V1), Q_ROW19.2 (LED_4V1), Q_ROW20.2 (LED_4V1), Q_ROW21.2 (LED_4V1), Q_ROW22.2 (LED_4V1), Q_ROW23.2 (LED_4V1), Q_ROW24.2 (LED_4V1), Q_ROW25.2 (LED_4V1), Q_ROW26.2 (LED_4V1), Q_ROW27.2 (LED_4V1), Q_ROW28.2 (LED_4V1), Q_ROW29.2 (LED_4V1), Q_ROW30.2 (LED_4V1), Q_ROW31.2 (LED_4V1), Q_ROW32.2 (LED_4V1), R_PU01.2, R_PU02.2, R_PU03.2, R_PU04.2, R_PU05.2, R_PU06.2, R_PU07.2, R_PU08.2, R_PU09.2, R_PU10.2, R_PU11.2, R_PU12.2, R_PU13.2, R_PU14.2, R_PU15.2, R_PU16.2, R_PU17.2, R_PU18.2, R_PU19.2, R_PU20.2, R_PU21.2, R_PU22.2, R_PU23.2, R_PU24.2, R_PU25.2, R_PU26.2, R_PU27.2, R_PU28.2, R_PU29.2, R_PU30.2, R_PU31.2, R_PU32.2; also elsewhere on the board
ROW_01_ANODE: J_ROW1.1 (ROW_01_ANODE), Q_ROW01.3 (ROW_01_ANODE); also elsewhere on the board
ROW_01_GATE: Q_ROW01.1 (ROW_01_GATE), R_G01.1, R_PU01.1
ROW_01_Y: R_G01.2; also elsewhere on the board
ROW_02_ANODE: J_ROW1.2 (ROW_02_ANODE), Q_ROW02.3 (ROW_01_ANODE); also elsewhere on the board
ROW_02_GATE: Q_ROW02.1 (ROW_01_GATE), R_G02.1, R_PU02.1
ROW_02_Y: R_G02.2; also elsewhere on the board
ROW_03_ANODE: J_ROW1.3 (ROW_03_ANODE), Q_ROW03.3 (ROW_01_ANODE); also elsewhere on the board
ROW_03_GATE: Q_ROW03.1 (ROW_01_GATE), R_G03.1, R_PU03.1
ROW_03_Y: R_G03.2; also elsewhere on the board
ROW_04_ANODE: J_ROW1.4 (ROW_04_ANODE), Q_ROW04.3 (ROW_01_ANODE); also elsewhere on the board
ROW_04_GATE: Q_ROW04.1 (ROW_01_GATE), R_G04.1, R_PU04.1
ROW_04_Y: R_G04.2; also elsewhere on the board
ROW_05_ANODE: J_ROW1.5 (ROW_05_ANODE), Q_ROW05.3 (ROW_01_ANODE); also elsewhere on the board
ROW_05_GATE: Q_ROW05.1 (ROW_01_GATE), R_G05.1, R_PU05.1
ROW_05_Y: R_G05.2; also elsewhere on the board
ROW_06_ANODE: J_ROW1.6 (ROW_06_ANODE), Q_ROW06.3 (ROW_01_ANODE); also elsewhere on the board
ROW_06_GATE: Q_ROW06.1 (ROW_01_GATE), R_G06.1, R_PU06.1
ROW_06_Y: R_G06.2; also elsewhere on the board
ROW_07_ANODE: J_ROW1.7 (ROW_07_ANODE), Q_ROW07.3 (ROW_01_ANODE); also elsewhere on the board
ROW_07_GATE: Q_ROW07.1 (ROW_01_GATE), R_G07.1, R_PU07.1
ROW_07_Y: R_G07.2; also elsewhere on the board
ROW_08_ANODE: J_ROW1.8 (ROW_08_ANODE), Q_ROW08.3 (ROW_01_ANODE); also elsewhere on the board
ROW_08_GATE: Q_ROW08.1 (ROW_01_GATE), R_G08.1, R_PU08.1
ROW_08_Y: R_G08.2; also elsewhere on the board
ROW_09_ANODE: J_ROW1.9 (ROW_09_ANODE), Q_ROW09.3 (ROW_01_ANODE); also elsewhere on the board
ROW_09_GATE: Q_ROW09.1 (ROW_01_GATE), R_G09.1, R_PU09.1
ROW_09_Y: R_G09.2; also elsewhere on the board
ROW_10_ANODE: J_ROW1.10 (ROW_10_ANODE), Q_ROW10.3 (ROW_01_ANODE); also elsewhere on the board
ROW_10_GATE: Q_ROW10.1 (ROW_01_GATE), R_G10.1, R_PU10.1
ROW_10_Y: R_G10.2; also elsewhere on the board
ROW_11_ANODE: J_ROW1.11 (ROW_11_ANODE), Q_ROW11.3 (ROW_01_ANODE); also elsewhere on the board
ROW_11_GATE: Q_ROW11.1 (ROW_01_GATE), R_G11.1, R_PU11.1
ROW_11_Y: R_G11.2; also elsewhere on the board
ROW_12_ANODE: J_ROW1.12 (ROW_12_ANODE), Q_ROW12.3 (ROW_01_ANODE); also elsewhere on the board
ROW_12_GATE: Q_ROW12.1 (ROW_01_GATE), R_G12.1, R_PU12.1
ROW_12_Y: R_G12.2; also elsewhere on the board
ROW_13_ANODE: J_ROW1.13 (ROW_13_ANODE), Q_ROW13.3 (ROW_01_ANODE); also elsewhere on the board
ROW_13_GATE: Q_ROW13.1 (ROW_01_GATE), R_G13.1, R_PU13.1
ROW_13_Y: R_G13.2; also elsewhere on the board
ROW_14_ANODE: J_ROW1.14 (ROW_14_ANODE), Q_ROW14.3 (ROW_01_ANODE); also elsewhere on the board
ROW_14_GATE: Q_ROW14.1 (ROW_01_GATE), R_G14.1, R_PU14.1
ROW_14_Y: R_G14.2; also elsewhere on the board
ROW_15_ANODE: J_ROW1.15 (ROW_15_ANODE), Q_ROW15.3 (ROW_01_ANODE); also elsewhere on the board
ROW_15_GATE: Q_ROW15.1 (ROW_01_GATE), R_G15.1, R_PU15.1
ROW_15_Y: R_G15.2; also elsewhere on the board
ROW_16_ANODE: J_ROW1.16 (ROW_16_ANODE), Q_ROW16.3 (ROW_01_ANODE); also elsewhere on the board
ROW_16_GATE: Q_ROW16.1 (ROW_01_GATE), R_G16.1, R_PU16.1
ROW_16_Y: R_G16.2; also elsewhere on the board
ROW_17_ANODE: J_ROW1.17 (ROW_17_ANODE), Q_ROW17.3 (ROW_01_ANODE); also elsewhere on the board
ROW_17_GATE: Q_ROW17.1 (ROW_01_GATE), R_G17.1, R_PU17.1
ROW_17_Y: R_G17.2; also elsewhere on the board
ROW_18_ANODE: J_ROW1.18 (ROW_18_ANODE), Q_ROW18.3 (ROW_01_ANODE); also elsewhere on the board
ROW_18_GATE: Q_ROW18.1 (ROW_01_GATE), R_G18.1, R_PU18.1
ROW_18_Y: R_G18.2; also elsewhere on the board
ROW_19_ANODE: J_ROW1.19 (ROW_19_ANODE), Q_ROW19.3 (ROW_01_ANODE); also elsewhere on the board
ROW_19_GATE: Q_ROW19.1 (ROW_01_GATE), R_G19.1, R_PU19.1
ROW_19_Y: R_G19.2; also elsewhere on the board
ROW_20_ANODE: J_ROW1.20 (ROW_20_ANODE), Q_ROW20.3 (ROW_01_ANODE); also elsewhere on the board
ROW_20_GATE: Q_ROW20.1 (ROW_01_GATE), R_G20.1, R_PU20.1
ROW_20_Y: R_G20.2; also elsewhere on the board
ROW_21_ANODE: J_ROW1.21 (ROW_21_ANODE), Q_ROW21.3 (ROW_01_ANODE); also elsewhere on the board
ROW_21_GATE: Q_ROW21.1 (ROW_01_GATE), R_G21.1, R_PU21.1
ROW_21_Y: R_G21.2; also elsewhere on the board
ROW_22_ANODE: J_ROW1.22 (ROW_22_ANODE), Q_ROW22.3 (ROW_01_ANODE); also elsewhere on the board
ROW_22_GATE: Q_ROW22.1 (ROW_01_GATE), R_G22.1, R_PU22.1
ROW_22_Y: R_G22.2; also elsewhere on the board
ROW_23_ANODE: J_ROW1.23 (ROW_23_ANODE), Q_ROW23.3 (ROW_01_ANODE); also elsewhere on the board
ROW_23_GATE: Q_ROW23.1 (ROW_01_GATE), R_G23.1, R_PU23.1
ROW_23_Y: R_G23.2; also elsewhere on the board
ROW_24_ANODE: J_ROW1.24 (ROW_24_ANODE), Q_ROW24.3 (ROW_01_ANODE); also elsewhere on the board
ROW_24_GATE: Q_ROW24.1 (ROW_01_GATE), R_G24.1, R_PU24.1
ROW_24_Y: R_G24.2; also elsewhere on the board
ROW_25_ANODE: J_ROW1.25 (ROW_25_ANODE), Q_ROW25.3 (ROW_01_ANODE); also elsewhere on the board
ROW_25_GATE: Q_ROW25.1 (ROW_01_GATE), R_G25.1, R_PU25.1
ROW_25_Y: R_G25.2; also elsewhere on the board
ROW_26_ANODE: J_ROW1.26 (ROW_26_ANODE), Q_ROW26.3 (ROW_01_ANODE); also elsewhere on the board
ROW_26_GATE: Q_ROW26.1 (ROW_01_GATE), R_G26.1, R_PU26.1
ROW_26_Y: R_G26.2; also elsewhere on the board
ROW_27_ANODE: J_ROW1.27 (ROW_27_ANODE), Q_ROW27.3 (ROW_01_ANODE); also elsewhere on the board
ROW_27_GATE: Q_ROW27.1 (ROW_01_GATE), R_G27.1, R_PU27.1
ROW_27_Y: R_G27.2; also elsewhere on the board
ROW_28_ANODE: J_ROW1.28 (ROW_28_ANODE), Q_ROW28.3 (ROW_01_ANODE); also elsewhere on the board
ROW_28_GATE: Q_ROW28.1 (ROW_01_GATE), R_G28.1, R_PU28.1
ROW_28_Y: R_G28.2; also elsewhere on the board
ROW_29_ANODE: J_ROW1.29 (ROW_29_ANODE), Q_ROW29.3 (ROW_01_ANODE); also elsewhere on the board
ROW_29_GATE: Q_ROW29.1 (ROW_01_GATE), R_G29.1, R_PU29.1
ROW_29_Y: R_G29.2; also elsewhere on the board
ROW_30_ANODE: J_ROW1.30 (ROW_30_ANODE), Q_ROW30.3 (ROW_01_ANODE); also elsewhere on the board
ROW_30_GATE: Q_ROW30.1 (ROW_01_GATE), R_G30.1, R_PU30.1
ROW_30_Y: R_G30.2; also elsewhere on the board
ROW_31_ANODE: J_ROW1.31 (ROW_31_ANODE), Q_ROW31.3 (ROW_01_ANODE); also elsewhere on the board
ROW_31_GATE: Q_ROW31.1 (ROW_01_GATE), R_G31.1, R_PU31.1
ROW_31_Y: R_G31.2; also elsewhere on the board
ROW_32_ANODE: J_ROW1.32 (ROW_32_ANODE), Q_ROW32.3 (ROW_01_ANODE); also elsewhere on the board
ROW_32_GATE: Q_ROW32.1 (ROW_01_GATE), R_G32.1, R_PU32.1
ROW_32_Y: R_G32.2; also elsewhere on the board
ROW_SPARE_34: J_ROW1.34 (ROW_SPARE_34); also elsewhere on the board
ROW_SPARE_39: J_ROW1.39 (ROW_SPARE_39); also elsewhere on the board

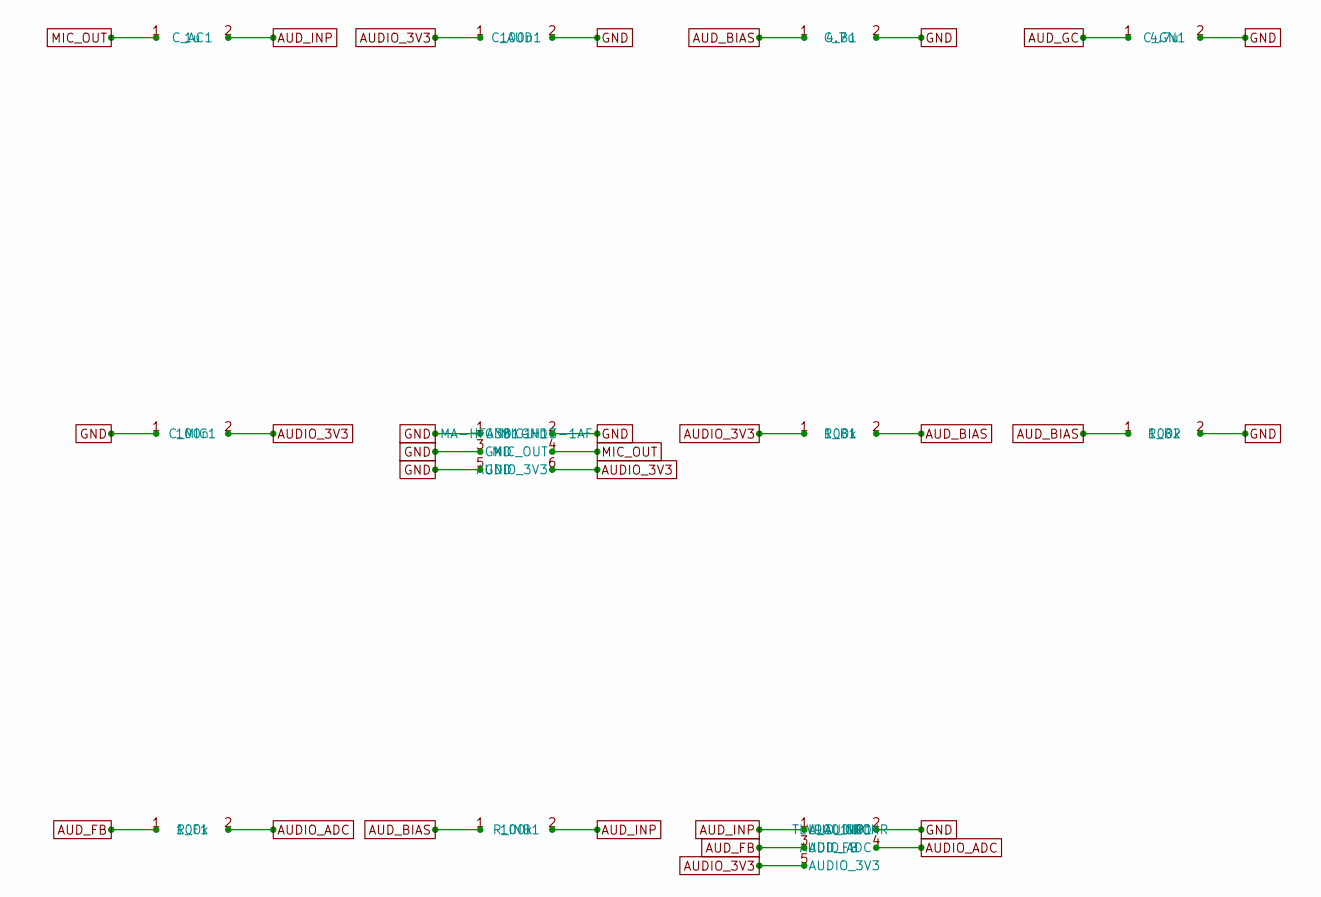
[picture p63: schematic audio.kicad_sch, Audio - microphone and op-amp]

Parts:
C_AC1: 1u; C_0402_1005Metric
C_AUD1: 100n; C_0402_1005Metric
C_B1: 4.7u; C_0402_1005Metric
C_GN1: 4.7u; C_0402_1005Metric
C_MIC1: 100n; C_0402_1005Metric
MIC1: MA-HFA381-H13-1AF; MIC_Gettop_MA-HFA381_3.5x2.65mm
R_B1, R_B2: 100k; R_0402_1005Metric
R_F1: 100k; R_0402_1005Metric_SilkTrim
R_INB1: 100k; R_0402_1005Metric
U_AUDIO1: TLV9001IDCKR; SOT-353_SC-70-5

Connections:
AUDIO_3V3: C_AUD1.1, C_MIC1.2, MIC1.6 (AUDIO_3V3), R_B1.1, U_AUDIO1.5 (AUDIO_3V3); also elsewhere on the board
AUDIO_ADC: R_F1.2, U_AUDIO1.4 (AUDIO_ADC); also elsewhere on the board
AUD_BIAS: C_B1.1, R_B1.2, R_B2.1, R_INB1.1
AUD_FB: R_F1.1, U_AUDIO1.3 (AUD_FB); also elsewhere on the board
AUD_GC: C_GN1.1; also elsewhere on the board
AUD_INP: C_AC1.2, R_INB1.2, U_AUDIO1.1 (AUD_INP)
GND: C_AUD1.2, C_B1.2, C_GN1.2, C_MIC1.1, MIC1.1 (GND), MIC1.2 (GND), MIC1.3 (GND), MIC1.5 (GND), R_B2.2, U_AUDIO1.2 (GND); also elsewhere on the board
MIC_OUT: C_AC1.1, MIC1.4 (MIC_OUT)

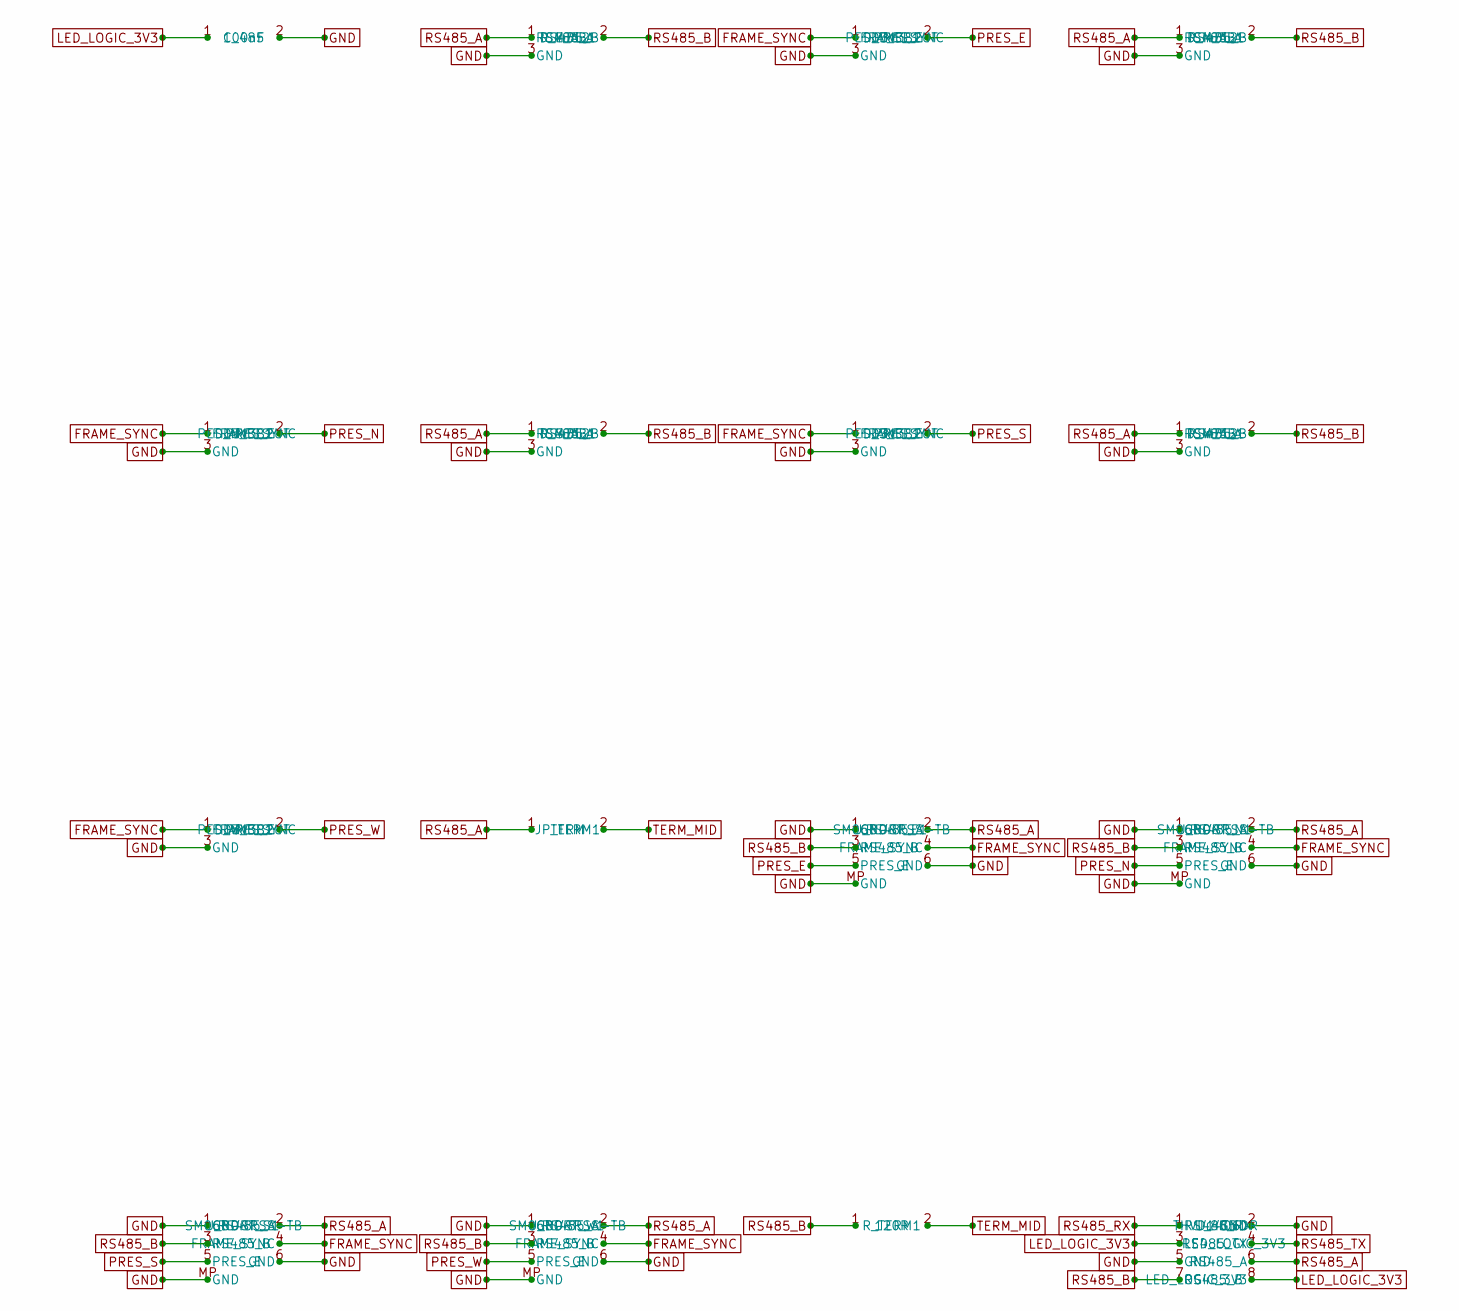
[picture p64: schematic stacking.kicad_sch, Stacking ports N/S/W/E - JST-SH 6P, RS-485 (THVD1406), ESD,…]

Parts:
C_485: 100nF; C_0402_1005Metric
D_E_AB1: SM712; SOT-23
D_E_SP1: PESD3V3S2UT; SOT-23
D_N_AB1: SM712; SOT-23
D_N_SP1: PESD3V3S2UT; SOT-23
D_S_AB1: SM712; SOT-23
D_S_SP1: PESD3V3S2UT; SOT-23
D_W_AB1: SM712; SOT-23
D_W_SP1: PESD3V3S2UT; SOT-23
JP_TERM1: TERM; SolderJumper-2_P1.3mm_Open_RoundedPad1.0x1.5mm
J_PORT_E1: SM06B-SRSS-TB; JST_SH_SM06B-SRSS-TB_1x06-1MP_P1.00mm_Horizontal
J_PORT_N1: SM06B-SRSS-TB; JST_SH_SM06B-SRSS-TB_1x06-1MP_P1.00mm_Horizontal
J_PORT_S1: SM06B-SRSS-TB; JST_SH_SM06B-SRSS-TB_1x06-1MP_P1.00mm_Horizontal
J_PORT_W1: SM06B-SRSS-TB; JST_SH_SM06B-SRSS-TB_1x06-1MP_P1.00mm_Horizontal
R_TERM1: 120R; R_0603_1608Metric
U_485: THVD1406DR; SOIC-8_3.9x4.9mm_P1.27mm

Connections:
FRAME_SYNC: D_E_SP1.1 (FRAME_SYNC), D_N_SP1.1 (FRAME_SYNC), D_S_SP1.1 (FRAME_SYNC), D_W_SP1.1 (FRAME_SYNC), J_PORT_E1.4 (FRAME_SYNC), J_PORT_N1.4 (FRAME_SYNC), J_PORT_S1.4 (FRAME_SYNC), J_PORT_W1.4 (FRAME_SYNC); also elsewhere on the board
GND: C_485.2, D_E_AB1.3 (GND), D_E_SP1.3 (GND), D_N_AB1.3 (GND), D_N_SP1.3 (GND), D_S_AB1.3 (GND), D_S_SP1.3 (GND), D_W_AB1.3 (GND), D_W_SP1.3 (GND), J_PORT_E1.1 (GND), J_PORT_E1.6 (GND), J_PORT_E1.MP (GND), J_PORT_N1.1 (GND), J_PORT_N1.6 (GND), J_PORT_N1.MP (GND), J_PORT_S1.1 (GND), J_PORT_S1.6 (GND), J_PORT_S1.MP (GND), J_PORT_W1.1 (GND), J_PORT_W1.6 (GND), J_PORT_W1.MP (GND), U_485.2 (GND), U_485.5 (GND); also elsewhere on the board
LED_LOGIC_3V3: C_485.1, U_485.3 (LED_LOGIC_3V3), U_485.8 (LED_LOGIC_3V3); also elsewhere on the board
PRES_E: D_E_SP1.2 (PRES_E), J_PORT_E1.5 (PRES_E); also elsewhere on the board
PRES_N: D_N_SP1.2 (PRES_E), J_PORT_N1.5 (PRES_E); also elsewhere on the board
PRES_S: D_S_SP1.2 (PRES_E), J_PORT_S1.5 (PRES_E); also elsewhere on the board
PRES_W: D_W_SP1.2 (PRES_E), J_PORT_W1.5 (PRES_E); also elsewhere on the board
RS485_A: D_E_AB1.1 (RS485_A), D_N_AB1.1 (RS485_A), D_S_AB1.1 (RS485_A), D_W_AB1.1 (RS485_A), JP_TERM1.1, J_PORT_E1.2 (RS485_A), J_PORT_N1.2 (RS485_A), J_PORT_S1.2 (RS485_A), J_PORT_W1.2 (RS485_A), U_485.6 (RS485_A)
RS485_B: D_E_AB1.2 (RS485_B), D_N_AB1.2 (RS485_B), D_S_AB1.2 (RS485_B), D_W_AB1.2 (RS485_B), J_PORT_E1.3 (RS485_B), J_PORT_N1.3 (RS485_B), J_PORT_S1.3 (RS485_B), J_PORT_W1.3 (RS485_B), R_TERM1.1, U_485.7 (RS485_B)
RS485_RX: U_485.1 (RS485_RX); also elsewhere on the board
RS485_TX: U_485.4 (RS485_TX); also elsewhere on the board
TERM_MID: JP_TERM1.2, R_TERM1.2

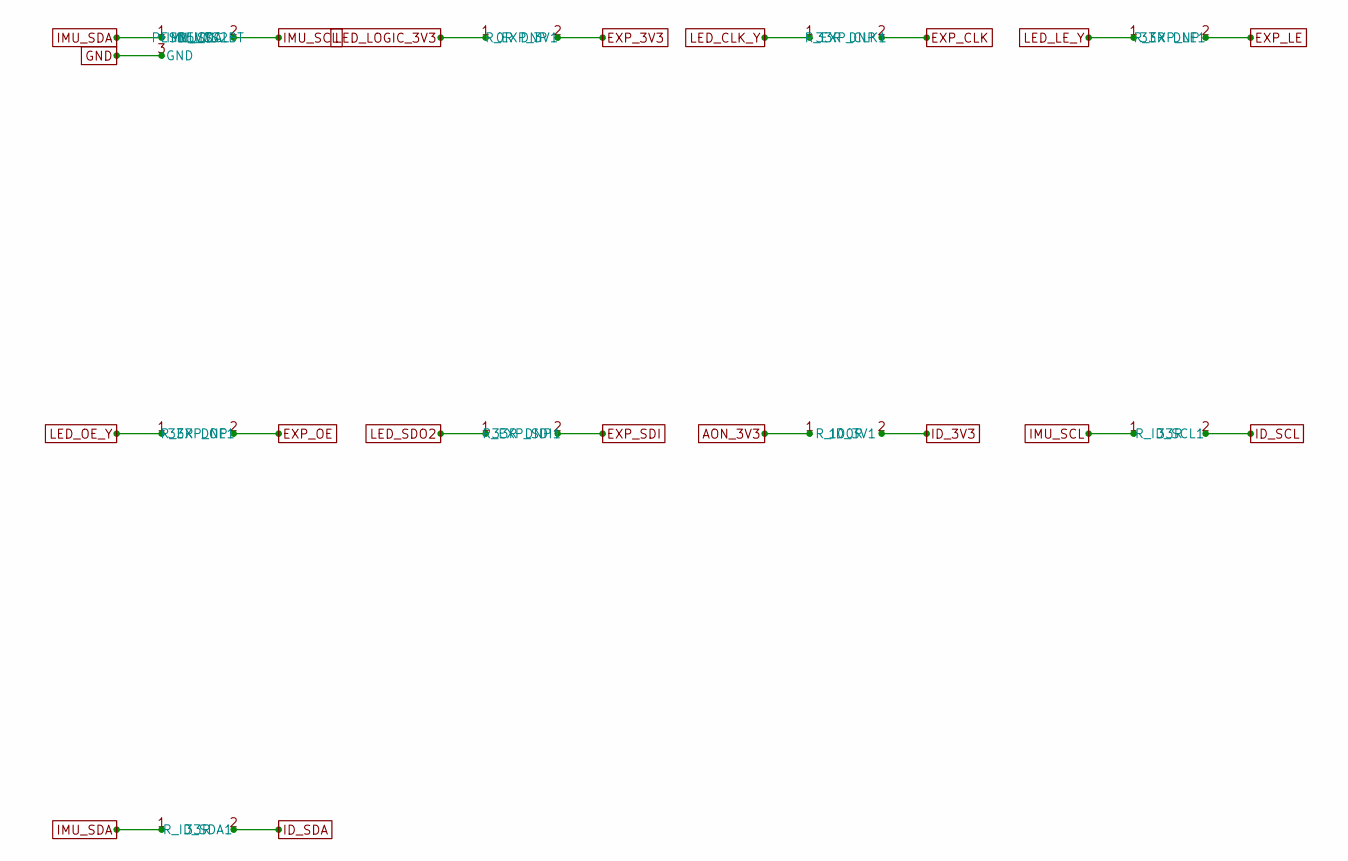
[picture p65: schematic led_interface.kicad_sch, LED interface standard v1 - FFC spares: panel ID I2C (33R/1…]

Parts:
D_ID1: PESD5V0S2BT; SOT-23
R_EXP_3V1: 0R DNP; R_0402_1005Metric; not fitted
R_EXP_CLK1: 33R DNP; R_0402_1005Metric; not fitted
R_EXP_LE1: 33R DNP; R_0402_1005Metric; not fitted
R_EXP_OE1: 33R DNP; R_0402_1005Metric; not fitted
R_EXP_SDI1: 33R DNP; R_0402_1005Metric; not fitted
R_ID_3V1: 100R; R_0402_1005Metric
R_ID_SCL1: 33R; R_0402_1005Metric
R_ID_SDA1: 33R; R_0402_1005Metric

Connections:
AON_3V3: R_ID_3V1.1; also elsewhere on the board
EXP_3V3: R_EXP_3V1.2; also elsewhere on the board
EXP_CLK: R_EXP_CLK1.2; also elsewhere on the board
EXP_LE: R_EXP_LE1.2; also elsewhere on the board
EXP_OE: R_EXP_OE1.2; also elsewhere on the board
EXP_SDI: R_EXP_SDI1.2; also elsewhere on the board
GND: D_ID1.3 (GND); also elsewhere on the board
ID_3V3: R_ID_3V1.2; also elsewhere on the board
ID_SCL: R_ID_SCL1.2; also elsewhere on the board
ID_SDA: R_ID_SDA1.2; also elsewhere on the board
IMU_SCL: D_ID1.2 (IMU_SCL), R_ID_SCL1.1; also elsewhere on the board
IMU_SDA: D_ID1.1 (IMU_SDA), R_ID_SDA1.1; also elsewhere on the board
LED_CLK_Y: R_EXP_CLK1.1; also elsewhere on the board
LED_LE_Y: R_EXP_LE1.1; also elsewhere on the board
LED_LOGIC_3V3: R_EXP_3V1.1; also elsewhere on the board
LED_OE_Y: R_EXP_OE1.1; also elsewhere on the board
LED_SDO2: R_EXP_SDI1.1; also elsewhere on the board
