illiapliukhin/led-cube-32-controller/hardware/v15_baseline/mono_electronics.kicad_pcb

## KiCad design hardware/v15_baseline/mono_electronics.kicad_pcb (continued)

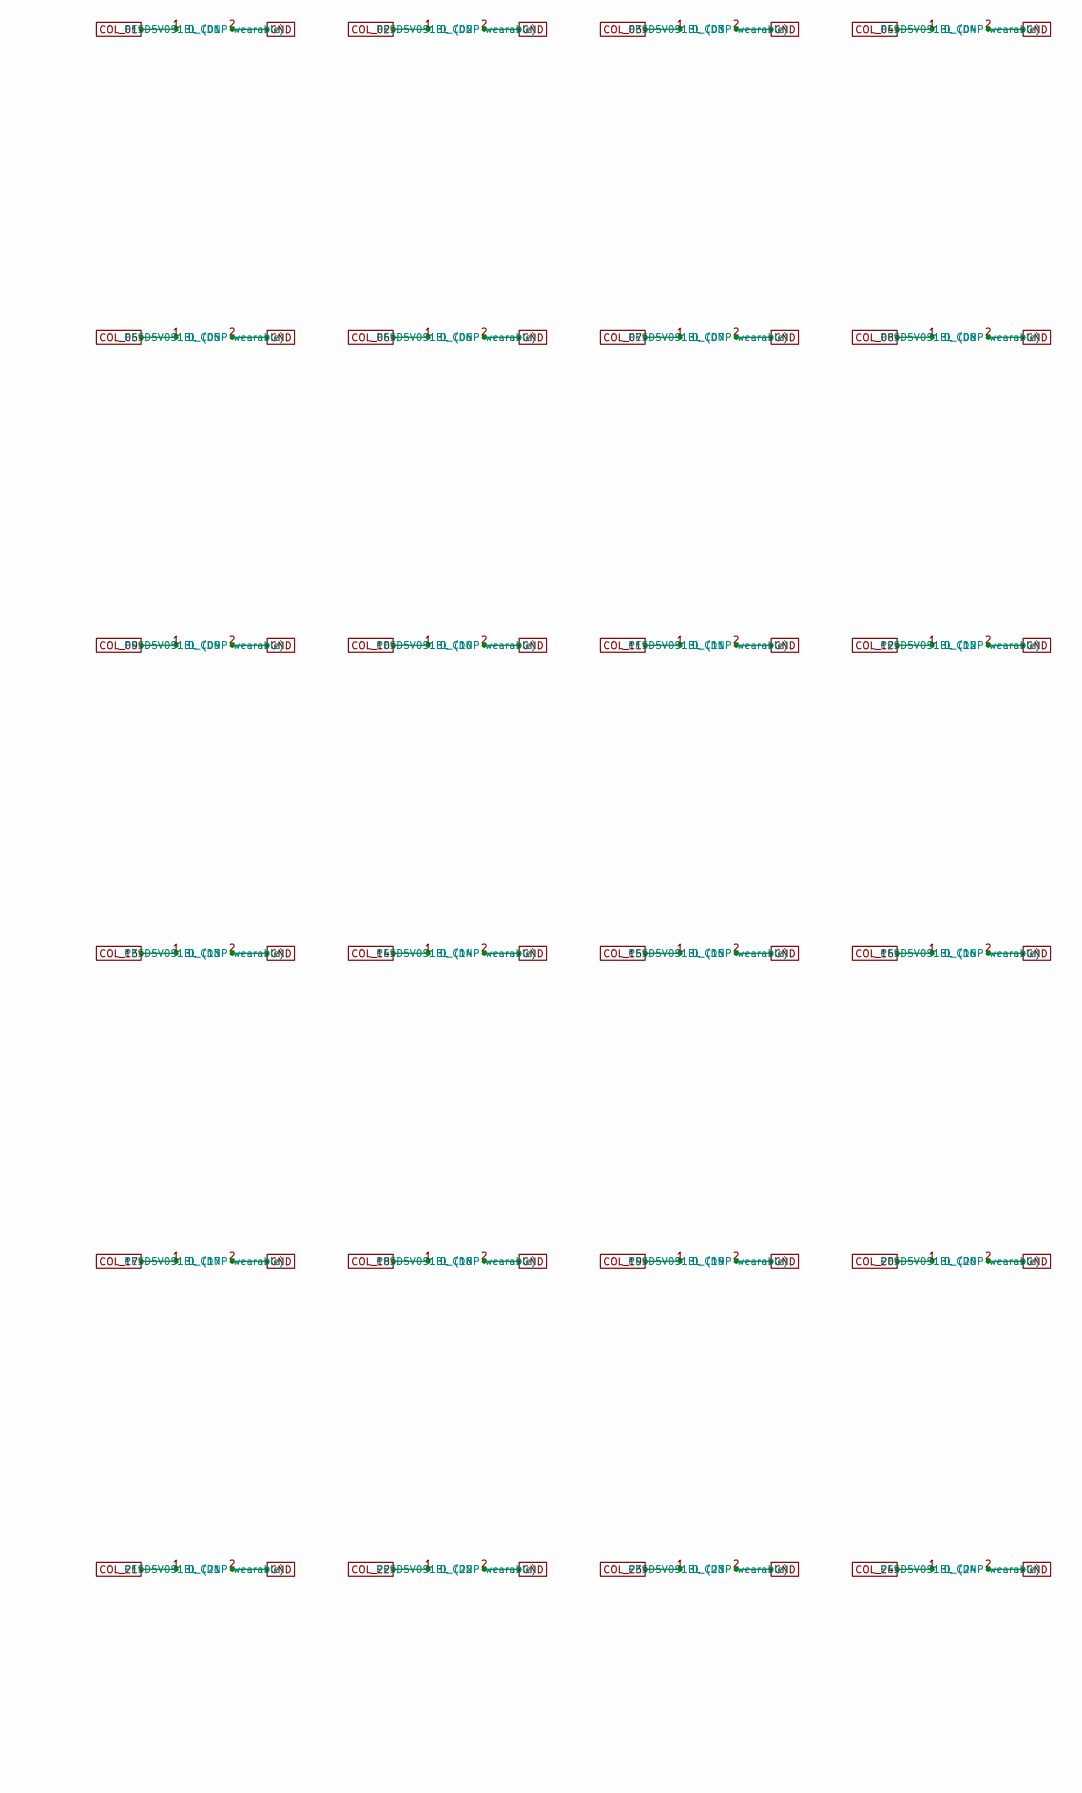
[picture p66: schematic install_headers.kicad_sch, Installation-build cable headers (v14, DNP in wearable) - J…, part in row 1, column 1]

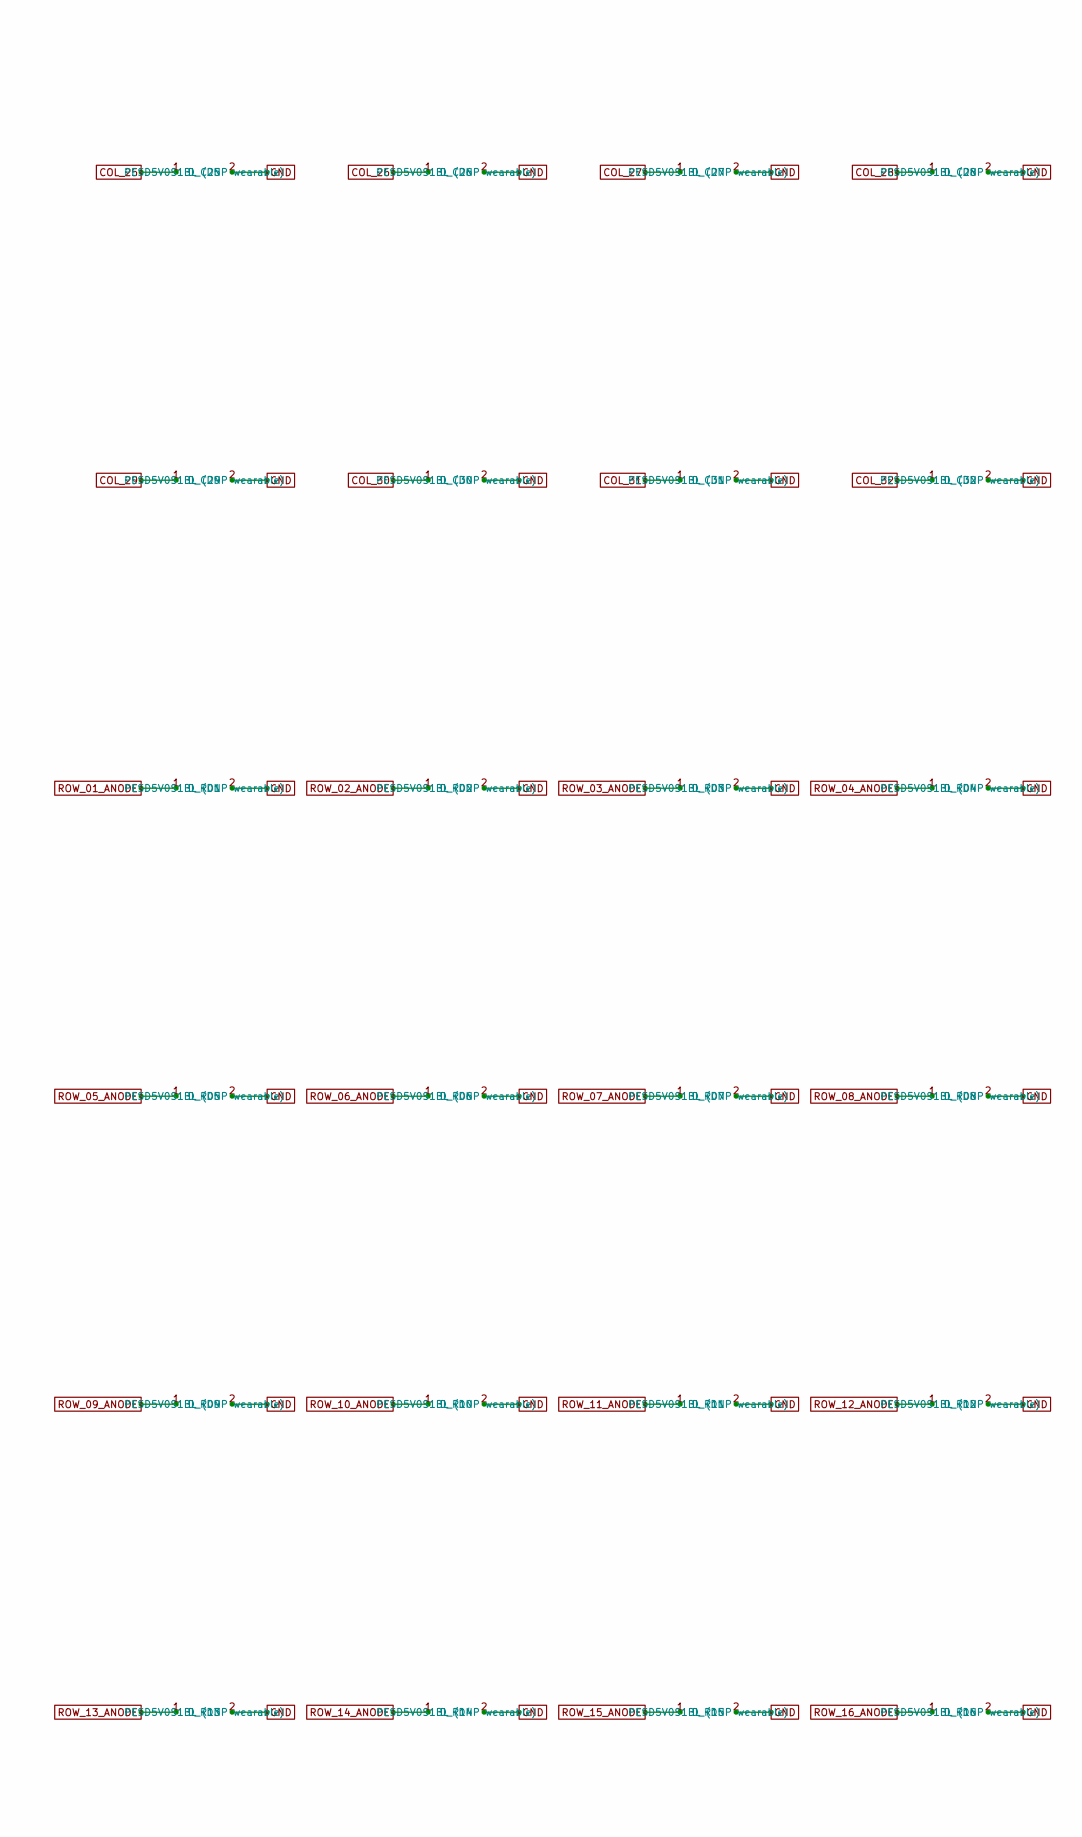
[picture p67: schematic install_headers.kicad_sch, Installation-build cable headers (v14, DNP in wearable) - J…, part in row 2, column 1]

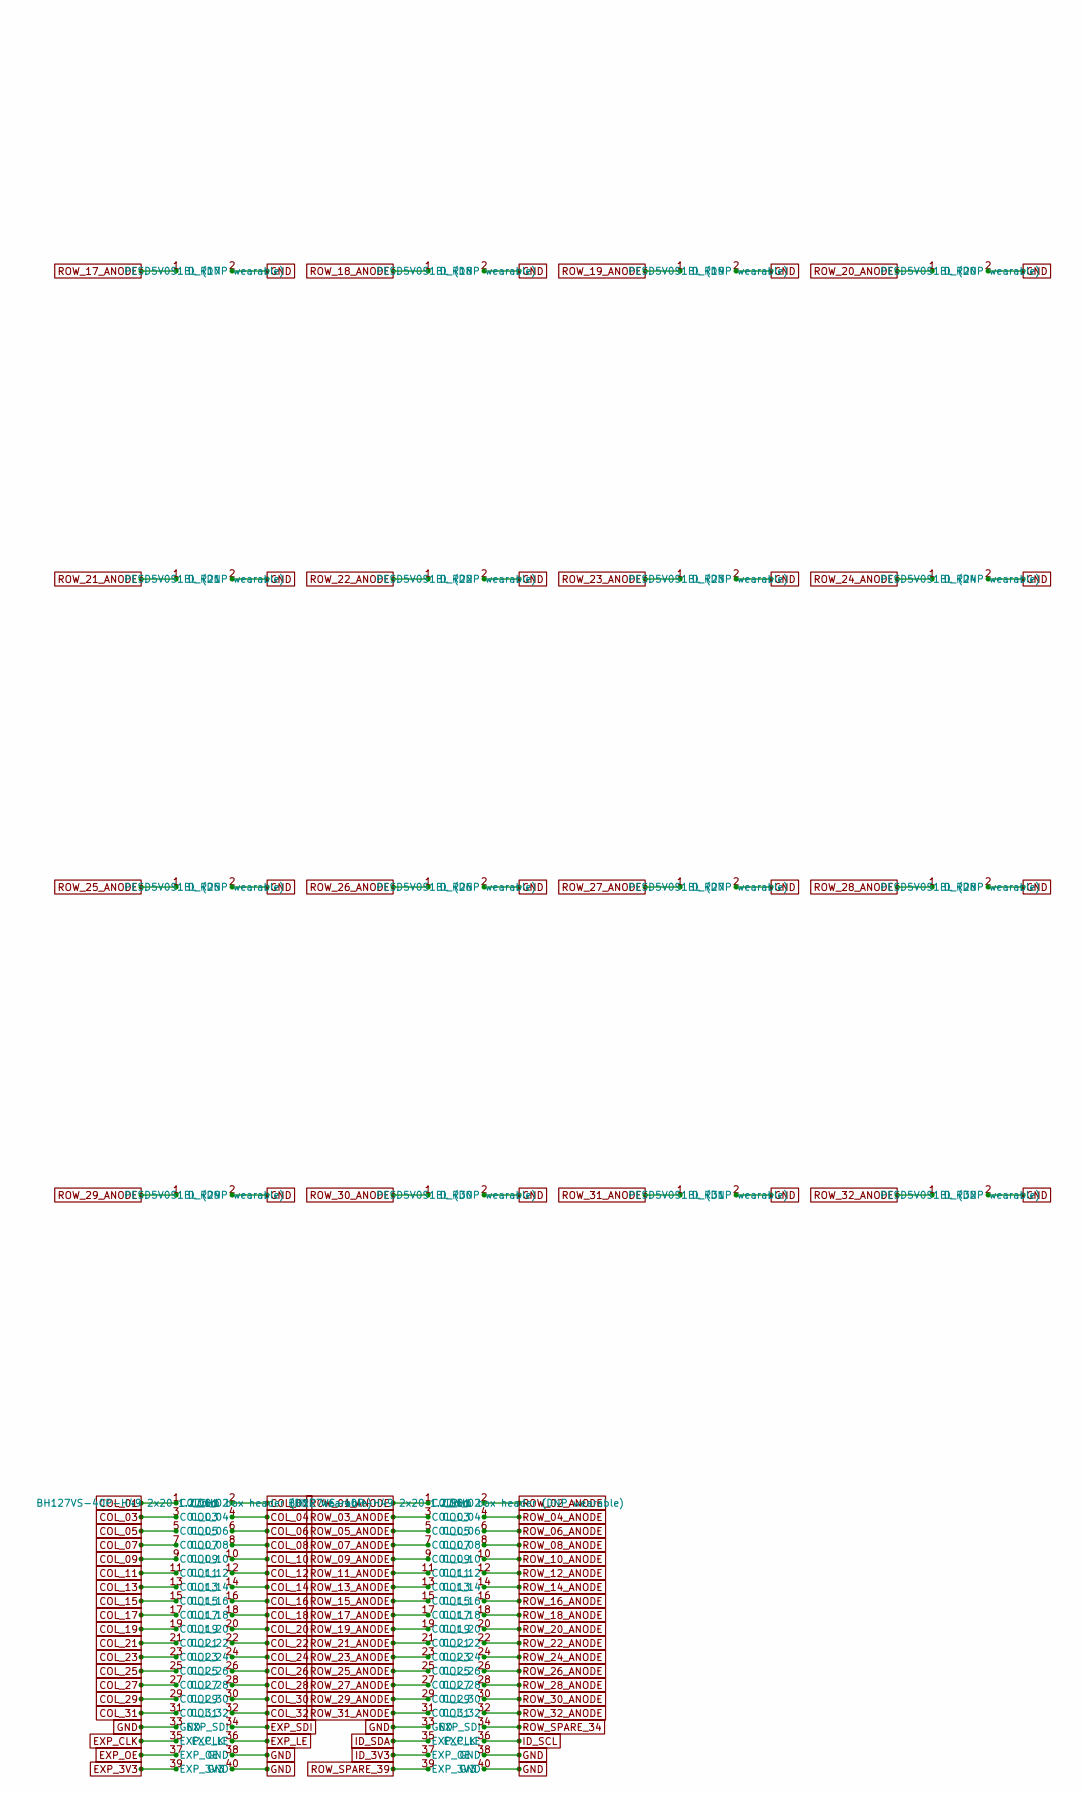
[picture p68: schematic install_headers.kicad_sch, Installation-build cable headers (v14, DNP in wearable) - J…, part in row 3, column 1]

Parts:
D_C01, D_C02, D_C03, D_C04, D_C05, D_C06, D_C07, D_C08, D_C09, D_C10, D_C11, D_C12, D_C13, D_C14, D_C15, D_C16, D_C17, D_C18, D_C19, D_C20, D_C21, D_C22, D_C23, D_C24, D_C25, D_C26, D_C27, D_C28, D_C29, D_C30, D_C31, D_C32: PESD5V0S1BL (DNP wearable); D_SOD-882; not fitted
D_R01, D_R02, D_R03, D_R04, D_R05, D_R06, D_R07, D_R08, D_R09, D_R10, D_R11, D_R12, D_R13, D_R14, D_R15, D_R16, D_R17, D_R18, D_R19, D_R20, D_R21, D_R22, D_R23, D_R24, D_R25, D_R26, D_R27, D_R28, D_R29, D_R30, D_R31, D_R32: PESD5V0S1BL (DNP wearable); D_SOD-882; not fitted
J_CH1: BH127VS-40P-H49 2x20 1.27mm box header (DNP weara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; BoxHeader_XFCN_BH127VS-40P-H49_2x20_P1.27mm_Vertical_SMD; not fitted
J_RH1: BH127VS-40P-H49 2x20 1.27mm box header (DNP weara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; BoxHeader_XFCN_BH127VS-40P-H49_2x20_P1.27mm_Vertical_SMD; not fitted

Connections:
COL_01: D_C01.1, J_CH1.1 (COL_01); also elsewhere on the board
COL_02: D_C02.1, J_CH1.2 (COL_02); also elsewhere on the board
COL_03: D_C03.1, J_CH1.3 (COL_03); also elsewhere on the board
COL_04: D_C04.1, J_CH1.4 (COL_04); also elsewhere on the board
COL_05: D_C05.1, J_CH1.5 (COL_05); also elsewhere on the board
COL_06: D_C06.1, J_CH1.6 (COL_06); also elsewhere on the board
COL_07: D_C07.1, J_CH1.7 (COL_07); also elsewhere on the board
COL_08: D_C08.1, J_CH1.8 (COL_08); also elsewhere on the board
COL_09: D_C09.1, J_CH1.9 (COL_09); also elsewhere on the board
COL_10: D_C10.1, J_CH1.10 (COL_10); also elsewhere on the board
COL_11: D_C11.1, J_CH1.11 (COL_11); also elsewhere on the board
COL_12: D_C12.1, J_CH1.12 (COL_12); also elsewhere on the board
COL_13: D_C13.1, J_CH1.13 (COL_13); also elsewhere on the board
COL_14: D_C14.1, J_CH1.14 (COL_14); also elsewhere on the board
COL_15: D_C15.1, J_CH1.15 (COL_15); also elsewhere on the board
COL_16: D_C16.1, J_CH1.16 (COL_16); also elsewhere on the board
COL_17: D_C17.1, J_CH1.17 (COL_17); also elsewhere on the board
COL_18: D_C18.1, J_CH1.18 (COL_18); also elsewhere on the board
COL_19: D_C19.1, J_CH1.19 (COL_19); also elsewhere on the board
COL_20: D_C20.1, J_CH1.20 (COL_20); also elsewhere on the board
COL_21: D_C21.1, J_CH1.21 (COL_21); also elsewhere on the board
COL_22: D_C22.1, J_CH1.22 (COL_22); also elsewhere on the board
COL_23: D_C23.1, J_CH1.23 (COL_23); also elsewhere on the board
COL_24: D_C24.1, J_CH1.24 (COL_24); also elsewhere on the board
COL_25: D_C25.1, J_CH1.25 (COL_25); also elsewhere on the board
COL_26: D_C26.1, J_CH1.26 (COL_26); also elsewhere on the board
COL_27: D_C27.1, J_CH1.27 (COL_27); also elsewhere on the board
COL_28: D_C28.1, J_CH1.28 (COL_28); also elsewhere on the board
COL_29: D_C29.1, J_CH1.29 (COL_29); also elsewhere on the board
COL_30: D_C30.1, J_CH1.30 (COL_30); also elsewhere on the board
COL_31: D_C31.1, J_CH1.31 (COL_31); also elsewhere on the board
COL_32: D_C32.1, J_CH1.32 (COL_32); also elsewhere on the board
EXP_3V3: J_CH1.39 (EXP_3V3); also elsewhere on the board
EXP_CLK: J_CH1.35 (EXP_CLK); also elsewhere on the board
EXP_LE: J_CH1.36 (EXP_LE); also elsewhere on the board
EXP_OE: J_CH1.37 (EXP_OE); also elsewhere on the board
EXP_SDI: J_CH1.34 (EXP_SDI); also elsewhere on the board
GND: D_C01.2, D_C02.2, D_C03.2, D_C04.2, D_C05.2, D_C06.2, D_C07.2, D_C08.2, D_C09.2, D_C10.2, D_C11.2, D_C12.2, D_C13.2, D_C14.2, D_C15.2, D_C16.2, D_C17.2, D_C18.2, D_C19.2, D_C20.2, D_C21.2, D_C22.2, D_C23.2, D_C24.2, D_C25.2, D_C26.2, D_C27.2, D_C28.2, D_C29.2, D_C30.2, D_C31.2, D_C32.2, D_R01.2, D_R02.2, D_R03.2, D_R04.2, D_R05.2, D_R06.2, D_R07.2, D_R08.2, D_R09.2, D_R10.2, D_R11.2, D_R12.2, D_R13.2, D_R14.2, D_R15.2, D_R16.2, D_R17.2, D_R18.2, D_R19.2, D_R20.2, D_R21.2, D_R22.2, D_R23.2, D_R24.2, D_R25.2, D_R26.2, D_R27.2, D_R28.2, D_R29.2, D_R30.2, D_R31.2, D_R32.2, J_CH1.33 (GND), J_CH1.38 (GND), J_CH1.40 (GND), J_RH1.33 (GND), J_RH1.38 (GND), J_RH1.40 (GND); also elsewhere on the board
ID_3V3: J_RH1.37 (EXP_OE); also elsewhere on the board
ID_SCL: J_RH1.36 (EXP_LE); also elsewhere on the board
ID_SDA: J_RH1.35 (EXP_CLK); also elsewhere on the board
ROW_01_ANODE: D_R01.1, J_RH1.1 (COL_01); also elsewhere on the board
ROW_02_ANODE: D_R02.1, J_RH1.2 (COL_02); also elsewhere on the board
ROW_03_ANODE: D_R03.1, J_RH1.3 (COL_03); also elsewhere on the board
ROW_04_ANODE: D_R04.1, J_RH1.4 (COL_04); also elsewhere on the board
ROW_05_ANODE: D_R05.1, J_RH1.5 (COL_05); also elsewhere on the board
ROW_06_ANODE: D_R06.1, J_RH1.6 (COL_06); also elsewhere on the board
ROW_07_ANODE: D_R07.1, J_RH1.7 (COL_07); also elsewhere on the board
ROW_08_ANODE: D_R08.1, J_RH1.8 (COL_08); also elsewhere on the board
ROW_09_ANODE: D_R09.1, J_RH1.9 (COL_09); also elsewhere on the board
ROW_10_ANODE: D_R10.1, J_RH1.10 (COL_10); also elsewhere on the board
ROW_11_ANODE: D_R11.1, J_RH1.11 (COL_11); also elsewhere on the board
ROW_12_ANODE: D_R12.1, J_RH1.12 (COL_12); also elsewhere on the board
ROW_13_ANODE: D_R13.1, J_RH1.13 (COL_13); also elsewhere on the board
ROW_14_ANODE: D_R14.1, J_RH1.14 (COL_14); also elsewhere on the board
ROW_15_ANODE: D_R15.1, J_RH1.15 (COL_15); also elsewhere on the board
ROW_16_ANODE: D_R16.1, J_RH1.16 (COL_16); also elsewhere on the board
ROW_17_ANODE: D_R17.1, J_RH1.17 (COL_17); also elsewhere on the board
ROW_18_ANODE: D_R18.1, J_RH1.18 (COL_18); also elsewhere on the board
ROW_19_ANODE: D_R19.1, J_RH1.19 (COL_19); also elsewhere on the board
ROW_20_ANODE: D_R20.1, J_RH1.20 (COL_20); also elsewhere on the board
ROW_21_ANODE: D_R21.1, J_RH1.21 (COL_21); also elsewhere on the board
ROW_22_ANODE: D_R22.1, J_RH1.22 (COL_22); also elsewhere on the board
ROW_23_ANODE: D_R23.1, J_RH1.23 (COL_23); also elsewhere on the board
ROW_24_ANODE: D_R24.1, J_RH1.24 (COL_24); also elsewhere on the board
ROW_25_ANODE: D_R25.1, J_RH1.25 (COL_25); also elsewhere on the board
ROW_26_ANODE: D_R26.1, J_RH1.26 (COL_26); also elsewhere on the board
ROW_27_ANODE: D_R27.1, J_RH1.27 (COL_27); also elsewhere on the board
ROW_28_ANODE: D_R28.1, J_RH1.28 (COL_28); also elsewhere on the board
ROW_29_ANODE: D_R29.1, J_RH1.29 (COL_29); also elsewhere on the board
ROW_30_ANODE: D_R30.1, J_RH1.30 (COL_30); also elsewhere on the board
ROW_31_ANODE: D_R31.1, J_RH1.31 (COL_31); also elsewhere on the board
ROW_32_ANODE: D_R32.1, J_RH1.32 (COL_32); also elsewhere on the board
ROW_SPARE_34: J_RH1.34 (EXP_SDI); also elsewhere on the board
ROW_SPARE_39: J_RH1.39 (EXP_3V3); also elsewhere on the board

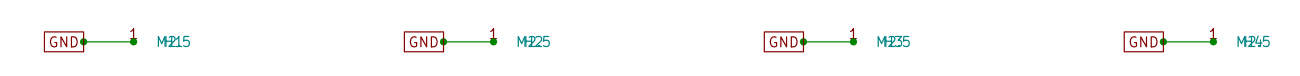
[picture p69: schematic mechanical.kicad_sch, Mechanical - M2.5 plated mounting holes (GND)]

Parts:
H1, H2, H3, H4: M2.5; MountingHole_2.7mm_M2.5_Pad

Connections:
GND: H1.1, H2.1, H3.1, H4.1; also elsewhere on the board

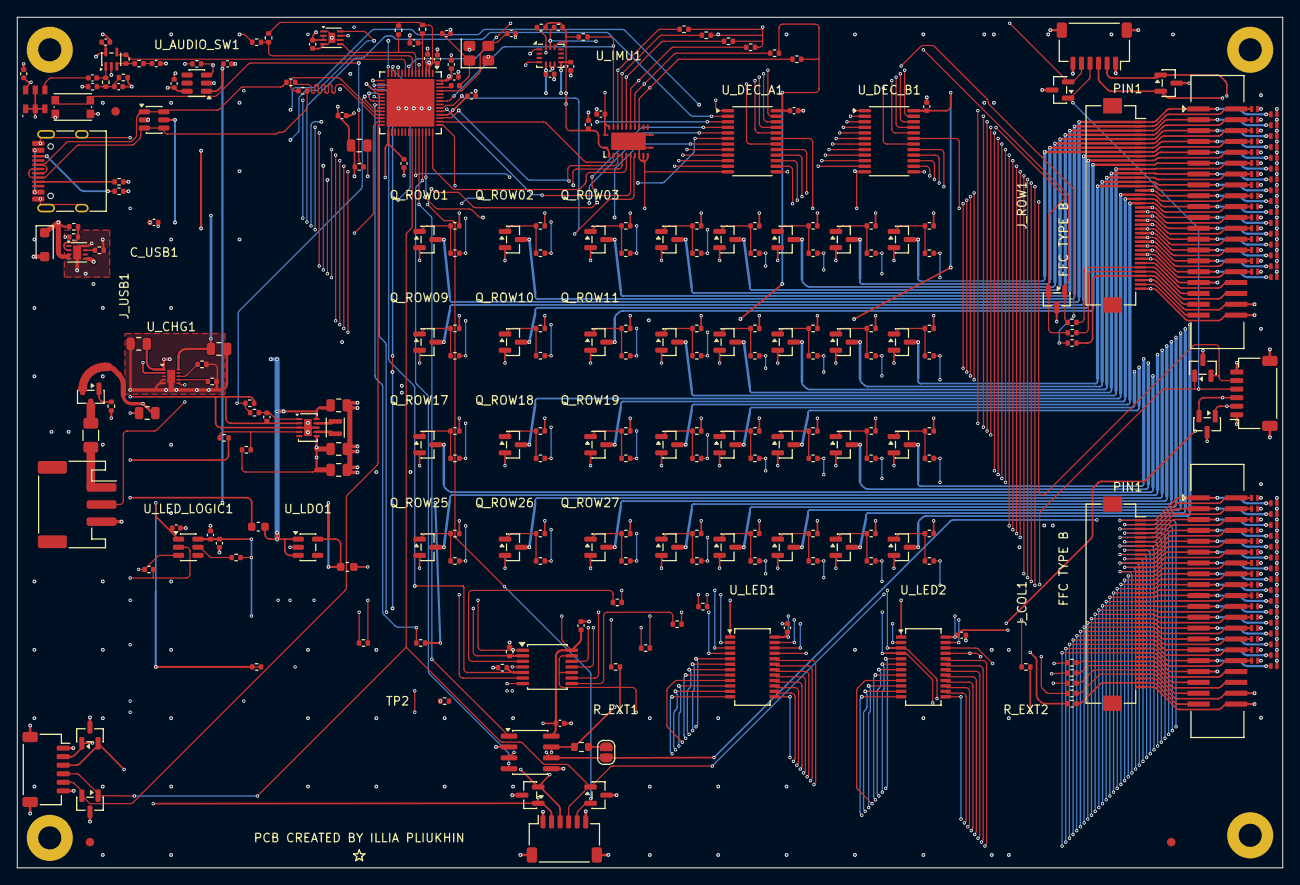
[picture p70: board mono_electronics.kicad_pcb from above]

Board: 4 copper layers, 148.0 x 99.5 mm, 312 parts (0 on the bottom side), 223 nets.

Other parts of the board:
FID1, FID2, FID3: Fiducial; Fiducial_1mm_Mask2mm
