illiapliukhin/led-cube-32-controller/hardware/strip_v1/strip48_v1/strip48_v1.kicad_sch

## KiCad design hardware/strip_v1/strip48_v1/strip48_v1.kicad_sch (2026-10-12)

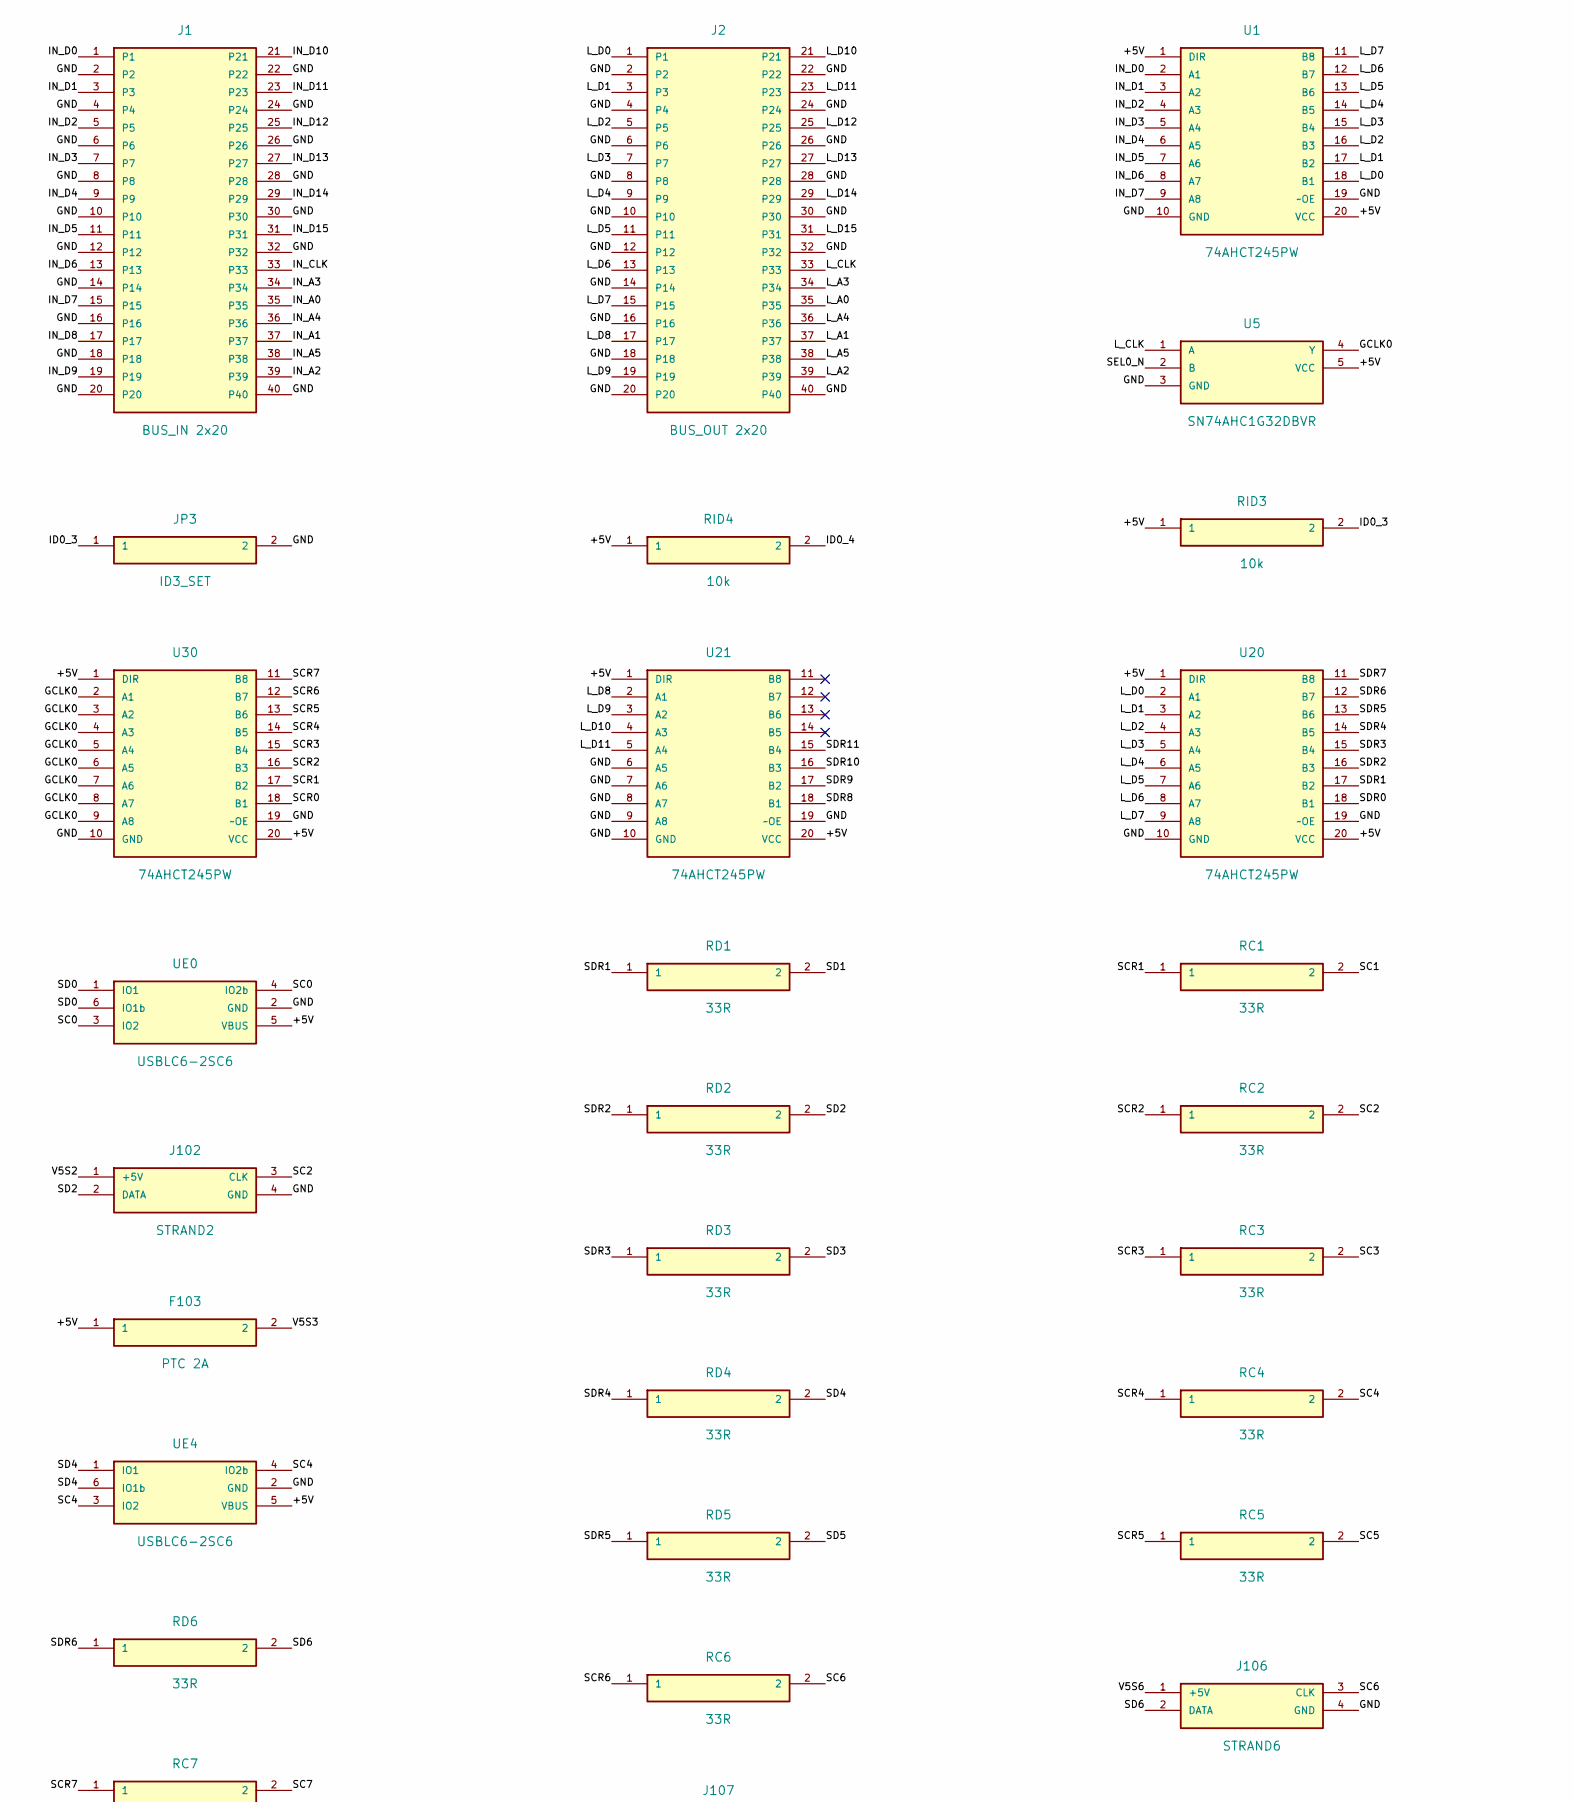
[picture p75: schematic strip48_v1.kicad_sch, part in row 1, column 1]

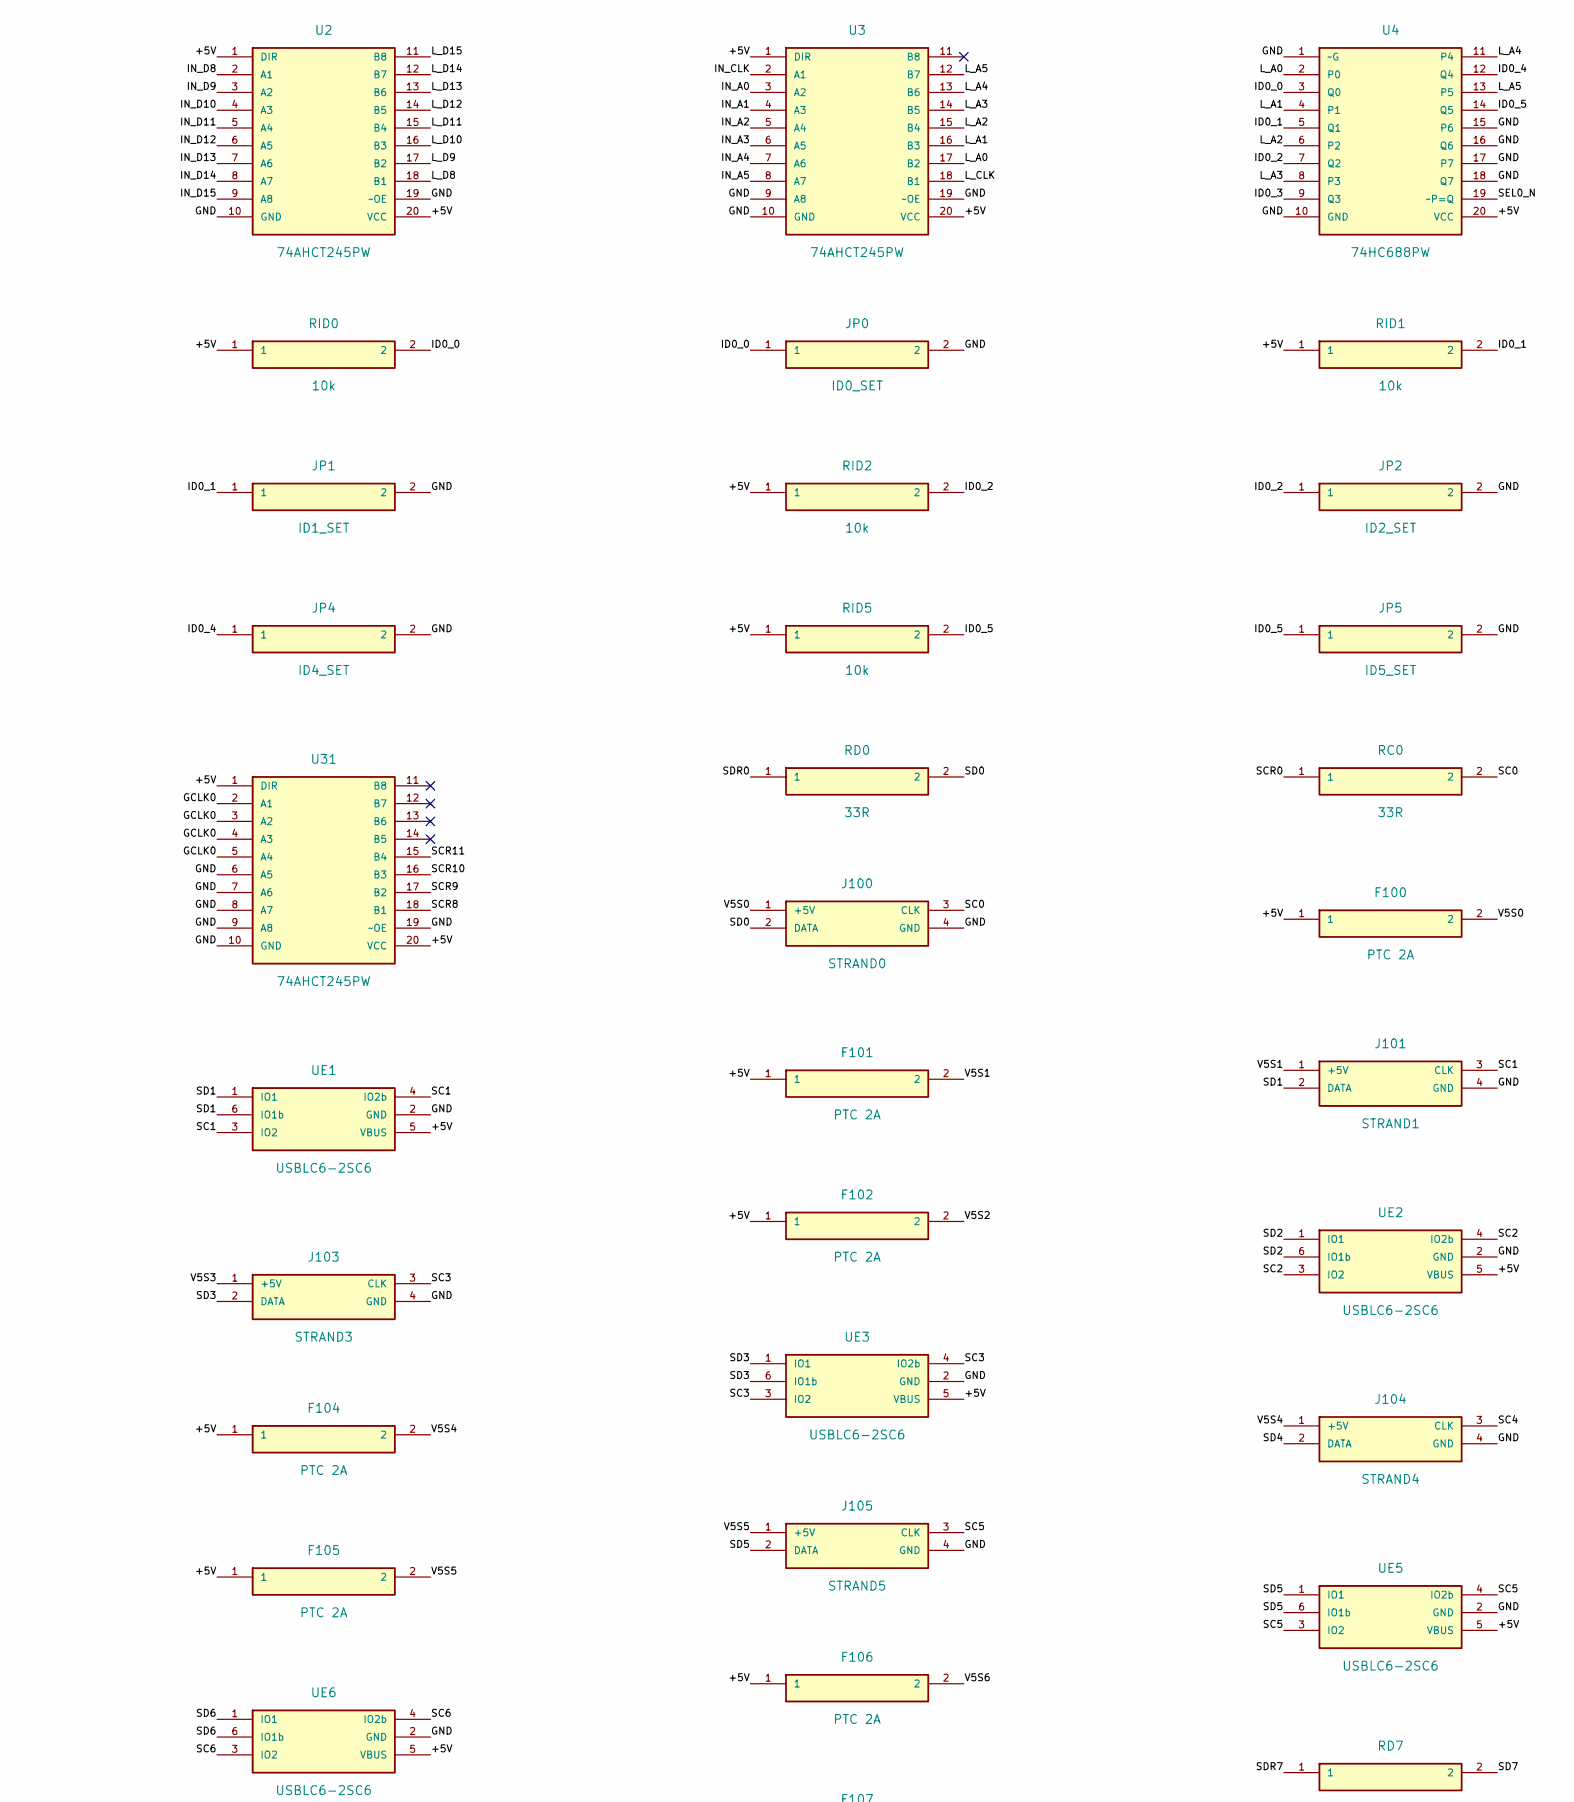
[picture p76: schematic strip48_v1.kicad_sch, part in row 1, column 2]

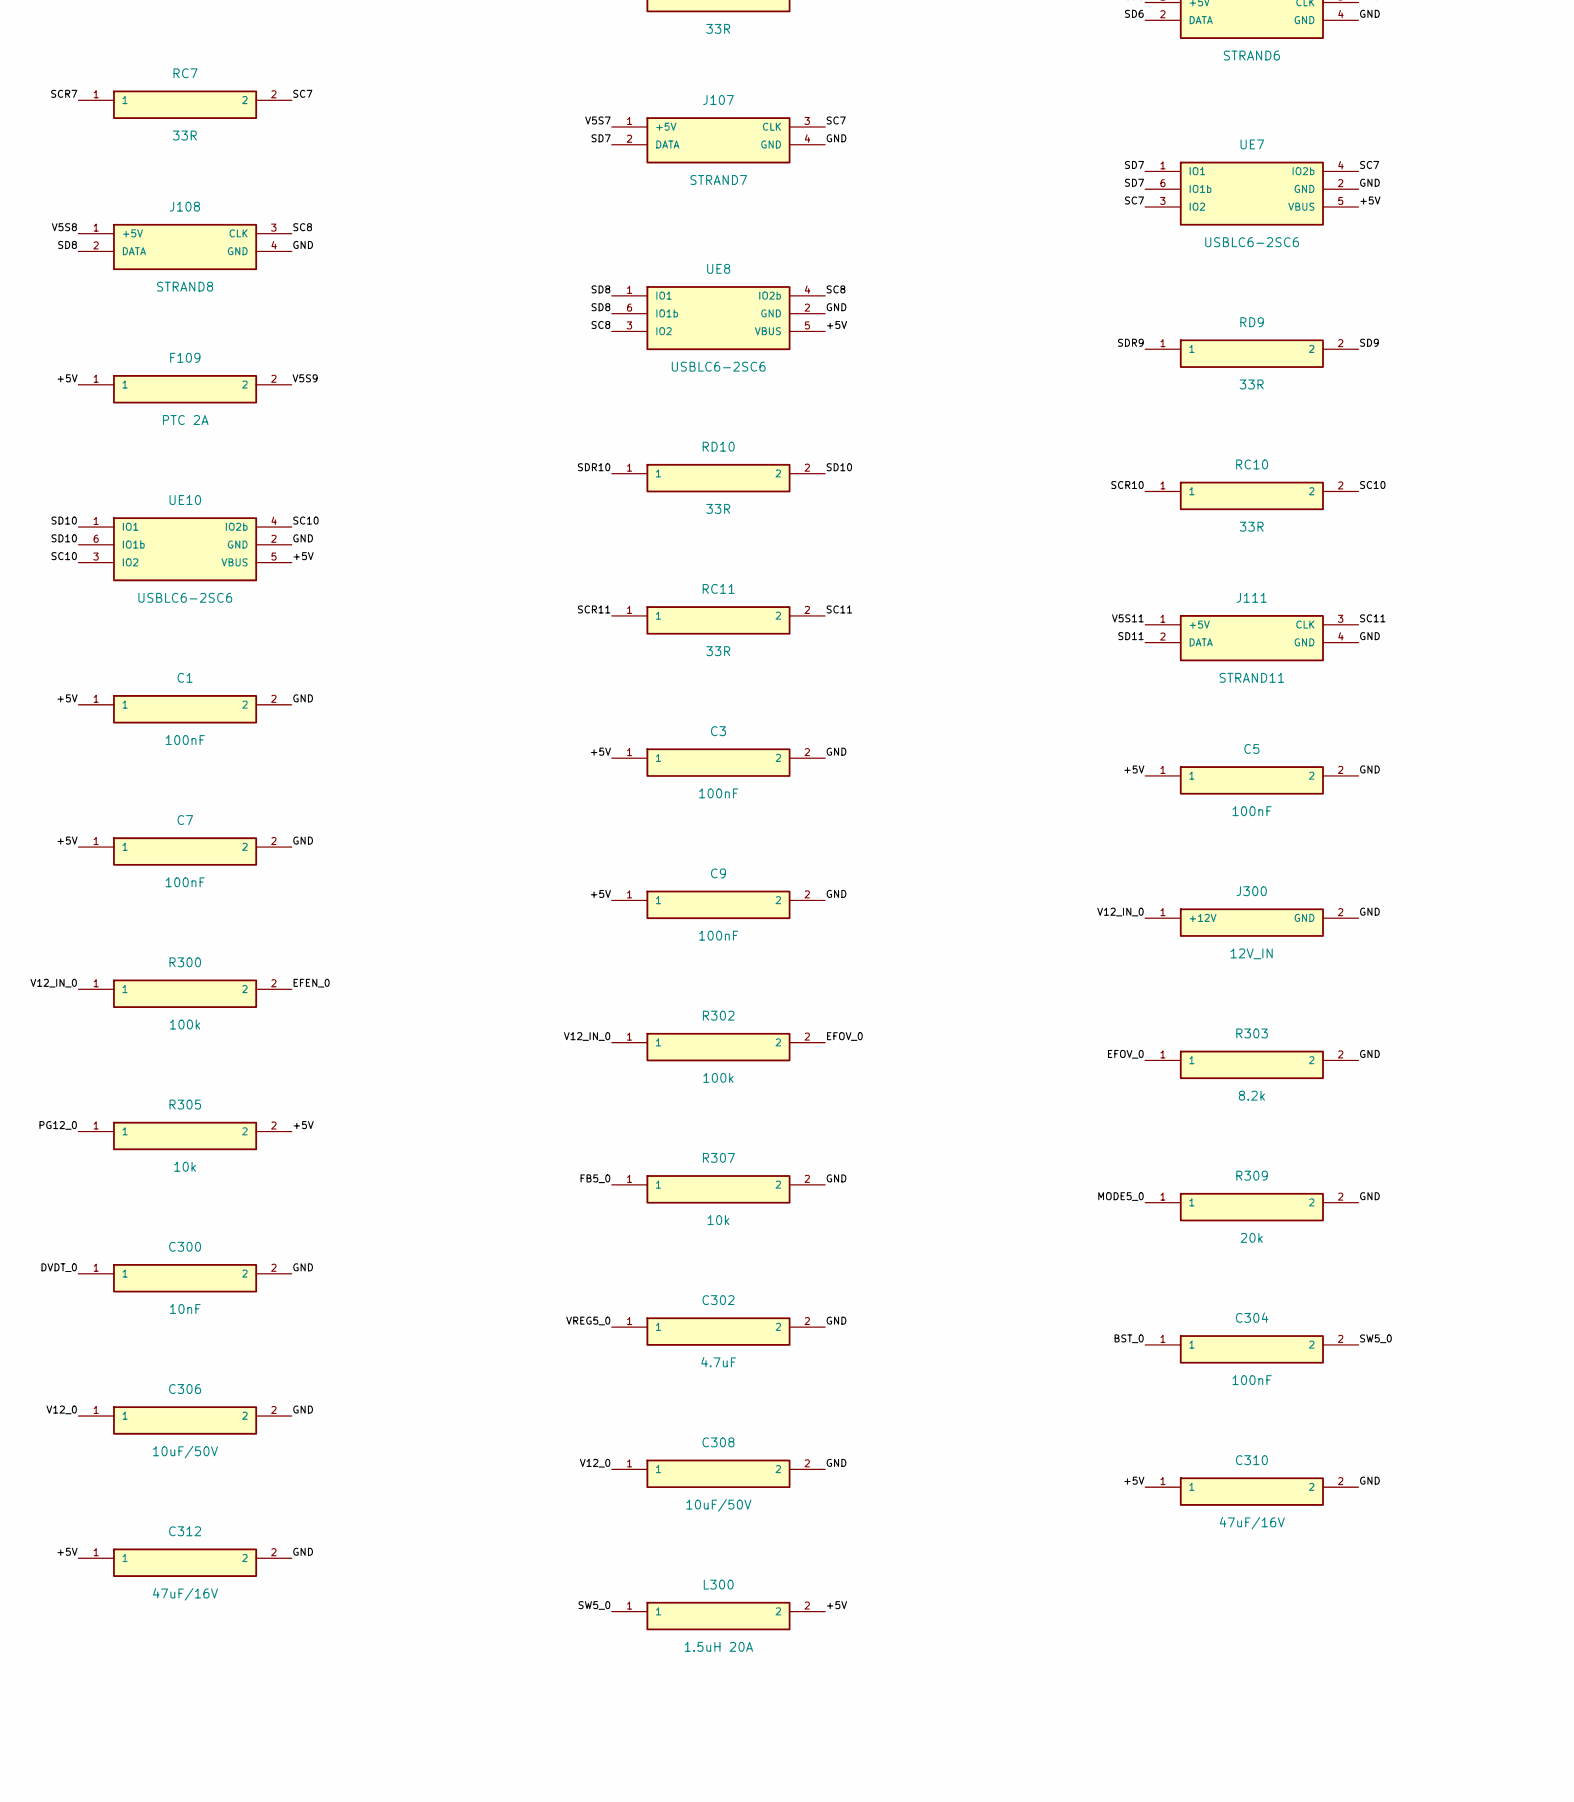
[picture p77: schematic strip48_v1.kicad_sch, part in row 2, column 1]

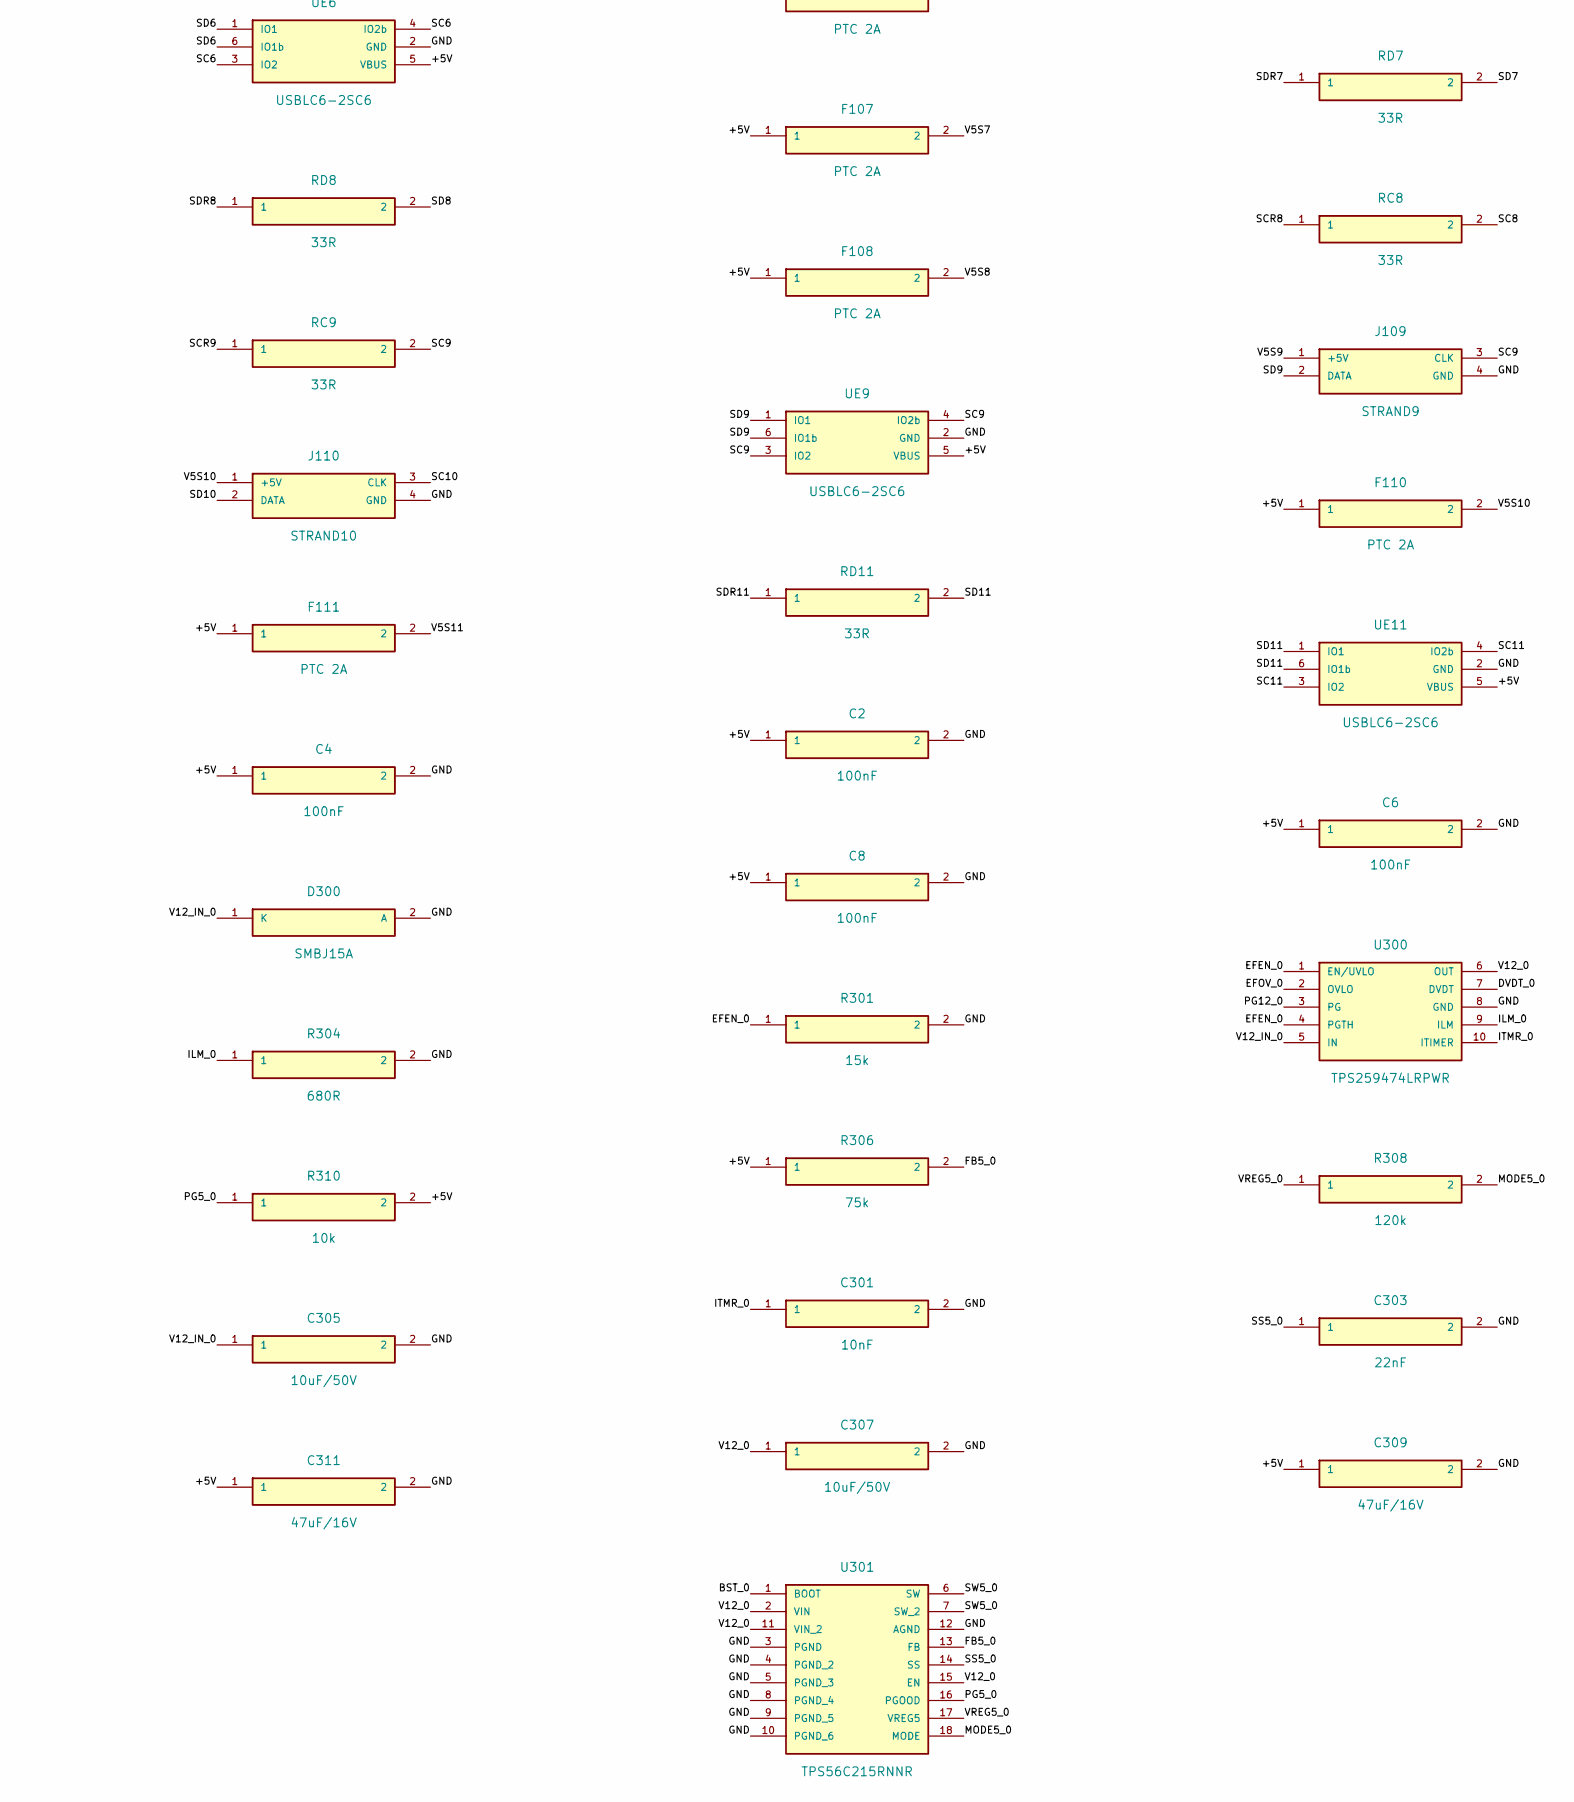
[picture p78: schematic strip48_v1.kicad_sch, part in row 2, column 2]

Parts:
C1, C2, C3, C4, C5, C6, C7, C8, C9, C304: 100nF; C_0603_1608Metric; MPN CL10B104KO8NNNC; LCSC C66501
C300, C301: 10nF; C_0603_1608Metric; MPN 0603B103K500NT; LCSC C57112
C302: 4.7uF; C_0603_1608Metric; MPN CL10A475KO8NNNC; LCSC C19666
C303: 22nF; C_0603_1608Metric; MPN CL10B223KB8NNNC; LCSC C21122
C305, C306, C307, C308: 10uF/50V; C_1206_3216Metric; MPN CL31A106KBHNNNE; LCSC C13585
C309, C310, C311, C312: 47uF/16V; C_1210_3225Metric; MPN GRM32ER61C476KE15L; LCSC C77101
D300: SMBJ15A; D_SMB; MPN SMBJ15A; LCSC C83846
F100, F101, F102, F103, F104, F105, F106, F107, F108, F109, F110, F111: PTC 2A; Fuse_1812_4532Metric; MPN SMD1812P200TF16; LCSC C20812
J1: BUS_IN 2x20; IDC-Header_2x20_P2.54mm_Vertical; MPN 2.54-2*20P; LCSC C9138
J2: BUS_OUT 2x20; IDC-Header_2x20_P2.54mm_Vertical; MPN 2.54-2*20P; LCSC C9138
J100: STRAND0; JST_XH_B4B-XH-A_1x04_P2.50mm_Vertical; MPN B4B-XH-A(LF)(SN); LCSC C144395
J101: STRAND1; JST_XH_B4B-XH-A_1x04_P2.50mm_Vertical; MPN B4B-XH-A(LF)(SN); LCSC C144395
J102: STRAND2; JST_XH_B4B-XH-A_1x04_P2.50mm_Vertical; MPN B4B-XH-A(LF)(SN); LCSC C144395
J103: STRAND3; JST_XH_B4B-XH-A_1x04_P2.50mm_Vertical; MPN B4B-XH-A(LF)(SN); LCSC C144395
J104: STRAND4; JST_XH_B4B-XH-A_1x04_P2.50mm_Vertical; MPN B4B-XH-A(LF)(SN); LCSC C144395
J105: STRAND5; JST_XH_B4B-XH-A_1x04_P2.50mm_Vertical; MPN B4B-XH-A(LF)(SN); LCSC C144395
J106: STRAND6; JST_XH_B4B-XH-A_1x04_P2.50mm_Vertical; MPN B4B-XH-A(LF)(SN); LCSC C144395
J107: STRAND7; JST_XH_B4B-XH-A_1x04_P2.50mm_Vertical; MPN B4B-XH-A(LF)(SN); LCSC C144395
J108: STRAND8; JST_XH_B4B-XH-A_1x04_P2.50mm_Vertical; MPN B4B-XH-A(LF)(SN); LCSC C144395
J109: STRAND9; JST_XH_B4B-XH-A_1x04_P2.50mm_Vertical; MPN B4B-XH-A(LF)(SN); LCSC C144395
J110: STRAND10; JST_XH_B4B-XH-A_1x04_P2.50mm_Vertical; MPN B4B-XH-A(LF)(SN); LCSC C144395
J111: STRAND11; JST_XH_B4B-XH-A_1x04_P2.50mm_Vertical; MPN B4B-XH-A(LF)(SN); LCSC C144395
J300: 12V_IN; TerminalBlock_Phoenix_MKDS-1,5-2-5.08_1x02_P5.08mm_Horizont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; MPN WJ500V-5.08-2P; LCSC C8465
JP0: ID0_SET; SolderJumper-2_P1.3mm_Open_RoundedPad1.0x1.5mm
JP1: ID1_SET; SolderJumper-2_P1.3mm_Open_RoundedPad1.0x1.5mm
JP2: ID2_SET; SolderJumper-2_P1.3mm_Open_RoundedPad1.0x1.5mm
JP3: ID3_SET; SolderJumper-2_P1.3mm_Open_RoundedPad1.0x1.5mm
JP4: ID4_SET; SolderJumper-2_P1.3mm_Open_RoundedPad1.0x1.5mm
JP5: ID5_SET; SolderJumper-2_P1.3mm_Open_RoundedPad1.0x1.5mm
L300: 1.5uH 20A; L_YJYCOIN_YSPI1365; MPN YSPI1365-1R5M; LCSC C5158939
R300, R302: 100k; R_0603_1608Metric; MPN 0603WAF1003T5E; LCSC C25803
R301: 15k; R_0603_1608Metric; MPN 0603WAF1502T5E; LCSC C22809
R303: 8.2k; R_0603_1608Metric; MPN 0603WAF8201T5E; LCSC C25981
R304: 680R; R_0603_1608Metric; MPN 0603WAF6800T5E; LCSC C23228
R305, R307, R310: 10k; R_0603_1608Metric; MPN RC0603FR-0710KL; LCSC C98220
R306: 75k; R_0603_1608Metric; MPN 0603WAF7502T5E; LCSC C23242
R308: 120k; R_0603_1608Metric; MPN 0603WAF1203T5E; LCSC C25808
R309: 20k; R_0603_1608Metric; MPN 0603WAF2002T5E; LCSC C4184
RC0, RC1, RC2, RC3, RC4, RC5, RC6, RC7, RC8, RC9, RC10, RC11: 33R; R_0603_1608Metric; MPN 0603WAF330JT5E; LCSC C23140
RD0, RD1, RD2, RD3, RD4, RD5, RD6, RD7, RD8, RD9, RD10, RD11: 33R; R_0603_1608Metric; MPN 0603WAF330JT5E; LCSC C23140
RID0, RID1, RID2, RID3, RID4, RID5: 10k; R_0603_1608Metric; MPN RC0603FR-0710KL; LCSC C98220
U1, U2, U3, U20, U21, U30, U31: 74AHCT245PW; TSSOP-20_4.4x6.5mm_P0.65mm; MPN 74AHCT245PW,118; LCSC C173388
U4: 74HC688PW; TSSOP-20_4.4x6.5mm_P0.65mm; MPN 74HC688PW,118; LCSC C547141
U5: SN74AHC1G32DBVR; SOT-23-5; MPN SN74AHC1G32DBVR; LCSC C7470
U300: TPS259474LRPWR; TI_RPW0010A_VQFN-HR-10_2x2mm_P0.45mm; MPN TPS259474LRPWR; LCSC C2864845
U301: TPS56C215RNNR; Texas_RNN0018A; MPN TPS56C215RNNR; LCSC C473372
UE0, UE1, UE2, UE3, UE4, UE5, UE6, UE7, UE8, UE9, UE10, UE11: USBLC6-2SC6; SOT-23-6; MPN USBLC6-2SC6; LCSC C2827654

Connections:
+5V: C1.1, C2.1, C3.1, C4.1, C5.1, C6.1, C7.1, C8.1, C9.1, C309.1, C310.1, C311.1, C312.1, F100.1, F101.1, F102.1, F103.1, F104.1, F105.1, F106.1, F107.1, F108.1, F109.1, F110.1, F111.1, L300.2, R305.2, R306.1, R310.2, RID0.1, RID1.1, RID2.1, RID3.1, RID4.1, RID5.1, U1.1 (DIR), U1.20 (VCC), U2.1 (DIR), U2.20 (VCC), U3.1 (DIR), U3.20 (VCC), U4.20 (VCC), U5.5 (VCC), U20.1 (DIR), U20.20 (VCC), U21.1 (DIR), U21.20 (VCC), U30.1 (DIR), U30.20 (VCC), U31.1 (DIR), U31.20 (VCC), UE0.5 (VBUS), UE1.5 (VBUS), UE2.5 (VBUS), UE3.5 (VBUS), UE4.5 (VBUS), UE5.5 (VBUS), UE6.5 (VBUS), UE7.5 (VBUS), UE8.5 (VBUS), UE9.5 (VBUS), UE10.5 (VBUS), UE11.5 (VBUS)
BST_0: C304.1, U301.1 (BOOT)
DVDT_0: C300.1, U300.7 (DVDT)
EFEN_0: R300.2, R301.1, U300.1 (EN/UVLO), U300.4 (PGTH)
EFOV_0: R302.2, R303.1, U300.2 (OVLO)
FB5_0: R306.2, R307.1, U301.13 (FB)
GCLK0: U5.4 (Y), U30.2 (A1), U30.3 (A2), U30.4 (A3), U30.5 (A4), U30.6 (A5), U30.7 (A6), U30.8 (A7), U30.9 (A8), U31.2 (A1), U31.3 (A2), U31.4 (A3), U31.5 (A4)
GND: C1.2, C2.2, C3.2, C4.2, C5.2, C6.2, C7.2, C8.2, C9.2, C300.2, C301.2, C302.2, C303.2, C305.2, C306.2, C307.2, C308.2, C309.2, C310.2, C311.2, C312.2, D300.2 (A), J1.2, J1.4, J1.6, J1.8, J1.10, J1.12, J1.14, J1.16, J1.18, J1.20, J1.22, J1.24, J1.26, J1.28, J1.30, J1.32, J1.40, J2.2, J2.4, J2.6, J2.8, J2.10, J2.12, J2.14, J2.16, J2.18, J2.20, J2.22, J2.24, J2.26, J2.28, J2.30, J2.32, J2.40, J100.4 (GND), J101.4 (GND), J102.4 (GND), J103.4 (GND), J104.4 (GND), J105.4 (GND), J106.4 (GND), J107.4 (GND), J108.4 (GND), J109.4 (GND), J110.4 (GND), J111.4 (GND), J300.2 (GND), JP0.2, JP1.2, JP2.2, JP3.2, JP4.2, JP5.2, R301.2, R303.2, R304.2, R307.2, R309.2, U1.10 (GND), U1.19 (~OE), U2.10 (GND), U2.19 (~OE), U3.9 (A8), U3.10 (GND), U3.19 (~OE), U4.1 (~G), U4.10 (GND), U4.15 (P6), U4.16 (Q6), U4.17 (P7), U4.18 (Q7), U5.3 (GND), U20.10 (GND), U20.19 (~OE), U21.6 (A5), U21.7 (A6), U21.8 (A7), U21.9 (A8), U21.10 (GND), U21.19 (~OE), U30.10 (GND), U30.19 (~OE), U31.6 (A5), U31.7 (A6), U31.8 (A7), U31.9 (A8), U31.10 (GND), U31.19 (~OE), U300.8 (GND), U301.3 (PGND), U301.4 (PGND_2), U301.5 (PGND_3), U301.8 (PGND_4), U301.9 (PGND_5), U301.10 (PGND_6), U301.12 (AGND), UE0.2 (GND), UE1.2 (GND), UE2.2 (GND), UE3.2 (GND), UE4.2 (GND), UE5.2 (GND), UE6.2 (GND), UE7.2 (GND), UE8.2 (GND), UE9.2 (GND), UE10.2 (GND), UE11.2 (GND)
ID0_0: JP0.1, RID0.2, U4.3 (Q0)
ID0_1: JP1.1, RID1.2, U4.5 (Q1)
ID0_2: JP2.1, RID2.2, U4.7 (Q2)
ID0_3: JP3.1, RID3.2, U4.9 (Q3)
ID0_4: JP4.1, RID4.2, U4.12 (Q4)
ID0_5: JP5.1, RID5.2, U4.14 (Q5)
ILM_0: R304.1, U300.9 (ILM)
IN_A0: J1.35, U3.3 (A2)
IN_A1: J1.37, U3.4 (A3)
IN_A2: J1.39, U3.5 (A4)
IN_A3: J1.34, U3.6 (A5)
IN_A4: J1.36, U3.7 (A6)
IN_A5: J1.38, U3.8 (A7)
IN_CLK: J1.33, U3.2 (A1)
IN_D0: J1.1, U1.2 (A1)
IN_D1: J1.3, U1.3 (A2)
IN_D2: J1.5, U1.4 (A3)
IN_D3: J1.7, U1.5 (A4)
IN_D4: J1.9, U1.6 (A5)
IN_D5: J1.11, U1.7 (A6)
IN_D6: J1.13, U1.8 (A7)
IN_D7: J1.15, U1.9 (A8)
IN_D8: J1.17, U2.2 (A1)
IN_D9: J1.19, U2.3 (A2)
IN_D10: J1.21, U2.4 (A3)
IN_D11: J1.23, U2.5 (A4)
IN_D12: J1.25, U2.6 (A5)
IN_D13: J1.27, U2.7 (A6)
IN_D14: J1.29, U2.8 (A7)
IN_D15: J1.31, U2.9 (A8)
ITMR_0: C301.1, U300.10 (ITIMER)
L_A0: J2.35, U3.17 (B2), U4.2 (P0)
L_A1: J2.37, U3.16 (B3), U4.4 (P1)
L_A2: J2.39, U3.15 (B4), U4.6 (P2)
L_A3: J2.34, U3.14 (B5), U4.8 (P3)
L_A4: J2.36, U3.13 (B6), U4.11 (P4)
L_A5: J2.38, U3.12 (B7), U4.13 (P5)
L_CLK: J2.33, U3.18 (B1), U5.1 (A)
L_D0: J2.1, U1.18 (B1), U20.2 (A1)
L_D1: J2.3, U1.17 (B2), U20.3 (A2)
L_D2: J2.5, U1.16 (B3), U20.4 (A3)
L_D3: J2.7, U1.15 (B4), U20.5 (A4)
L_D4: J2.9, U1.14 (B5), U20.6 (A5)
L_D5: J2.11, U1.13 (B6), U20.7 (A6)
L_D6: J2.13, U1.12 (B7), U20.8 (A7)
L_D7: J2.15, U1.11 (B8), U20.9 (A8)
L_D8: J2.17, U2.18 (B1), U21.2 (A1)
L_D9: J2.19, U2.17 (B2), U21.3 (A2)
L_D10: J2.21, U2.16 (B3), U21.4 (A3)
L_D11: J2.23, U2.15 (B4), U21.5 (A4)
L_D12: J2.25, U2.14 (B5)
L_D13: J2.27, U2.13 (B6)
L_D14: J2.29, U2.12 (B7)
L_D15: J2.31, U2.11 (B8)
MODE5_0: R308.2, R309.1, U301.18 (MODE)
PG5_0: R310.1, U301.16 (PGOOD)
PG12_0: R305.1, U300.3 (PG)
SC0: J100.3 (CLK), RC0.2, UE0.3 (IO2), UE0.4 (IO2b)
SC1: J101.3 (CLK), RC1.2, UE1.3 (IO2), UE1.4 (IO2b)
SC2: J102.3 (CLK), RC2.2, UE2.3 (IO2), UE2.4 (IO2b)
SC3: J103.3 (CLK), RC3.2, UE3.3 (IO2), UE3.4 (IO2b)
SC4: J104.3 (CLK), RC4.2, UE4.3 (IO2), UE4.4 (IO2b)
SC5: J105.3 (CLK), RC5.2, UE5.3 (IO2), UE5.4 (IO2b)
SC6: J106.3 (CLK), RC6.2, UE6.3 (IO2), UE6.4 (IO2b)
SC7: J107.3 (CLK), RC7.2, UE7.3 (IO2), UE7.4 (IO2b)
SC8: J108.3 (CLK), RC8.2, UE8.3 (IO2), UE8.4 (IO2b)
SC9: J109.3 (CLK), RC9.2, UE9.3 (IO2), UE9.4 (IO2b)
SC10: J110.3 (CLK), RC10.2, UE10.3 (IO2), UE10.4 (IO2b)
SC11: J111.3 (CLK), RC11.2, UE11.3 (IO2), UE11.4 (IO2b)
SCR0: RC0.1, U30.18 (B1)
SCR1: RC1.1, U30.17 (B2)
SCR2: RC2.1, U30.16 (B3)
SCR3: RC3.1, U30.15 (B4)
SCR4: RC4.1, U30.14 (B5)
SCR5: RC5.1, U30.13 (B6)
SCR6: RC6.1, U30.12 (B7)
SCR7: RC7.1, U30.11 (B8)
SCR8: RC8.1, U31.18 (B1)
SCR9: RC9.1, U31.17 (B2)
SCR10: RC10.1, U31.16 (B3)
SCR11: RC11.1, U31.15 (B4)
SD0: J100.2 (DATA), RD0.2, UE0.1 (IO1), UE0.6 (IO1b)
SD1: J101.2 (DATA), RD1.2, UE1.1 (IO1), UE1.6 (IO1b)
SD2: J102.2 (DATA), RD2.2, UE2.1 (IO1), UE2.6 (IO1b)
SD3: J103.2 (DATA), RD3.2, UE3.1 (IO1), UE3.6 (IO1b)
SD4: J104.2 (DATA), RD4.2, UE4.1 (IO1), UE4.6 (IO1b)
SD5: J105.2 (DATA), RD5.2, UE5.1 (IO1), UE5.6 (IO1b)
SD6: J106.2 (DATA), RD6.2, UE6.1 (IO1), UE6.6 (IO1b)
SD7: J107.2 (DATA), RD7.2, UE7.1 (IO1), UE7.6 (IO1b)
SD8: J108.2 (DATA), RD8.2, UE8.1 (IO1), UE8.6 (IO1b)
SD9: J109.2 (DATA), RD9.2, UE9.1 (IO1), UE9.6 (IO1b)
SD10: J110.2 (DATA), RD10.2, UE10.1 (IO1), UE10.6 (IO1b)
SD11: J111.2 (DATA), RD11.2, UE11.1 (IO1), UE11.6 (IO1b)
SDR0: RD0.1, U20.18 (B1)
SDR1: RD1.1, U20.17 (B2)
SDR2: RD2.1, U20.16 (B3)
SDR3: RD3.1, U20.15 (B4)
SDR4: RD4.1, U20.14 (B5)
SDR5: RD5.1, U20.13 (B6)
SDR6: RD6.1, U20.12 (B7)
SDR7: RD7.1, U20.11 (B8)
SDR8: RD8.1, U21.18 (B1)
SDR9: RD9.1, U21.17 (B2)
SDR10: RD10.1, U21.16 (B3)
SDR11: RD11.1, U21.15 (B4)
SEL0_N: U4.19 (~P=Q), U5.2 (B)
SS5_0: C303.1, U301.14 (SS)
SW5_0: C304.2, L300.1, U301.6 (SW), U301.7 (SW_2)
V5S0: F100.2, J100.1 (+5V)
V5S1: F101.2, J101.1 (+5V)
V5S2: F102.2, J102.1 (+5V)
V5S3: F103.2, J103.1 (+5V)
V5S4: F104.2, J104.1 (+5V)
V5S5: F105.2, J105.1 (+5V)
V5S6: F106.2, J106.1 (+5V)
V5S7: F107.2, J107.1 (+5V)
V5S8: F108.2, J108.1 (+5V)
V5S9: F109.2, J109.1 (+5V)
V5S10: F110.2, J110.1 (+5V)
V5S11: F111.2, J111.1 (+5V)
V12_0: C306.1, C307.1, C308.1, U300.6 (OUT), U301.2 (VIN), U301.11 (VIN_2), U301.15 (EN)
V12_IN_0: C305.1, D300.1 (K), J300.1 (+12V), R300.1, R302.1, U300.5 (IN)
VREG5_0: C302.1, R308.1, U301.17 (VREG5)
