illiapliukhin/led-cube-32-controller/hardware/strip_v1/strip124_v1/strip124_v1.kicad_sch

## KiCad design hardware/strip_v1/strip124_v1/strip124_v1.kicad_sch (2026-10-12)

Schematic: strip124_v1.kicad_sch

Parts:
C1, C2, C3, C4, C5, C6, C7, C8, C9, C10, C11, C12, C13, C14, C15, C304, C324, C344, C364, C384, C404: 100nF; C_0603_1608Metric; MPN CL10B104KO8NNNC; LCSC C66501
C300, C301, C320, C321, C340, C341, C360, C361, C380, C381, C400, C401: 10nF; C_0603_1608Metric; MPN 0603B103K500NT; LCSC C57112
C302, C322, C342, C362, C382, C402: 4.7uF; C_0603_1608Metric; MPN CL10A475KO8NNNC; LCSC C19666
C303, C323, C343, C363, C383, C403: 22nF; C_0603_1608Metric; MPN CL10B223KB8NNNC; LCSC C21122
C305, C306, C307, C308, C325, C326, C327, C328, C345, C346, C347, C348, C365, C366, C367, C368, C385, C386, C387, C388, C405, C406, C407, C408: 10uF/50V; C_1206_3216Metric; MPN CL31A106KBHNNNE; LCSC C13585
C309, C310, C311, C312, C329, C330, C331, C332, C349, C350, C351, C352, C369, C370, C371, C372, C389, C390, C391, C392, C409, C410, C411, C412: 47uF/16V; C_1210_3225Metric; MPN GRM32ER61C476KE15L; LCSC C77101
D300, D320, D340, D360, D380, D400: SMBJ15A; D_SMB; MPN SMBJ15A; LCSC C83846
F100, F101, F102, F103, F104, F105, F106, F107, F108, F109, F110, F111, F112, F113, F114, F115, F116, F117, F118, F119, F120, F121, F122, F123, F124, F125, F126, F127, F128, F129, F130: PTC 2A; Fuse_1812_4532Metric; MPN SMD1812P200TF16; LCSC C20812
J1: BUS_IN 2x20; IDC-Header_2x20_P2.54mm_Vertical; MPN 2.54-2*20P; LCSC C9138
J2: BUS_OUT 2x20; IDC-Header_2x20_P2.54mm_Vertical; MPN 2.54-2*20P; LCSC C9138
J100: STRAND0; JST_XH_B4B-XH-A_1x04_P2.50mm_Vertical; MPN B4B-XH-A(LF)(SN); LCSC C144395
J101: STRAND1; JST_XH_B4B-XH-A_1x04_P2.50mm_Vertical; MPN B4B-XH-A(LF)(SN); LCSC C144395
J102: STRAND2; JST_XH_B4B-XH-A_1x04_P2.50mm_Vertical; MPN B4B-XH-A(LF)(SN); LCSC C144395
J103: STRAND3; JST_XH_B4B-XH-A_1x04_P2.50mm_Vertical; MPN B4B-XH-A(LF)(SN); LCSC C144395
J104: STRAND4; JST_XH_B4B-XH-A_1x04_P2.50mm_Vertical; MPN B4B-XH-A(LF)(SN); LCSC C144395
J105: STRAND5; JST_XH_B4B-XH-A_1x04_P2.50mm_Vertical; MPN B4B-XH-A(LF)(SN); LCSC C144395
J106: STRAND6; JST_XH_B4B-XH-A_1x04_P2.50mm_Vertical; MPN B4B-XH-A(LF)(SN); LCSC C144395
J107: STRAND7; JST_XH_B4B-XH-A_1x04_P2.50mm_Vertical; MPN B4B-XH-A(LF)(SN); LCSC C144395
J108: STRAND8; JST_XH_B4B-XH-A_1x04_P2.50mm_Vertical; MPN B4B-XH-A(LF)(SN); LCSC C144395
J109: STRAND9; JST_XH_B4B-XH-A_1x04_P2.50mm_Vertical; MPN B4B-XH-A(LF)(SN); LCSC C144395
J110: STRAND10; JST_XH_B4B-XH-A_1x04_P2.50mm_Vertical; MPN B4B-XH-A(LF)(SN); LCSC C144395
J111: STRAND11; JST_XH_B4B-XH-A_1x04_P2.50mm_Vertical; MPN B4B-XH-A(LF)(SN); LCSC C144395
J112: STRAND12; JST_XH_B4B-XH-A_1x04_P2.50mm_Vertical; MPN B4B-XH-A(LF)(SN); LCSC C144395
J113: STRAND13; JST_XH_B4B-XH-A_1x04_P2.50mm_Vertical; MPN B4B-XH-A(LF)(SN); LCSC C144395
J114: STRAND14; JST_XH_B4B-XH-A_1x04_P2.50mm_Vertical; MPN B4B-XH-A(LF)(SN); LCSC C144395
J115: STRAND15; JST_XH_B4B-XH-A_1x04_P2.50mm_Vertical; MPN B4B-XH-A(LF)(SN); LCSC C144395
J116: STRAND16; JST_XH_B4B-XH-A_1x04_P2.50mm_Vertical; MPN B4B-XH-A(LF)(SN); LCSC C144395
J117: STRAND17; JST_XH_B4B-XH-A_1x04_P2.50mm_Vertical; MPN B4B-XH-A(LF)(SN); LCSC C144395
J118: STRAND18; JST_XH_B4B-XH-A_1x04_P2.50mm_Vertical; MPN B4B-XH-A(LF)(SN); LCSC C144395
J119: STRAND19; JST_XH_B4B-XH-A_1x04_P2.50mm_Vertical; MPN B4B-XH-A(LF)(SN); LCSC C144395
J120: STRAND20; JST_XH_B4B-XH-A_1x04_P2.50mm_Vertical; MPN B4B-XH-A(LF)(SN); LCSC C144395
J121: STRAND21; JST_XH_B4B-XH-A_1x04_P2.50mm_Vertical; MPN B4B-XH-A(LF)(SN); LCSC C144395
J122: STRAND22; JST_XH_B4B-XH-A_1x04_P2.50mm_Vertical; MPN B4B-XH-A(LF)(SN); LCSC C144395
J123: STRAND23; JST_XH_B4B-XH-A_1x04_P2.50mm_Vertical; MPN B4B-XH-A(LF)(SN); LCSC C144395
J124: STRAND24; JST_XH_B4B-XH-A_1x04_P2.50mm_Vertical; MPN B4B-XH-A(LF)(SN); LCSC C144395
J125: STRAND25; JST_XH_B4B-XH-A_1x04_P2.50mm_Vertical; MPN B4B-XH-A(LF)(SN); LCSC C144395
J126: STRAND26; JST_XH_B4B-XH-A_1x04_P2.50mm_Vertical; MPN B4B-XH-A(LF)(SN); LCSC C144395
J127: STRAND27; JST_XH_B4B-XH-A_1x04_P2.50mm_Vertical; MPN B4B-XH-A(LF)(SN); LCSC C144395
J128: STRAND28; JST_XH_B4B-XH-A_1x04_P2.50mm_Vertical; MPN B4B-XH-A(LF)(SN); LCSC C144395
J129: STRAND29; JST_XH_B4B-XH-A_1x04_P2.50mm_Vertical; MPN B4B-XH-A(LF)(SN); LCSC C144395
J130: STRAND30; JST_XH_B4B-XH-A_1x04_P2.50mm_Vertical; MPN B4B-XH-A(LF)(SN); LCSC C144395
J300, J320, J340, J360, J380, J400: 12V_IN; TerminalBlock_Phoenix_MKDS-1,5-2-5.08_1x02_P5.08mm_Horizont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; MPN WJ500V-5.08-2P; LCSC C8465
JP0, JP10: ID0_SET; SolderJumper-2_P1.3mm_Open_RoundedPad1.0x1.5mm
JP1, JP11: ID1_SET; SolderJumper-2_P1.3mm_Open_RoundedPad1.0x1.5mm
JP2, JP12: ID2_SET; SolderJumper-2_P1.3mm_Open_RoundedPad1.0x1.5mm
JP3, JP13: ID3_SET; SolderJumper-2_P1.3mm_Open_RoundedPad1.0x1.5mm
JP4, JP14: ID4_SET; SolderJumper-2_P1.3mm_Open_RoundedPad1.0x1.5mm
JP5, JP15: ID5_SET; SolderJumper-2_P1.3mm_Open_RoundedPad1.0x1.5mm
L300, L320, L340, L360, L380, L400: 1.5uH 20A; L_YJYCOIN_YSPI1365; MPN YSPI1365-1R5M; LCSC C5158939
R300, R302, R320, R322, R340, R342, R360, R362, R380, R382, R400, R402: 100k; R_0603_1608Metric; MPN 0603WAF1003T5E; LCSC C25803
R301, R321, R341, R361, R381, R401: 15k; R_0603_1608Metric; MPN 0603WAF1502T5E; LCSC C22809
R303, R323, R343, R363, R383, R403: 8.2k; R_0603_1608Metric; MPN 0603WAF8201T5E; LCSC C25981
R304, R324, R344, R364, R384, R404: 680R; R_0603_1608Metric; MPN 0603WAF6800T5E; LCSC C23228
R305, R307, R310, R325, R327, R330, R345, R347, R350, R365, R367, R370, R385, R387, R390, R405, R407, R410: 10k; R_0603_1608Metric; MPN RC0603FR-0710KL; LCSC C98220
R306, R326, R346, R366, R386, R406: 75k; R_0603_1608Metric; MPN 0603WAF7502T5E; LCSC C23242
R308, R328, R348, R368, R388, R408: 120k; R_0603_1608Metric; MPN 0603WAF1203T5E; LCSC C25808
R309, R329, R349, R369, R389, R409: 20k; R_0603_1608Metric; MPN 0603WAF2002T5E; LCSC C4184
RC0, RC1, RC2, RC3, RC4, RC5, RC6, RC7, RC8, RC9, RC10, RC11, RC12, RC13, RC14, RC15, RC16, RC17, RC18, RC19, RC20, RC21, RC22, RC23, RC24, RC25, RC26, RC27, RC28, RC29, RC30: 33R; R_0603_1608Metric; MPN 0603WAF330JT5E; LCSC C23140
RD0, RD1, RD2, RD3, RD4, RD5, RD6, RD7, RD8, RD9, RD10, RD11, RD12, RD13, RD14, RD15, RD16, RD17, RD18, RD19, RD20, RD21, RD22, RD23, RD24, RD25, RD26, RD27, RD28, RD29, RD30: 33R; R_0603_1608Metric; MPN 0603WAF330JT5E; LCSC C23140
RID0, RID1, RID2, RID3, RID4, RID5, RID10, RID11, RID12, RID13, RID14, RID15: 10k; R_0603_1608Metric; MPN RC0603FR-0710KL; LCSC C98220
U1, U2, U3, U20, U21, U22, U23, U30, U31, U32, U33: 74AHCT245PW; TSSOP-20_4.4x6.5mm_P0.65mm; MPN 74AHCT245PW,118; LCSC C173388
U4, U6: 74HC688PW; TSSOP-20_4.4x6.5mm_P0.65mm; MPN 74HC688PW,118; LCSC C547141
U5, U7: SN74AHC1G32DBVR; SOT-23-5; MPN SN74AHC1G32DBVR; LCSC C7470
U300, U320, U340, U360, U380, U400: TPS259474LRPWR; TI_RPW0010A_VQFN-HR-10_2x2mm_P0.45mm; MPN TPS259474LRPWR; LCSC C2864845
U301, U321, U341, U361, U381, U401: TPS56C215RNNR; Texas_RNN0018A; MPN TPS56C215RNNR; LCSC C473372
UE0, UE1, UE2, UE3, UE4, UE5, UE6, UE7, UE8, UE9, UE10, UE11, UE12, UE13, UE14, UE15, UE16, UE17, UE18, UE19, UE20, UE21, UE22, UE23, UE24, UE25, UE26, UE27, UE28, UE29, UE30: USBLC6-2SC6; SOT-23-6; MPN USBLC6-2SC6; LCSC C2827654

Connections:
+5V: C1.1, C2.1, C3.1, C4.1, C5.1, C6.1, C7.1, C8.1, C9.1, C10.1, C11.1, C12.1, C13.1, C14.1, C15.1, C309.1, C310.1, C311.1, C312.1, F100.1, F101.1, F102.1, F103.1, F104.1, F105.1, L300.2, R305.2, R306.1, R310.2, RID0.1, RID1.1, RID2.1, RID3.1, RID4.1, RID5.1, RID10.1, RID11.1, RID12.1, RID13.1, RID14.1, RID15.1, U1.1 (DIR), U1.20 (VCC), U2.1 (DIR), U2.20 (VCC), U3.1 (DIR), U3.20 (VCC), U4.20 (VCC), U5.5 (VCC), U6.20 (VCC), U7.5 (VCC), U20.1 (DIR), U20.20 (VCC), U21.1 (DIR), U21.20 (VCC), U22.1 (DIR), U22.20 (VCC), U23.1 (DIR), U23.20 (VCC), U30.1 (DIR), U30.20 (VCC), U31.1 (DIR), U31.20 (VCC), U32.1 (DIR), U32.20 (VCC), U33.1 (DIR), U33.20 (VCC), UE0.5 (VBUS), UE1.5 (VBUS), UE2.5 (VBUS), UE3.5 (VBUS), UE4.5 (VBUS), UE5.5 (VBUS)
+5V_1: C329.1, C330.1, C331.1, C332.1, F106.1, F107.1, F108.1, F109.1, F110.1, L320.2, R325.2, R326.1, R330.2, UE6.5 (VBUS), UE7.5 (VBUS), UE8.5 (VBUS), UE9.5 (VBUS), UE10.5 (VBUS)
+5V_2: C349.1, C350.1, C351.1, C352.1, F111.1, F112.1, F113.1, F114.1, F115.1, L340.2, R345.2, R346.1, R350.2, UE11.5 (VBUS), UE12.5 (VBUS), UE13.5 (VBUS), UE14.5 (VBUS), UE15.5 (VBUS)
+5V_3: C369.1, C370.1, C371.1, C372.1, F116.1, F117.1, F118.1, F119.1, F120.1, L360.2, R365.2, R366.1, R370.2, UE16.5 (VBUS), UE17.5 (VBUS), UE18.5 (VBUS), UE19.5 (VBUS), UE20.5 (VBUS)
+5V_4: C389.1, C390.1, C391.1, C392.1, F121.1, F122.1, F123.1, F124.1, F125.1, L380.2, R385.2, R386.1, R390.2, UE21.5 (VBUS), UE22.5 (VBUS), UE23.5 (VBUS), UE24.5 (VBUS), UE25.5 (VBUS)
+5V_5: C409.1, C410.1, C411.1, C412.1, F126.1, F127.1, F128.1, F129.1, F130.1, L400.2, R405.2, R406.1, R410.2, UE26.5 (VBUS), UE27.5 (VBUS), UE28.5 (VBUS), UE29.5 (VBUS), UE30.5 (VBUS)
BST_0: C304.1, U301.1 (BOOT)
BST_1: C324.1, U321.1 (BOOT)
BST_2: C344.1, U341.1 (BOOT)
BST_3: C364.1, U361.1 (BOOT)
BST_4: C384.1, U381.1 (BOOT)
BST_5: C404.1, U401.1 (BOOT)
DVDT_0: C300.1, U300.7 (DVDT)
DVDT_1: C320.1, U320.7 (DVDT)
DVDT_2: C340.1, U340.7 (DVDT)
DVDT_3: C360.1, U360.7 (DVDT)
DVDT_4: C380.1, U380.7 (DVDT)
DVDT_5: C400.1, U400.7 (DVDT)
EFEN_0: R300.2, R301.1, U300.1 (EN/UVLO), U300.4 (PGTH)
EFEN_1: R320.2, R321.1, U320.1 (EN/UVLO), U320.4 (PGTH)
EFEN_2: R340.2, R341.1, U340.1 (EN/UVLO), U340.4 (PGTH)
EFEN_3: R360.2, R361.1, U360.1 (EN/UVLO), U360.4 (PGTH)
EFEN_4: R380.2, R381.1, U380.1 (EN/UVLO), U380.4 (PGTH)
EFEN_5: R400.2, R401.1, U400.1 (EN/UVLO), U400.4 (PGTH)
EFOV_0: R302.2, R303.1, U300.2 (OVLO)
EFOV_1: R322.2, R323.1, U320.2 (OVLO)
EFOV_2: R342.2, R343.1, U340.2 (OVLO)
EFOV_3: R362.2, R363.1, U360.2 (OVLO)
EFOV_4: R382.2, R383.1, U380.2 (OVLO)
EFOV_5: R402.2, R403.1, U400.2 (OVLO)
FB5_0: R306.2, R307.1, U301.13 (FB)
FB5_1: R326.2, R327.1, U321.13 (FB)
FB5_2: R346.2, R347.1, U341.13 (FB)
FB5_3: R366.2, R367.1, U361.13 (FB)
FB5_4: R386.2, R387.1, U381.13 (FB)
FB5_5: R406.2, R407.1, U401.13 (FB)
GCLK0: U5.4 (Y), U30.2 (A1), U30.3 (A2), U30.4 (A3), U30.5 (A4), U30.6 (A5), U30.7 (A6), U30.8 (A7), U30.9 (A8), U31.2 (A1), U31.3 (A2), U31.4 (A3), U31.5 (A4), U31.6 (A5), U31.7 (A6), U31.8 (A7), U31.9 (A8)
GCLK1: U7.4 (Y), U32.2 (A1), U32.3 (A2), U32.4 (A3), U32.5 (A4), U32.6 (A5), U32.7 (A6), U32.8 (A7), U32.9 (A8), U33.2 (A1), U33.3 (A2), U33.4 (A3), U33.5 (A4), U33.6 (A5), U33.7 (A6), U33.8 (A7)
GND: C1.2, C2.2, C3.2, C4.2, C5.2, C6.2, C7.2, C8.2, C9.2, C10.2, C11.2, C12.2, C13.2, C14.2, C15.2, C300.2, C301.2, C302.2, C303.2, C305.2, C306.2, C307.2, C308.2, C309.2, C310.2, C311.2, C312.2, C320.2, C321.2, C322.2, C323.2, C325.2, C326.2, C327.2, C328.2, C329.2, C330.2, C331.2, C332.2, C340.2, C341.2, C342.2, C343.2, C345.2, C346.2, C347.2, C348.2, C349.2, C350.2, C351.2, C352.2, C360.2, C361.2, C362.2, C363.2, C365.2, C366.2, C367.2, C368.2, C369.2, C370.2, C371.2, C372.2, C380.2, C381.2, C382.2, C383.2, C385.2, C386.2, C387.2, C388.2, C389.2, C390.2, C391.2, C392.2, C400.2, C401.2, C402.2, C403.2, C405.2, C406.2, C407.2, C408.2, C409.2, C410.2, C411.2, C412.2, D300.2 (A), D320.2 (A), D340.2 (A), D360.2 (A), D380.2 (A), D400.2 (A), J1.2, J1.4, J1.6, J1.8, J1.10, J1.12, J1.14, J1.16, J1.18, J1.20, J1.22, J1.24, J1.26, J1.28, J1.30, J1.32, J1.40, J2.2, J2.4, J2.6, J2.8, J2.10, J2.12, J2.14, J2.16, J2.18, J2.20, J2.22, J2.24, J2.26, J2.28, J2.30, J2.32, J2.40, J100.4 (GND), J101.4 (GND), J102.4 (GND), J103.4 (GND), J104.4 (GND), J105.4 (GND), J106.4 (GND), J107.4 (GND), J108.4 (GND), J109.4 (GND), J110.4 (GND), J111.4 (GND), J112.4 (GND), J113.4 (GND), J114.4 (GND), J115.4 (GND), J116.4 (GND), J117.4 (GND), J118.4 (GND), J119.4 (GND), J120.4 (GND), J121.4 (GND), J122.4 (GND), J123.4 (GND), J124.4 (GND), J125.4 (GND), J126.4 (GND), J127.4 (GND), J128.4 (GND), J129.4 (GND), J130.4 (GND), J300.2 (GND), J320.2 (GND), J340.2 (GND), J360.2 (GND), J380.2 (GND), J400.2 (GND), JP0.2, JP1.2, JP2.2, JP3.2, JP4.2, JP5.2, JP10.2, JP11.2, JP12.2, JP13.2, JP14.2, JP15.2, R301.2, R303.2, R304.2, R307.2, R309.2, R321.2, R323.2, R324.2, R327.2, R329.2, R341.2, R343.2, R344.2, R347.2, R349.2, R361.2, R363.2, R364.2, R367.2, R369.2, R381.2, R383.2, R384.2, R387.2, R389.2, R401.2, R403.2, R404.2, R407.2, R409.2, U1.10 (GND), U1.19 (~OE), U2.10 (GND), U2.19 (~OE), U3.9 (A8), U3.10 (GND), U3.19 (~OE), U4.1 (~G), U4.10 (GND), U4.15 (P6), U4.16 (Q6), U4.17 (P7), U4.18 (Q7), U5.3 (GND), U6.1 (~G), U6.10 (GND), U6.15 (P6), U6.16 (Q6), U6.17 (P7), U6.18 (Q7), U7.3 (GND), U20.10 (GND), U20.19 (~OE), U21.10 (GND), U21.19 (~OE), U22.10 (GND), U22.19 (~OE), U23.9 (A8), U23.10 (GND), U23.19 (~OE), U30.10 (GND), U30.19 (~OE), U31.10 (GND), U31.19 (~OE), U32.10 (GND), U32.19 (~OE), U33.9 (A8), U33.10 (GND), U33.19 (~OE), U300.8 (GND), U301.3 (PGND), U301.4 (PGND_2), U301.5 (PGND_3), U301.8 (PGND_4), U301.9 (PGND_5), U301.10 (PGND_6), U301.12 (AGND), U320.8 (GND), U321.3 (PGND), U321.4 (PGND_2), U321.5 (PGND_3), U321.8 (PGND_4), U321.9 (PGND_5), U321.10 (PGND_6), U321.12 (AGND), U340.8 (GND), U341.3 (PGND), U341.4 (PGND_2), U341.5 (PGND_3), U341.8 (PGND_4), U341.9 (PGND_5), U341.10 (PGND_6), U341.12 (AGND), U360.8 (GND), U361.3 (PGND), U361.4 (PGND_2), U361.5 (PGND_3), U361.8 (PGND_4), U361.9 (PGND_5), U361.10 (PGND_6), U361.12 (AGND), U380.8 (GND), U381.3 (PGND), U381.4 (PGND_2), U381.5 (PGND_3), U381.8 (PGND_4), U381.9 (PGND_5), U381.10 (PGND_6), U381.12 (AGND), U400.8 (GND), U401.3 (PGND), U401.4 (PGND_2), U401.5 (PGND_3), U401.8 (PGND_4), U401.9 (PGND_5), U401.10 (PGND_6), U401.12 (AGND), UE0.2 (GND), UE1.2 (GND), UE2.2 (GND), UE3.2 (GND), UE4.2 (GND), UE5.2 (GND), UE6.2 (GND), UE7.2 (GND), UE8.2 (GND), UE9.2 (GND), UE10.2 (GND), UE11.2 (GND), UE12.2 (GND), UE13.2 (GND), UE14.2 (GND), UE15.2 (GND), UE16.2 (GND), UE17.2 (GND), UE18.2 (GND), UE19.2 (GND), UE20.2 (GND), UE21.2 (GND), UE22.2 (GND), UE23.2 (GND), UE24.2 (GND), UE25.2 (GND), UE26.2 (GND), UE27.2 (GND), UE28.2 (GND), UE29.2 (GND), UE30.2 (GND)
ID0_0: JP0.1, RID0.2, U4.3 (Q0)
ID0_1: JP1.1, RID1.2, U4.5 (Q1)
ID0_2: JP2.1, RID2.2, U4.7 (Q2)
ID0_3: JP3.1, RID3.2, U4.9 (Q3)
ID0_4: JP4.1, RID4.2, U4.12 (Q4)
ID0_5: JP5.1, RID5.2, U4.14 (Q5)
ID1_0: JP10.1, RID10.2, U6.3 (Q0)
ID1_1: JP11.1, RID11.2, U6.5 (Q1)
ID1_2: JP12.1, RID12.2, U6.7 (Q2)
ID1_3: JP13.1, RID13.2, U6.9 (Q3)
ID1_4: JP14.1, RID14.2, U6.12 (Q4)
ID1_5: JP15.1, RID15.2, U6.14 (Q5)
ILM_0: R304.1, U300.9 (ILM)
ILM_1: R324.1, U320.9 (ILM)
ILM_2: R344.1, U340.9 (ILM)
ILM_3: R364.1, U360.9 (ILM)
ILM_4: R384.1, U380.9 (ILM)
ILM_5: R404.1, U400.9 (ILM)
IN_A0: J1.35, U3.3 (A2)
IN_A1: J1.37, U3.4 (A3)
IN_A2: J1.39, U3.5 (A4)
IN_A3: J1.34, U3.6 (A5)
IN_A4: J1.36, U3.7 (A6)
IN_A5: J1.38, U3.8 (A7)
IN_CLK: J1.33, U3.2 (A1)
IN_D0: J1.1, U1.2 (A1)
IN_D1: J1.3, U1.3 (A2)
IN_D2: J1.5, U1.4 (A3)
IN_D3: J1.7, U1.5 (A4)
IN_D4: J1.9, U1.6 (A5)
IN_D5: J1.11, U1.7 (A6)
IN_D6: J1.13, U1.8 (A7)
IN_D7: J1.15, U1.9 (A8)
IN_D8: J1.17, U2.2 (A1)
IN_D9: J1.19, U2.3 (A2)
IN_D10: J1.21, U2.4 (A3)
IN_D11: J1.23, U2.5 (A4)
IN_D12: J1.25, U2.6 (A5)
IN_D13: J1.27, U2.7 (A6)
IN_D14: J1.29, U2.8 (A7)
IN_D15: J1.31, U2.9 (A8)
ITMR_0: C301.1, U300.10 (ITIMER)
ITMR_1: C321.1, U320.10 (ITIMER)
ITMR_2: C341.1, U340.10 (ITIMER)
ITMR_3: C361.1, U360.10 (ITIMER)
ITMR_4: C381.1, U380.10 (ITIMER)
ITMR_5: C401.1, U400.10 (ITIMER)
L_A0: J2.35, U3.17 (B2), U4.2 (P0), U6.2 (P0)
L_A1: J2.37, U3.16 (B3), U4.4 (P1), U6.4 (P1)
L_A2: J2.39, U3.15 (B4), U4.6 (P2), U6.6 (P2)
L_A3: J2.34, U3.14 (B5), U4.8 (P3), U6.8 (P3)
L_A4: J2.36, U3.13 (B6), U4.11 (P4), U6.11 (P4)
L_A5: J2.38, U3.12 (B7), U4.13 (P5), U6.13 (P5)
L_CLK: J2.33, U3.18 (B1), U5.1 (A), U7.1 (A)
L_D0: J2.1, U1.18 (B1), U20.2 (A1), U22.2 (A1)
L_D1: J2.3, U1.17 (B2), U20.3 (A2), U22.3 (A2)
L_D2: J2.5, U1.16 (B3), U20.4 (A3), U22.4 (A3)
L_D3: J2.7, U1.15 (B4), U20.5 (A4), U22.5 (A4)
L_D4: J2.9, U1.14 (B5), U20.6 (A5), U22.6 (A5)
L_D5: J2.11, U1.13 (B6), U20.7 (A6), U22.7 (A6)
L_D6: J2.13, U1.12 (B7), U20.8 (A7), U22.8 (A7)
L_D7: J2.15, U1.11 (B8), U20.9 (A8), U22.9 (A8)
L_D8: J2.17, U2.18 (B1), U21.2 (A1), U23.2 (A1)
L_D9: J2.19, U2.17 (B2), U21.3 (A2), U23.3 (A2)
L_D10: J2.21, U2.16 (B3), U21.4 (A3), U23.4 (A3)
L_D11: J2.23, U2.15 (B4), U21.5 (A4), U23.5 (A4)
L_D12: J2.25, U2.14 (B5), U21.6 (A5), U23.6 (A5)
L_D13: J2.27, U2.13 (B6), U21.7 (A6), U23.7 (A6)
L_D14: J2.29, U2.12 (B7), U21.8 (A7), U23.8 (A7)
L_D15: J2.31, U2.11 (B8), U21.9 (A8)
MODE5_0: R308.2, R309.1, U301.18 (MODE)
MODE5_1: R328.2, R329.1, U321.18 (MODE)
MODE5_2: R348.2, R349.1, U341.18 (MODE)
MODE5_3: R368.2, R369.1, U361.18 (MODE)
MODE5_4: R388.2, R389.1, U381.18 (MODE)
MODE5_5: R408.2, R409.1, U401.18 (MODE)
PG5_0: R310.1, U301.16 (PGOOD)
PG5_1: R330.1, U321.16 (PGOOD)
PG5_2: R350.1, U341.16 (PGOOD)
PG5_3: R370.1, U361.16 (PGOOD)
PG5_4: R390.1, U381.16 (PGOOD)
PG5_5: R410.1, U401.16 (PGOOD)
PG12_0: R305.1, U300.3 (PG)
PG12_1: R325.1, U320.3 (PG)
PG12_2: R345.1, U340.3 (PG)
PG12_3: R365.1, U360.3 (PG)
PG12_4: R385.1, U380.3 (PG)
PG12_5: R405.1, U400.3 (PG)
SC0: J100.3 (CLK), RC0.2, UE0.3 (IO2), UE0.4 (IO2b)
SC1: J101.3 (CLK), RC1.2, UE1.3 (IO2), UE1.4 (IO2b)
SC2: J102.3 (CLK), RC2.2, UE2.3 (IO2), UE2.4 (IO2b)
SC3: J103.3 (CLK), RC3.2, UE3.3 (IO2), UE3.4 (IO2b)
SC4: J104.3 (CLK), RC4.2, UE4.3 (IO2), UE4.4 (IO2b)
SC5: J105.3 (CLK), RC5.2, UE5.3 (IO2), UE5.4 (IO2b)
SC6: J106.3 (CLK), RC6.2, UE6.3 (IO2), UE6.4 (IO2b)
SC7: J107.3 (CLK), RC7.2, UE7.3 (IO2), UE7.4 (IO2b)
SC8: J108.3 (CLK), RC8.2, UE8.3 (IO2), UE8.4 (IO2b)
SC9: J109.3 (CLK), RC9.2, UE9.3 (IO2), UE9.4 (IO2b)
SC10: J110.3 (CLK), RC10.2, UE10.3 (IO2), UE10.4 (IO2b)
SC11: J111.3 (CLK), RC11.2, UE11.3 (IO2), UE11.4 (IO2b)
SC12: J112.3 (CLK), RC12.2, UE12.3 (IO2), UE12.4 (IO2b)
SC13: J113.3 (CLK), RC13.2, UE13.3 (IO2), UE13.4 (IO2b)
SC14: J114.3 (CLK), RC14.2, UE14.3 (IO2), UE14.4 (IO2b)
SC15: J115.3 (CLK), RC15.2, UE15.3 (IO2), UE15.4 (IO2b)
SC16: J116.3 (CLK), RC16.2, UE16.3 (IO2), UE16.4 (IO2b)
SC17: J117.3 (CLK), RC17.2, UE17.3 (IO2), UE17.4 (IO2b)
SC18: J118.3 (CLK), RC18.2, UE18.3 (IO2), UE18.4 (IO2b)
SC19: J119.3 (CLK), RC19.2, UE19.3 (IO2), UE19.4 (IO2b)
SC20: J120.3 (CLK), RC20.2, UE20.3 (IO2), UE20.4 (IO2b)
SC21: J121.3 (CLK), RC21.2, UE21.3 (IO2), UE21.4 (IO2b)
SC22: J122.3 (CLK), RC22.2, UE22.3 (IO2), UE22.4 (IO2b)
SC23: J123.3 (CLK), RC23.2, UE23.3 (IO2), UE23.4 (IO2b)
SC24: J124.3 (CLK), RC24.2, UE24.3 (IO2), UE24.4 (IO2b)
SC25: J125.3 (CLK), RC25.2, UE25.3 (IO2), UE25.4 (IO2b)
SC26: J126.3 (CLK), RC26.2, UE26.3 (IO2), UE26.4 (IO2b)
SC27: J127.3 (CLK), RC27.2, UE27.3 (IO2), UE27.4 (IO2b)
SC28: J128.3 (CLK), RC28.2, UE28.3 (IO2), UE28.4 (IO2b)
SC29: J129.3 (CLK), RC29.2, UE29.3 (IO2), UE29.4 (IO2b)
SC30: J130.3 (CLK), RC30.2, UE30.3 (IO2), UE30.4 (IO2b)
SCR0: RC0.1, U30.18 (B1)
SCR1: RC1.1, U30.17 (B2)
SCR2: RC2.1, U30.16 (B3)
SCR3: RC3.1, U30.15 (B4)
SCR4: RC4.1, U30.14 (B5)
SCR5: RC5.1, U30.13 (B6)
SCR6: RC6.1, U30.12 (B7)
SCR7: RC7.1, U30.11 (B8)
SCR8: RC8.1, U31.18 (B1)
SCR9: RC9.1, U31.17 (B2)
SCR10: RC10.1, U31.16 (B3)
SCR11: RC11.1, U31.15 (B4)
SCR12: RC12.1, U31.14 (B5)
SCR13: RC13.1, U31.13 (B6)
SCR14: RC14.1, U31.12 (B7)
SCR15: RC15.1, U31.11 (B8)
SCR16: RC16.1, U32.18 (B1)
SCR17: RC17.1, U32.17 (B2)
SCR18: RC18.1, U32.16 (B3)
SCR19: RC19.1, U32.15 (B4)
SCR20: RC20.1, U32.14 (B5)
SCR21: RC21.1, U32.13 (B6)
SCR22: RC22.1, U32.12 (B7)
SCR23: RC23.1, U32.11 (B8)
SCR24: RC24.1, U33.18 (B1)
SCR25: RC25.1, U33.17 (B2)
SCR26: RC26.1, U33.16 (B3)
SCR27: RC27.1, U33.15 (B4)
SCR28: RC28.1, U33.14 (B5)
SCR29: RC29.1, U33.13 (B6)
SCR30: RC30.1, U33.12 (B7)
SD0: J100.2 (DATA), RD0.2, UE0.1 (IO1), UE0.6 (IO1b)
SD1: J101.2 (DATA), RD1.2, UE1.1 (IO1), UE1.6 (IO1b)
SD2: J102.2 (DATA), RD2.2, UE2.1 (IO1), UE2.6 (IO1b)
SD3: J103.2 (DATA), RD3.2, UE3.1 (IO1), UE3.6 (IO1b)
SD4: J104.2 (DATA), RD4.2, UE4.1 (IO1), UE4.6 (IO1b)
SD5: J105.2 (DATA), RD5.2, UE5.1 (IO1), UE5.6 (IO1b)
SD6: J106.2 (DATA), RD6.2, UE6.1 (IO1), UE6.6 (IO1b)
SD7: J107.2 (DATA), RD7.2, UE7.1 (IO1), UE7.6 (IO1b)
SD8: J108.2 (DATA), RD8.2, UE8.1 (IO1), UE8.6 (IO1b)
SD9: J109.2 (DATA), RD9.2, UE9.1 (IO1), UE9.6 (IO1b)
SD10: J110.2 (DATA), RD10.2, UE10.1 (IO1), UE10.6 (IO1b)
SD11: J111.2 (DATA), RD11.2, UE11.1 (IO1), UE11.6 (IO1b)
SD12: J112.2 (DATA), RD12.2, UE12.1 (IO1), UE12.6 (IO1b)
SD13: J113.2 (DATA), RD13.2, UE13.1 (IO1), UE13.6 (IO1b)
SD14: J114.2 (DATA), RD14.2, UE14.1 (IO1), UE14.6 (IO1b)
SD15: J115.2 (DATA), RD15.2, UE15.1 (IO1), UE15.6 (IO1b)
SD16: J116.2 (DATA), RD16.2, UE16.1 (IO1), UE16.6 (IO1b)
SD17: J117.2 (DATA), RD17.2, UE17.1 (IO1), UE17.6 (IO1b)
SD18: J118.2 (DATA), RD18.2, UE18.1 (IO1), UE18.6 (IO1b)
SD19: J119.2 (DATA), RD19.2, UE19.1 (IO1), UE19.6 (IO1b)
SD20: J120.2 (DATA), RD20.2, UE20.1 (IO1), UE20.6 (IO1b)
SD21: J121.2 (DATA), RD21.2, UE21.1 (IO1), UE21.6 (IO1b)
SD22: J122.2 (DATA), RD22.2, UE22.1 (IO1), UE22.6 (IO1b)
SD23: J123.2 (DATA), RD23.2, UE23.1 (IO1), UE23.6 (IO1b)
SD24: J124.2 (DATA), RD24.2, UE24.1 (IO1), UE24.6 (IO1b)
SD25: J125.2 (DATA), RD25.2, UE25.1 (IO1), UE25.6 (IO1b)
SD26: J126.2 (DATA), RD26.2, UE26.1 (IO1), UE26.6 (IO1b)
SD27: J127.2 (DATA), RD27.2, UE27.1 (IO1), UE27.6 (IO1b)
SD28: J128.2 (DATA), RD28.2, UE28.1 (IO1), UE28.6 (IO1b)
SD29: J129.2 (DATA), RD29.2, UE29.1 (IO1), UE29.6 (IO1b)
SD30: J130.2 (DATA), RD30.2, UE30.1 (IO1), UE30.6 (IO1b)
SDR0: RD0.1, U20.18 (B1)
SDR1: RD1.1, U20.17 (B2)
SDR2: RD2.1, U20.16 (B3)
SDR3: RD3.1, U20.15 (B4)
SDR4: RD4.1, U20.14 (B5)
SDR5: RD5.1, U20.13 (B6)
SDR6: RD6.1, U20.12 (B7)
SDR7: RD7.1, U20.11 (B8)
SDR8: RD8.1, U21.18 (B1)
SDR9: RD9.1, U21.17 (B2)
SDR10: RD10.1, U21.16 (B3)
SDR11: RD11.1, U21.15 (B4)
SDR12: RD12.1, U21.14 (B5)
SDR13: RD13.1, U21.13 (B6)
SDR14: RD14.1, U21.12 (B7)
SDR15: RD15.1, U21.11 (B8)
SDR16: RD16.1, U22.18 (B1)
SDR17: RD17.1, U22.17 (B2)
SDR18: RD18.1, U22.16 (B3)
SDR19: RD19.1, U22.15 (B4)
SDR20: RD20.1, U22.14 (B5)
SDR21: RD21.1, U22.13 (B6)
SDR22: RD22.1, U22.12 (B7)
SDR23: RD23.1, U22.11 (B8)
SDR24: RD24.1, U23.18 (B1)
SDR25: RD25.1, U23.17 (B2)
SDR26: RD26.1, U23.16 (B3)
SDR27: RD27.1, U23.15 (B4)
SDR28: RD28.1, U23.14 (B5)
SDR29: RD29.1, U23.13 (B6)
SDR30: RD30.1, U23.12 (B7)
SEL0_N: U4.19 (~P=Q), U5.2 (B)
SEL1_N: U6.19 (~P=Q), U7.2 (B)
SS5_0: C303.1, U301.14 (SS)
SS5_1: C323.1, U321.14 (SS)
SS5_2: C343.1, U341.14 (SS)
SS5_3: C363.1, U361.14 (SS)
SS5_4: C383.1, U381.14 (SS)
SS5_5: C403.1, U401.14 (SS)
SW5_0: C304.2, L300.1, U301.6 (SW), U301.7 (SW_2)
SW5_1: C324.2, L320.1, U321.6 (SW), U321.7 (SW_2)
SW5_2: C344.2, L340.1, U341.6 (SW), U341.7 (SW_2)
SW5_3: C364.2, L360.1, U361.6 (SW), U361.7 (SW_2)
SW5_4: C384.2, L380.1, U381.6 (SW), U381.7 (SW_2)
SW5_5: C404.2, L400.1, U401.6 (SW), U401.7 (SW_2)
V5S0: F100.2, J100.1 (+5V)
V5S1: F101.2, J101.1 (+5V)
V5S2: F102.2, J102.1 (+5V)
V5S3: F103.2, J103.1 (+5V)
V5S4: F104.2, J104.1 (+5V)
V5S5: F105.2, J105.1 (+5V)
V5S6: F106.2, J106.1 (+5V)
V5S7: F107.2, J107.1 (+5V)
V5S8: F108.2, J108.1 (+5V)
V5S9: F109.2, J109.1 (+5V)
V5S10: F110.2, J110.1 (+5V)
V5S11: F111.2, J111.1 (+5V)
V5S12: F112.2, J112.1 (+5V)
V5S13: F113.2, J113.1 (+5V)
V5S14: F114.2, J114.1 (+5V)
V5S15: F115.2, J115.1 (+5V)
V5S16: F116.2, J116.1 (+5V)
V5S17: F117.2, J117.1 (+5V)
V5S18: F118.2, J118.1 (+5V)
V5S19: F119.2, J119.1 (+5V)
V5S20: F120.2, J120.1 (+5V)
V5S21: F121.2, J121.1 (+5V)
V5S22: F122.2, J122.1 (+5V)
V5S23: F123.2, J123.1 (+5V)
V5S24: F124.2, J124.1 (+5V)
V5S25: F125.2, J125.1 (+5V)
V5S26: F126.2, J126.1 (+5V)
V5S27: F127.2, J127.1 (+5V)
V5S28: F128.2, J128.1 (+5V)
V5S29: F129.2, J129.1 (+5V)
V5S30: F130.2, J130.1 (+5V)
V12_0: C306.1, C307.1, C308.1, U300.6 (OUT), U301.2 (VIN), U301.11 (VIN_2), U301.15 (EN)
V12_1: C326.1, C327.1, C328.1, U320.6 (OUT), U321.2 (VIN), U321.11 (VIN_2), U321.15 (EN)
V12_2: C346.1, C347.1, C348.1, U340.6 (OUT), U341.2 (VIN), U341.11 (VIN_2), U341.15 (EN)
V12_3: C366.1, C367.1, C368.1, U360.6 (OUT), U361.2 (VIN), U361.11 (VIN_2), U361.15 (EN)
V12_4: C386.1, C387.1, C388.1, U380.6 (OUT), U381.2 (VIN), U381.11 (VIN_2), U381.15 (EN)
V12_5: C406.1, C407.1, C408.1, U400.6 (OUT), U401.2 (VIN), U401.11 (VIN_2), U401.15 (EN)
V12_IN_0: C305.1, D300.1 (K), J300.1 (+12V), R300.1, R302.1, U300.5 (IN)
V12_IN_1: C325.1, D320.1 (K), J320.1 (+12V), R320.1, R322.1, U320.5 (IN)
V12_IN_2: C345.1, D340.1 (K), J340.1 (+12V), R340.1, R342.1, U340.5 (IN)
V12_IN_3: C365.1, D360.1 (K), J360.1 (+12V), R360.1, R362.1, U360.5 (IN)
V12_IN_4: C385.1, D380.1 (K), J380.1 (+12V), R380.1, R382.1, U380.5 (IN)
V12_IN_5: C405.1, D400.1 (K), J400.1 (+12V), R400.1, R402.1, U400.5 (IN)
VREG5_0: C302.1, R308.1, U301.17 (VREG5)
VREG5_1: C322.1, R328.1, U321.17 (VREG5)
VREG5_2: C342.1, R348.1, U341.17 (VREG5)
VREG5_3: C362.1, R368.1, U361.17 (VREG5)
VREG5_4: C382.1, R388.1, U381.17 (VREG5)
VREG5_5: C402.1, R408.1, U401.17 (VREG5)
