illiapliukhin/led-cube-32-controller/(commit log)

2026-10-12 Phase 1: architecture study, calcs, block diagram, v15 baseline
    [BOM_mono_electronics_v15_annotated.csv, BOM_mono_electronics_v15_installation_JLCPCB.csv, BOM_mono_electronics_v15_wearable_JLCPCB.csv, audio.kicad_sch, imu.kicad_sch, install_headers.kicad_sch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]
2026-10-12 v2 architecture: RGB hanging HD108 strands, sizing 32^3..128^3, branch schematic (ERC 0), archive mono tile WIP
    [branch_v1.kicad_sch, tile_v1.kicad_pcb]
2026-10-12 v1.1: 12V distribution + eFuse/buck/PTC/ESD on branch; main board layout DRC 0 (structured spine routing, arcs), 12V input chain, fab outputs, renders, LAYOUT_LESSONS
    [branch_v1.kicad_sch, main_v1-BOM.csv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]
2026-10-12 Size table + pixel choice, cube footprint lib (TPS25947 RPW, verified inductors), schematic->PCB linking (main parity 0), TPD4E05U06 port ESD, branch layout WIP
    [branch_v1.kicad_pcb, branch_v1.kicad_sch, main_v1.kicad_pcb, main_v1.kicad_sch]
2026-10-12 1 m strip board: JLC limit check, 4x250 mm segments, parametric schematic (124/64/48/32, ERC 0), strip power/current calc; main fab+3D renders; fetch3d, fab.sh; docs
    [branch_v1.kicad_pcb, main_v1-BOM.csv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]
